vron/trebodar/beräkningar/K-05/README.md

# K-05 rev A – Mellanbjälklag och källarpelare

Kontroll av det platsgjutna mellanbjälklaget, 150 mm, och källarens stålrör, VKR 80×80×4, enligt EKS 12 och SS-EN 1992-1-1 / 1993-1-1. Plattan räknas med finita element med verklig geometri, källarväggar (Sundolitt Kub 350-150), rör, plattan på mark och alla laster från trästommen på plan 1 (K-01, ytterväggar, tak på takfotsväggar, trappa).

| Fil | Innehåll |
|---|---|
| `bild/geometri.json` | Geometri: plattans kontur och trapphål, källarväggar och upplagslinjer, rör, platta på mark, fria kanter , stolparnas lägen på plan 1 och linjelasten från dalbalk 2. K-05:s egen källfil, som också K-06 och R-06 använder. Kontrolleras mot modellen med `verktyg/modellanalys/kontroll_geometri05.py` |
| `laster.py` | Alla laster: utbredda laster (F-01), punktlaster LN/LD/LA ur K-01 och gaveltakstolarna, ytterväggar qY1–qY12, qD2, trappan qT, vindlyft. Indata överst i filen |
| `platta.py` | FE för plattor (DKT-element): nät med lokal förfining, stöd (linje, rör som fjäder, bädd), laster, moment, reaktioner, Wood–Armer |
| `ec2.py` | Material och kontroller enligt SS-EN 1992-1-1 med EKS; rörens knäckning |
| `analys.py` | Långtidsnedböjning med sprickbildning och krympning element för element |
| `modell.py` | Bygger FE-modellen ur `geometri.json` och `laster.py`. Laster över källarväggarna läggs på väggens upplagslinje |
| `omhyllande.py` | Omhyllande moment, tvärkraft och rörlaster för alla kombinationer, nyttig last i mönster, mjuka och styva rör, styva rör med väggarna som fjädrar, vindlyft |
| `tvarkraft.py` | Tvärkraft genom kontrollsnitt ur FE-modellen |
| `kontroll.py` | Handberäkning (belastningsytor, strimlor) och jämförelse med SINTEF 522.871 tabell 24a |
| `berakning.py` | Huvudskript: alla kontroller, tilläggsjärn, utförande vid varje rör, reaktioner på väggarna; skriver `resultat.json` |
| `figurer.py` | Figurer: geometri, laster, tvärsnitt, armering, moment, nedböjning |
| `golvvarme.py` | Bilaga A: golvvärme, stationär värmeledning i ett tvärsnitt |
| `ta_bort.py` | Prövar vad som händer om rör tas bort (`python ta_bort.py 2,6,13`) |
| `rapport.py`, `rapport/mall.typ` | Bygger PDF:en |
| `validering/` | FE-modellen mot Navier, Timoshenko (platta på pelarnät) och en strimla med sprickbildning; känslighet för sättning av rören (`sattning.py`), nätkonvergens (`konvergens.py`) och väggarna som fjädrar (`vaggande.py`); kör dem före `rapport.py` |

## Köra

```
pip install -r requirements.txt
python laster.py          # lastsammanställning
python berakning.py       # under en halv minut
python validering/konvergens.py
python validering/vaggande.py    # cirka en minut
python rapport.py         # rapport/K-05_mellanbjalklag.pdf
```

Typsnittet Carlito läses från systemet eller från `beräkningar/.fonts`. Figurer, `*.npz` och PDF skapas i mappen och versionshanteras inte. Ritningarna R-05 (källarstommen) och R-06 (mellanbjälklaget) läser `bild/geometri.json` och `resultat.json`. K-05 är ett tungt steg i bygget: det räknas lokalt (`./bygg K-05`), och `resultat.json`, valideringarnas `konvergens.json` och `vaggande.json`, `räknat.json` (källornas kontrollsumma) och rapporten i `rapporter/` checkas in (se [`verktyg/bygg`](../../verktyg/bygg/)).

## Viktiga antaganden

- Betong C30/37 (som källarväggarna), beräknad som C25/30 på säkra sidan; B500B. Nät Ø10 s150 i underkant (täckskikt 20 mm) och Ø8 s150 i överkant (täckskikt 25 mm).
- Källarväggarna är Kub 350-150 (cellplast 100 + betong 150 + cellplast 100). Vid öppningarna slutar betongkärnan, och därmed upplagslinjen, 100 mm innanför den isolerade smygen. Upplagslinjen ligger i betongkärnans mitt, som är väggens centrumlinje (5.3.2.2: 75 mm från kärnans insida); plattan går till 30 mm från väggens ytterliv, 70 mm ut över den yttre cellplasten.
- Ytterväggarna på plan 1 står över källarväggens yttre cellplast, centrum 17,5 mm innanför plattans kant och 52,5 mm utanför kärnan (modellen).
- Laster från plan 1: K-01:s stödreaktioner; gavlarnas nockbalksändar via takstolar till hörnen; takfotsväggar bär halva takbalken plus 0,2 m utsprång; ytterväggar 0,6 kN/m²; trappan hänger på hålets kortsida.
- Lätta mellanväggar 0,7 kN/m² som nyttig last i brottgräns och permanent last i bruksgräns.
- Momenttoppar utjämnas över 250 mm; stödmoment i överkant × 1,2 när zonerna avgränsas och tilläggsjärnen dimensioneras för 1,5 × FE (stela upplagslinjer ger nätberoende toppar vid väggändar).
- Genomstansning: hela lasten på varje rör och stolpe på eget snitt 2d, β 1,15 (1,4 vid trapphålet), ρ ur överkantsarmeringen, för rören också FE-modellens lokala tvärkraft; minst 5 % marginal och ≤ 100 % med armeringen 10 mm för lågt. Nettokraften ur jämvikt redovisas bara som information. P7 är två rör tätt intill varandra i x-led, vart och ett med sin topplåt 80×80×8 (lastyta 160 × 80 mm).
- Rören räknas med verklig axialstyvhet, som styva och som styva med väggarna som fjädrar (kärnans långtidsstyvhet, E = 11 000 MPa, t = 150 mm); det ogynnsammaste resultatet används. Rören vid trapphålet står där de står i modellen, 62,5–81 mm från hålkanten (centrum).
