vron/trebodar/rapporter/U-03revA Takets luftspalt - luftflöde, fukt och mögelrisk.pdf

Fritidshus Trebodar, Resö, Tanum | U-03 rev A · Sida 1 av 4
Projekt | Fritidshus Trebodar, Resö, Tanum | Dokument | U-03, rev A
Objekt | Takets luftspalt – luftflöde, fukt och mögelrisk | Datum | 2026-10-31
Innehåll | Luftflöde, temperatur, fukt och mögelindex timme för timme 2013–2023, hela taket som nätverk | Upprättad | Viktor Ogeman
Underlag | K-03 rev A, K-05 (takets geometri), F-01 rev A (uppbyggnad), planritning 201 rev 02, AR-02 (riktning), ERA5 2013–2023 | Status | Eget underlag, ingår inte i handlingarna till tekniskt samråd

### 1 Syfte och slutsatser

Luftspalten mellan råsponten och vindskivan (hård träfiberskiva) går obruten från takfot till takfot över nockar och dalar, som längst 16,3
m. Här bedöms om den ventileras tillräckligt, vad takfönstren, eventuella gavelöppningar, vindskivan och badrummet betyder och om en oventilerad spalt räcker. Måttet är mögelindex M (VTT) på råspontens undersida: målet är M < 1 (ingen påväxt), och ASHRAE 160 godtar M ≤ 3.
Beslut och utförande
1. Plåten: zink-magnesium utan organisk beläggning. Den låga emissiviteten avgör; målad plåt skulle ge M 3,69.
2. Spalten: ströläkten 34 mm (F-01); spalten går fri också över nock- och dalbalkarna.
3. Omluftning vid varje takfönster: uppehåll i ströläkten, minst 300 mm och gärna 600 mm fritt per läktlinje ovanför och under fönstret (Figur 3).
4. Inga öppningar i gavlarna. Alla takfötter öppna med insektsnät.
5. Dalbalkarnas överkant i takplanens skärning, inte i takbalkarnas överkant (som i modellen och K-03).
6. Vindskiva med deklarerat Sd, gärna högst ca 0,3 m. Intello Plus, helt lufttät, också över badrummet.
7. Står huset tomt på vintern: håll hellre 15 än 10 °C inne.
Slutsatser
- Den obrutna spalten fungerar. Luften går genom alla sex takfallen i följd, driven av vinden och av solen: de tre solvarma takfallen mot sydost samverkar och driver luften från sydost mot nordväst. Längs den långa vägen rör sig luften i median med 0,31 m/s.
- Med zink-magnesiumplåten klarar sig råsponten. Med 34 mm spalt blir M som mest 1,02 med 300 mm omluftning och 1,02 med 600 mm, i båda fallen efter de extremt milda och blöta vintrarna 2019/20 och 2020/21; alla andra år ligger under 0,6. Den långa vägen är inte sämre än de korta takfallen i husets ändar, som är vanliga sadeltak (0,83 mot 1,02 med målad plåt 1,86 mot 3,69).
- Vid svag vind betyder spalten och omluftningen mer. Vid platsens vind är 34 och 36 mm i praktiken lika (1,02 och 1,00), och med halva vindtrycket blir det 0,85 och 0,87. Med en fjärdedel av vindtrycket blir det 1,48 med 34 mm och 0,80 med 36 mm, och med 300 mm omluftning 1,84. Vid svag vind förs nämligen fukt från de solvarma takfallen mot sydost med den långsamma luften och samlas i det sista takfallet mot nordväst, mest i facken bakom takfönstren. Med ströläkten 34 mm är omluftningen vid fönstren därför viktig, gärna 600 mm.
- Spalten ska ventileras. Utan luftning eller helt utan vind blir M lägst i beräkningen (0,00 och 0,01 0,03 med råspont på 20 % när taket stängs), eftersom ingen fuktig uteluft kommer in. Men en oventilerad spalt torkar bara inåt, långsamt och på sommaren, så vatten från läckage eller mer byggfukt torkar inte ut, och svag luftning är ogynnsam. Den luftade spalten med marginal för svag vind är det robusta valet.
- Gavelöppningar ger ingen förbättring. M blir 1,07 mot 1,02, och den långa vägen sämre (0,96 mot 0,83). De släpper också in slagregn och snö, särskilt i gavlarna mot sydväst.
- Tomt hus på vintern. Med 10 °C inne oktober–april blir värmeförlusten, som torkar spalten, mindre: M 1,50 med rekommenderat utförande (1,50 med 600 mm omluftning), med 15 °C 1,28 (1,28). Det gäller bara de extremt milda vintrarna 2019/20 och 2020/21, övriga år under 0,7. Det är över målet men långt under ASHRAE 160:s gräns, och ju varmare huset hålls, desto bättre.

### 2 Taket och modellen

Taket. Tre sadeltak, 30°, med nockarna längs husets längd och dalar emellan. Uppbyggnad enligt F-01 med plåt, papp och spalt enligt denna utredning: bandtäckning av zink-magnesiumbelagd plåt, blank och omålad; underlagspapp av bitumen (t.ex. T-Roof YEP 2500, ångtät); råspont 20 mm; luftspalt mellan ströläkt på takbalkarna c/c 600 vindskiva 3 mm; Hunton Nativo 170 mm; ångbroms Hunton Intello Plus (Sd 0,3–34 m); installationsskikt 45 mm; gips. Spalten har sin fria höjd även över nock- och dalbalkarna. Alla takfötter mot det fria är öppna med insektsnät, också där huskropparna är förskjutna mot varandra. Vägen genom spalten är 5,4, 5,9, 11,1 eller 16,3 m beroende på var i taket facket ligger (Figur 1 a). Takfönstren TF1–TF3 (K-03) bryter två fack vardera. Badrummet (planritning 201 rev 02) ligger under TF1.
Modellen. Hela taket delas i 31 remsor längs husets längd, ungefär ett fack var, och varje remsa i delsträckor mellan takfötter, nockar, dalar och fönster, med 6 celler var. För varje timme 2013–2023 beräknas:
- luftflödet i alla fack av vindtrycket vid takfötterna och gavelöppningarna och av den termiska stigkraften i varje takfall. Vid takfötterna används Δcp

= 0,48 cos(1,3 φ) + 0,22, där φ är vindens vinkel mot fasadens normal (Månhardt m.fl. 2021 efter Gullbrekken m.fl. 2018), i gavlarna Swami & Chandra. Vindhastigheten är ERA5 på 10 m, utan reduktion. Tryckfallet räknas med friktion i spalten, insektsnät, in- och utlopp och vändningar vid nockar och dalar. Där facken möts är flödet in lika med flödet ut;
- temperaturerna i plåten (sol, utstrålning mot himlen, vind), råsponten, luften och vindskivan, med värmeflödet inifrån. Zink-magnesiumytan har solabsorption 0,65 och emissivitet 0,25 (blank zink och förzinkad plåt 0,65–0,7 respektive 0,15–0,25);
- fukten i råspontens yta och kärna, i vindskivan med isoleringens överdel och i luften i spalten, med diffusion inifrån genom ångbromsen, vars Sd beror på medelfuktigheten på dess båda sidor. Råsponten torkar bara nedåt, eftersom pappen är ångtät. Inneklimatet är fuktklass 2 (4 g/m³), badrummet fuktklass 4 (8 g/m³), SS-EN ISO 13788;
- mögelindex M (VTT-modellen, furu splintved) på råspontens undersida och på vindskivan. M = 1 är begynnande påväxt som syns i mikroskop och M = 3 påväxt som syns med blotta ögat.
Klimatet är ERA5 för Resö (8,5 °C, RF 79 %, vind 4,1 m/s i medel på 10 m). Flöde och temperatur itereras 6 gånger per timme. Kontroller: med 12 celler per delsträcka blir största M 1,02 i stället för 1,02 och med 10 iterationer 0,99. Massbalansen i varje nod stämmer inom 10⁻⁸ m³/s. En oberoende kontrollmodell med egen kod, räknad med målad plåt, ger samma rangordning mellan vägarna och utförandena och samma tidsförlopp.

Fritidshus Trebodar, Resö, Tanum | U-03 rev A · Sida 2 av 4

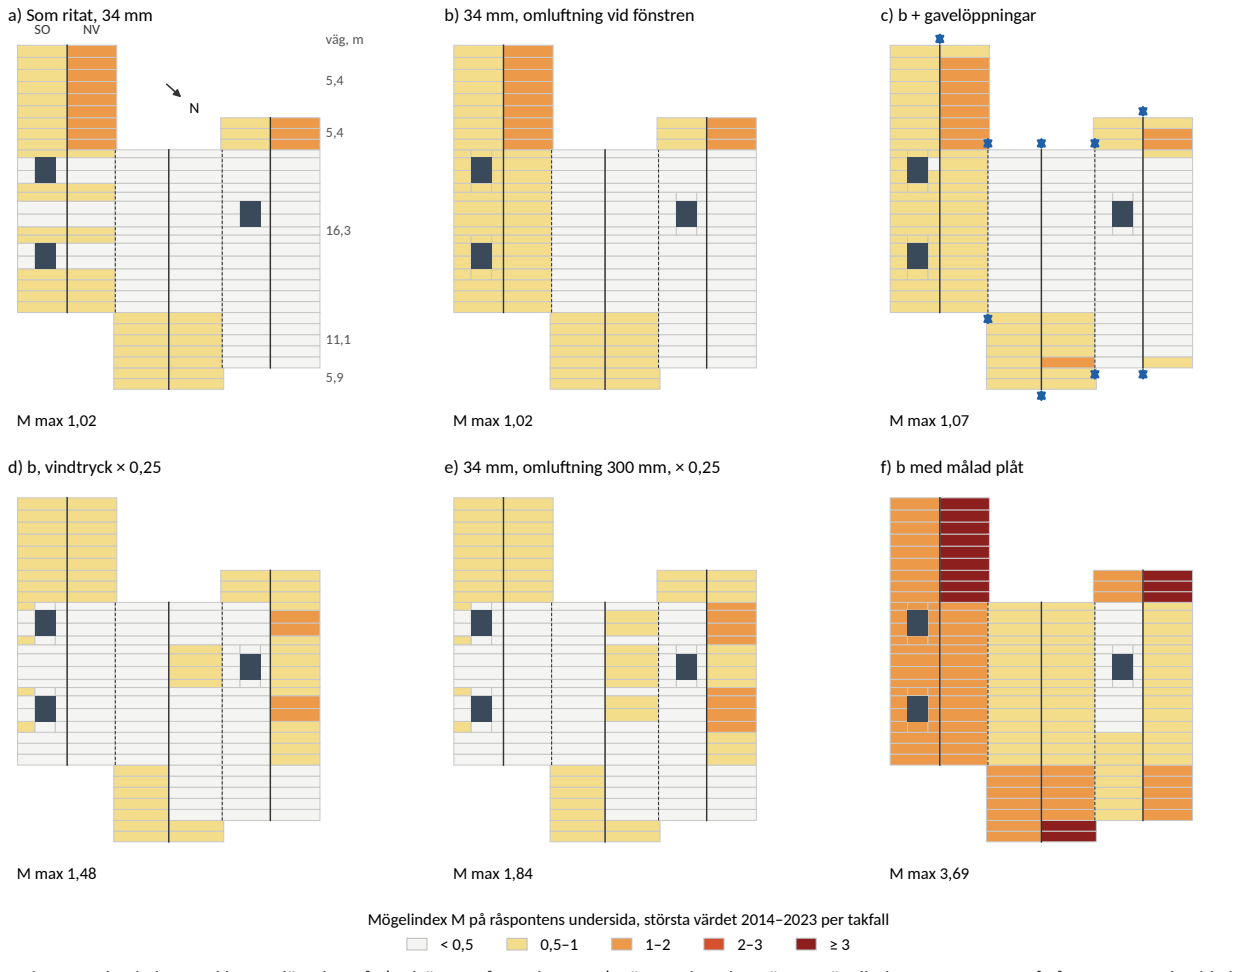
[picture p8: figure]
M max 1,02; väg, m; a) Som ritat, 34 mm; b) 34 mm, omluftning vid fönstren; M max 1,07; c) b + gavelöppningar; M max 1,48; d) b, vindtryck × 0,25; M max 1,84; e) 34 mm, omluftning 300 mm, × 0,25; M max 3,69; f) b med målad plåt

Mögelindex M på råspontens undersida, största värdet 2014–2023 per takfall

Figur 1: Taket i plan med husets längd uppåt (sydväst uppåt, N visar norr). Färgen visar det största mögelindexet 2014–2023 på råspontens undersida i varje delsträcka. SO och NV: takfallens riktning i vänster huskropp. Väg: luftens väg från takfot till takfot. Mörka rutor: takfönster. Heldragna linjer: nockar, streckade: dalar. Pilar: gavelöppningar.

### 3 Resultat

Fall | M råspont Yta M ≥ 1 (m²) M vindskiva Luft (m/s) | Sämst
Utförande
Rekommenderat: 34 mm, omluftning 300 mm | 1,02 | 17 | 0,05 | 0,36 | NV, 5,4 m
Som ritat: fönstren bryter facken (34 mm) | 1,02 | 17 | 0,05 | 0,22 | NV, 5,4 m
34 mm, omluftning 600 mm | 1,02 | 17 | 0,05 | 0,37 | NV, 5,4 m
+ gavelöppningar | 1,07 | 16 | 0,10 | 0,38 | NV, 11,1 m
+ kanal längs nock och dal | 1,05 | 13 | 0,06 | 0,37 | NV, 5,4 m
+ kanal och gavelöppningar | 1,00 | 1 | 0,08 | 0,36 | NV, 5,4 m
Utan takfönster | 1,02 | 17 | 0,05 | 0,41 | NV, 5,4 m
Vind och spalt
Rekommenderat, vindtryck × 0,5 | 0,85 | 0 | 0,04 | 0,21 | NV, 5,4 m
Rekommenderat, vindtryck × 0,25 | 1,84 | 11 | 0,03 | 0,11 NV, fönsterfack
Vindtryck × 0,5 | 0,85 | 0 | 0,04 | 0,21 | NV, 5,4 m
Vindtryck × 0,25 | 1,48 | 6 | 0,03 | 0,12 NV, fönsterfack
Ingen vind, bara sol och stigkraft | 0,01 | 0 | 0,00 | 0,00 | –
Gavelöppningar, vindtryck × 0,5 | 0,92 | 0 | 0,08 | 0,22 | NV, 16,3 m
Spalt 25 mm | 1,11 | 3 | 0,05 | 0,26 NV, fönsterfack
Spalt 36 mm | 1,00 | 20 | 0,05 | 0,39 | NV, 5,9 m
Spalt 45 mm | 1,06 | 20 | 0,07 | 0,43 | NV, 5,4 m
Spalt 36 mm, vindtryck × 0,5 | 0,87 | 0 | 0,05 | 0,23 | NV, 5,4 m
Spalt 25 mm, vindtryck × 0,25 | 6,00 | 52 | 0,53 | 0,08 NV, fönsterfack
Spalt 36 mm, vindtryck × 0,25 | 0,80 | 0 | 0,04 | 0,13 NV, fönsterfack
Spalt 45 mm, vindtryck × 0,25 | 0,80 | 0 | 0,04 | 0,16 | NV, 5,4 m
Strypta takfötter (4 × tryckfall) | 0,78 | 0 | 0,04 | 0,28 | SO, 5,4 m
Strypta takfötter, vindtryck × 0,25 | 2,06 | 24 | 0,02 | 0,10 NV, fönsterfack
Plåt
Ny blank plåt: α 0,55, ε 0,12 | 0,93 | 0 | 0,05 | 0,38 | SO, 5,4 m
Åldrad plåt: α 0,8, ε 0,4 | 1,18 | 37 | 0,05 | 0,37 | NV, 5,4 m
Målad plåt: α 0,6, ε 0,9 | 3,69 | 100 | 0,17 | 0,38 | NV, 5,4 m
Inneklimat och vindskiva
Badrummet fuktklass 4, Intello Plus | 1,02 | 17 | 0,06 | 0,37 | NV, 5,4 m
Badrummet fuktklass 4, Sd 10 m där | 1,02 | 17 | 0,05 | 0,37 | NV, 5,4 m

Fritidshus Trebodar, Resö, Tanum | U-03 rev A · Sida 3 av 4
Hela huset fuktklass 3 | 1,02 | 17 | 0,07 | 0,37 | NV, 5,4 m
Tomt okt–apr: inne 15 °C, omluftning 600 mm | 1,28 | 40 | 0,06 | 0,38 | NV, 5,4 m
Tomt okt–apr: inne 10 °C, omluftning 600 mm | 1,50 | 63 | 0,05 | 0,38 | NV, 5,4 m
Rekommenderat, tomt: inne 15 °C | 1,28 | 40 | 0,06 | 0,36 | NV, 5,4 m
Rekommenderat, tomt: inne 10 °C | 1,50 | 56 | 0,05 | 0,36 | NV, 5,4 m
Spalt 36 mm, tomt okt–apr | 1,48 | 72 | 0,05 | 0,39 | NV, 5,4 m
Vindskiva Sd 0,06 m | 0,98 | 0 | 0,26 | 0,37 | NV, 5,4 m
Vindskiva Sd 0,6 m | 1,03 | 17 | 0,00 | 0,37 | NV, 5,4 m
Byggfukt och oventilerat
Råspont 20 % vid stängning | 1,02 | 17 | 0,05 | 0,38 | NV, 5,4 m
Strypta takfötter, råspont 20 % vid stängning | 0,78 | 0 | 0,04 | 0,28 | SO, 5,4 m
Som ritat, råspont 20 % vid stängning | 1,02 | 17 | 0,05 | 0,22 | NV, 5,4 m
Oventilerad (takfötter stängda) | 0,00 | 0 | 0,00 | 0,00 | –
Oventilerad, råspont 20 % vid stängning | 0,03 | 0 | 0,00 | 0,00 | –

Mögelindex: största värde 2014–2023 (för fallen med våt råspont från 1 oktober 2013) över hela taket. Yta: den del av takets 189 m² där M ≥ 1. Vindskiva: vindskivan med isoleringens överdel. Luft: luftens hastighet i spalten, median över alla timmar och fack. Sämst: takfallets riktning och vägens längd, eller fönsterfacken, där M är störst. Om inget annat anges: 34 mm spalt, omluftning 600 mm, zink-magnesiumplåt och full vind.

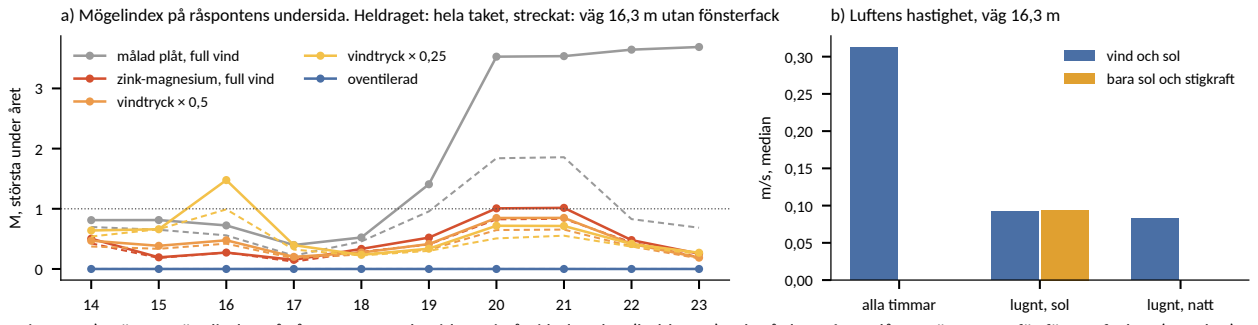
[picture p9: figure]
M, största under året; målad plåt, full vind; zink-magnesium, full vind; vindtryck × 0,5; vindtryck × 0,25; oventilerad; alla timmar; lugnt, sol; lugnt, natt; m/s, median; b) Luftens hastighet, väg 16,3 m; vind och sol; bara sol och stigkraft

a) Mögelindex på råspontens undersida. Heldraget: hela taket, streckat: väg 16,3 m utan fönsterfack

Figur 2: a) Största mögelindex på råspontens undersida varje år, i hela taket (heldraget) och på den 16,3 m långa vägen utanför fönsterfacken (streckat), med 34 mm och omluftning. b) Luftens hastighet längs den långa vägen med verkligt väder och utan vind (bara sol och stigkraft). Lugnt: vind under 2 m/s; sol: global strålning över 300 W/m²; natt: ingen sol. Varför skiljer sig takfallen åt när luften är densamma? Med zink-magnesiumplåten är skillnaden liten (1,02 vid takfoten mot sydost, där uteluften oftast kommer in). Med målad plåt syns den tydligt (Figur 1 f): flödet är detsamma upp på det ena takfallet och ned på det andra, men mögelindex beror direkt på råspontens temperatur och fuktighet vid ytan, inte direkt på flödet. Takfallen mot nordväst får under november–mars ca 80 kWh/m² sol per vinter, de mot sydost ca 203. Råsponten mot nordväst blir därför kallare, RF vid ytan är högre (i medel 80 mot 76 % under vintern), och mögelindex växer mycket snabbt med RF över ca 85 %. Med målad plåt ligger därför takfallen mot sydost på de korta vägarna mellan 1 och 2 och de mot nordväst över 3.
Luftflödet. Längs den långa vägen rör sig luften i median med 0,31 m/s, ca 60 omsättningar per timme (RäknaF räknar med 20). Under lugna, soliga timmar, bara ca 2 % av tiden, driver solen ensam luften med 0,09 m/s, i 87 % av dem från sydost mot nordväst. På eftermiddagen kan flödet vända, när kvällssolen värmer takfallen mot nordväst. Lugna nätter rör sig luften med 0,08 m/s; helt utan vind står den nästan still (Figur 2 b).
Vind och spalthöjd. Med full vind betyder spalthöjden lite (34 mm 1,02, 36 mm 1,00, 45 mm 1,06); en högre spalt släpper in mer fuktig uteluft. Vid svag vind är det tvärtom: då kan fukt från de solvarma takfallen mot sydost, som torkar på dagen, föras med den långsamma luften och lämnas i det skuggiga sista takfallet mot nordväst, mest bakom takfönstren där omluftningen ger mindre luft. Med en fjärdedel av vindtrycket blir M 6,00 med 25 mm, 1,48 med 34 mm, 0,80 med 36 mm och 0,80 med 45 mm. Med 25 mm blir flödet för litet bakom takfönstren redan vid full vind (1,11). Strypta takfötter (fyra gånger större tryckfall) ger 0,78 vid full vind men 2,06 vid en fjärdedel av vindtrycket. Rekommenderat utförande, 34 mm med 300 mm omluftning, ger 1,02, 0,85 och 1,84 vid full, halv och en fjärdedels vindtryck.
Plåten. Med ny blank plåt blir M 0,93, med åldrad plåt (solabsorption 0,8, emissivitet 0,4) 1,18 och med målad plåt 3,69.
Byggfukt. Med råsponten på 20 % när taket stängs den 1 oktober blir M 1,02 med omluftning, 0,78 med strypta takfötter och 0,03 i en oventilerad spalt. Fukten torkar ut, i den oventilerade spalten inåt genom vindskivan, isoleringen och Intello Plus på sommaren. Utan omluftning torkar också fönsterfacken ut (M 0,03).
Takfönstren. Utan omluftning är luften i fönsterfacken helt stilla (M 0,00, som i en oventilerad spalt). Med omluftning rör sig luften där med 0,29 m/s mot 0,37 m/s i hela taket, och M blir 0,75, lägre än i resten av taket. 300 mm fri längd i ströläkten ger i fönsterfacken 0,25 m/s, mot 0,29 med 600 mm.
Gavelöppningar och kanal längs nock och dal. I ändfacken bakom gavelöppningarna kommer uteluften in vid dalarnas och nockarnas ändar. Om ströläkten inte går över balkarna bildas en kanal längs nocken och dalen som förbinder facken; den ger ingen förbättring (1,05), med gavelöppningar 1,00. Ströläkten kan alltså gå obruten över balkarna, om den inte stänger facken.
Inneklimatet och vindskivan. Badrummet med fuktklass 4 ger M 0,06 på vindskivan över badrummet med Intello Plus och 0,04 med en ångbroms med fast Sd 10 m; råsponten påverkas inte. Fuktklass 3 i hela huset ger 1,02. Vindskivans Sd påverkar råsponten lite (M 0,98, 1,02 och 1,03 med Sd 0,06, 0,3 och 0,6 m).

Fritidshus Trebodar, Resö, Tanum | U-03 rev A · Sida 4 av 4

### 4 Rekommendationer

takfönster

1 000

mot nock

mot takfot

Uppehåll i ströläkten (blått) på avväxlingarna och kortlingen: minst 300 mm fritt per läktlinje inom 1 m ovanför och under fönstret, högst 200 mm vardera, förskjutna
mellan linjerna så att råsponten alltid bärs.

Luften i de två facken som fönstret bryter går åt sidan genom uppehållen, förbi fönstret i grannfacken och tillbaka ovanför det. Ströläkten 34 mm hög.

Ljust: takbalk 45, avväxling (dubbel takbalk) och kortling. Mörkt: ströläkt 45.

Figur 3: Omluftning vid ett takfönster, principskiss sedd uppifrån med nocken uppåt. Mått i mm.
1. Omluftning vid takfönstren (och skorstenen om den hamnar i taket), Figur 3. Ovanför och under varje fönster får ströläkten på avväxlingarna och på kortlingen uppehåll, så att luften i de två brutna facken går åt sidan till grannfacken. Fri längd minst 300 mm och gärna 600 mm per läktlinje inom 1 m från fönstret, i uppehåll om högst 200 mm som förskjuts mellan intilliggande linjer så att råsponten alltid bärs. Sidoöppningen blir då minst 300 × 34 = 10 200 mm² per linje. Vid mycket svag vind (en fjärdedel av vindtrycket) ger 300 mm M 1,84 i fönsterfacken och 600 mm 1,48.
2. Spalten, 34 mm: ströläktens höjd (F-01). Vid platsens vind betyder spalthöjden lite, vid svag vind mer: med en fjärdedel av vindtrycket ger 34 mm 1,48 och 36 mm 0,80, och 25 mm ger för lite luft bakom takfönstren redan vid full vind (1,11). Spalten går fri över alla nock- och dalbalkar till nästa takfall. SINTEF anger 36 mm som minimum för korta takfall och mer för längre vägar, för att undvika snösmältning; den långa vägen här ligger utanför tabellen och bedöms med beräkningen.
3. Dalbalkarna. Dalbalkens överkant ska ligga i takplanens skärning, ca 55 mm under takbalkarnas överkant vid balkens sidor, som i husets 3D-modell, eller dalens botten byggas plan med spaltens fria höjd över balken. Ligger överkanten i takbalkarnas överkant stängs spalten vid dalarna.
4. Takfötterna öppnas längs alla takfötter, också vid förskjutningarna. Insektsnätet ska ha minst 60 % fri öppning och kunna rensas. Inga öppningar i gavlarna. Extra öppningar vid nockarna har inte prövats och behövs inte.
5. Plåten hålls blank, utan organisk beläggning eller färg: den strålar då ut lite värme mot natthimlen och kyler inte råsponten.
6. Vindskivan ska ha ett deklarerat Sd, gärna högst ca 0,3 m. Beräkningen påverkas lite av Sd, men en ångöppen skiva låter isoleringen torka utåt om den blir fuktig. Oljehärdad board saknar deklarerat Sd och har troligen 0,3–0,6 m. Ett tunt alternativ med dokumenterade värden är hård träfiberskiva godkänd som vindskydd under en luftspalt, t.ex. 3,2 mm enligt SINTEF TG 2245 (Sd ≤ 0,28–0,36 m).
7. Badrummet. Intello Plus räcker. Det som avgör är att ångbromsen är helt lufttät: tejpade skarvar, ansluten till takfönstrets ångspärrskrage och utan genomföringar, med installationerna i installationsskiktet, och att badrummet har frånluft med forcering vid dusch.
8. Torrt vid inbyggnad. Råspont och takbalkar torra (högst 16 %), isoleringen högst ca 10 % (Hunton), och taket skyddas mot regn under bygget. Intello Plus monteras och tejpas innan huset värms upp. Installationsskiktet isoleras inte (TG 20557).
9. Tomt hus på vintern. Håll hellre 15 än 10 °C inne när huset står tomt oktober–april: värmeförlusten från ett varmare hus torkar spalten.
Osäkerheter. VTT-modellen för furu splintved är den känsligaste klassen; gran och kärnved växer långsammare. Absolutvärdena beror på modellens val (ytskiktets tjocklek, ytans beskaffenhet) och kan skilja en faktor 2; jämförelserna mellan utförandena är säkrare. Två indata väger tyngst. Vinden: ERA5 på 10 m används direkt vid takfötterna, och fallen med mindre vind skalar bara vindtrycket, inte vindens kylning av plåten; en fjärdedel av vindtrycket motsvarar halva vindhastigheten. Plåtens emissivitet: den kan öka med patina och smuts. Fukttransporten längs den långa vägen vid svag vind beror på råspontens fuktbuffring och är inte verifierad med mätningar. Snö på taket, plåtens och råspontens värmetröghet och luftläckage inifrån ingår inte. Snö och värmetröghet minskar den nattliga avkylningen genom utstrålning, men snö kan också sätta igen näten vid takfötterna; läckage gör att ångbromsen måste vara lufttät. Perioden omfattar den extremt milda vintern 2019/20, och framtidens vintrar väntas bli mildare och blötare.
Källor. Uvsløkk, SINTEF 2020:00500 Lufting av tak (2021). Byggforsk 525.101 (2021). SINTEF TG 20239 (tabell 3). Månhardt m.fl., J. Phys.: Conf. Ser. 2069 (2021) 012018. Gullbrekken m.fl., J. Wind Eng. Ind. Aerodyn. 175 (2018). Mundt-Petersen, SBUF 13098 (2018): flödet under råsponten så litet som möjligt men tillräckligt för att torka. Bunkholt m.fl., J. Phys.: Conf. Ser. 2069 (2021) 012007. Hukka & Viitanen, Wood Sci. Technol. 33 (1999); Ojanen m.fl. (2010). ASHRAE 160-2016. SS-EN ISO 13788. RäknaF. ETA-18/1146 (Intello Plus). SINTEF TG 2245, TG 20557. ÖNORM B 4119:2018. Swami & Chandra, ASHRAE Trans. 94 (1988). ERA5 via Open-Meteo (CC BY 4.0).
