vron/trebodar/rapporter/K-06revA Bottenplatta och källarväggar.pdf

Fritidshus Trebodar, Resö, Tanum | K-06 rev A · Sida 1 av 10
Projekt | Fritidshus Trebodar, Resö, Tanum | Dokument | K-06, rev A
Objekt | Bottenplatta och källarväggar | Datum | 2026-10-08
Innehåll | Källarväggar av Sundolitt Kub 350-150 mot jord, byggskedet och bottenplatta på cellplast | Upprättad | Viktor Ogeman

### 1 Inledning

Handlingen redovisar källarens väggar och bottenplattan. Väggarna gjuts i Sundolitt Kub 350-150 (U17). Kub är element av cellplast EPS 120, 100 mm på var sida, som är kvarsittande form för en armerad betongkärna, 150 mm (SINTEF Teknisk Godkjenning TG 2216). Kärnan räknas som en vanlig betongvägg med samma tvärsnitt. Ytterväggarna mot jord hålls i botten av bottenplattan och i toppen av mellanbjälklaget, som gjuts samtidigt med väggarnas översta skift.
Handlingen redovisar också byggskedet innan mellanbjälklaget har gjutits:
- i vilken ordning väggarna gjuts och fylls;
- hur V3 och V20 bär fyllningen innan bjälklaget finns;
- vilken hållfasthet betongen behöver när det fylls mot väggarna, och hur många dygn den då ska härda.
Bottenplattan är 100 mm på 200 mm cellplast med kantbalkar i L-element (höjd 300), balkar under innerväggarna och plintar under rören. Bottenplattan, väggarna, rören och mellanbjälklaget (K-05) räknas i en gemensam FE-modell, så att skillnaden i sättning mellan rör och väggar ingår.
Regler: SS-EN 1990, SS-EN 1991-1-1, SS-EN 1991-1-6, SS-EN 1992-1-1, SS-EN 1992-1-2 och SS-EN 1997-1 med EKS 12, samt TG 2216 och Sundolitts monteringsanvisning för Kub (2022). Säkerhetsklass 2 (γd
= 0,91), livslängd 50 år, geoteknisk kategori 1. Resultat.
Del | Resultat
Väggar mot jord, färdigt läge | Lodräta järn på insidan Ø10 s200 i V1, V2, V3, V7, V11, V14, V16, V18, V20, V21 och Ø10 s300 (TG
| 2216) i V8, V9, V10, V12, V13, V17. Böjning högst 83 % (V2), tvärkraft 45 %, fogen mot bottenplattan 17
| %
Fasaden med öppningarna | Pelarna 85 %, bröstningen med 2 Ø12 under öppningarna
Vertikal last | Ytterväggar 73 % (V21, med jordtrycket), innerväggar 42 %
LD4_2 i hörnet V2/V20 | 30 %
Byggskedet | V3 bär fyllningen vågrätt mellan hörnen med Ø10 s300 i båda ytorna (λ = 1,47). Fyll mot väggarna när
| betongen har nått fck(t) ≥ 20 MPa: 10 dygn vid 10 °C (8 med snabbhärdande cement), se avsnitt 4.3
Bottenplatta L300, cellplast | S300 under balkar och plintar 92 %. S100 under plattan 36 %
Bottenplatta L300, betong | Kantbalk 450 × 200 med 2 Ø10 i under- och överkant (57 %). Platta Ø6 s150 i båda lagren (58 %). Plintar
| 600–1 200 mm, genomstansning högst 54 %
Mellanbjälklaget (K-05) med sättningar | Överkant 62 % och underkant 61 % av K-05:s armering. K-05:s modell ger 66 % och 58 %
Plattan på mark (plan 1), 400 mm S100 | 97 %
Glidning | 30 %

Det som styr väggarna är packningen intill dem, inte vilojordtrycket. Sundolitts armering för väggar som hålls i topp och botten (Ø10 s300) räcker för jordtrycket men inte för packningstrycket från en vanlig lätt vibroplatta, så de lodräta järnen läggs tätare. Bottenplattan L300 räcker, med S300 under balkar och plintar och S100 under plattan.

### 2 Förutsättningar

- Grund: sprängt berg som avjämnas med makadam. Grunden dräneras runt huset, och det finns inget vattentryck mot väggar eller platta. Berget och den dränerade makadamen är inte tjälfarliga.
- Höjder: fri höjd 2 100 mm från bottenplattans överkant till mellanbjälklagets underkant (rörens längd), alltså tre hela Kub-skift à 600 mm och ett halvt skift, 300 mm. Mellanbjälklaget är 150 mm.
- Fyllning: höjden över bottenplattans överkant enligt figur 1. Den är 2,0 m mot de slutna fasaderna utom mot V1, där den är 1,8 m. Mot V18 ligger avsatsen utanför sovrummet, 2,0 m. Mot V14 faller den från 1,8 till 0,8 m och mot V9 från 0,8 m till noll vid öppningen. Mot fasaden med öppningarna är fyllningen 0,80 m (husets Onshape-modell). Bakom V3 och V20 ligger plattan på mark på plan 1 (K-05) på 400 mm cellplast. Där går fyllningen till 1,7 m, och plattan räknas som ytlast, 4,4 kN/m² permanent och 2,7 kN/m² nyttig.
- Jordtryck: vilojordtryck, eftersom väggarna hålls i topp och botten. K0 = 1 − sin φ
| ′ = 0,36 med φ ′ = 40° för dränerande
krossmaterial, γ = 18 kN/m³. Last på marken intill väggarna är 2,5 kN/m² (gångyta). Inga fordon får köra närmare än 2 m.
- Packning (avsnitt 3.2): fyllningen inom 1 m från väggen läggs i lager om högst 0,2 m och packas med en lätt vibroplatta, högst 100 kg, centrifugalkraft högst 15 kN och bredd minst 0,5 m. Det ger ett kvarstående horisontaltryck på 19 kPa. Längre ut än 1 m får fyllningen packas tyngre.
- Användning: källaren är uppvärmd och har golvvärme i bottenplattan.
- Laster från plan 1 och mellanbjälklaget enligt K-05: samma punktlaster, väggar, kombinationer och mönster för nyttig last. Laster som står över en vägg går in i väggens kärna och sprids 60° mot horisontalplanet ned till bottenplattan. Nyttig last i källaren är 2,0 + 0,7 kN/m².
- Kombinationer: jordtrycket och packningstrycket är permanent last, 6.10a med 0,91 ⋅ 1,35 och 6.10b med 0,91 ⋅ 1,2. Last på marken är nyttig last. Kärnans krympning är en påtvingad deformation med faktorn 1,0.

Fritidshus Trebodar, Resö, Tanum | K-06 rev A · Sida 2 av 10

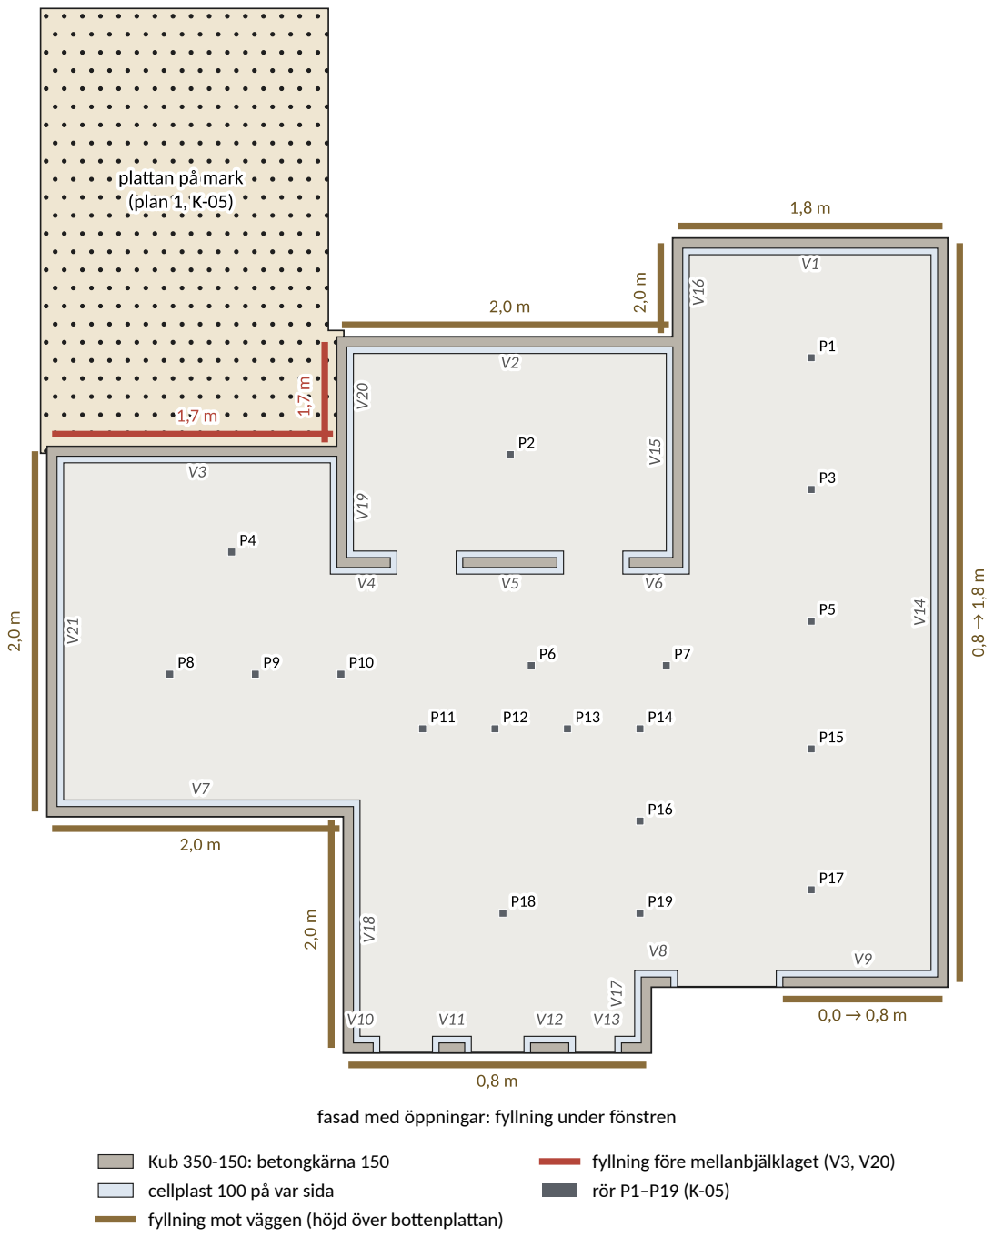
[picture p22: figure]
Kub 350-150: betongkärna 150; cellplast 100 på var sida; fyllning före mellanbjälklaget (V3, V20); rör P1–P19 (K-05)

fasad med öppningar: fyllning under fönstren

fyllning mot väggen (höjd över bottenplattan)

Figur 1: Källaren med väggarna V1–V21 (Kub 350-150, den sammanhängande betongkärnan mörk), rören P1–P19 och fyllningens höjd mot väggarna. Bakom V3 och V20 läggs fyllningen innan mellanbjälklaget gjuts. Mått i mm, samma koordinater som i K-05.

Material | fck (MPa) | γM
Betong i väggarna Sundolitts recept B30 (NS-EN 206), räknas som C30/37. Största stenstorlek 16 mm, grov ballast
minskad 25 %, sättmått 180–200 mm.
30 | 1,5
Betong i plattorna C30/37, samma betong som väggarna i alla gjutningar. Plattorna räknas som C25/30, på säkra sidan. | 25 | 1,5
Armering | B500B. I väggarna täckande skikt 25 mm mot insidan och 30 mm mot utsidan till de vågräta järnen | 500 1,15
Kärnans Ecm = 32 800 MPa. Kryptalet är 2,0 och den slutliga krympningen 0,30 mm/m (SS-EN 1992-1-1 3.1.4 med RH 80 % och ℎ0
= 150 mm; kärnan är inkapslad i cellplast).

Cellplast fck (kPa) Ek

(kPa) fd

permanent fd
med snö/nyttig Långtid 2 %
S100 | 90 | 3 000 | 28 | 35 | 30
S300 | 280 | 9 000 | 97 | 118 | 90
Dimensionerande hållfasthet fd = kr

fck/γm med γm = 1,3 och kr
| | | | | efter lastens varaktighet (EPS-Sverige, WSP 10221233).
Långtidslast vid 2 % deformation enligt tillverkaren. Styvhet i modellen: Ek
| | | | | för korttidslast och 0,4Ek
för långtidslast.

Fritidshus Trebodar, Resö, Tanum | K-06 rev A · Sida 3 av 10

### 3 Källarväggar

### 3.1 Väggsystemet

Kub 350-150 består av element 1 200 × 600 mm (halva element 300 mm), som staplas i förband och armeras innan kärnan gjuts. Plastbindare håller ihop cellplasten och har fästen för armeringen och för gipsskivorna på insidan. Väggen är 2 100 mm hög: de tre hela skiften (1 800 mm) gjuts först, och det översta halva skiftet gjuts tillsammans med mellanbjälklaget, i ytterväggarna och innerväggarna.
TG 2216 godkänner Kub för väggar mot jord. Ett av de redovisade fallen är vår vägg: den hålls i toppen av ett gjutet bjälklag och i botten av golvet, med fyllning upp till 2,3 m. TG 2216 anger armeringen för det fallet, men den räknar inte med packning intill väggen. Väggarna dimensioneras därför här enligt SS-EN 1992-1-1, och armeringen är minst den som TG 2216 anger:
Del | Armering | Kommentar
Vågräta järn | 2 Ø10 per skift, ett vid var yta, s600. I de två översta
| skiften s300 | TG 2216. I V3 s300 i hela höjden (avsnitt 4.2)
Lodräta järn | På insidan, från bottenplattan upp till bjälklagets
| överkantsnät: Ø10 s200 i V1, V2, V3, V7, V11, V14, V16,
| V18, V20, V21; Ø10 s300 i V8, V9, V10, V12, V13, V17 | TG 2216 anger Ø10 s300; tätare där packningstrycket
| | kräver det (avsnitt 3.3, avsnitt 3.4)
Startjärn | Ø10 s300 på utsidan, 500 mm ned i kantbalken
| (bockade) och 1 200 mm upp i väggen | TG 2216

Vinkeljärn till bjälklaget Ø10 med samma avstånd som de lodräta järnen, 650
| mm ned i väggen och 500 mm in i bjälklaget under
| överkantsnätet | TG 2216 anger Ø10 s300; pos 14 på R-06
Hörn och anslutningar | Vinkeljärn Ø10, 750 mm åt var håll, vid båda ytorna; skarvar minst 500 mm

TG 2216 figur 5–7; figur 7 c och d

Öppningar | 2 Ø12 längs sidorna och under bröstningen, förankrade 600 mm förbi öppningen. Öppningarna går upp till bjälklaget, som har fri kant över dem (K-05)
TG 2216
Innerväggar | Vågräta järn som ovan, startjärn Ø10 s300 och lodräta järn Ø10 s300 i kärnans mitt, de lodräta från bottenplattan upp under bjälklagets överkantsnät

Inget jordtryck; gjutna i ett med bjälklaget (avsnitt 3.5)

### 3.2 Jordtryck och packning

När fyllningen packas intill en vägg som inte kan röra sig, blir ett horisontaltryck kvar i jorden. Det är större än vilojordtrycket nära markytan (Ingold, Géotechnique 1979). Trycket blir σkomp = √2Pγ/π, där P är packningsredskapets linjelast, alltså tyngd och centrifugalkraft per meter bredd. För vibroplattan i avsnitt 2 är P = 32 kN/m, vilket ger σkomp = 19 kPa. Trycket gäller från djupet där γz/Ka

når σkomp (Ka
= 0,22) ned till djupet där vilojordtrycket blir större, alltså i hela fyllningshöjden här. Med 2,0 m fyllning ger vilojordtrycket ensamt 4,9 kNm/m i väggen, och med packningstrycket 13,9 kNm/m. Packar man inte inom 1 m från väggen räcker alltså Ø10 s300. Armeringen här tillåter normal packning med lätt vibroplatta, eftersom fyllningen intill väggen annars sätter sig.

### 3.3 Bärförmåga i färdigt läge

Väggen räknas som en lodrät strimla, fritt upplagd mellan fogen mot bottenplattan och mellanbjälklagets mittplan, L = 2,175 m. Hörnen och de vinkelräta väggarna hjälper till, men det räknas inte. Ytterväggarna på plan 1 står 128 mm utanför kärnans mitt (52,5 mm utanför kärnans yta, K-05). Deras last ger ett moment i väggens topp, som avtar linjärt till noll vid bottenplattan. Hela momentet läggs på väggen och inget på bjälklaget, vilket ligger på säker sida. Det ger drag i insidan, liksom jordtrycket.

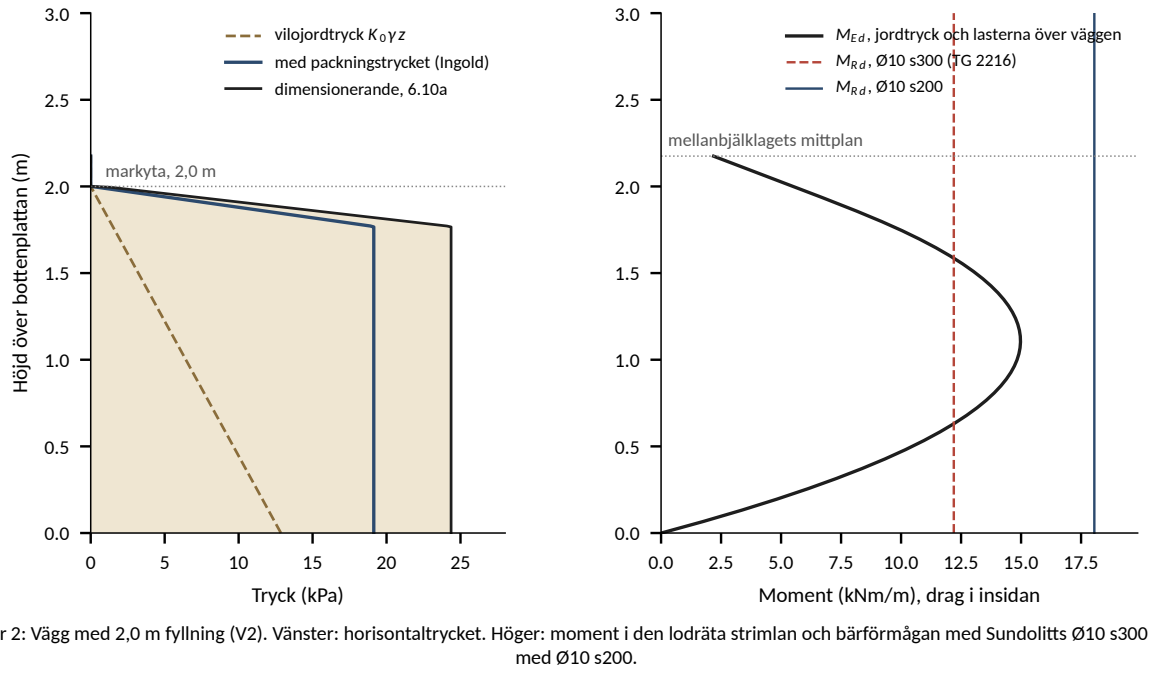
[picture p23: figure]
Tryck (kPa); Höjd över bottenplattan (m); markyta, 2,0 m; vilojordtryck K 0 γ z; med packningstrycket (Ingold); dimensionerande, 6.10a; Moment (kNm/m), drag i insidan; mellanbjälklagets mittplan; med Ø10 s200.

ME d , jordtryck och lasterna över väggen

Figur 2: Vägg med 2,0 m fyllning (V2). Vänster: horisontaltrycket. Höger: moment i den lodräta strimlan och bärförmågan med Sundolitts Ø10 s300 och

Fritidshus Trebodar, Resö, Tanum | K-06 rev A · Sida 4 av 10
- Böjning: lodräta järn på insidan, d = 110 mm. Ø10 s200 ger MRd = 18,1 kNm/m (Ø10 s300: 12,2 kNm/m). Största moment är 15,0 kNm/m i V2, 1,11 m över bottenplattan, varav 2,2 kNm/m i toppen från lasterna över väggen. Det är 83 % av bärförmågan (Ø10 s300: 123 %).
- Tvärkraft: högst 45 % av VRd,c
. Ingen tvärkraftsarmering behövs.
- Minimiarmering och andra ordningens effekter: minimiarmeringen enligt 9.3.1.1 är uppfylld i båda riktningarna. Slankheten är λ = 50. För väggarna med fyllning är normalkraften liten och gränsen enligt 5.8.3.1 minst 59, så andra ordningens effekter är försumbara.
Vägg | L (m) Fyllning (m) MEd jord + topp MEd | MRd | Böjning VEd / VRd,c | Rtopp / Rbotten | Minsta
V1 | 4,02 1,8 | 13,0 + 1,2 | 13,5 | 18,1 | 75 % | 24,6 / 60 | 16,6 / 24,6 Ø10 s200
V2 | 5,10 2,0 | 13,9 + 2,2 | 15,0 | 18,1 | 83 % | 25,0 / 60 | 21,0 / 25,0 Ø10 s200
V3 | 4,40 1,7 | 13,4 + 0,0 | 13,4 | 18,1 | 74 % | 26,6 / 60 | 15,5 / 26,6 Ø10 s200
V7 | 4,50 2,0 | 13,9 + 1,4 | 14,6 | 18,1 | 81 % | 25,4 / 60 | 20,6 / 25,4 Ø10 s200
V9 | 2,42 0,0–0,8 | 4,1 + 0,7 | 4,3 | 12,2 | 35 % | 13,8 / 60 | 3,0 / 13,8 Ø10 s300
V14 | 11,22 0,8–1,8 | 13,0 + 0,7 | 13,3 | 18,1 | 74 % | 24,8 / 60 | 16,3 / 24,8 Ø10 s200
V16 | 1,50 2,0 | 13,9 + 0,6 | 14,2 | 18,1 | 78 % | 25,7 / 60 | 20,3 / 25,7 Ø10 s200
V18 | 3,59 2,0 | 13,9 + 0,7 | 14,2 | 18,1 | 79 % | 25,7 / 60 | 20,3 / 25,7 Ø10 s200
V20 | 1,66 1,7 | 13,4 + 0,0 | 13,4 | 18,1 | 74 % | 26,6 / 60 | 15,5 / 26,6 Ø10 s200
V21 | 5,47 2,0 | 13,9 + 0,7 | 14,2 | 18,1 | 79 % | 25,7 / 60 | 20,3 / 25,7 Ø10 s200
V10–V13 | 4,52 0,8 | 4,1 + 0,0 | 4,1 | 12,2 | 33 % | 14,1 / 60 | 2,7 / 14,1 Ø10 s300

Moment i kNm/m och krafter i kN/m, dimensionerande. Största fyllning längs väggen. Minsta: den glesaste lodräta armering som räcker för väggen. Övriga väggar (V4, V5, V6, V8, V15, V17, V19) har ingen fyllning.

### 3.4 Fasaden med öppningarna

Mot fasaden med öppningarna (V10–V13) är fyllningen 0,80 m. Betongen i öppningarnas underkant ligger 0,80 och 1,40 m över bottenplattan; smygen och bröstningen har Sundolitts smyglist, 100 mm. Pelarna mellan öppningarna går upp till bjälklaget. De bär jordtrycket från sin egen bredd och halva öppningarna intill, lodrätt mellan plattorna:

Pelare Bredd (m) Lastbredd / bredd MEd (kNm/m) Lodräta järn Böjning
V10 | 0,38 | 2,33 | 9,5 Ø10 s300 | 78 %
V11 | 0,39 | 3,56 | 14,5 Ø10 s200 | 80 %
V12 | 0,58 | 2,55 | 10,4 Ø10 s300 | 85 %
V13 | 0,38 | 2,07 | 8,4 Ø10 s300 | 69 %

Varje pelare får den glesaste lodräta armering som räcker; högst 85 % (V12). Bröstningen under öppningarna spänner vågrätt mellan pelarna, högst 1,00 m. Med 24,4 kPa ger det 3,05 kNm/m mot 20,8 kNm/m med de vågräta järnen och 2 Ø12 under öppningen.

### 3.5 Vertikal last och lasterna över väggarna

Lasten i väggens topp är det största av K-05:s värde över 1 m (med det som står direkt på väggen) och väggens last per meter i den samverkande modellen (avsnitt 5). Största värde är 223,7 kN/m (V8).
- Ytterväggar: normalkraften med egentyngd och oavsiktlig excentricitet l0/400, tillsammans med momentet i avsnitt 3.3, eller i väggar utan fyllning momentet från lasterna över väggen. Högst 73 % (V21: MEd = 14,3 mot MRd = 19,6 kNm/m med normalkraft). Normalkraften ökar momentkapaciteten, så kontrollen i avsnitt 3.3 utan normalkraft ligger på säker sida. Andra ordningens moment (nominell krökning, 5.8.8) ingår där slankheten överskrider gränsen: V8.
- Innerväggar: de gjuts i ett med bjälklaget och håller emot när plattan vrider sig över dem. K-05:s modell räknas med vridfjädrar längs innerväggarnas upplagslinjer, k = 4EI/ℎ = 17 591 kNm/m per radian och meter (kärnan osprucken, C30/37 korttid, fast fot: övre gräns för väggens moment), i samma kombinationer som K-05. Toppmomentet blir högst 1,84 kNm/m (V6). Nära hörnen mot V4–V6 vill plattan lyfta från väggarna: dragkraft högst 11,5 kN/m (V19, med 0,40 kNm/m) mot 114 kN/ m för de lodräta järnen Ø10 s300 i kärnans mitt, och 0,40 mot 7,4 kNm/m. Med den största normalkraften, toppmomentet, l0/400 och andra ordningens moment (5.8.8) blir det högst 42 % (V6: 8,6 kNm/m varav 5,7 av andra ordningen, mot 20,3 kNm/m). Plattan påverkas lite: dess dimensionerande moment ändras högst 1,2 kNm/m (överkant, 7,6 → 8,9 kNm/m, under nätets 15,8 kNm/m) och rörlasterna högst 0,3 kN, så K-05:s fritt upplagda modell gäller. Väggens fot för ner högst halva toppmomentet i balken under väggen.
- Lasterna över väggarna: ytterväggarna på plan 1 står på bjälklaget 52,5 mm utanför kärnans yta. Det är mindre än halva bjälklagets tjocklek, så lasten går med en tryckstrimla direkt in i kärnan. Bjälklaget och kärnan gjuts samtidigt. Konsolmomentet till kärnans yta blir högst 0,91 kNm/m (17,4 kN/m) mot 15,8 kNm/m för överkantsnätet.
- LD4_2 (K-05, 44 kN dimensionerande) står i hörnet V2/V20, 50 och 30 mm utanför kärnornas ytor. Bjälklaget (d = 113 mm) räknas längs kärnornas ytor, u = 650 mm:
- tryckstrimlan: VEd / VRd,max = 44 / 331 kN (13 %);
- tvärkraft med β = av/2d = 0,25 (6.2.2(6)): 30 % av VRd,c
= 36 kN;
- dragband i överkant: Fav/z = 21,6 kN mot 95 kN för nätet (23 %).
Zon Ö1 i K-05 ger dessutom tilläggsjärn i överkant över hörnet.

### 3.6 Anslutningar och fogar

- Topp: i ytterväggarna gjuts det översta halva skiftet samtidigt med mellanbjälklaget. Kärnan och bjälklaget blir då en enhet, och bjälklaget vilar på hela kärnan (TG 2216 kräver minst 100 mm). Den yttre cellplasten i det översta skiftet kapas i bjälklagets underkant, och bjälklaget går ut till 30 mm från väggens ytterliv, med 30 mm kantisolering utanför (husets modell). Vinkeljärnen, med samma avstånd som de lodräta järnen, förankrar väggen i bjälklaget. Största reaktion i toppen är 21,0 kN/ m.

Fritidshus Trebodar, Resö, Tanum | K-06 rev A · Sida 5 av 10
- Gjutfogen vid 1 800 mm: tvärkraften där är högst 18,8 kN/m. Med de lodräta järnen genom fogen och en uppruggad yta
(6.2.5) är utnyttjandet 9 %.
- Botten: kärnan gjuts direkt på kantbalkens uppruggade överkant, och startjärnen går genom fogen. Bottenplattan är golvet som håller väggens fot, och kärnan står i kontakt med den, som TG 2216 kräver när fyllningen är högre än 1 m. Största reaktion i botten är 26,6 kN/m. Fogen har bärförmågan 1,05 MPa (6.2.5: uppruggad yta, startjärnen, väggens egentyngd). Det ger högst 17 %.
- Hörn och anslutningar: vågräta järn med vinkeljärn enligt TG 2216 figur 5–7, se figur 7 c och d.
- Innerväggar: som ytterväggarna gjuts de tre hela skiften först och det översta halva skiftet med bjälklaget. De lodräta järnen Ø10 s300 i kärnans mitt går genom fogen vid 1 800 mm upp under bjälklagets överkantsnät, så att väggen och bjälklaget blir en enhet (avsnitt 3.5).

### 3.7 Utförande av väggarna

- Montering: elementen staplas i förband med armeringen i bindarnas hållare. Väggarna riktas och stagas enligt Sundolitts anvisning: stag vid alla hörn och öppningar och annars cirka var 2 m, med skruv minst 140 mm i bindarna. Kapade element och kanter vid öppningar förstärks med plywood eller läkt.
- Gjutning: pump med reducerat tryck, och betongen stiger högst 1 m per timme. Börja i ett hörn och gå runt väggarna i varv. Högst 2,4 m per gjutning, ingen vibrator i väggarna (stöt för hand vid behov). Kontrollera sättmåttet på plats. Gjut inte under −5 °C.
- Första gjutningen är de tre hela skiften i alla väggar, upp till 1 800 mm. Fogen i överkant ruggas och rengörs, och elementens knastar täcks.
- Gjutning med bjälklaget: bjälklagets form och stämp står för sig själva och får inte hänga i Kub-elementen. Väggarnas översta skift fylls först. Efter 30–60 minuter, när betongen har satt sig, fylls de upp igen, och sedan gjuts bjälklaget. Bara bjälklaget vibreras.
- Insida: gips 13 mm (typ A) på all cellplast, också i smygar, skruvad i bindarna. Enligt TG 2216 ger det REI 30. Kärnan klarar REI 90 enligt SS-EN 1992-1-2 tabell 5.4 (150 mm ≥ 140 mm, axelavstånd 30 mm ≥ 25 mm). Gipset skyddar cellplasten och får inte vara genombrutet; eldosor enligt TG 2216. Ingen ångspärr behövs, eftersom halva isoleringen ligger utanför kärnan.
- Utsida under mark: grundmursskiva med knopparna mot väggen och en avslutningslist upptill. Dränledning runt huset med fall minst 1:200. Ledningens högsta punkt ska ligga minst 200 mm under golvets överkant och under plattans cellplast. Ledningen och väggen omges med dränerande material, med fiberduk mot jorden. Marken ska falla från huset, minst 1:50 över 3 m.
- Utsida ovan mark: fasadsten enligt AR-01. Den täcker all cellplast ovan mark, som TG 2216 kräver.

### 4 Byggskedet

### 4.1 Ordningsföljd

1. Gjut bottenplattan (avsnitt 5) med startjärnen ingjutna och uppruggad yta under väggarna.
2. Montera Kub-elementen med armering, vinkeljärn i hörnen och staga väggarna.
3. Gjut de tre hela skiften (1 800 mm) i alla väggar.
4. Fyll bakom V3 och V20 till 1,7 m när betongen har nått fck(t) ≥ 20 MPa (avsnitt 4.3). Lagren ska vara högst 0,2 m, packade med lätt vibroplatta inom 1 m från väggen. Lägg sedan 400 mm cellplast för plattan på mark.
5. Montera väggarnas översta halva skift, rören, bjälklagets form och armering samt vinkeljärnen. Gjut det översta skiftet och mellanbjälklaget i samma gjutning.
6. Fyll mot övriga väggar när bjälklaget och det översta skiftet har nått fck(t) ≥ 20 MPa. Väggarna under har då härdat längre. Bjälklagets stämp får stå kvar; de påverkar inte väggarna.
7. Riv formen under bjälklaget enligt R-06.
Sundolitt rekommenderar minst fyra veckors härdning och torkning innan det fylls mot väggarna. Det är ett allmänt råd som också gäller torkning före puts. TG 2216 kräver att väggar och bjälklag är gjutna och har härdat tillräckligt. Här räknas hur mycket som räcker.

### 4.2 V3 och V20 innan bjälklaget finns

Fyllningen bakom V3 och V20 bär plattan på mark på plan 1, som är en del av mellanbjälklaget. Den måste därför ligga på plats innan bjälklaget gjuts. Väggarna har då fri överkant, 1 800 mm. Som fri konsol skulle V3 behöva inspänning i foten, cirka 32 kNm/m, men bottenplattan och kantbalken kan inte ta den. Väggarna räknas i stället med brottlinjeteori: de bär åt två håll, är inspända i hörnen med vinkeljärnen och ledat upplagda i botten. Lasten är fyllningen till 1,7 m med packningstryck. På fyllningen ligger dessutom cellplasten, 0,12 kN/m² permanent, och färsk betong med arbetslast när plattan på mark gjuts, 5,25 kN/m² (SS-EN 1991-1-6), som nyttig last.
- V3 (L = 4,40 m): med Sundolitts vågräta järn (Ø10 s600) blir λ = 0,96. Med Ø10 s300 i båda ytorna i hela höjden (mℎ
= 13,3
kNm/m i fält och 12,8 kNm/m vid hörnen, mv

= 18,1 kNm/m) blir λ = 1,47, och vid återfyllningen (20 MPa) 1,45.
- V20 (L = 1,66 m) klarar sig med Sundolitts armering, λ = 3,27.
- Hörnen: vinkeljärnen Ø10 (750 + 750) i V3:s hörn får spänningen fyd/λ = 296 MPa. Med sämre vidhäftning (η1 = 0,7) och alla
järn skarvade i samma snitt (α6
= 1,5) behövs förankringslängden 348 mm mot 500 mm.
- Tvärkraft: 25,6 kN/m mot VRd,c
= 60 kN/m.

### 4.3 Hållfasthet vid återfyllning

Betongens hållfasthet efter t dygn följer SS-EN 1992-1-1 3.1.2: fcm(t) = βcc(t)fcm med βcc(t) = exp(s(1 − √28/t)), fck(t) = fcm(t) − 8 MPa och fctm(t) = βcc(t)fctm. Kontrollerna i byggskedet görs med betongen vid ålder t:

Fritidshus Trebodar, Resö, Tanum | K-06 rev A · Sida 6 av 10

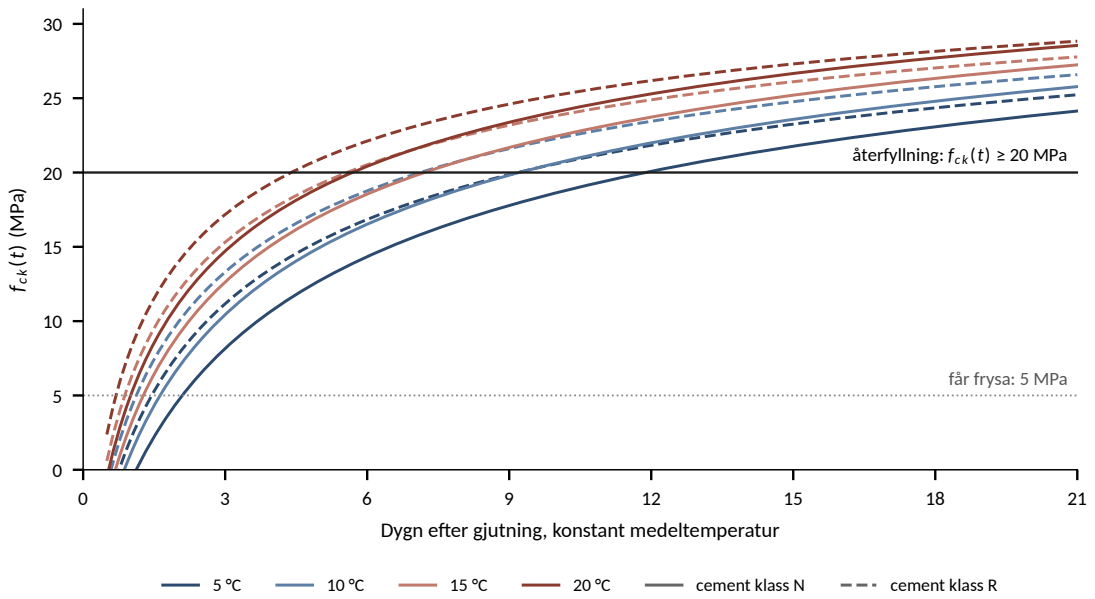
[picture p24: figure]
Dygn efter gjutning, konstant medeltemperatur; f t c k ( ) (MPa); återfyllning: fc k (t) ≥ 20 MPa; får frysa: 5 MPa; cement klass N; cement klass R

Figur 3: fck(t) för C30/37 mot dygn efter gjutning vid konstant medeltemperatur, med cement i klass N (heldragen) och R (streckad). Kravet för återfyllning och gränsen innan betongen får frysa.

- V3 och V20 innan bjälklaget: λ och tvärkraft räcker redan efter tre dygn. Förankringen av vinkeljärnen i hörnen styr och kräver fck(t) ≥ 18,9 MPa.
- Övriga väggar efter bjälklaget (mest belastad V2): böjning, tvärkraft och gjutfogen räcker efter tre dygn. Skarven mellan vinkeljärnen och de lodräta järnen i det översta skiftet (282 MPa) kräver fck(t) ≥ 14,7 MPa.
Kravet blir fck(t) ≥ 20 MPa, två tredjedelar av fck, innan det fylls mot någon vägg (fcm(t) ≥ 28 MPa; provkuber ungefär 20 % högre). Det gäller väggarna och, för de övriga väggarna, också bjälklaget och det översta skiftet. Vid lägre temperatur tar det längre tid. Mognadsåldern enligt SS-EN 1992-1-1 (B.10) är tT = ∑exp(−(4000/(273 + T ) − 13,65))Δt, där T är dygnets medeltemperatur. Kravet nås vid mognadsåldern 5,7 dygn med cement i klass N (s = 0,25) och 4,4 dygn med klass R (s = 0,20), alltså:

Dygnsmedeltemperatur Återfyllning, klass N Återfyllning, klass R Frost, klass N Frost, klass R
5 °C | 12 dygn | 10 dygn | 3 dygn | 2 dygn
10 °C | 10 dygn | 8 dygn | 2 dygn | 2 dygn
15 °C | 8 dygn | 6 dygn | 2 dygn | 1 dygn
20 °C | 6 dygn | 5 dygn | 2 dygn | 1 dygn
Dygn efter gjutning, minst 3. Frost: dygn tills fck(t) = 5 MPa, då betongen tål att frysa. Dessförinnan ska den skyddas mot frost. Kärnan är isolerad av cellplasten och håller värmen, så att räkna med luftens temperatur ligger på säker sida. Bjälklagets ovansida täcks med isolermattor när det är kallt.
- Kontroll: temperaturgivare i väggen och i bjälklaget, med mognadsgraden räknad som ovan, eller provkuber som härdar bredvid väggen. Är betongleverantörens cement i klass R gäller den kolumnen.
- Exempel vid 10 °C med cement i klass N: V3 och V20 fylls tidigast 10 dygn efter den första gjutningen, och övriga väggar 10 dygn efter bjälklaget. Vid 20 °C är tiderna 6 dygn och vid 5 °C 12 dygn.

### 5 Bottenplatta

### 5.1 Uppbyggnad

- Underlag: makadam på sprängt berg, avjämnat och packat.
- Under plattan: cellplast S100 i två skikt, 200 mm. Åldringsbeständig plastfolie ligger i ett plan över hela ytan, 200 mm under överkant: mellan skikten (Plattor.pdf), under balkarna och plintarna och ut över L-elementens fot, med minst 200 mm tejpade överlapp, mot radon (R-04). Bottenplattan är alltså 300 mm hög: 100 mm betong på 200 mm cellplast, samma i hela källaren.
- Längs ytterkanten: L-element S300, 300 mm högt och 600 mm brett (t.ex. Finja L-element S300), med ytterkanten i väggens ytterliv. Ryggen är 100 mm och avfasad i ovankant, och betongen börjar innanför ryggen och fyller fasen (figur 6). Väggens yttre cellplast står på ryggen och fasen. Kantbalken är 450 mm bred och 200 mm hög inklusive plattan och står på L-elementets fot, 100 mm S300. Väggens kärna står på kantbalkens yttersta 150 mm. Foten går 50 mm förbi kantbalken, och plattans övre cellplastskikt läggs in över den och fästs med plastspik. Modellen räknar med kantbalkens bredd 450 mm på S300 och plattans cellplast innanför.
- Under innerväggarna V4–V6, V15 och V19: balkar 450 mm breda med samma höjd och 100 mm S300 under.
- Under rören: kvadratiska plintar med samma höjd, sida 600–1 200 mm (figur 6). Storleken är vald så att trycket på cellplasten under plintarna blir ungefär lika stort som under väggarna, så att rören och väggarna sätter sig lika mycket. Röret svetsas på en fotplåt 200 × 200 × 15 S355 med fyra svetsbultar Ø13, L = 75 mm, som gjuts in i plintens överkant. Vid P7 står två rör tätt intill varandra på en gemensam fotplåt 280 × 200 × 15 (K-05). Röret bär bara tryck, och bultarna håller det på plats.

Fritidshus Trebodar, Resö, Tanum | K-06 rev A · Sida 7 av 10
100 | 150 | 100

300 150

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
1 | mellanbjälklag 150 (K-05), gjuts med det översta halva skiftet
2 | vinkeljärn Ø10 s200 till bjälklaget, 650 + 500, under nätet
3 | kantisolering 30; bjälklaget går 70 mm ut över cellplasten
4 | ytterväggen på plan 1, centrum 52,5 mm utanför kärnan
5 | fasadsten 40 mm på armeringsbruk (AR-01)
6 | gjutfog: de tre hela skiften gjuts först, 1 800
7 | Sundolitt Kub 350-150: cellplast 100 + betong 150 + cellplast 100
8 | lodräta järn Ø10 s200 på insidan, upp till bjälklagets överkantsnät
9 | 2 Ø10 per skift, ett vid var yta (s600; s300 i de två översta)
10 | gips 13 mm, ingen ångspärr
11 | startjärn Ø10 s300 på utsidan, 1 200 upp, foten 330 in i kantbalken
12 | kantbalk 450 × 200: 2 Ø10 uk + 2 Ø10 ök, U-byglar Ø6 s600
13 | platta 100: Ø6 s150 i över- och underkant
14 | cellplast 200 mm S100 i två skikt, plastfolie i hela ytan mellan; det övre 50 mm in över L-elementets fot
15 | L-element S300, höjd 300, bredd 600 (t.ex. Finja): ryggen under väggens cellplast, avfasad upptill, fot 100 mm S300
16 | grundmursskiva, knopparna mot väggen, list upptill
17 | dränerande fyllning; inom 1 m lager ≤ 0,2 m och lätt vibroplatta
18 | dränledning, vattengång under plattans cellplast
19 | makadam på sprängt berg
20 | fall från huset ≥ 1:50 över 3 m
Figur 4: Yttervägg mot jord (Kub 350-150) på kantbalk i L-element (höjd 300), med mellanbjälklaget. Mått i mm.
- Platta: 100 mm C30/37 med Ø6 s150 i över- och underkant. Golvvärmeslangarna fästs i underkantsnätet.

### 5.2 Beräkningsmodell

- Bottenplattan: plattelement (DKT) med verklig tjocklek, 100 mm i fält och 200 mm i balkar och plintar. Plattan står på en bädd k = E/t, med Ek

eller 0,4Ek
och olika tjocklek och kvalitet under plattan och under balkar och plintar.
- Mellanbjälklaget: K-05:s nät och laster. Plattan på mark (plan 1) ligger på 400 mm S100.
- Väggarna: kärnan som fjäder Et/ℎ med t = 150 mm längs K-05:s upplagslinjer i kärnans mitt.
- Rören: fjädrar EA/L mellan plåtarna i de två plattorna.
- Styvheter, två omgångar:
- kort: Ek

för cellplasten och Ecm för betongen;
- lång: 0,4Ek

för cellplasten, Ecm/(1 + 2,8) för plattorna, Ecm/(1 + 2,0) = 10 900 MPa för kärnan, och kärnans krympning, 0,63 mm över väggens höjd.
- Laster: lastfall och kombinationer som i K-05. Väggarnas egentyngd är 3,90 kN/m² (kärna, cellplast och gips). På ytterväggarna kommer fasadsten till, 1,3 kN/m² från 50 mm under mark till bjälklagets överkant (AR-01). Bottenplattans egentyngd ingår också. Resultaten är det ogynnsammaste av omgångarna.

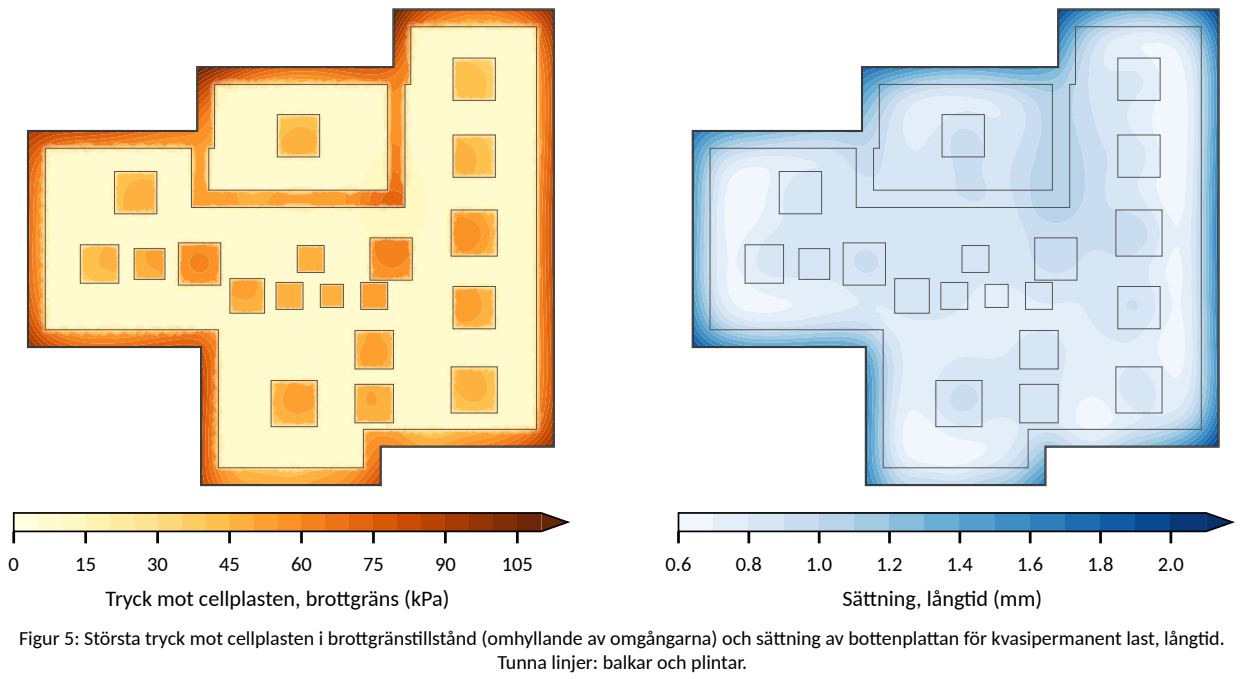
[picture p25: figure]
Tryck mot cellplasten, brottgräns (kPa); Sättning, långtid (mm); Tunna linjer: balkar och plintar.

Figur 5: Största tryck mot cellplasten i brottgränstillstånd (omhyllande av omgångarna) och sättning av bottenplattan för kvasipermanent last, långtid.

Fritidshus Trebodar, Resö, Tanum | K-06 rev A · Sida 8 av 10

### 5.3 Cellplast och sättningar

Tryck (kPa) | Värde Gräns
S300 under balkar och plintar, brottgräns (medel inom r = 150 mm vid toppen) | 115 (110) | 118
S300, bara permanent last | 86 | 97
S300, kvasipermanent långtid | 74 | 90
S100 under plattan, brottgräns | 12 | 35
S100 under plattan, kvasipermanent långtid | 8 | 30
Sättning av bottenplattan, långtid (mm) | 0,6–2,1

Betongväggarna med fasadsten väger cirka 8–11 kN/m. Kärnan står på kantbalkens yttersta 150 mm, så trycket under kantbalken blir störst vid dess ytterkant och störst vid de yttre hörnen, där hörnstolparna på plan 1 och LD4_2 står. S200 räcker inte där. Alla balkar och plintar står därför på S300, och plattan på S100; bara två kvaliteter behövs.
Mellanbjälklagets stöd sätter sig långtid 0,8–1,3 mm vid rören och 1,5–2,6 mm vid väggarna. Väggarna sätter sig alltså cirka 0,8 mm mer än rören. Kärnans krympning ensam ger högst 3,2 kNm/m i mellanbjälklaget. Effekten finns med i kontrollen i avsnitt 5.5.
Plattan på mark på plan 1 (K-05, 400 mm S100): största tryck är 33 kPa mot fd
= 35 kPa i brottgränstillstånd och 17 kPa långtid mot 30 kPa, alltså 97 %. S100 räcker där. Tjockleken bestäms av värmeisoleringen, inte av tryckklassen.

### 5.4 Platta, balkar och plintar

- Platta 100 mm: största moment utanför balkar och plintar, minst d = 61 mm från dem, är 2,8 kNm/m i underkant och 2,9 kNm/m i överkant. Det motsvarar 58 % av Ø6 s150 (MRd = 4,8 / 5,2 kNm/m). Närmare balkarna är momentet en lokal topp vid den tjocka delens kant, störst i inåtgående hörn mellan balkarna (3,3 kNm/m precis vid kanten). Toppen är en singularitet i FE-lösningen och avtar inom några centimeter; nätet går in i balkarna och tar momentet där.
- Kantbalkar: balkmoment (plattans moment integrerat över 450 mm) högst 5,9 kNm i underkant och 3,9 kNm i överkant. 2 Ø10 i under- och överkant ger MRd = 10,3 / 10,7 kNm (57 %).

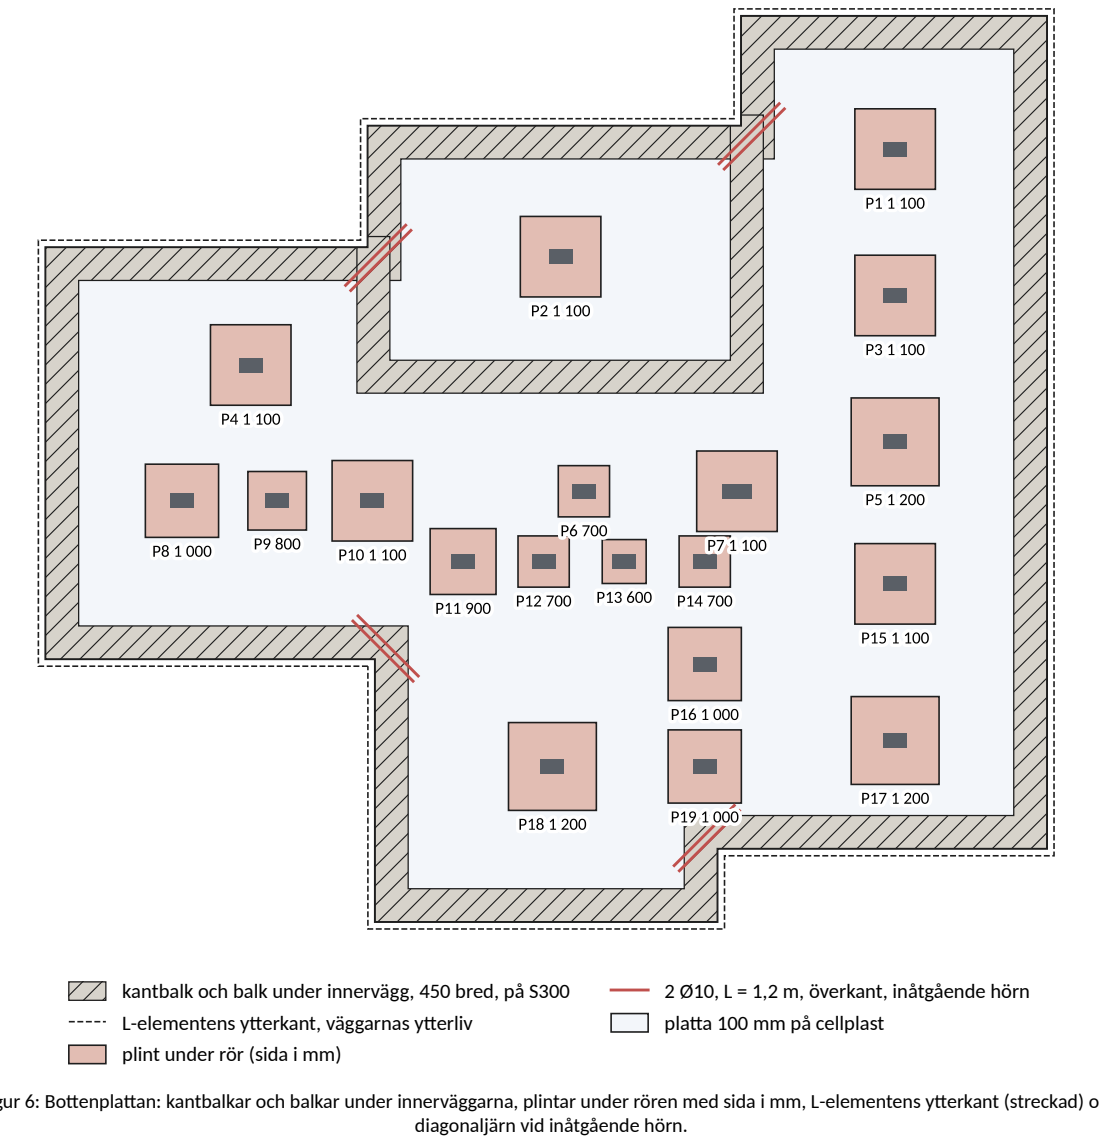
[picture p26: figure]
L-elementens ytterkant, väggarnas ytterliv; plint under rör (sida i mm); platta 100 mm på cellplast; diagonaljärn vid inåtgående hörn.

kantbalk och balk under innervägg, 450 bred, på S300

2 Ø10, L = 1,2 m, överkant, inåtgående hörn

Figur 6: Bottenplattan: kantbalkar och balkar under innerväggarna, plintar under rören med sida i mm, L-elementens ytterkant (streckad) och

Fritidshus Trebodar, Resö, Tanum | K-06 rev A · Sida 9 av 10
- Tvärkraft högst 18,8 kN, 54 % av VRd,c
. Ingen tvärkraftsarmering behövs.
- U-byglar Ø6 s600 håller längsjärnen på plats. Balken är en förtjockning av en platta på bädd, så minimiarmering för byglar behövs inte (6.2.1(4)).
- Startjärnen bockas in i kantbalken med foten, 330 mm, på byglarna, så att 500 mm ligger i balken (figur 4). Under innerväggarna, där startjärnen står i balkens mitt, läggs foten längs balken.
- Balkar under innerväggarna (figur 7): 42 % av samma armering, tvärkraft 38 %.
- Plintar (figur 7): Ø8 s150 i underkant i båda riktningarna. Lastytan är fotplåtens effektiva yta, 137 × 137 mm (SS-EN 1993-1-8 6.2.5 med fjd = 2fcd). Genomstansning räknas med hela rörlasten, utan avdrag för cellplastens tryck innanför snittet:
- i plinten enligt 6.4.4, snitt från 0,5d till 2d som ligger inom plinten (d = 160 mm): högst 44 % (P5);
- i den tunna plattan, 2d från plintens kant (d = 61 mm, Ø6 s150): högst 54 % (P10).
- Böjning med jämnt tryck under plinten och konsol från lastytans kant: högst 34 %.
- Hörn: 2 Ø10, L = 1,2 m, i överkant diagonalt vid plattans inåtgående hörn.
- Sprickor: krympningen hålls av cellplasten bara med friktion. Plattan behöver inga fogar, men golvbeläggning och tätskikt ska tåla krympsprickor.

Rör Plint (mm) NEd (kN) Tryck N/b

2
(kPa) Stansning i plinten i plattan Böjning
P1 | 1 100 | 44,0 | 36 | 25 % | 32 % | 19 %
P2 | 1 100 | 47,4 | 39 | 27 % | 35 % | 20 %
P3 | 1 100 | 43,8 | 36 | 25 % | 32 % | 19 %
P4 | 1 100 | 47,7 | 39 | 27 % | 35 % | 20 %
P5 | 1 200 | 77,7 | 54 | 44 % | 53 % | 34 %
P6 | 700 | 18,7 | 38 | 10 % | 20 % | 7 %
P7 | 1 100 | 67,6 | 56 | 36 % | 50 % | 29 %
P8 | 1 000 | 41,5 | 41 | 24 % | 33 % | 17 %
P9 | 800 | 32,6 | 51 | 19 % | 31 % | 12 %
P10 | 1 100 | 73,5 | 61 | 42 % | 54 % | 31 %
P11 | 900 | 34,9 | 43 | 20 % | 30 % | 14 %
P12 | 700 | 23,1 | 47 | 12 % | 25 % | 8 %
P13 | 600 | 10,7 | 30 | 5 % | 13 % | 4 %
P14 | 700 | 24,6 | 50 | 13 % | 26 % | 9 %
P15 | 1 100 | 56,5 | 47 | 32 % | 42 % | 24 %
P16 | 1 000 | 46,5 | 47 | 26 % | 37 % | 19 %
P17 | 1 200 | 59,4 | 41 | 34 % | 41 % | 26 %
P18 | 1 200 | 64,9 | 45 | 37 % | 44 % | 28 %
P19 | 1 000 | 44,7 | 45 | 25 % | 36 % | 18 %

### 5.5 Mellanbjälklaget och rören i samverkan

Med väggarna och rören som fjädrar på en bottenplatta som sätter sig blir K-05:s stödmoment vid väggändarna mindre, eftersom de är toppar från stela upplagslinjer. Lasterna fördelas också om något mellan rör och väggar.
- Böjning: moment utjämnat över 250 mm mot K-05:s armering med tilläggsjärn ger 62 % i överkant och 61 % i underkant. Samma mått med K-05:s egen omhyllning ger 66 % och 58 %. K-05:s armering räcker alltså även med sättningar och kärnans krympning.
- Rörlaster: de blir högst 21 % större än i K-05 (P11), för de lätt belastade rören P1 44/39, P2 47/40, P3 44/38, P4 48/39, P8 41/37, P9 33/32, P11 35/29, P12 23/22, P15 56/55, P17 59/55, P19 45/43 (kN, samverkan / K-05). Genomstansningen i K-05 har stor marginal vid dessa rör. Största utnyttjande med armeringen 10 mm för lågt blir 99 % (P7).
- Väggarna: lasten fördelas om mellan väggarna. Väggar som får mer last än med K-05:s stela upplagslinjer: V11, V12, V19. Kontrollen i avsnitt 3.5 använder det största av de två.

### 5.6 Glidning, tjäle och fukt

- Glidning: fasaden med öppningarna har bara 0,80 m fyllning, så jordtrycket på huset är ojämnt. Karakteristiskt blir det netto 102 kN söderut och 100 kN åt höger i figur 1. Dimensionerande är det 176 kN mot friktionen μG = 0,3 × 1 938 = 581 kN i det svagaste skiktet (plastfolien mellan cellplastskikten), alltså 30 %. Räknas också packningstrycket blir det 370 kN, 64 %. Kraften förs genom mellanbjälklaget och bottenplattan som skivor. TG 2216 kräver att jordtrycket tas med i husets stabilitet när väggarna hålls av bjälklaget.
- Tjäle: grundläggning på dränerad makadam på berg och uppvärmd källare. Ingen markisolering behövs mot tjäle, inte heller vid fasaden med öppningarna.
- Fukt: dränering och fuktskydd enligt avsnitt 3.7. Den åldringsbeständiga plastfolien i hela ytan under plattan ligger kvar som i Plattor.pdf och minskar också risken för radon.

### 6 Utförande och kontroll

1. Spräng och avjämna berget och lägg makadam. Lägg dränledningen runt huset innan cellplasten läggs.
2. Lägg L-element med fot av S300 och ytterkanten i väggarnas ytterliv, cellplast S300 under innerväggarnas balkar och plintarna och S100 under plattan i två skikt, det övre skiktet 50 mm in över L-elementens fot. Åldringsbeständig plastfolie över hela ytan ovanpå det undre skiktet, under balkar och plintar och ut över L-elementens fot, med minst 200 mm tejpade överlapp (radon). Skär ur cellplasten för balkar och plintar.
3. Armera: nät Ø6 s150 i båda lagren, kantbalkar och balkar 2 Ø10 + 2 Ø10 med U-byglar Ø6 s600, plintar Ø8 s150 i underkant, diagonaljärn och startjärn Ø10 s300 till väggarna. Fixera rörens fotplåtar i läge och höjd. Lägg golvvärmeslangarna.
4. Gjut bottenplattan med balkar och plintar i en gjutning, med fotplåtarna kant i kant med plintarnas överkant, och rugga ytan under väggarna.

Fritidshus Trebodar, Resö, Tanum | K-06 rev A · Sida 10 av 10

b = 600–1 200

1

2

3

4
5
7 | 6

450

1

2 | 3

4

6 | 5

750

500

ute (jord)

inne

1

2

3

4

fyllning

källare

1

2

3

4

a) Plint under rör

1 rör VKR 80×80×4 (K-05), svetsas på plåten 2 fotplåt 200 × 200 × 15 S355, gjuts in i plinten 3 4 svetsbultar Ø13, L = 75 mm
4 platta 100: Ø6 s150 i över- och underkant
5 plint: Ø8 s150 i underkant, båda riktningarna 6 cellplast S300, 100 mm under plinten
7 cellplast S100, 200 mm i två skikt
b) Balk under innervägg

1 innervägg Kub 350-150 (V4–V6, V15, V19)
2 startjärn Ø10 s300 i kärnans mitt, 1 200 upp, foten längs balken 3 2 Ø10 i överkant
4 U-byglar Ø6 s600
5 2 Ø10 i underkant
6 cellplast S300, 100 mm under balken c) Yttre hörn i plan, t.ex. V21/V3

1 vinkeljärn Ø10, 750 + 750, vid båda ytorna, i varje skift 2 vågräta järn, skarvas minst 500 med vinkeljärnen
3 betongkärna 150
4 cellplast 100
d) V3 mot V19/V20 i plan (spegelvänd)

1 V3: 2 Ø10 s300 i båda ytorna, hela höjden
2 vinkeljärn Ø10 s300 från V3:s utsida genom kärnan, 750 längs V20:s bortre yta 3 vinkeljärn Ø10 s300 från V3:s insida genom kärnan, 750 längs V19:s bortre yta 4 V20 och V19: betongkärnan går igenom

Figur 7: Lokal armering, ungefär skala 1:20. Mått i mm. a) Plint under rör. b) Balk under innervägg. c) Yttre hörn i plan. d) V3 mot V19/V20 i plan. Kantbalkens armering och väggens anslutningar visas i figur 4.

5. Bygg och gjut väggarna och mellanbjälklaget i den ordning som anges i avsnitt 4, och fyll mot väggarna först när betongen har nått fck(t) ≥ 20 MPa.
6. Kontrollera före gjutning: armeringens läge och täckskikt (distanser), plintarnas läge och storlek, startjärnen. Kontrollera före väggarnas gjutning: de lodräta järnen (Ø10 s200 och Ø10 s300, i innerväggarna Ø10 s300), de vågräta järnen i V3 (Ø10 s300), vinkeljärnen i hörnen och stagningen. Under gjutningen: sättmått och stighastighet. Före återfyllning: betongens hållfasthet (temperaturgivare eller provkuber) och vibroplattans vikt.

Bilaga A Kontroll av beräkningarna
- Brottlinjeberäkningen ger kända lösningar:
- fritt upplagd kvadratisk platta med lika moment: λqL

2/m = 24,04 (exakt 24);
- rektangel 2 : 1: 14,16 (Johansen 14,14);
- vågrät strimla inspänd i båda ändar: λ dividerat med den exakta lösningen 16m/(qL

2
) = 1,000.
- Strimlan ger för jämnt tryck 10 kPa över hela spännvidden qL

2/8 = 5,91 kNm/m.
- Hållfasthetstillväxten: βcc(7) = 0,779 för cement i klass N, alltså fck(7) = 21,6 MPa. Mognadsfaktorn vid 10 °C är 0,616, alltså ett dygn vid 10 °C motsvarar 0,616 dygn vid 20 °C.
- Sättning under balkarna för hand: w = σt/E = 74 kPa × 100 mm / 3 600 kPa = 2,06 mm. FE-modellen ger högst 2,06 mm.
- Jämvikt i den samverkande modellen: summan av lasten är lika med reaktionen från cellplasten under bottenplattan och plattan på mark (kN): egentyngd 1 938 = 1 938, snö V 112 = 112, snö M 132 = 132, snö H 137 = 137, nyttig last i källaren 345 = 345.
- Nätet: grundnät 140 mm i stället för 200 mm (40 239 mot 31 864 element i bottenplattan) ändrar största cellplasttryck (kvasipermanent last) från 69,6 till 70,0 kPa, sättningen från 2,90 till 2,92 mm och rörlasterna högst 0,8 %.
- Kopplingen till K-05: mellanbjälklagets nät, laster och lastmönster hämtas direkt från K-05:s program, så nätet är detsamma nod för nod.
