vron/trebodar/ritningar/R-04 Bottenplatta.pdf

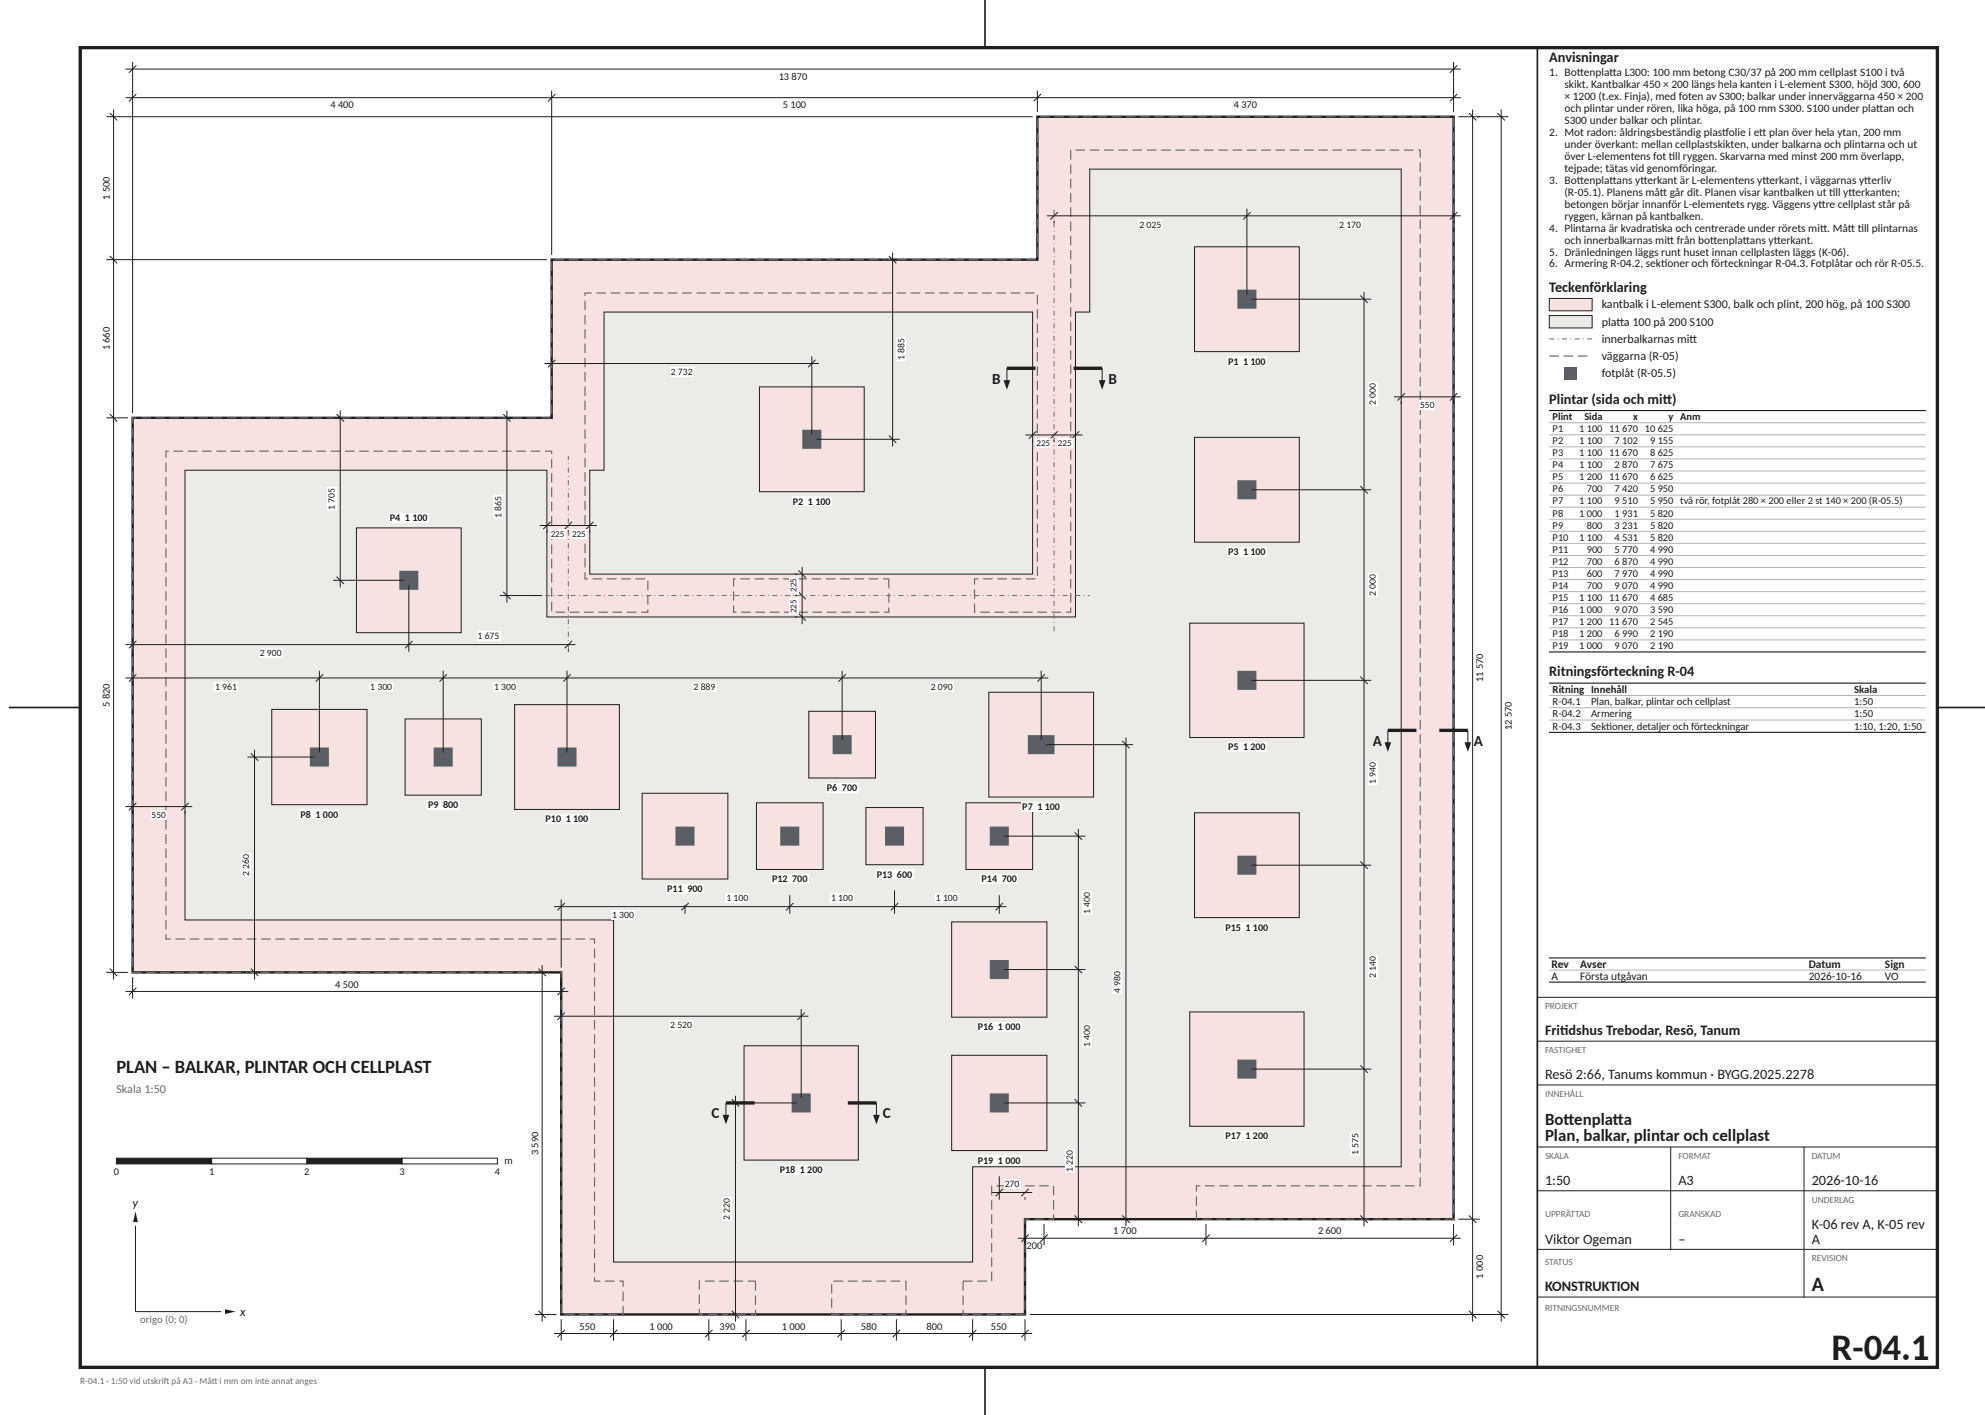
[picture p27: page 1]

Anvisningar
1. Bottenplatta L300: 100 mm betong C30/37 på 200 mm cellplast S100 i två
skikt. Kantbalkar 450 × 200 längs hela kanten i L-element S300, höjd 300, 600
× 1200 (t.ex. Finja), med foten av S300; balkar under innerväggarna 450 × 200
och plintar under rören, lika höga, på 100 mm S300. S100 under plattan och
S300 under balkar och plintar.
2. Mot radon: åldringsbeständig plastfolie i ett plan över hela ytan, 200 mm
under överkant: mellan cellplastskikten, under balkarna och plintarna och ut
över L-elementens fot till ryggen. Skarvarna med minst 200 mm överlapp,
tejpade; tätas vid genomföringar.
3. Bottenplattans ytterkant är L-elementens ytterkant, i väggarnas ytterliv
(R-05.1). Planens mått går dit. Planen visar kantbalken ut till ytterkanten;
betongen börjar innanför L-elementets rygg. Väggens yttre cellplast står på
ryggen, kärnan på kantbalken.
4. Plintarna är kvadratiska och centrerade under rörets mitt. Mått till plintarnas
och innerbalkarnas mitt från bottenplattans ytterkant.
5. Dränledningen läggs runt huset innan cellplasten läggs (K-06).
6. Armering R-04.2, sektioner och förteckningar R-04.3. Fotplåtar och rör R-05.5.
Teckenförklaring

kantbalk i L-element S300, balk och plint, 200 hög, på 100 S300
platta 100 på 200 S100
innerbalkarnas mitt
väggarna (R-05)
fotplåt (R-05.5)

Plintar (sida och mitt)

PROJEKT
Fritidshus Trebodar, Resö, Tanum

FASTIGHET
Resö 2:66, Tanums kommun · BYGG.2025.2278

PLAN – BALKAR, PLINTAR OCH CELLPLAST

INNEHÅLL
Bottenplatta
Plan, balkar, plintar och cellplast

SKALA 1:50 | FORMAT A3 | DATUM 2026 -10 -16

UPPRÄTTAD Viktor Ogeman | GRANSKAD – | UNDERLAG K-06 rev A, K -05 rev A

STATUS KONSTRUKTION | | REVISION A

-04.1 · 1:50 vid utskrift på A3 · Mått i mm om inte annat anges

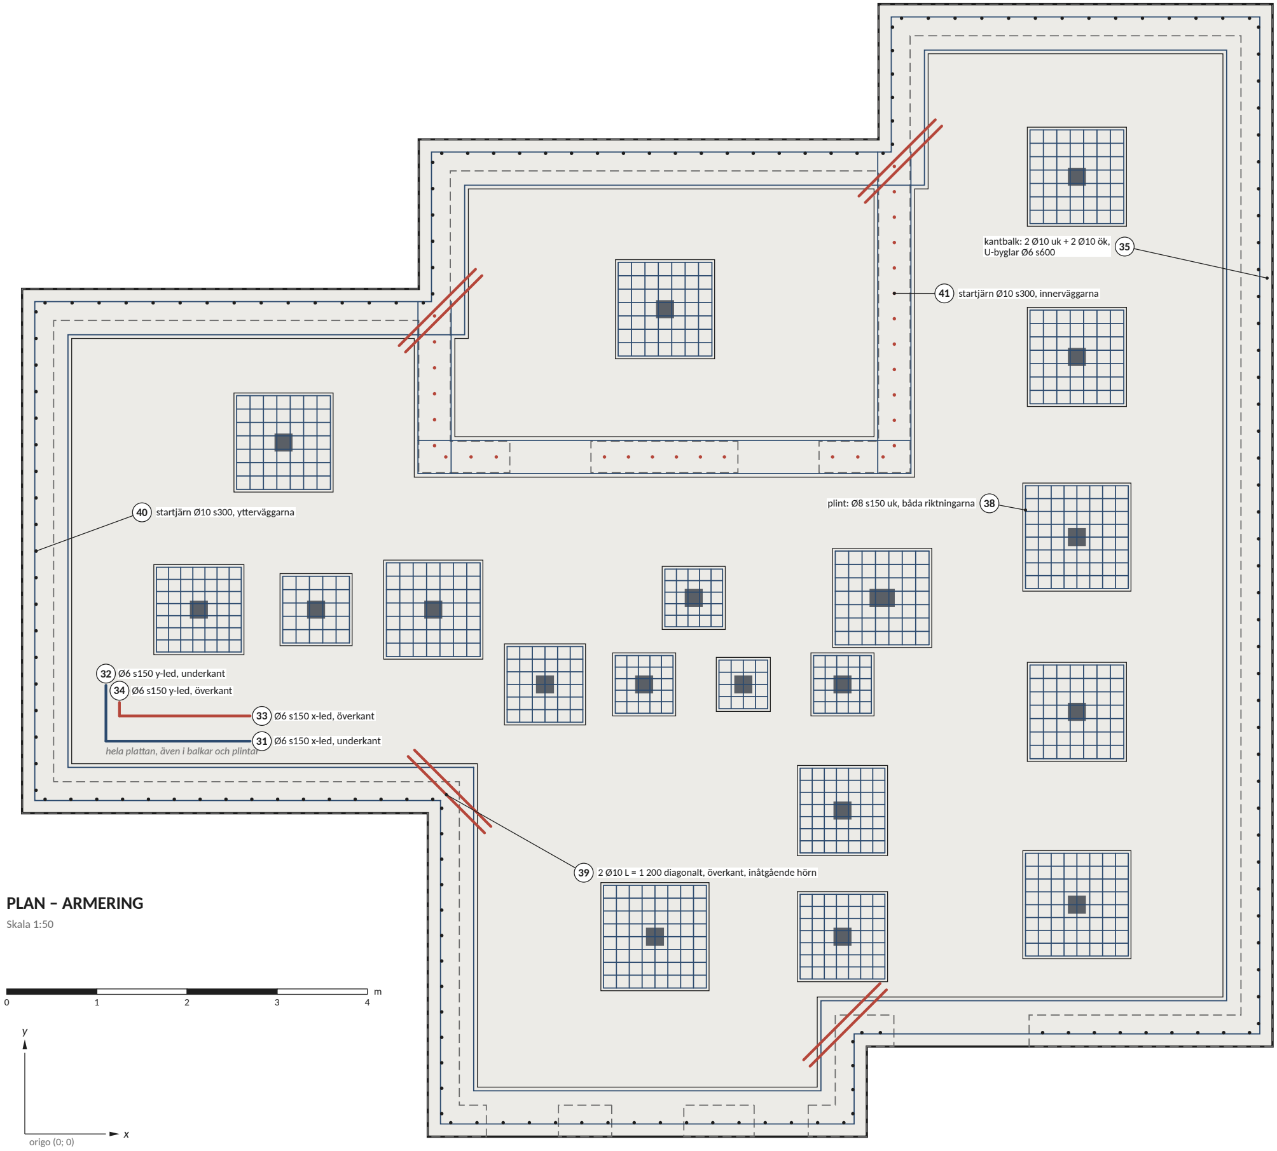
[picture p28: figure]
31 Ø6 s150 x-led, underkant; 32 Ø6 s150 y-led, underkant; 33 Ø6 s150 x-led, överkant; 34 Ø6 s150 y-led, överkant; hela plattan, även i balkar och plintar; 35 kantbalk: 2 Ø10 uk + 2 Ø10 ök, U-byglar Ø6 s600; plint: Ø8 s150 uk, båda riktningarna 38; 40 startjärn Ø10 s300, ytterväggarna; 41 startjärn Ø10 s300, innerväggarna; origo (0; 0); PLAN – ARMERING; Skala 1:50

39 2 Ø10 L = 1 200 diagonalt, överkant, inåtgående hörn

1. Armering B500B. Täckande skikt: 30 mm mot cellplasten (distanser) och 25 mm i överkant.
2. Nät Ø6 s150 i under- och överkant i hela plattan, också genom balkarna och plintarna. Golvvärmeslangarna fästs i underkantsnätet. Skarvlängd Ø6 400.
3. Kantbalkar och balkar under innerväggarna: 2 Ø10 i underkant på byglarna och 2 Ø10 i överkant under överkantsnätet, U-byglar Ø6 s600. Skarvlängd Ø10 650; i hörnen bockas järnen eller skarvas med vinkeljärn. Innerbalkarnas järn förs in i kantbalken och i den korsande balken.
4. Plintar: Ø8 s150 i underkant, båda riktningarna. Fotplåten gjuts in kant i kant med plintens överkant (R-05.5); näten läggs fritt från svetsbultarna.
5. Inåtgående hörn: 2 Ø10, L = 1 200, i överkant diagonalt, 150 och 250 mm från hörnet.
6. Startjärn Ø10 s300, 1 200 upp och 500 i balken: den lodräta delen och foten, 330, på byglarna.

Teckenförklaring
armering i underkant / balkjärn
armering i överkant (diagonaljärn) startjärn, ytterväggarna
startjärn, innerväggarna
31 | positionsnummer (stålförteckning R-04.3)
Rev Avser | Datum | Sign
A | Första utgåvan | 2026-10-16 | VO

PROJEKT

Fritidshus Trebodar, Resö, Tanum

FASTIGHET

### Resö 2:66, Tanums kommun · BYGG.2025.2278

INNEHÅLL

## Bottenplatta Armering

SKALA 1:50 | FORMAT A3 | DATUM 2026-10-16
UPPRÄTTAD Viktor Ogeman | GRANSKAD – | UNDERLAG K-06 rev A, K-05 rev A
STATUS KONSTRUKTION | | REVISION A

R-04.2

R-04.2 · 1:50 vid utskrift på A3 · Mått i mm om inte annat anges

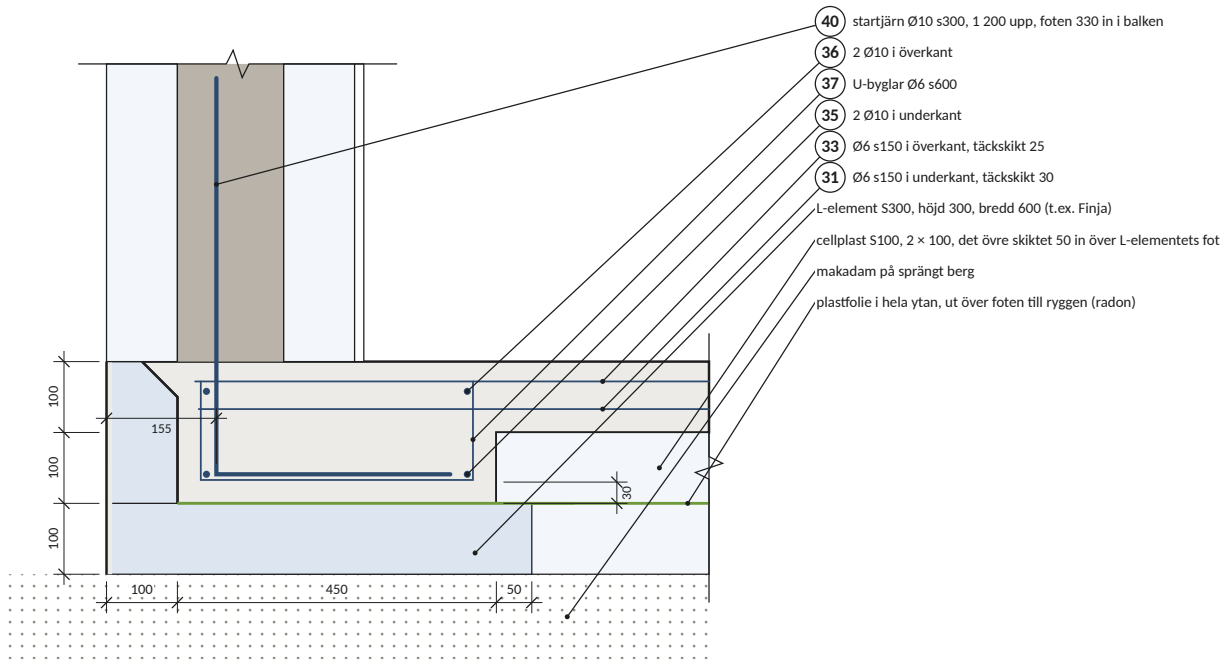
[picture p29: figure]
36 2 Ø10 i överkant; 37 U-byglar Ø6 s600; 35 2 Ø10 i underkant; 33 Ø6 s150 i överkant, täckskikt 25; 31 Ø6 s150 i underkant, täckskikt 30; makadam på sprängt berg

### 40 startjärn Ø10 s300, 1 200 upp, foten 330 in i balken

L-element S300, höjd 300, bredd 600 (t.ex. Finja)

cellplast S100, 2 × 100, det övre skiktet 50 in över L-elementets fot

plastfolie i hela ytan, ut över foten till ryggen (radon)

## SEKTION A–A Kantbalk i L-element (V14)

Skala 1:10

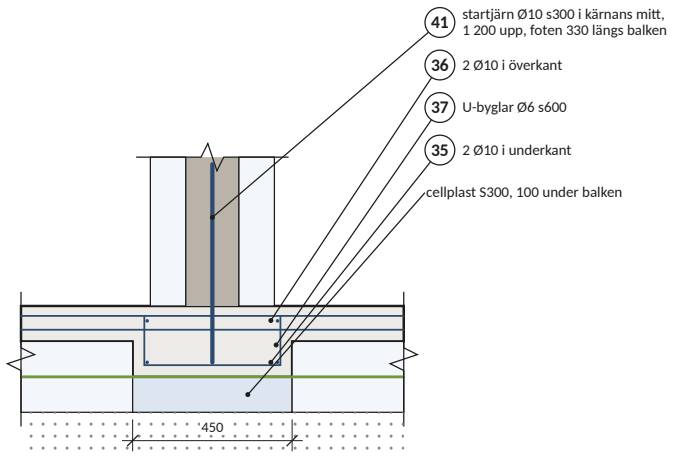
[picture p30: figure]
41 startjärn Ø10 s300 i kärnans mitt, 1 200 upp, foten 330 längs balken; 36 2 Ø10 i överkant; 37 U-byglar Ø6 s600; 35 2 Ø10 i underkant; cellplast S300, 100 under balken

## SEKTION B–B Balk under innervägg (V15)

Skala 1:20

1 200

rör VKR 80×80×4 (R-05.5)

fotplåt 200 × 200 × 15 S355, kant i kant med plintens överkant

4 svetsbultar Ø13, L = 75

### 38 plint: Ø8 s150 i underkant, båda riktningarna

cellplast S300, 100 under plinten

## SEKTION C–C Plint under rör (P18, 1 200)

Skala 1:20

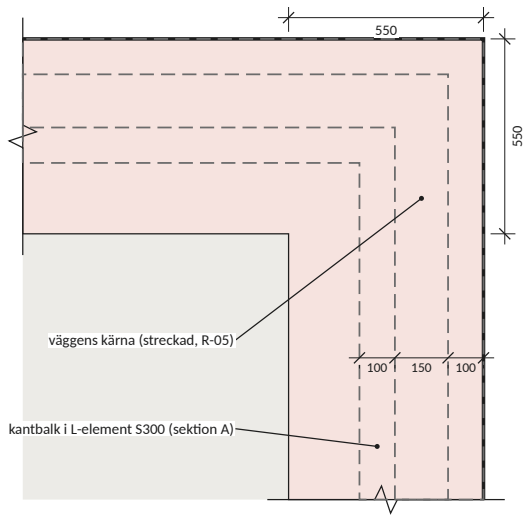
[picture p31: figure]
väggens kärna (streckad, R-05); kantbalk i L-element S300 (sektion A)

## DETALJ D Yttre hörn i plan (V1/V14)

Skala 1:20
Stålförteckning, B500B | Samma vid alla hörn: kantbalken ut till väggens ytterliv.
Pos Ø | Form | s | Anm
31 Ø6 | rak | s150 UK x-led, hela plattan
32 Ø6 | rak | s150 UK y-led, hela plattan
33 Ø6 | rak | s150 ÖK x-led, hela plattan
34 Ø6 | rak | s150 ÖK y-led, hela plattan
35 Ø10 rak | – | balkar, 2 i underkant
36 Ø10 rak | – | balkar, 2 i överkant
37 Ø6 | U 145+390+145 s600 byglar i balkarna
38 Ø8 | rak | s150 plintar, underkant
39 Ø10 rak 1 200 | – | inåtgående hörn, 2 per hörn, ÖK
40 Ø10 L 1 360+330 | s300 ytterväggarna, utsidan
41 Ø10 L 1 360+330 | s300 innerväggarna, mitt
1. Lägg L-elementen (fot S300) med ytterkanten i väggarnas ytterliv, S300 under innerbalkarna och plintarna och det undre S100-skiktet. Lägg plastfolien över hela ytan, med minst 200 mm tejpade överlapp och ut till L-elementens rygg. Lägg det övre S100-skiktet, som går 50 mm in över L-elementens fot och fästs med plastspik.
2. Armera och fixera fotplåtarna i läge och höjd. Gjut bottenplattan med balkar och plintar i en gjutning; fotplåtarna gjuts in kant i kant med plintarnas överkant. Rugga ytan under väggarna.
3. Kontrollera före gjutning: armeringens läge och täckskikt (distanser), plintarnas läge och storlek, fotplåtarnas läge och höjd (±5 mm), startjärnen.
4. Plattan behöver inga fogar; golvbeläggning och tätskikt ska tåla krympsprickor (K-06).
5. Plan R-04.1, armering R-04.2.

### Teckenförklaring

betong C30/37
cellplast S100
L-element (fot S300), S300 under balkar och plintar plastfolie i hela ytan, överlapp minst 200
väggens betongkärna (R-05)
armering

### Cellplast

| Utförande | Anm
S100 | 100 mm, övre skiktet | under plattan, 50 in över L-elementens fot
S100 | 100 mm, undre skiktet | plastfolie ovanpå, i hela ytan (radon)
S300 | 100 mm | under innerbalkarna och plintarna
L-element S300, höjd 300, 600 × 1200 (t.ex.
| Finja) | längs hela kanten, ytterkant i väggarnas ytterliv
Rev Avser | Datum | Sign
A | Första utgåvan | 2026-10-16 | VO

PROJEKT

### Fritidshus Trebodar, Resö, Tanum

FASTIGHET

### Resö 2:66, Tanums kommun · BYGG.2025.2278

INNEHÅLL

## Bottenplatta Sektioner, detaljer och förteckningar

SKALA 1:10, 1:20, 1:50 | FORMAT A3 | DATUM 2026-10-16
UPPRÄTTAD Viktor Ogeman | GRANSKAD – | UNDERLAG K-06 rev A, K-05 rev A
STATUS KONSTRUKTION | | REVISION A

R-04.3

R-04.3 · 1:10, 1:20, 1:50 vid utskrift på A3 · Mått i mm om inte annat anges
