vron/trebodar/ritningar/R-05 Bottenplatta.pdf

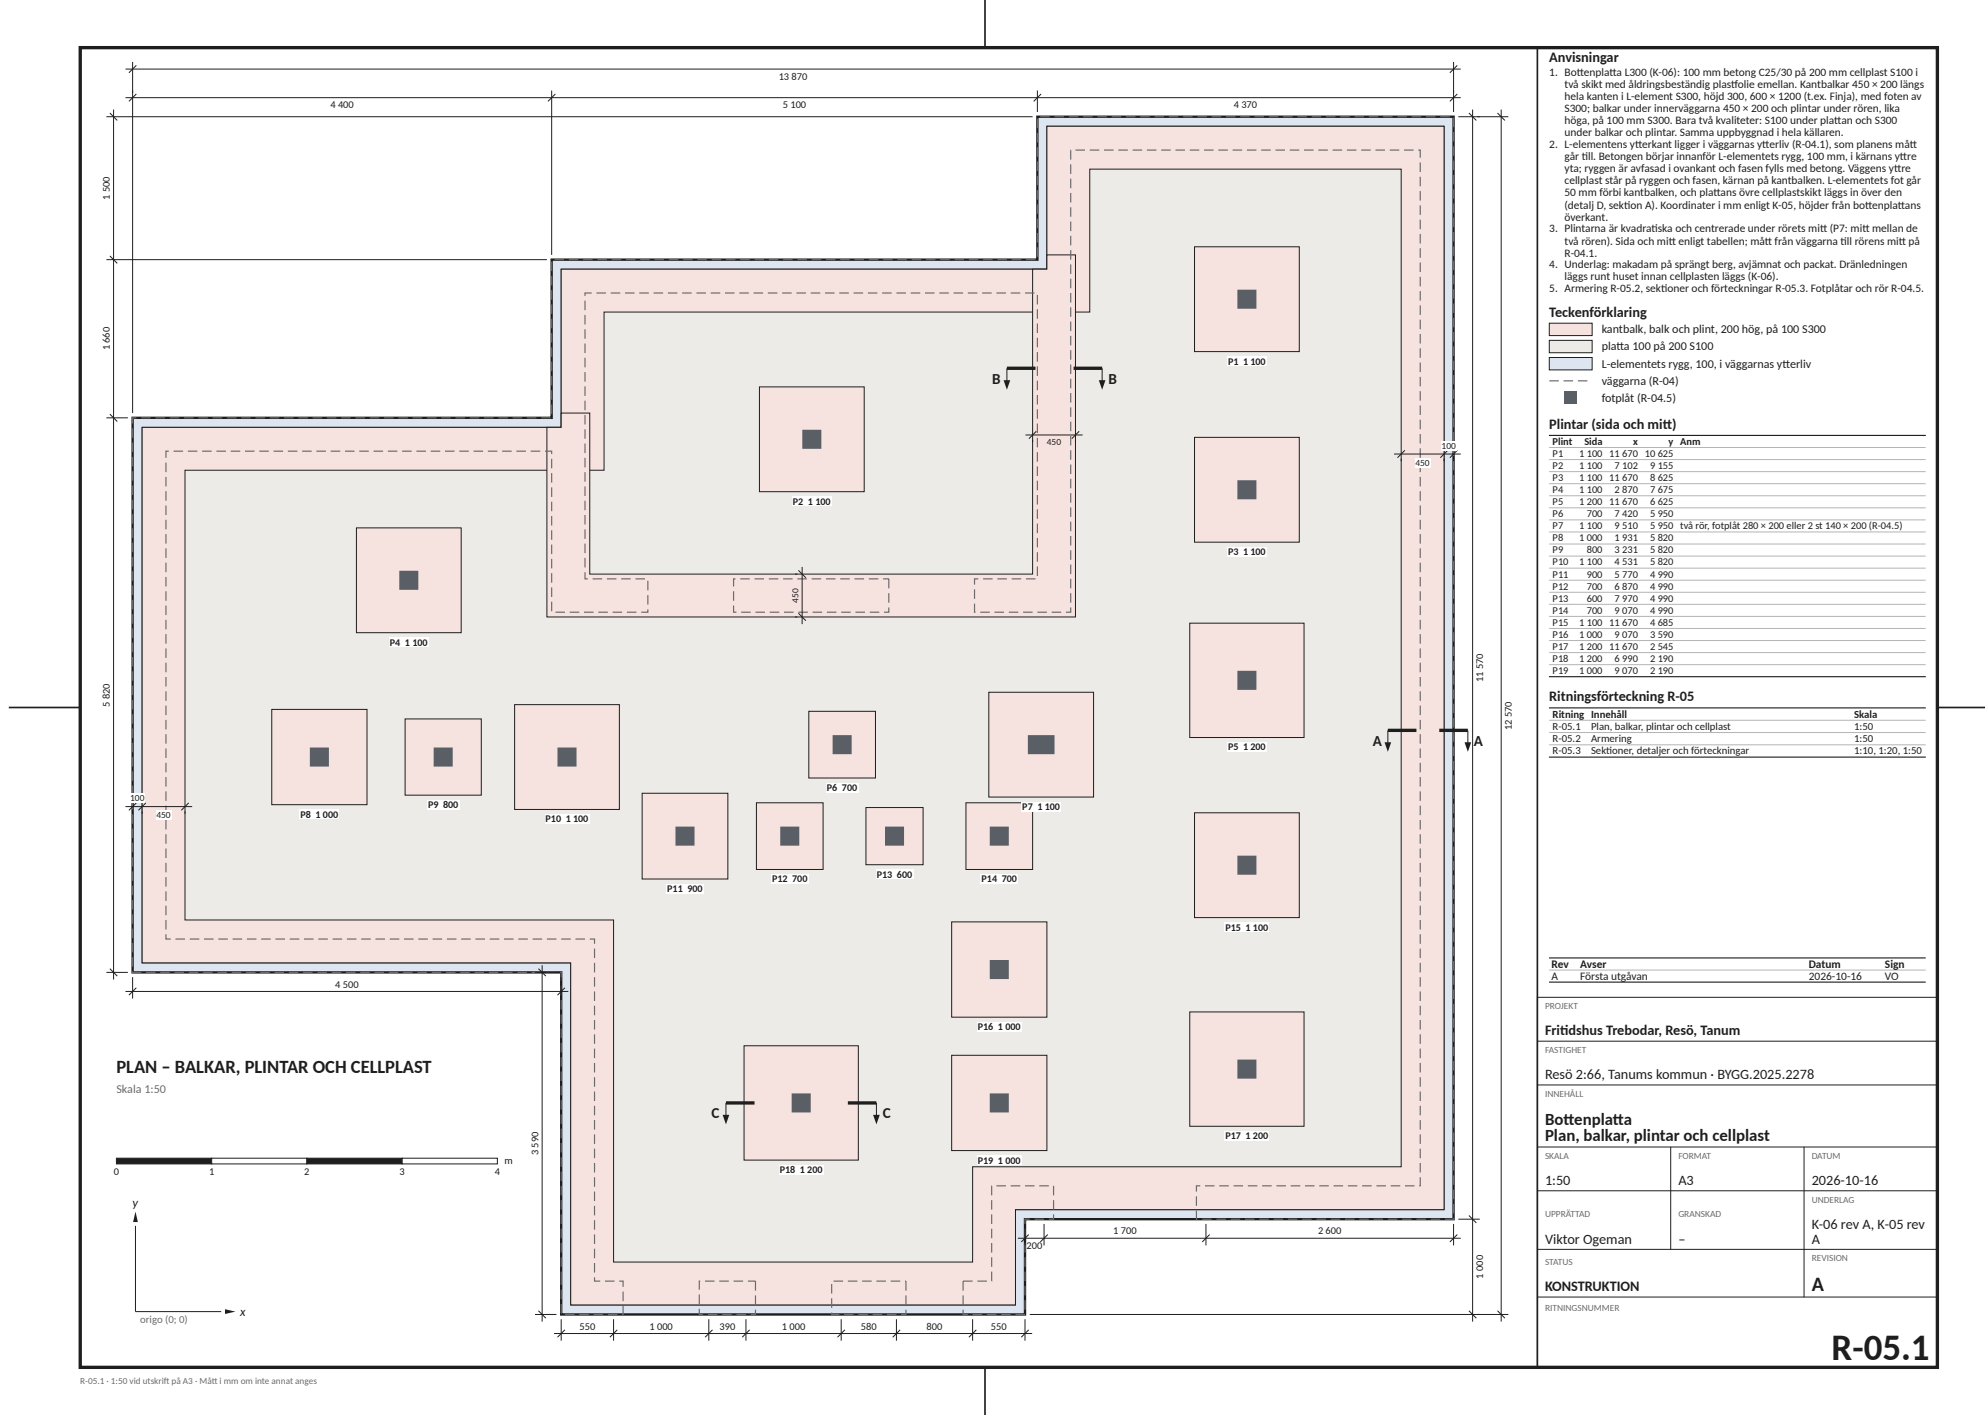
[picture p32: page 1]

Anvisningar
1. Bottenplatta L300 (K-06): 100 mm betong C25/30 på 200 mm cellplast S100 i
två skikt med åldringsbeständig plastfolie emellan. Kantbalkar 450 × 200 längs
hela kanten i L-element S300, höjd 300, 600 × 1200 (t.ex. Finja), med foten av
S300; balkar under innerväggarna 450 × 200 och plintar under rören, lika
höga, på 100 mm S300. Bara två kvaliteter: S100 under plattan och S300
under balkar och plintar. Samma uppbyggnad i hela källaren.
2. L-elementens ytterkant ligger i väggarnas ytterliv (R-04.1), som planens mått
går till. Betongen börjar innanför L-elementets rygg, 100 mm, i kärnans yttre
yta; ryggen är avfasad i ovankant och fasen fylls med betong. Väggens yttre
cellplast står på ryggen och fasen, kärnan på kantbalken. L-elementets fot går
50 mm förbi kantbalken, och plattans övre cellplastskikt läggs in över den
(detalj D, sektion A). Koordinater i mm enligt K-05, höjder från bottenplattans
överkant.
3. Plintarna är kvadratiska och centrerade under rörets mitt (P7: mitt mellan de
två rören). Sida och mitt enligt tabellen; mått från väggarna till rörens mitt på
4. Underlag: makadam på sprängt berg, avjämnat och packat. Dränledningen
läggs runt huset innan cellplasten läggs (K-06).
5. Armering R-05.2, sektioner och förteckningar R-05.3. Fotplåtar och rör R-04.5.
Teckenförklaring

kantbalk, balk och plint, 200 hög, på 100 S300
platta 100 på 200 S100
L-elementets rygg, 100, i väggarnas ytterliv
väggarna (R-04)
fotplåt (R-04.5)

Plintar (sida och mitt)

PROJEKT
Fritidshus Trebodar, Resö, Tanum

FASTIGHET
Resö 2:66, Tanums kommun · BYGG.2025.2278

PLAN – BALKAR, PLINTAR OCH CELLPLAST

INNEHÅLL
Bottenplatta
Plan, balkar, plintar och cellplast

SKALA 1:50 | FORMAT A3 | DATUM 2026-10-16

UPPRÄTTAD Viktor Ogeman | GRANSKAD – | UNDERLAG K-06 rev A, K-05 rev A

STATUS KONSTRUKTION | | REVISION A

R-05.1 · 1:50 vid utskrift på A3 · Mått i mm om inte annat anges

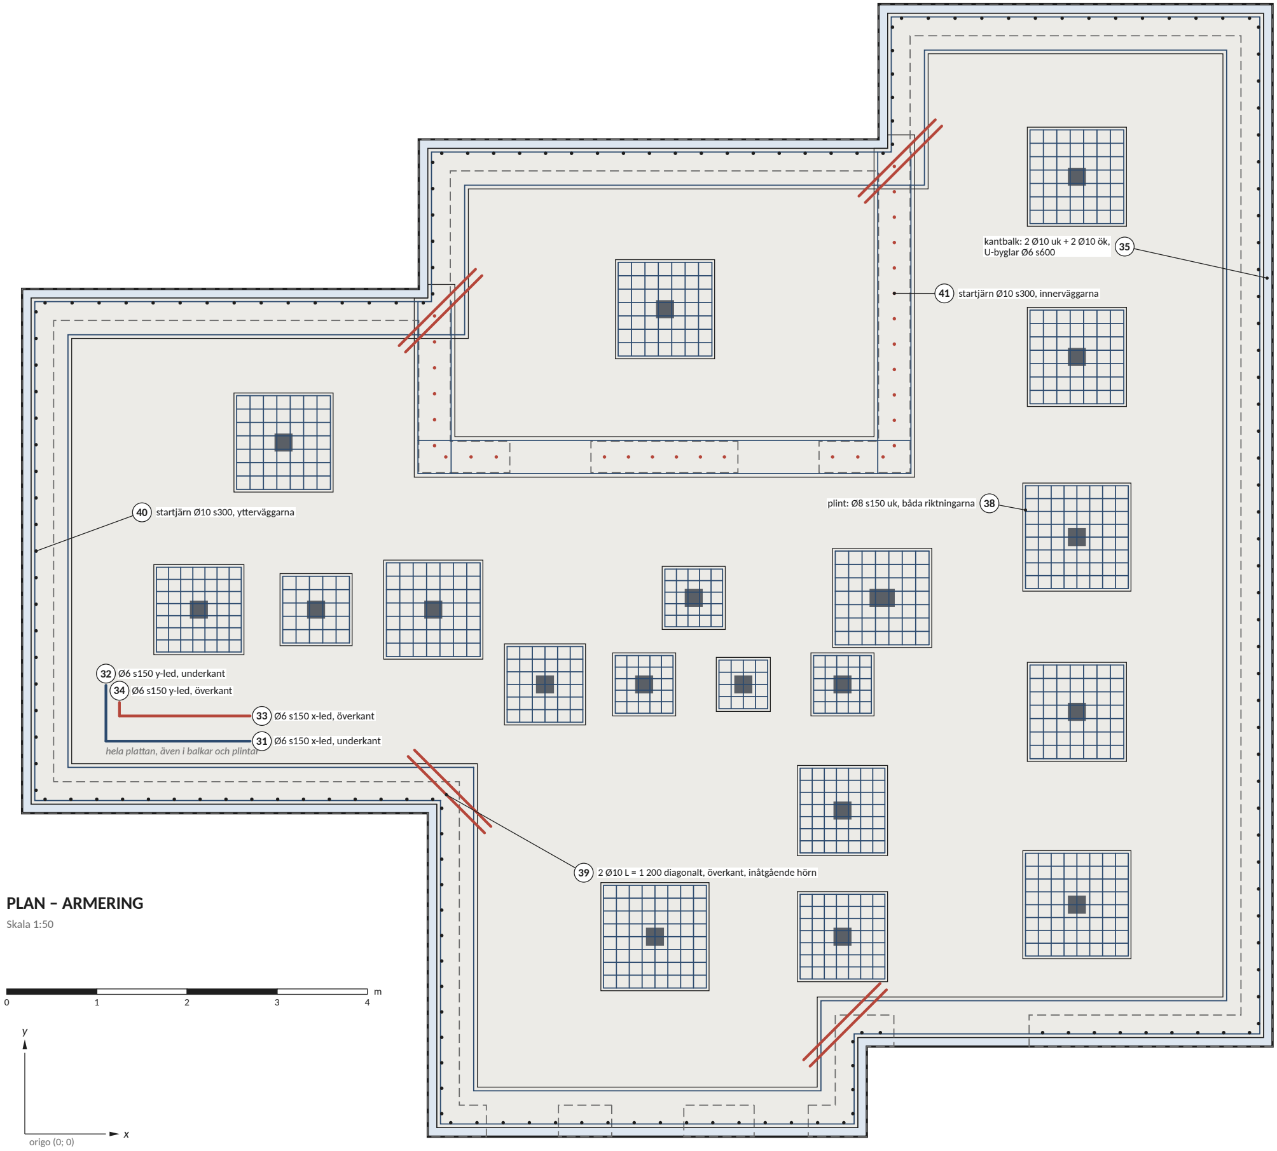
[picture p33: figure]
31 Ø6 s150 x-led, underkant; 32 Ø6 s150 y-led, underkant; 33 Ø6 s150 x-led, överkant; 34 Ø6 s150 y-led, överkant; hela plattan, även i balkar och plintar; 35 kantbalk: 2 Ø10 uk + 2 Ø10 ök, U-byglar Ø6 s600; plint: Ø8 s150 uk, båda riktningarna 38; 40 startjärn Ø10 s300, ytterväggarna; 41 startjärn Ø10 s300, innerväggarna; origo (0; 0); PLAN – ARMERING; Skala 1:50

39 2 Ø10 L = 1 200 diagonalt, överkant, inåtgående hörn

1. Betong C25/30, armering B500B. Täckande skikt: 30 mm mot cellplasten (distanser) och 25 mm i överkant.
2. Nät Ø6 s150 i under- och överkant i hela plattan (31–34), också genom balkarna och plintarna. Golvvärmeslangarna fästs i underkantsnätet. Skarvlängd Ø6 400.
3. Kantbalkar och balkar under innerväggarna: 2 Ø10 i underkant (35) på byglarna och 2 Ø10 i överkant (36) under överkantsnätet, U-byglar Ø6 s600 (37). Skarvlängd Ø10 650; i hörnen bockas järnen eller skarvas med vinkeljärn. Innerbalkarnas järn förs in i kantbalken och i den korsande balken.
4. Plintar: Ø8 s150 i underkant, båda riktningarna (38). Fotplåten gjuts in kant i kant med plintens överkant (R-04.5); näten läggs fritt från svetsbultarna.
5. Inåtgående hörn: 2 Ø10, L = 1 200, i överkant diagonalt, 150 och 250 mm från hörnet (39).
6. Startjärn Ø10 s300, 1 200 upp och 500 i balken: den lodräta delen och foten, 330, på byglarna. Ytterväggarna på utsidan (40, svarta), med foten vinkelrätt in i kantbalken (Sundolitt), också under bröstningarna vid F1–F3; innerväggarna i kärnans mitt (41, röda), med foten längs balken. Väggarnas armering: R-04.
7. Ytan under väggarna ruggas före väggarnas gjutning (K-06).

Teckenförklaring
armering i underkant / balkjärn
armering i överkant (diagonaljärn) startjärn, ytterväggarna
startjärn, innerväggarna
31 | positionsnummer (stålförteckning R-05.3)
Rev Avser | Datum | Sign
A | Första utgåvan | 2026-10-16 | VO

PROJEKT

Fritidshus Trebodar, Resö, Tanum

FASTIGHET

### Resö 2:66, Tanums kommun · BYGG.2025.2278

INNEHÅLL

## Bottenplatta Armering

SKALA 1:50 | FORMAT A3 | DATUM 2026-10-16
UPPRÄTTAD Viktor Ogeman | GRANSKAD – | UNDERLAG K-06 rev A, K-05 rev A
STATUS KONSTRUKTION | | REVISION A

R-05.2

R-05.2 · 1:50 vid utskrift på A3 · Mått i mm om inte annat anges

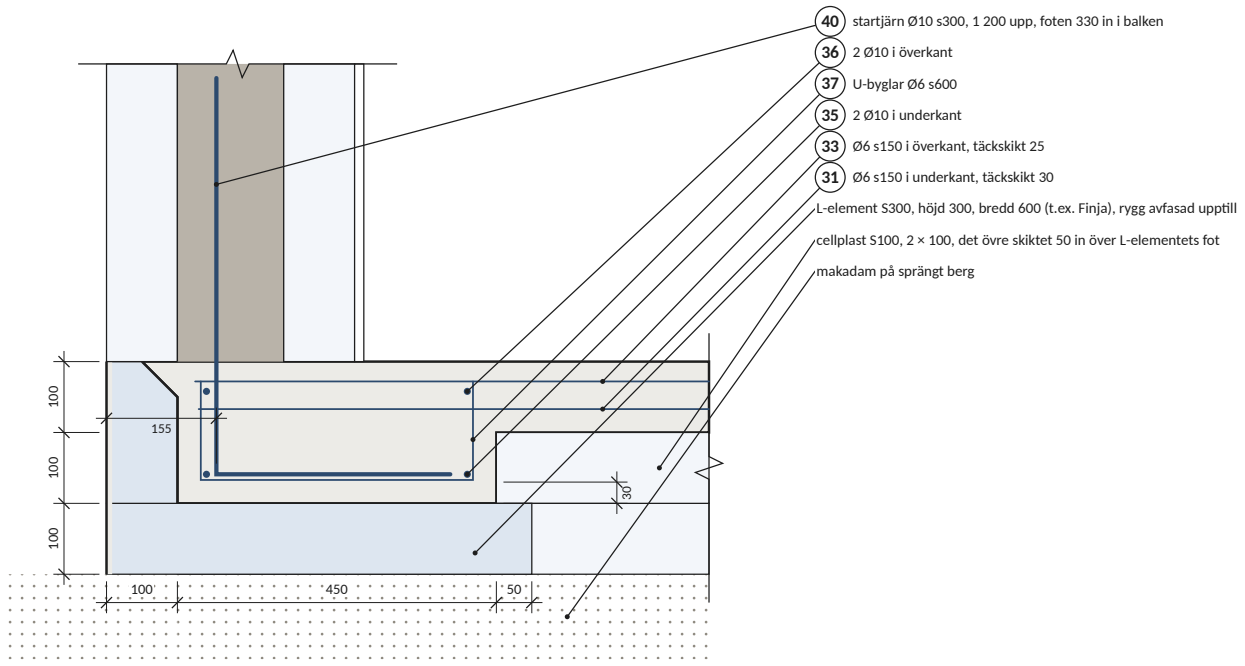
[picture p34: figure]
36 2 Ø10 i överkant; 37 U-byglar Ø6 s600; 35 2 Ø10 i underkant; 33 Ø6 s150 i överkant, täckskikt 25; 31 Ø6 s150 i underkant, täckskikt 30; makadam på sprängt berg

### 40 startjärn Ø10 s300, 1 200 upp, foten 330 in i balken

L-element S300, höjd 300, bredd 600 (t.ex. Finja), rygg avfasad upptill

cellplast S100, 2 × 100, det övre skiktet 50 in över L-elementets fot

## SEKTION A–A Kantbalk i L-element (V14)

Skala 1:10

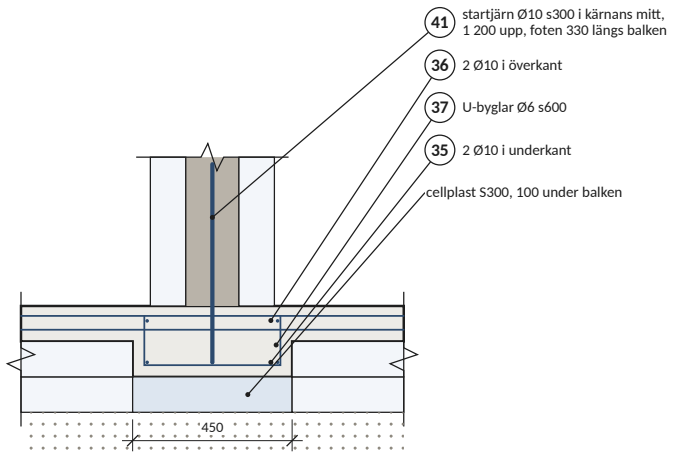
[picture p35: figure]
41 startjärn Ø10 s300 i kärnans mitt, 1 200 upp, foten 330 längs balken; 36 2 Ø10 i överkant; 37 U-byglar Ø6 s600; 35 2 Ø10 i underkant; cellplast S300, 100 under balken

## SEKTION B–B Balk under innervägg (V15)

Skala 1:20

1 200

rör VKR 80×80×4 (R-04.5)

fotplåt 200 × 200 × 15 S355, kant i kant med plintens överkant

4 svetsbultar Ø13, L = 75

### 38 plint: Ø8 s150 i underkant, båda riktningarna

cellplast S300, 100 under plinten

## SEKTION C–C Plint under rör (P18, 1 200)

Skala 1:20

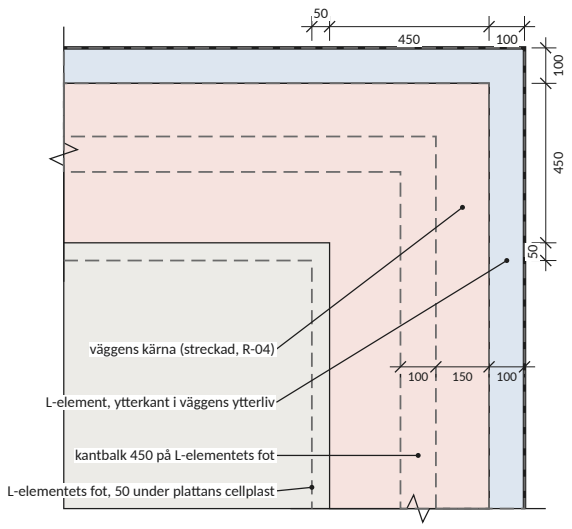
[picture p36: figure]
väggens kärna (streckad, R-04); L-element, ytterkant i väggens ytterliv; kantbalk 450 på L-elementets fot

L-elementets fot, 50 under plattans cellplast

## DETALJ D Yttre hörn i plan (V1/V14)

Skala 1:20
Stålförteckning, B500B | Samma vid alla hörn: L-elementets ytterkant i väggens ytterliv.
Pos Ø | Form | s | Antal L (mm) Total (m) Vikt (kg) Anm
31 Ø6 | rak | s150 | 82 | var. | 848 | 188 UK x-led, hela plattan
32 Ø6 | rak | s150 | 91 | var. | 840 | 186 UK y-led, hela plattan
33 Ø6 | rak | s150 | 82 | var. | 848 | 188 ÖK x-led, hela plattan
34 Ø6 | rak | s150 | 91 | var. | 840 | 186 ÖK y-led, hela plattan
35 Ø10 rak | – | 2 per balk | var. | 129 | 80 balkar, underkant
36 Ø10 rak | – | 2 per balk | var. | 129 | 80 balkar, överkant
37 Ø6 | U 145+390+145 s600 | 102 | 700 | 71 | 16 byglar i balkarna
38 Ø8 | rak | s150 | 286 | var. | 272 | 108 plintar, underkant
39 Ø10 rak | – | 8 | 1 200 | 10 | 6 inåtgående hörn, ÖK
40 Ø10 L 1 360+330 | s300 | 176 | 1 690 | 297 | 184 ytterväggarna, utsidan
41 Ø10 L 1 360+330 | s300 | 30 | 1 690 | 51 | 31 innerväggarna, mitt
| | | | | Summa | 1 253 Ø6: 765 + Ø8: 108 + Ø10: 380
1. Utförande (K-06): spräng och avjämna berget och lägg makadam. Lägg dränledningen. Lägg L-elementen (fot S300) med ytterkanten i väggarnas ytterliv, S300 under innerbalkarna och plintarna och S100 under plattan i två skikt med plastfolie emellan; det övre skiktet går 50 mm in över L-elementens fot och fästs med plastspik. Skär ur cellplasten för balkar och plintar.
2. Armera, lägg golvvärmeslangarna och fixera fotplåtarna i läge och höjd. Gjut bottenplattan med balkar och plintar i en gjutning; fotplåtarna gjuts in kant i kant med plintarnas överkant. Rugga ytan under väggarna.
3. Kontrollera före gjutning: armeringens läge och täckskikt (distanser), plintarnas läge och storlek, fotplåtarnas läge och höjd (±5 mm), startjärnen.
4. Plattan behöver inga fogar; golvbeläggning och tätskikt ska tåla krympsprickor (K-06).
5. Plan R-05.1, armering R-05.2.

### Teckenförklaring

betong C25/30
cellplast S100
L-element (fot S300), S300 under balkar och plintar väggens betongkärna (R-04)
armering

### Cellplast

| Utförande | Mängd Anm
S100 | 100 mm, övre skiktet | 81,0 m² under plattan, 50 in över
| | L-elementens fot
S100 | 100 mm, undre skiktet | 78,6 m² plastfolie mellan skikten
S300 | 100 mm | 23,3 m² under innerbalkarna och
| | plintarna
L-element S300, höjd 300, 600 × 1200
| (t.ex. Finja) | 52,9 m längs hela kanten, ytterkant i väggarnas ytterliv
Rev Avser | Datum | Sign
A | Första utgåvan | 2026-10-16 | VO

PROJEKT

### Fritidshus Trebodar, Resö, Tanum

FASTIGHET

### Resö 2:66, Tanums kommun · BYGG.2025.2278

INNEHÅLL

## Bottenplatta Sektioner, detaljer och förteckningar

SKALA 1:10, 1:20, 1:50 | FORMAT A3 | DATUM 2026-10-16
UPPRÄTTAD Viktor Ogeman | GRANSKAD – | UNDERLAG K-06 rev A, K-05 rev A
STATUS KONSTRUKTION | | REVISION A

R-05.3

R-05.3 · 1:10, 1:20, 1:50 vid utskrift på A3 · Mått i mm om inte annat anges
