vron/trebodar/verktyg/modellering/README.md

# Modellering – ramverk för den kodgenererade modellen

Ramverket bygger husets 3D-modell ur geometriskripten i [`modeller/trebodar`](../../modeller/trebodar/), exporterar
den och kontrollerar den. Geometriskripten beskriver bara geometri som data (recept: rätblock, prismor med hål,
booleska operationer, plan som kapar, placeringar) och material; de vet inget om exportformaten.

## Installation

```
uv venv --python 3.12 .venv
uv pip install --python .venv/bin/python -r requirements.txt
```

Kör sedan allt via `./mod` (använder `.venv`). Rendering kräver Blender (`/Applications/Blender.app`).

## Kommandon

| Kommando | Gör |
|---|---|
| `./mod trad [--djup N] [--del VÄG]` | Modellträdet med antal delar |
| `./mod bygg [--del VÄG] [--format step,glb,lista,index] [--delade]` | Bygger och exporterar till `modeller/trebodar/ut/`; med STEP också modellanalysens cache. `--format analys`: bara modellanalysens cache, utan STEP-fil (några sekunder; `./ma` kör det själv när modellens källor har ändrats) |
| `./mod kontroll [--del VÄG]` | Krockar, kontakter, glipor och delar utan kontakt, installationernas vägar (felen, som `./mod vagar`), ytskiktens språng och springor (som `./mod ytor`) och inköpslistans koder (som `./mod inkop`) |
| `./mod inkop kontroll\|utdrag [--ut FIL]` | Inköpslistans specialprodukter ([`inkop.py`](modellering/inkop.py)): delarna och montagen med `produkt=` mot listan i modellens `kontrollregler.INKOPSLISTA` (`beräkningar/IN-01/indata.toml`) och tvärtom; `utdrag` skriver instanserna (id och typ per produkt) till `ut/inkop.json`, som IN-01 läser |
| `./mod vagar [--trad VÄG]` | Installationernas vägar ([`vagar.py`](modellering/vagar.py), reglerna i modellens `kontrollregler`): rören, kablarna och kanalerna ska gå dolda i skikten, ingjutna eller i marken, inte fritt i rummens luft eller genom fönstrens och takfönstrens öppningar (fria mått längs axlarna och diagonalerna, strålar mot husets triangelnät med vtk), och inte in i fickdörrarnas fickor; i källaren får de gå utanpå väggarna och taket (anmärkning). Under en sekund |
| `./mod ytor` | Ytskiktens språng och springor ([`ytskikt.py`](modellering/ytskikt.py), reglerna `YTSKIKT` och `YTSKIKT_UTOM` i modellens `kontrollregler`): där två synliga skivor av gips, kakel eller kaminens målade front möts i samma plan ska ytan vara jämn, utan språng (0,3–40 mm) eller öppna springor (0,5–30 mm), och i inåthörnen mellan två väggars skikt ingen springa (#107). En yta är synlig där ingen annan del ligger an mot den och punkten framför den är rummets luft, inte ett hålrum (fria mått längs axlarna, som `./mod vagar`). Omkring två sekunder |
| `./mod avtryck spara\|jamfor [--del VÄG]` | Modellens fingeravtryck (varje dels låda, volym och tyngdpunkt): spara före en omstrukturering och jämför efter, så syns att geometrin är oförändrad (flyttade delar paras på namn, delar med samma geometri och nytt delnamn redovisas för sig; `ut/<modell>-avtryck.json`) |
| `./mod rendera [VY …] [--serie ute\|inne\|alla] [--kvalitet skiss\|utkast\|normal\|slutlig] [--ljus M D HH:MM VÄDER] [--ljusserie B] [--tand GRUPP[=NIVÅ] …] [--ev EV] [--bredd PX] [--ut MAPP] [--blend]` | Bilder med Blender (Cycles), vyerna i `modeller/trebodar/vyer.py` (VY: namn eller början av namn, t.ex. `I05`; serien `ute` är `VYER`, `inne` inomhusbilderna I01–I30). `--tand` tänder elinstallationens tändgrupper (nivå 0–1 dimrar). Kvaliteterna: skiss 640 px, utkast 1 280, normal 1 920 och slutlig 2 048 (2K). Dagsljuset är vyns om inte `--ljus` eller `--ljusserie` (`LJUSSERIER` i vyer.py: tid, väder och tändgrupper för alla vyerna utom seriens `utan`) anges; exponeringen räknas fram ur en förhandsbild om inte `--ev` anges. `--blend` sparar scenen. Bredvid varje bild skrivs vyns data (`<namn>.json`: kamera, mål, objektiv, ljus, kvalitet, tid och modellens version), som `mod publicera` läser |
| `./mod ljus MÅNAD DAG [HH:MM] [VÄDER] [--steg MIN] [--diagram PNG]` | Dagsljuset på platsen (`modellering/dagsljus.py`): solens riktning och höjd, solens och himlens färg (CIE-färg och färgtemperatur) och belysning för en tidpunkt eller hela dagen; väder `sol`, `lätt mulet`, `mulet` (eller `sunny`, `slightlyovercast`, `overcast`); `--diagram` ritar solens bana under året med fasadernas riktningar |
| `./mod omgivning [--hamta]` | Omgivningen för renderingen ur öppna geodata (`modellering/geodata.py`): höjdmodell och marktäcke (berg, skog, vatten, åker, våtmark, vägar, trädgård, hav, byggnader) inom 2,3 km, runt tomten Lantmäteriets höjder och de egna inmätningarna ur `lokalt/terrang/` (`modellering/terrang.py`), i modellens koordinater via fasadens hörn i SWEREF 99 12 00 (AR-02); `--hamta` laddar ner det som saknas (OpenStreetMap via Overpass, Terrarium-höjdrutor och Poly Havens texturer och modeller till `lokalt/polyhaven/`, `modellering/polyhaven.py`). Allt i `lokalt/` (versionshanteras inte) |
| `./mod materialprov MATERIAL [--param K=V …] [--nara] [--bredd PX] [--sampel N]` | Ett material ur modellen på tolv skåpluckor, en bänkskiva och brädor (Blender), för att bedöma det och att bitarna inte blir lika; `--nara` en lucka på nära håll, `--param` ändrar parametrar (t.ex. `yta=lack`) |
| `./mod ljusplan [YTA …] [--tand GRUPP[=NIVÅ] …] [--ljus M D HH:MM VÄDER] [--direkt] [--kvalitet …] [--nummer U-04] [--projekt INDATA]` | Belysningsstyrkan [lux] på vågräta mätytor (`MATYTOR` i `modeller/trebodar/hus/installationer/el/matytor.py`: golv, bordshöjd, köksbänk …) med tändgrupperna (standard alla, och vyernas taklampor i `LAMPOR`) och dagsljuset (standard mörkt): ljusplaner (`<nummer>.n`, standard U-04.n, alla i `<nummer>_ljusplaner.pdf`; `--projekt` ger bladen revision och datum ur en `indata.toml`, som för utredningen U-04: `./bygg U-04`) med belysningsstyrkan i färg, isolinjer, armaturerna och medel-, minsta och största värde och jämnhet per rum (utan 0,5 m kantzon och utan inredningen, källartrappan och pelarna på mätytan) och delområde, och rutnätet (`.npy`) och statistiken (`.json`) till `ut/ljusplan/`; `--direkt` bara det direkta ljuset |
| `./mod barverk [--ut FIL]` | Bärverket ur modellen för K-04 (`modeller/trebodar/hus/stomme/barverk.py`): stommens delar (allt under Hus/Stomme) med grupp, element, typ, material, delens system och omslutande låda (prismornas kontur), takfallen och väggarna, till `ut/barverk.json`; K-04 bygger sin balkmodell ur det |
| `./mod el kontroll\|lista\|ritning\|hamta [--ut MAPP]` | Elinstallationen (`modeller/trebodar/hus/installationer/el`, se dess README): kontroll (referenser, styrning, armaturernas vinkel, djup och läkt, rörens böjar), punkt-, tändgrupps- och rörlistor, elritningarna (E-01: elplanen för plan 1 och rören i mellanbjälklaget, ur STEP-filens snitt) till `ut/el/E-01 Elinstallation.pdf`, och tillverkarnas fotometrifiler som saknas (till `lokalt/el/`) |
| `./mod ventilation kontroll\|lista\|ritning [--ut MAPP]` | Ventilationen (`modeller/trebodar/hus/installationer/ventilation`, se dess README): kontroll (kedjorna, flödena, genomföringarna och krockarna mot husets delar, med modellens krockkontroll för ventilationens par), listor och ritningarna (VL-01: plan 1, källaren och sektionen genom källarrummets kanal, ur STEP-filens snitt) till `ut/ventilation/` |
| `./mod brandlarm kontroll\|lista\|ritning [--ut MAPP]` | Brandlarmet (`modeller/trebodar/hus/installationer/brandlarm`, se dess README): kontroll (sammankopplingen, varnarnas plats, genomföringarna och krockarna mot husets delar och de andra installationerna), listan och ritningen (E-02: plan 1 och källaren med varnarna och kablarnas dragning, ur STEP-filens snitt) till `ut/brandlarm/` |
| `./mod avlopp kontroll\|lista\|ritning [--ut MAPP]` | Avloppet (`modeller/trebodar/hus/installationer/avlopp`, se dess README): kontroll (fallet, att ledningarna går under mellanbjälklaget och bottenplattans cellplast och ansluter ovanför vattengången, den fria höjden, hålen i bjälklaget nära rören, luftningens väg genom väggen och taket, och krockarna mot husets delar och de andra installationerna), listan och ritningen (VS-02: källarens plan med ledningarna och vattengångens höjder i RH 2000, och stammen och luftningen i en sektion, ur STEP-filens snitt) till `ut/avlopp/` |
| `./mod dranering kontroll\|lista\|ritning [--ut MAPP]` | Dräneringen och dagvattnet (`modeller/trebodar/hus/installationer/dranering`, se dess README): kontroll (fallet, höjderna vid brunnen, brunnarnas djup och krockarna mot husets delar och de andra installationerna, utom marken; ledningarna i berget redovisas), listan med höjderna och ritningen (VS-03: planen med ledningarna, brunnarna och vattengångens höjder i RH 2000, och brunnen B1, ur STEP-filens snitt) till `ut/dranering/` |
| `./mod stomme ritning [--ut MAPP]` | Konstruktionsritningen av trästommen R-02 (`modellering/stomritning.py`, #91) ur bärverket (`./mod barverk`, samma utdrag som K-04): översikt i 3D med elementen märkta med sina blad, och ett blad per element i byggordning (väggarna, stolparna, takstolarna, takfallen, nock- och dalbalkarna) med delarnas ID, kedjemått och kapplista; standard `ritningar/` (`./bygg R-02`) |
| `./mod gjutning ritning [--ut MAPP]` | Arbetsritningarna för gjutningen av plattorna (`modellering/gjutning.py`, #86): AR-03 mellanbjälklaget (el, tappvatten, avlopp, golvvärme, hål och ingjutningsgods, med detaljen över gruppcentralen) och AR-04 bottenplattan (golvvärme, avlopp, hål och ingjutningsgods), ett blad per tema ur installationernas egna data och STEP-filens snitt, med punkterna numrerade och deras lägen i en tabell; standard `ritningar/` (`./bygg gjutning`) |
| `./mod kameraplan [--ut PDF] [--webb MAPP]` | Ritningen över inomhusbildernas kameror (I-01: plan 1 i 1:75 och källaren i 1:150) ur STEP-filens snitt (kräver `./mod bygg` och `verktyg/modellanalys`); standard `renderingar/kameraplan.pdf`. Skriver också webbplatsens sida med renderingarna på planerna (`docs/renderingar/`: `index.html` och `plan.json`) |
| `./mod publicera [VY …] [--lokalt] [--fran MAPP …]` | De renderade bilderna (`renderingar/inne/` och `ute/`, med sidodata från `mod rendera`) som JPEG i 480, 960, 1 440 och 2 048 px till `docs/renderingar/bilder/` och releasen `bilder` på GitHub, med förteckningen `renderingar.json`, varefter webbplatsen byggs om (`gh workflow run`). `--lokalt`: bara till `docs/` |
| `./mod webb` | Webbvisaren (three.js) med modellen i `docs/modell/` för GitHub Pages |
| `./mod typ` | Typkontroll (mypy) av ramverket och modellen, och modellens struktur: inga importcykler, privata namn från andra moduler, importer i funktioner eller brott mot modellens lagerordning (`modellering/struktur.py`, `LAGER` i `trebodar/kontrollregler.py`) |
| `./mod onshape [--del VÄG] [--dokument NAMN] [--mapp NAMN] [--publik]` | Bygger STEP och laddar upp den till ett nytt dokument i en mapp i Onshape (standard `TrebodarAuto`) via Onshapes API, väntar på importen och redovisar flikar och delar |

`--del` väljer ett delträd med sökvägen under roten, t.ex. `--del "Hus/Stomme/Stomme prefab"`, som exporteras som en
egen modell (t.ex. för beställning). Utdata:

| Fil i `modeller/trebodar/ut/` | Innehåll |
|---|---|
| `trebodar.step` | STEP AP242 med sammanställningar, namn och färger (Onshape, `./ma` i modellanalys) |
| `trebodar.analys.json` | Pekar ut modellanalysens cache för det senaste bygget (`verktyg/modellanalys/.cache/`) |
| `trebodar.glb` | glTF med delade nät, material och metadata (Blender, webben) |
| `trebodar-materiallista.md`, `.csv` | Materiallista per del och per material: antal, kapmått, volym, massa |
| `trebodar-index.json` | Alla delar med sökväg, material, omslutande låda, volym, massa och tyngdpunkt |
| `trebodar-kontroll.md` | Kontrollens rapport |
| `bilder/*.png` | Renderingarna (`mod rendera`, `mod materialprov`) |
| `trebodar-rendering.glb`, `scen.json` | Modellen och scenens beskrivning (vyer, dagsljus, material, portaler, omgivning) till Blender |

## Hur det fungerar

- **Recept** (`form.py`): oföränderliga, hashbara värden: rätblock, prismor med hål, cylindrar, polyedrar (fria former
  av plana ytor, t.ex. kluven sten), rotationskroppar (`varv`: en profil i (r, z) av raka streck och mjuka kurvor,
  vriden ett varv, t.ex. lampskärmar och glober), booleska operationer, plan som kapar, speglingar. Likadana delar får samma recept
  och blir samma nät i GLB, samma rad i materiallistan och (med `--delade`) samma produkt i STEP.
- **Modellträd** (`modell.py`): `Del` (recept och material) och `Montage` (placerade instanser av delar och
  montage, i montagets eget koordinatsystem). Ett `Material` har två utseenden: CAD-färgen (`cad`) för STEP, GLB
  och webbvisaren och det verkliga utseendet (färg, grovhet, metall och ett procedurellt material) för renderingen. `Placering` (`placering.py`) är en stel transform, exakt för vridningar
  med multiplar av 90°.
- **Kärna** (`karna.py`): OCCT via OCP. Varje unikt recept byggs en gång; B-rep, egenskaper och triangelnät sparas i
  `.cache/former.sqlite`. Saknade recept byggs i parallella processer (alla kärnor). Hela huset byggs från tom cache
  på några sekunder, därefter på bråkdelen av en sekund.
- **Minne** (`minne.py`): dyra, rena beräkningar i modellens skript sparas under en kontrollsumma över sina indata
  och koden som räknar (`minne.sparad`, `.cache/minne/`), så att de inte räknas om när ingenting de beror på har
  ändrats. Elrörens vägval i bjälklagen (`hus/installationer/plattan.py`: synlighetsgrafen och `vag2`) tar en dryg
  halv minut och ligger där: modellen laddas på några sekunder när plattornas indata är oförändrade.
- **Export** (`export/`): STEP AP242 (OCCT XCAF; varje placerad del en egen produkt med instansens namn, eller
  delade produkter med `--delade`; utan 2D-kurvor på ytorna, som läsarna räknar fram), GLB (eget skrivprogram: hierarki, delade nät, material i CAD-färgerna med det verkliga
  utseendet i `extras`, UV i delens system så att träets fibrer följer delens x, metadata i `extras`), materiallista och index.
  STEP-filen skrivs i ett steg (en temporär fil som byter namn), så att andra processer aldrig läser en halv fil.
  `export/analys.py` skriver modellanalysens cache direkt ur modellen, med modellanalysens egna funktioner och format
  (`verktyg/modellanalys/modell.py`): egenskaperna per placerad del och näten per recept sparas i kärnans cache, så
  att bara det som har ändrats räknas (under en sekund för hela huset i stället för en halv minut när STEP-filen läses).
- **Kontroll** (`kontroll.py`): grovsållning med omslutande lådor, sedan exakt kontroll per par i parallella
  processer: gemensam volym (krock över 5 mm³), anliggande plana ytor (kontaktarea), minsta avstånd (glipor 0,01–2
  mm, utom mellan delar som båda ligger an mot en tredje). Resultaten per par cachas med nyckel från recepten och
  deras relativa placering. Materialpar som inte ska prövas alls (modellens `IGNORERADE`, t.ex. armering i betong)
  sållas bort före den exakta kontrollen och räknas som anliggande. Avsiktliga överlapp mellan material (t.ex. spikplåt
  under utegips) och numeriska skärvor under 5 mm³ (mot krökta ytor) redovisas för sig. Modellen anger båda i
  `trebodar/kontrollregler.py`.
- **Rendering** (`blender/rendera.py`, `blender/material.py`): Blender i bakgrunden läser GLB och bygger ett
  procedurellt material för varje material i modellen ur dess typ och parametrar (`scen.json`, som `mod rendera`
  skriver), utan bildtexturer (`tra.py`, `ytor.py`): virke ur en stock (varje bit och lamell sågad ur en egen stock
  med märgen på ett slumpat avstånd och håll, så att flader, halvkvarter och kvarter blandas och inga två bitar blir
  lika; årsringar som varierar år från år, sommarved eller porband för ringporigt trä som ask, kvistar ur märgen,
  kärnved; träslag och ytbehandling i `ARTER` och `YTOR`), sågade brädor (täckfärg, järnvitriol, obehandlat; skarvar,
  kvistar, strimmor och skruvar i rader), målad gips, betong (slipat golv uppåt, gjuten yta annars), kakel, plåt i
  banor, kluven granit, bruk, berg, mark och glas (genomskinligt med reflex på den första ytan; skugg- och diffusa
  strålar går rakt igenom). Det som skiljer delar av samma material åt slumpas per objekt.
- **Ljuset** (`modellering/dagsljus.py`, `blender/scen.py`): solens läge (NOAA) för platsen (`skelett.PLATS`) och
  tidpunkten, och ett spektralt dagsljus: solens spektrum genom atmosfären (Rayleigh, aerosol efter Ångström, ozon,
  vattenånga) och den diffusa himlen, molnighet efter Kasten–Czeplak och färgerna som CIE 1931 → linjär Rec.709.
  `dagsljus(månad, dag, klocka, väder)` ger solens riktning, färg och belysning och himlens färg och belysning. I
  Blender blir solen en sollampa med belysningen (lux / 683) och solskivans storlek efter vädret, och himlen skalas så
  att dess belysning på en horisontell yta och dess färg blir dagsljusets (mäts med en liten panoramarendering);
  mulet är en CIE-himmel. Ljusportaler i fönster, glasdörrar och takfönster i inomhusbilderna, och taklampor (LED-
  paneler, `LAMPOR` i `vyer.py`) som tänds i de vyer som anger dem. Elinstallationens armaturer
  blir ljus med tillverkarens uppmätta ljusfördelning (EULUMDAT → IES, `modellering/fotometri.py`; Cycles läser
  IES-filens candela som 0,0706 · P / 4π, så effekten 4π / (683 · 0,0706) W ger ljusstyrkan i samma enheter som
  solen), färgtemperatur och lysande yta; de infällda sitter i sina hål i gipsen (i modellen), och linsen lyser
  för kameran. Exponeringen (EV100)
  räknas fram ur en snabb förhandsbild; inne också vitbalansen, som ögats anpassning till ljuset i rummet:
  förhandsbildens diffusa ljuspass ger färgen på ljuset som når ytorna (sol, himmel, lampor och färgen från det
  ljuset studsat på, men inte ytornas egen färg), och graden av anpassning följer CIECAM02 ur
  adaptationsluminansen, minskad för varmt ljus (dagsljus inne nästan helt neutralt, 2 700 K-lampor i mörker till
  ungefär 60 %, så att lampljuset förblir varmt). Ute vitbalans efter dagsljusets färgtemperatur (solens och
  himlens, med en del kvar av kvällssolens värme).
- **Ljusplanerna** (`modellering/ljusplan.py`, `blender/scen.matyta`): en vit, perfekt diffus mätyta som bara
  kameran ser (den skuggar och reflekterar inget) renderas ovanifrån med en ortografisk kamera, och belysningsstyrkan
  är E = π · 683 · L lux i samma kalibrering som ljuset (kontrollerat: det direkta ljuset under allrummets spotar
  stämmer inom 1 % med en handräkning ur fotometrifilen). Allt annat lyser, skuggar och reflekterar som i
  renderingen: ljuset studsar i rummen (diffust minst fyra gånger) och tas upp efter materialens färg, utan
  gränser för samplens bidrag. Kaustiken (ljus via blanka ytor och genom glas efter en diffus studs) är avslagen
  för bruset, så belysningsstyrkan blir något för låg med ytornas blanka andel. Delområden i en egen höjd
  (bänkskivorna på planerna över plan 1) renderas för sig, med ytorna två rutor större så att kanten inte blandas
  med planet under, och ersätter planet i sina rutor. Cycles på GPU med
  brusreducering (OIDN), färgåtergivning Khronos PBR Neutral.
- **Ritningarna** (`modellering/planritning.py`, `kameraplan.py`, `elritning.py`, `ljusplan.py`): i den gemensamma
  ritningsmallen ([`beräkningar/ritningsmall`](../../beräkningar/ritningsmall/), A3 med samma ram, ritningshuvud,
  linjer och typsnitt som de andra ritningarna) på planer ur STEP-filens snitt: väggarna som en sammanhängande yta,
  fönster, dörrar, trappor och kaminen. Bladen (JSON och pdf) skrivs till `modeller/trebodar/ut/` (Typst läser bara
  filer under repots rot) och pdf:en dit `--ut` pekar. De är preliminära och utan revision; numren tills vidare
  I-01 (kameraplanen), E-01.n (elritningarna), U-04.n (ljusplanerna, utredningen U-04 med revision; numret efter mätytan i `MATYTOR`) och
  VL-01.n (ventilationen).
- **Omgivningen** (`modellering/geodata.py`, `blender/omgivning.py`): marken från modellens terräng ut till
  höjdmodellen (2,3 km), havet, grannhusen (valmade tak i slumpade färger) och träd (tall, gran, björk, en) efter
  marktäcket, så att fönstren och utsikterna visar skärgården runt tomten. Runt tomten (ärende #26,
  `modellering/terrang.py`, bara i renderingen) Lantmäteriets markhöjdmodell (1 m över tomten, 2,5 m omkring) i
  stället för Terrarium, rättad mot de egna inmätta markpunkterna (`lokalt/terrang`, versionshanteras inte), och
  marken från modellens terräng ut till den på omkring 5 m. Över tomten följer marktäcket de inmätta punkterna (berg,
  gräsmatta, barr under träden) och de inmätta träden och stenarna står där de är inmätta; på tomten inga andra träd
  än de tillagda.
  Med Poly Havens tillgångar (CC0, `lokalt/polyhaven`, `./mod omgivning --hamta`) får berget, gräset och barren
  detaljer ur riktiga texturer och träden och stenarna är riktiga modeller (tallar och granar, även i skogen, och
  rundade granitblock), tonade som på platsen; utan dem är allt procedurellt. Hällmarken är mest berg i
  dagen med sprickor av ljung och gräs och tallar i dungar, som i flygbilderna. Det som saknas i OpenStreetMap
  (grannhus, skog), inmätta träd som inte finns och tallar som saknas står i `vyer.GEODATA` (`byggnader`, `skog`,
  `utan_trad`, `nya_trad`, i modellens mm); byggnadernas mark tas ur Lantmäteriets höjder. Bäddar (`baddar`:
  upphöjda partier som höjdmodellen inte ser, som bädden framför altanen) höjer marken med en mjuk slänt och har
  gräs i tuvor och små buskar (Poly Havens), och vid dem står buskar (`buskar`). Flygbilderna `flyg-tomten`
  och `flyg-omgivningen` visar tomten och omgivningen rakt ovanifrån med verklig norr uppåt, för att jämföra med
  flygfoton och kommentera var saker står; tomten i mulet väder, så att trädens skuggor inte ser ut som träd.
- **Kameror** (`modeller/trebodar/vyer.py`): kameran hålls vågrät med objektivförskjutning, så att lodräta linjer
  blir lodräta. Inomhusbilderna I01–I30 heter `<nummer>-<rum>-<vy>-<objektiv>` med objektiven `öga` (40 mm i
  ögonhöjd 1,60 m: bildvinkeln och perspektivet som när man står i rummet) och `vid` (20 mm på 1,45 m); se
  [`renderingar/`](../../renderingar/).
- **Renderingarna på webben** (`webb/renderingar.html`, `modellering/renderingar.py`): plan 1, källaren och en plan
  ute ur kameraplanens snitt (SVG i modellens mm) med alla vyernas kameror (läge, riktning och bildvinkel). Ett klick
  på en kamera visar bilden över hela fönstret (piltangenterna eller svep till nästa, Esc stänger, vyn står i adressen
  `#<namn>`). Planerna och kamerorna byggs ur modellen vid varje bygge (`plan.json`); bilderna bara när de publiceras
  (`mod publicera`, releasen `bilder`), och en kamera som har flyttats sedan bilden renderades märks.
- **Webben** (`webb/index.html`): three.js (fast version från CDN) med modellträd (med sökning), vyer, delarnas kanter
  och snitt i x, y och z. Materialen listas med sina CAD-färger och kan döljas var för sig (t.ex. isolering och gips
  för att se stommen); en ruta växlar till de verkliga färgerna. Där ett snitt skär en del räknas tvärsnittet ut ur
  nätet och ritas i delens färg med svart kontur, som i en sektionsritning. Klick visar delens namn, sökväg och
  material. Navigeringen som i CAD-program: hjulet för kameran mot punkten under pekaren (ett steg är en andel av
  avståndet dit, och rotationscentrum följer med, så att man kommer hur nära som helst och genom väggar), vridning och
  panorering sker kring djupet för punkten där man tar tag, dubbelklick sätter rotationscentrum och piltangenterna och
  PgUp/PgDn går genom huset. En ruta (O) växlar till ortografisk vy (parallellprojektion, som en fasadritning): samma
  navigering, bilden lika stor som perspektivets vid rotationscentrum och hjulet skalar den kring punkten under
  pekaren. Djupbufferten är logaritmisk, så att tunna skikt nära varandra (takplåten på pappen) inte flimrar. Högerklick på en del (delen och
  grupperna den ingår i), en grupp i trädet eller ett material ger en meny: visa bara, tona ner resten (90 %
  genomskinligt), dölj, zooma, visa i trädet och visa allt; Esc avslutar. Fokus står i adressen (`#bara=<sökväg>`,
  `#tona=<sökväg>`, `#bara=material:<namn>`), så att en vy kan delas med en länk. Mätverktygen uppe till höger mäter
  en rak kant (K), avståndet mellan två punkter (A) och det vinkelräta avståndet mellan två parallella kanter (P),
  också på snittets konturer, och visar den senaste mätningen med Δx, Δy och Δz i en ruta under knapparna; pekaren snäpper till hörn, kanters mitt, kanter och ytor, och
  kanter som delas upp i nätet räknas som en.

`mod onshape` läser API-nycklarna ur `lokalt/onshape.json` i repot (versionshanteras inte; `access_key`,
`secret_key` och eventuellt `mapp`) eller ur miljövariablerna `ONSHAPE_ACCESS_KEY` och `ONSHAPE_SECRET_KEY`. Ett
gratiskonto i Onshape kan bara skapa publika dokument; då krävs `--publik`. Onshape behåller högst 100
sammanställningar per import och slår ihop de djupaste nivåerna i större modeller (hela huset har drygt 300); ladda
upp delträd med `--del` (t.ex. `"Hus/Stomme/Stomme prefab"`) för att få hela strukturen.

STEP-filen analyseras med [`verktyg/modellanalys`](../modellanalys/) (`./ma …`, som läser den genererade modellen i
dess senaste bygge som standard, via ma-tjänsten; snitten i ritningarna ovan hämtas där).
