vron/trebodar/rapporter/U-04revA Ljusplaner - belysningsstyrka med all belysning tänd.pdf

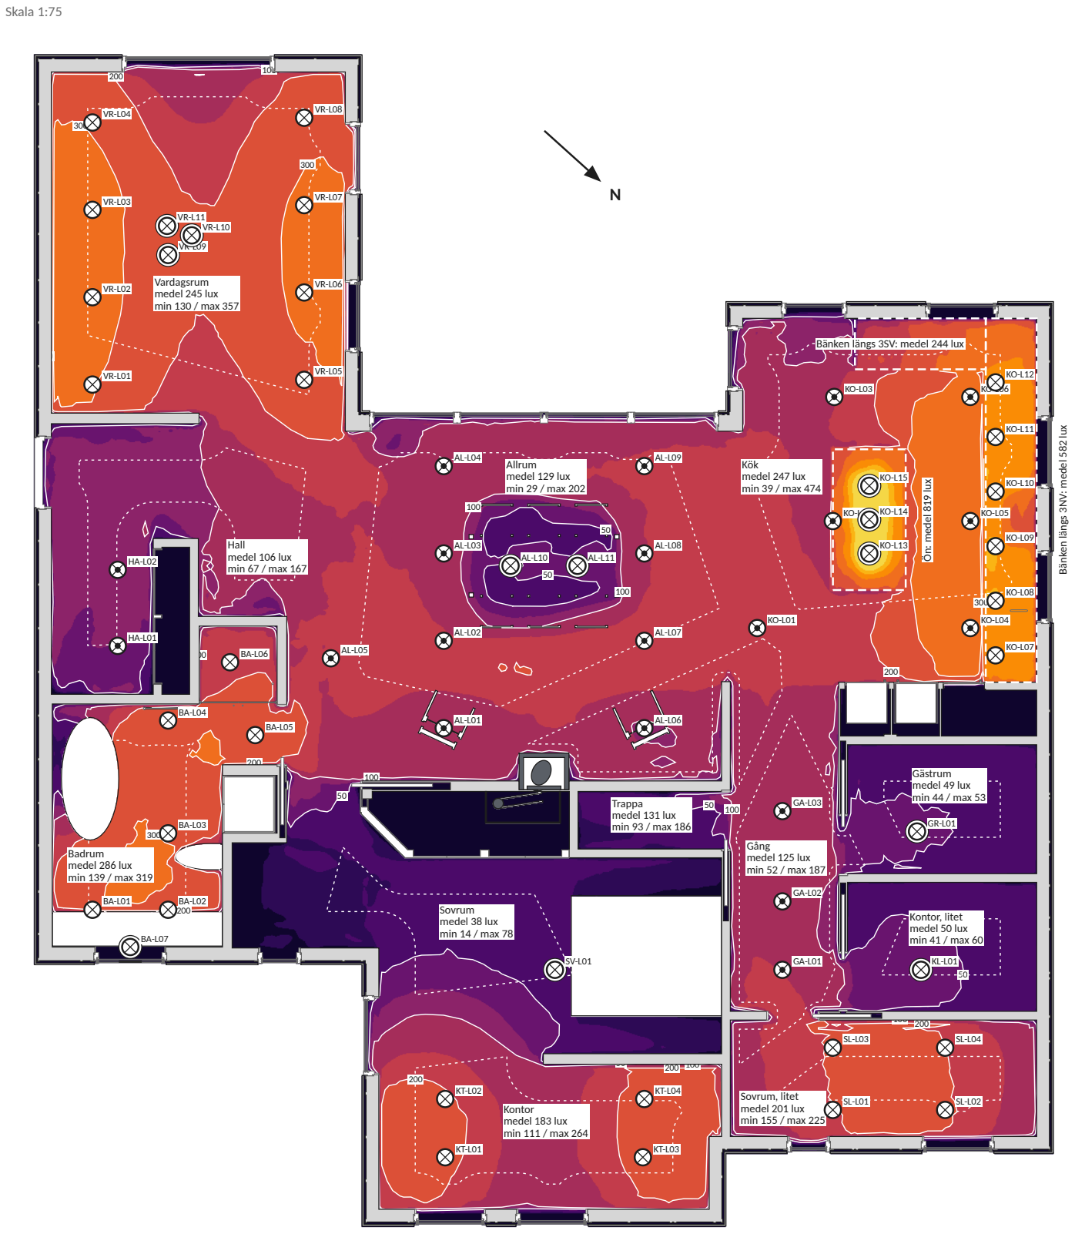
[picture p43: figure]
Vardagsrum medel 245 lux min 130 / max 357; Hall medel 106 lux min 67 / max 167; Badrum medel 286 lux min 139 / max 319; Allrum medel 129 lux min 29 / max 202; Kontor medel 183 lux min 111 / max 264; Sovrum medel 38 lux min 14 / max 78; Trappa medel 131 lux min 93 / max 186; Kök medel 247 lux min 39 / max 474; Gång medel 125 lux min 52 / max 187; Kontor, litet medel 50 lux min 41 / max 60; Gästrum medel 49 lux min 44 / max 53; Sovrum, litet medel 201 lux min 155 / max 225; Bänken längs 3NV: medel 582 lux; Skala 1:75

Bänken längs 3SV: medel 244 lux Ön: medel 819 lux

## Plan 1, golvet, belysningsstyrka

0 | 1 | 2 | 3 | 4 | 5

m

Belysningsstyrka, lux

2 000

1 000

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
Rum och delområden, lux

Rum | Medel | Min | Max | Jämnhet U₀
Allrum | 129 | 29 | 202 | 0,22
Badrum | 286 | 139 | 319 | 0,49
Bänken längs 3NV (0,91 m) | 582 | 193 | 808 | 0,33
Bänken längs 3SV (0,91 m) | 244 | 94 | 504 | 0,38
Gästrum | 49 | 44 | 53 | 0,90
Gång | 125 | 52 | 187 | 0,42
Hall | 106 | 67 | 167 | 0,63
Kontor | 183 | 111 | 264 | 0,61
Kontor, litet | 50 | 41 | 60 | 0,81
Kök | 247 | 39 | 474 | 0,16
Sovrum | 38 | 14 | 78 | 0,36
Sovrum, litet | 201 | 155 | 225 | 0,77
Trappa | 131 | 93 | 186 | 0,71
Vardagsrum | 245 | 130 | 357 | 0,53
Ön (0,91 m) | 819 | 192 | 2 048 | 0,23

Anvisningar
1. Belysningsstyrkan på en vågrät yta 0,04 m över golvet, i rutor om 50 mm, ur renderingen i Blender (Cycles): armaturernas uppmätta ljusfördelning (tillverkarnas fotometrifiler), dagsljuset och reflexerna i rummen. Delområdena Bänken längs 3NV, Bänken längs 3SV och Ön mäts på en vågrät yta 0,91 m över golvet.
2. Tända: AL-T1 Allrum, tubspotar sydost; AL-T2 Allrum, tubspotar nordväst; AL-T3 Allrum, PH 5 över bordet; KO-T1 Kök, tubspotar mot taket; KO-T2 Kök, spotar mot bänken; KO-T3 Kök, Stav över ön; GA-T1 Gång, tubspotar; HA-T1 Hall, tubspotar; VR-T1 Vardagsrum, spotar sydost; VR-T2 Vardagsrum, spotar nordväst; VR-T3 Vardagsrum, VL45; BA-T1 Badrum, spotar; BA-T2 Badrum, lampan över tvättstället; SV-T1 Sovrum, glob; KT-T1 Kontor, spotar mot väggarna; SL-T1 Sovrum litet, spotar mot gaveln; SL-T2 Sovrum litet, spotar mot L1; KL-T1 Kontor litet, glob; GR-T1 Gästrum, glob; KA-T6 Källaren, det stora rummet; KA-T7 Källaren, det lilla rummet väster om KL2; KA-T8 Källaren, det lilla rummet öster om KL2; KA-T1 Källaren, trapphallen; KA-T2 Källaren, tvättstugan; KA-T3 Källaren, rummen söder om V4–V6, västra delen; KA-T4 Källaren, rummen söder om V4–V6, östra delen; KA-T5 Källaren, rummet norr om trapphallen.
3. Inget dagsljus (2026-12-21 kl. 22:00).
4. Statistiken per rum utan en kantzon på 0,5 m längs väggarna (SS-EN 12464-1), i små rum mindre, och utan inredningen på mätytan (skåp, säng, bänkskivor, källartrappan och pelarna, vita på planen); jämnheten U₀ = minsta / medel. Rummen är de slutna ytorna mellan väggarna; en öppen planlösning delas mellan rummens namn.
5. Ritningen ritas med ./mod ljusplan (verktyg/modellering); mätytorna står i modellens el/matytor.py.

Teckenförklaring
isolinje, med belysningsstyrkan
rummets yta i statistiken (utan kantzonen) delområde med egen statistik
armatur
Rev Avser | Datum | Sign

PROJEKT

Fritidshus Trebodar, Resö, Tanum

FASTIGHET

### Resö 2:66, Tanums kommun · BYGG.2025.2278

INNEHÅLL

## Ljusplan Plan 1, golvet

SKALA 1:75 | FORMAT A3 | DATUM 2026-11-05
UPPRÄTTAD Viktor Ogeman | GRANSKAD – | UNDERLAG Modellen, rendering
STATUS UTREDNING | | REVISION A

RITNINGSNUMMER
U-04.1

U-04.1 · 1:75 vid utskrift på A3 · Mått i mm om inte annat anges

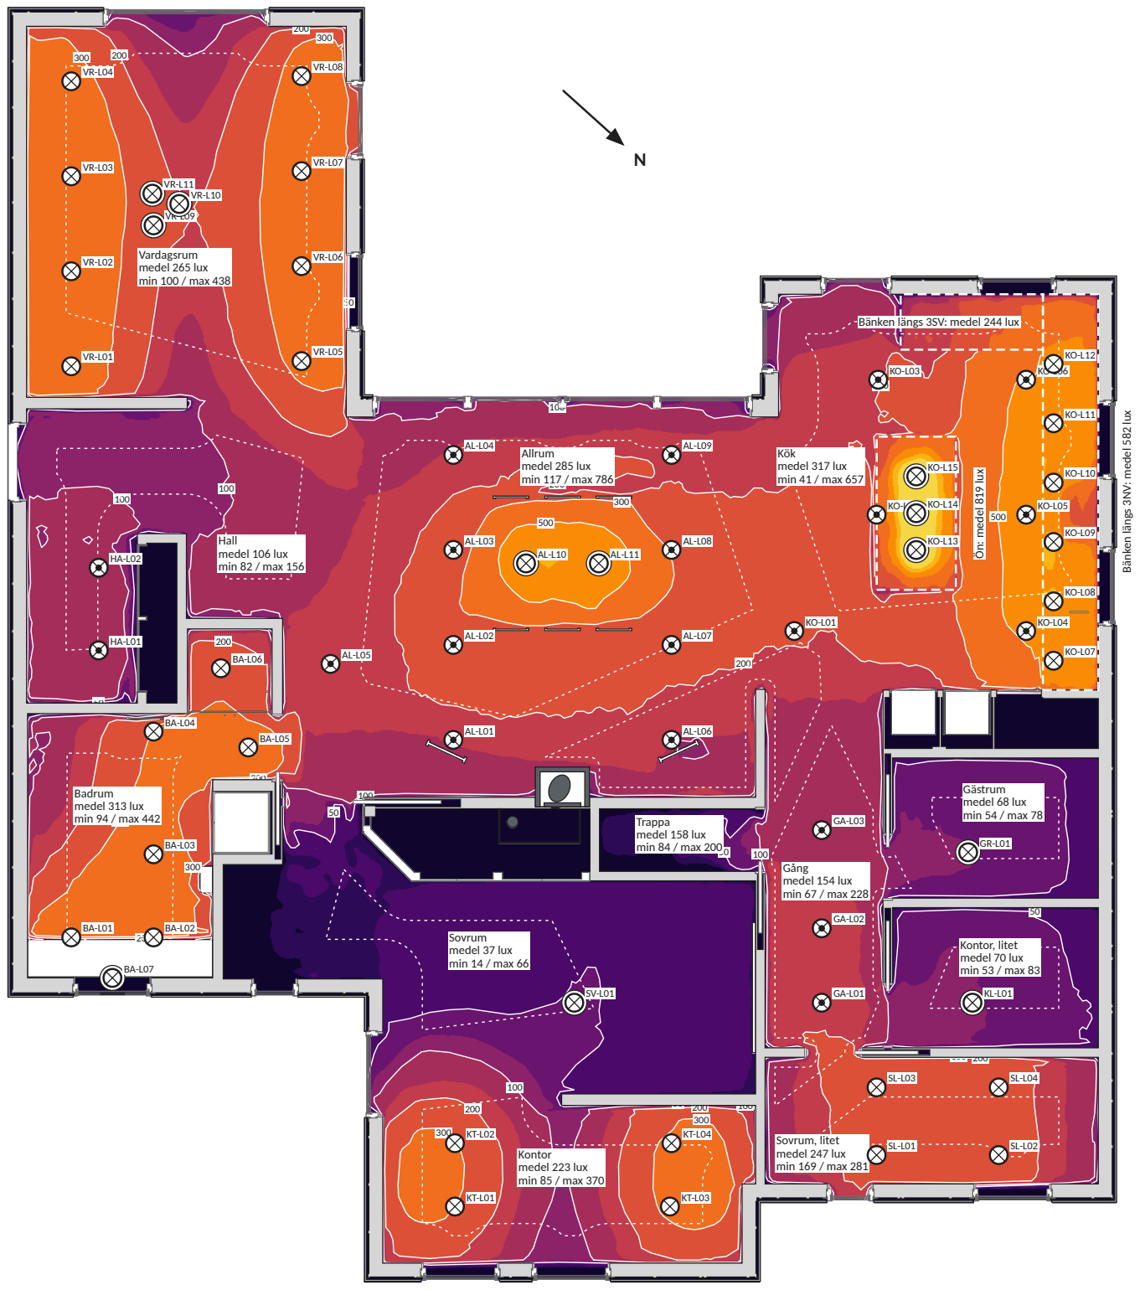
[picture p44: figure]
Vardagsrum medel 265 lux min 100 / max 438; Hall medel 106 lux min 82 / max 156; Badrum medel 313 lux min 94 / max 442; Allrum medel 285 lux min 117 / max 786; Kontor medel 223 lux min 85 / max 370; Sovrum medel 37 lux min 14 / max 66; Trappa medel 158 lux min 84 / max 200; Kök medel 317 lux min 41 / max 657; Gång medel 154 lux min 67 / max 228; Kontor, litet medel 70 lux min 53 / max 83; Gästrum medel 68 lux min 54 / max 78; Sovrum, litet medel 247 lux min 169 / max 281; Bänken längs 3NV: medel 582 lux

Bänken längs 3SV: medel 244 lux Ön: medel 819 lux

## Plan 1, bordshöjd 0,75 m, belysningsstyrka

0 | 1 | 2 | 3 | 4 | 5

m

2 000

1 000

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
Rum och delområden, lux

Rum | Medel | Min | Max | Jämnhet U₀
Allrum | 285 | 117 | 786 | 0,41
Badrum | 313 | 94 | 442 | 0,30
Bänken längs 3NV (0,91 m) | 582 | 193 | 808 | 0,33
Bänken längs 3SV (0,91 m) | 244 | 94 | 504 | 0,38
Gästrum | 68 | 54 | 78 | 0,79
Gång | 154 | 67 | 228 | 0,44
Hall | 106 | 82 | 156 | 0,78
Kontor | 223 | 85 | 370 | 0,38
Kontor, litet | 70 | 53 | 83 | 0,75
Kök | 317 | 41 | 657 | 0,13
Sovrum | 37 | 14 | 66 | 0,37
Sovrum, litet | 247 | 169 | 281 | 0,68
Trappa | 158 | 84 | 200 | 0,53
Vardagsrum | 265 | 100 | 438 | 0,38
Ön (0,91 m) | 819 | 192 | 2 048 | 0,23
1. Belysningsstyrkan på en vågrät yta 0,75 m över golvet, i rutor om 50 mm, ur

Delområdena Bänken längs 3NV, Bänken längs 3SV och Ön mäts på en vågrät yta 0,91 m över golvet.
2. Tända: AL-T1 Allrum, tubspotar sydost; AL-T2 Allrum, tubspotar nordväst; AL-T3 Allrum, PH 5 över bordet; KO-T1 Kök, tubspotar mot taket; KO-T2 Kök, spotar mot bänken; KO-T3 Kök, Stav över ön; GA-T1 Gång, tubspotar; HA-T1 Hall, tubspotar; VR-T1 Vardagsrum, spotar sydost; VR-T2 Vardagsrum, spotar nordväst; VR-T3 Vardagsrum, VL45; BA-T1 Badrum, spotar; BA-T2 Badrum, lampan över tvättstället; SV-T1 Sovrum, glob; KT-T1 Kontor, spotar mot väggarna; SL-T1 Sovrum litet, spotar mot gaveln; SL-T2 Sovrum litet, spotar mot L1; KL-T1 Kontor litet, glob; GR-T1 Gästrum, glob; KA-T6 Källaren, det stora rummet; KA-T7 Källaren, det lilla rummet väster om KL2; KA-T8 Källaren, det lilla rummet öster om KL2; KA-T1 Källaren, trapphallen; KA-T2 Källaren, tvättstugan; KA-T3 Källaren, rummen söder om V4–V6, västra delen; KA-T4 Källaren, rummen söder om V4–V6, östra delen; KA-T5 Källaren, rummet norr om trapphallen.
3. Inget dagsljus (2026-12-21 kl. 22:00).
4. Statistiken per rum utan en kantzon på 0,5 m längs väggarna (SS-EN 12464-1), i små rum mindre, och utan inredningen på mätytan (skåp, säng, bänkskivor, källartrappan och pelarna, vita på planen); jämnheten U₀ = minsta / medel. Rummen är de slutna ytorna mellan väggarna; en öppen planlösning delas mellan rummens namn.
5. Ritningen ritas med ./mod ljusplan (verktyg/modellering); mätytorna står i modellens el/matytor.py.

Teckenförklaring
isolinje, med belysningsstyrkan
rummets yta i statistiken (utan kantzonen) delområde med egen statistik
armatur
Rev Avser | Datum | Sign

PROJEKT

Fritidshus Trebodar, Resö, Tanum

FASTIGHET

### Resö 2:66, Tanums kommun · BYGG.2025.2278

INNEHÅLL

## Ljusplan Plan 1, bordshöjd 0,75 m

SKALA 1:75 | FORMAT A3 | DATUM 2026-11-05
UPPRÄTTAD Viktor Ogeman | GRANSKAD – | UNDERLAG Modellen, rendering
STATUS UTREDNING | | REVISION A

U-04.2

U-04.2 · 1:75 vid utskrift på A3 · Mått i mm om inte annat anges

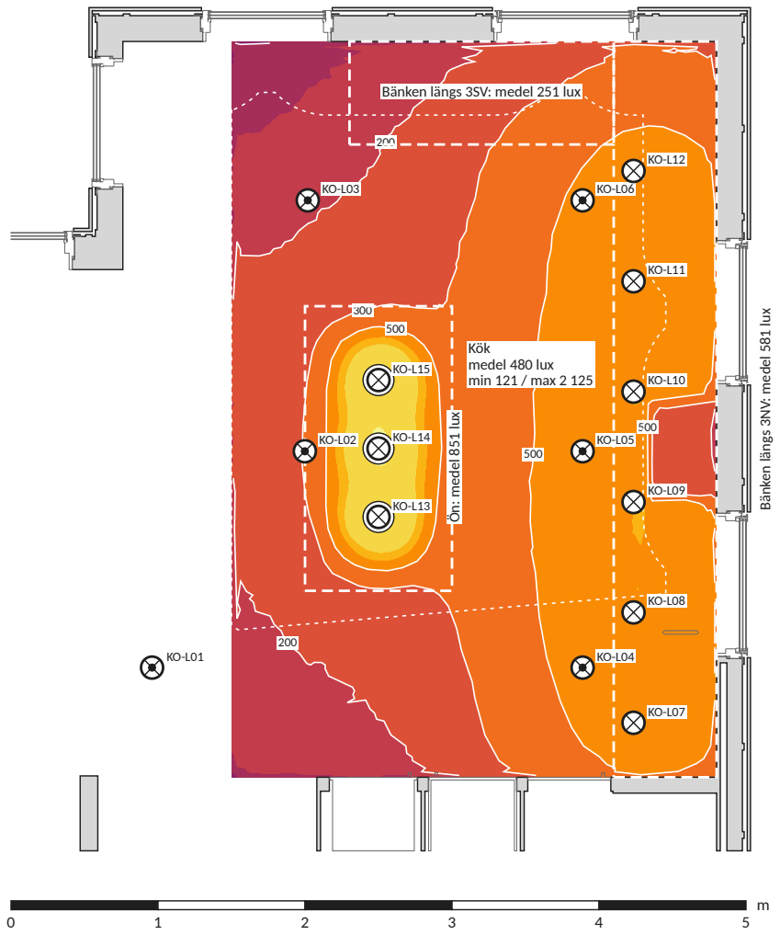
[picture p45: figure]
Kök medel 480 lux min 121 / max 2 125; Bänken längs 3NV: medel 581 lux

# Bänken längs 3SV: medel 251 lux Ön: medel 851 lux

## Köket, bänkskivorna 0,91 m, belysningsstyrka

2 000

1 000

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
Rum och delområden, lux

Rum | Medel | Min | Max | Jämnhet U₀
Bänken längs 3NV | 581 | 142 | 778 | 0,24
Bänken längs 3SV | 251 | 130 | 512 | 0,52
Kök | 480 | 121 | 2 125 | 0,25
Ön | 851 | 223 | 2 125 | 0,26
1. Belysningsstyrkan på en vågrät yta 0,91 m över golvet, i rutor om 25 mm, ur
2. Tända: AL-T1 Allrum, tubspotar sydost; AL-T2 Allrum, tubspotar nordväst; AL-T3 Allrum, PH 5 över bordet; KO-T1 Kök, tubspotar mot taket; KO-T2 Kök, spotar mot bänken; KO-T3 Kök, Stav över ön; GA-T1 Gång, tubspotar; HA-T1 Hall, tubspotar; VR-T1 Vardagsrum, spotar sydost; VR-T2 Vardagsrum, spotar nordväst; VR-T3 Vardagsrum, VL45; BA-T1 Badrum, spotar; BA-T2 Badrum, lampan över tvättstället; SV-T1 Sovrum, glob; KT-T1 Kontor, spotar mot väggarna; SL-T1 Sovrum litet, spotar mot gaveln; SL-T2 Sovrum litet, spotar mot L1; KL-T1 Kontor litet, glob; GR-T1 Gästrum, glob; KA-T6 Källaren, det stora rummet; KA-T7 Källaren, det lilla rummet väster om KL2; KA-T8 Källaren, det lilla rummet öster om KL2; KA-T1 Källaren, trapphallen; KA-T2 Källaren, tvättstugan; KA-T3 Källaren, rummen söder om V4–V6, västra delen; KA-T4 Källaren, rummen söder om V4–V6, östra delen; KA-T5 Källaren, rummet norr om trapphallen.
3. Inget dagsljus (2026-12-21 kl. 22:00).
4. Statistiken per rum utan en kantzon på 0,5 m längs väggarna (SS-EN 12464-1), i små rum mindre, och utan inredningen på mätytan (skåp, säng, bänkskivor, källartrappan och pelarna, vita på planen); jämnheten U₀ = minsta / medel. Rummen är de slutna ytorna mellan väggarna; en öppen planlösning delas mellan rummens namn.
5. Ritningen ritas med ./mod ljusplan (verktyg/modellering); mätytorna står i modellens el/matytor.py.

Teckenförklaring
isolinje, med belysningsstyrkan
rummets yta i statistiken (utan kantzonen) delområde med egen statistik
armatur
Rev Avser | Datum | Sign

PROJEKT

Fritidshus Trebodar, Resö, Tanum

FASTIGHET

### Resö 2:66, Tanums kommun · BYGG.2025.2278

INNEHÅLL

## Ljusplan Köket, bänkskivorna 0,91 m

SKALA 1:50 | FORMAT A3 | DATUM 2026-11-05
UPPRÄTTAD Viktor Ogeman | GRANSKAD – | UNDERLAG Modellen, rendering
STATUS UTREDNING | | REVISION A

U-04.3

U-04.3 · 1:50 vid utskrift på A3 · Mått i mm om inte annat anges

## Källaren, golvet, belysningsstyrka

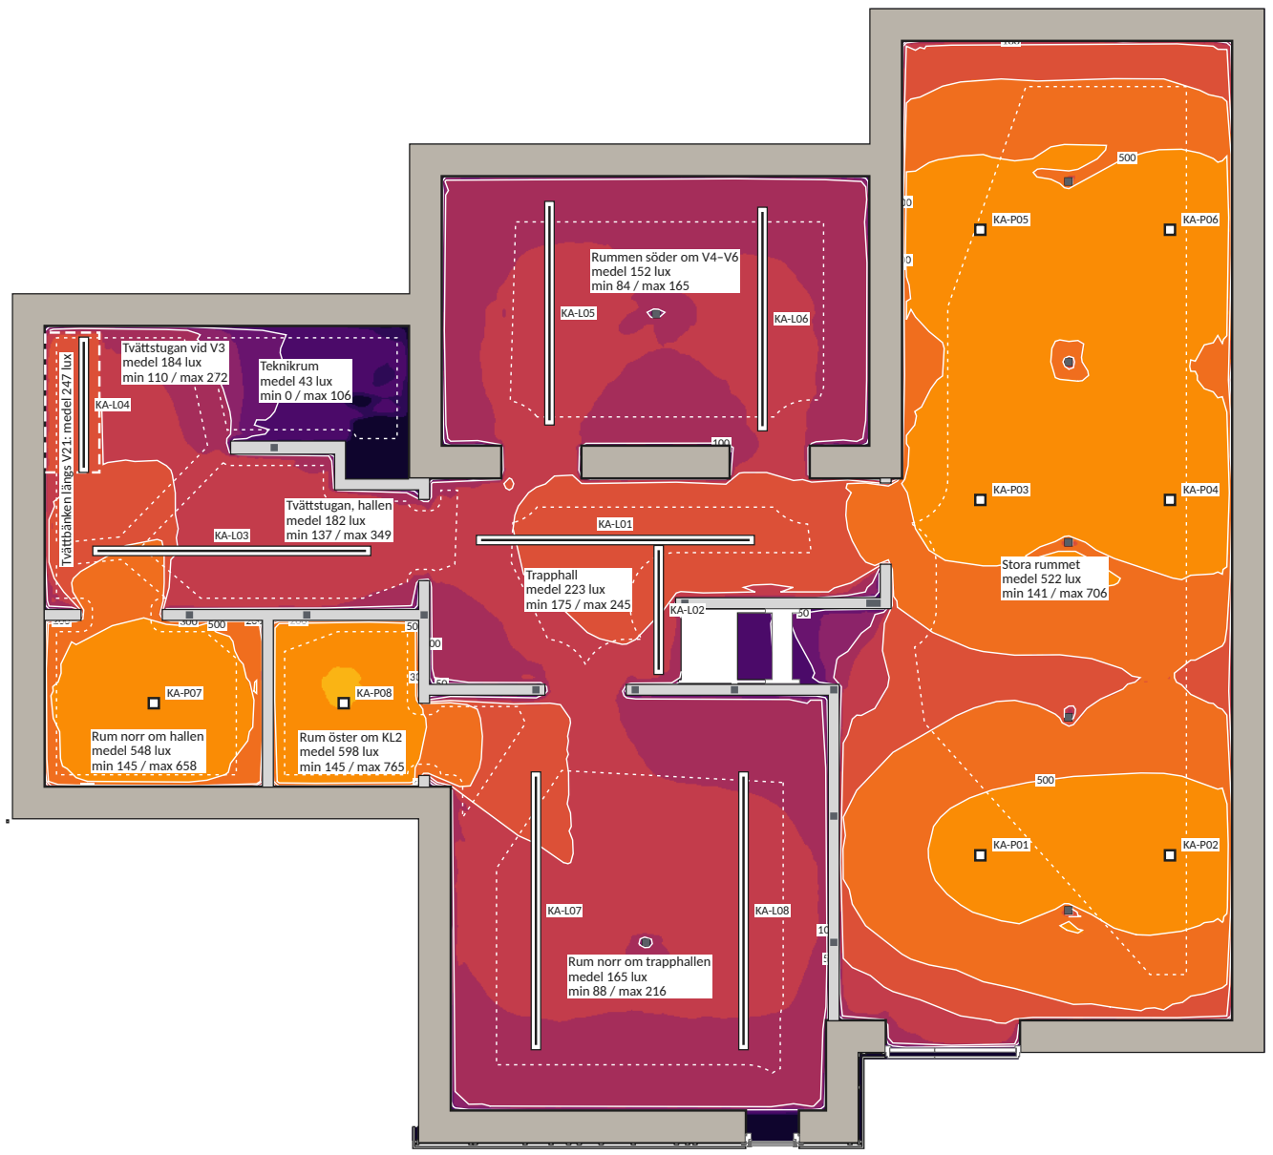
[picture p46: figure]
Tvättstugan vid V3 medel 184 lux min 110 / max 272; Tvättstugan, hallen medel 182 lux min 137 / max 349; Rum norr om hallen medel 548 lux min 145 / max 658; Rum norr om trapphallen medel 165 lux min 88 / max 216; Rummen söder om V4–V6 medel 152 lux min 84 / max 165; Rum öster om KL2 medel 598 lux min 145 / max 765; Trapphall medel 223 lux min 175 / max 245; Teknikrum medel 43 lux min 0 / max 106; Stora rummet medel 522 lux min 141 / max 706; Tvättbänken längs V21: medel 247 lux

0 | 1 | 2 | 3 | 4 | 5

m

2 000

1 000

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
Rum och delområden, lux

Rum | Medel | Min | Max | Jämnhet U₀
Rum norr om hallen | 548 | 145 | 658 | 0,26
Rum norr om trapphallen | 165 | 88 | 216 | 0,53
Rum öster om KL2 | 598 | 145 | 765 | 0,24
Rummen söder om V4–V6 | 152 | 84 | 165 | 0,55
Stora rummet | 522 | 141 | 706 | 0,27
Teknikrum | 43 | 0 | 106 | 0,00
Trapphall | 223 | 175 | 245 | 0,78
Tvättbänken längs V21 (0,90 m) | 247 | 158 | 289 | 0,64
Tvättstugan vid V3 | 184 | 110 | 272 | 0,60
Tvättstugan, hallen | 182 | 137 | 349 | 0,75
1. Belysningsstyrkan på golvet, i rutor om 50 mm, ur renderingen i Blender (Cycles): armaturernas uppmätta ljusfördelning (tillverkarnas fotometrifiler), dagsljuset och reflexerna i rummen. Ljuslinjerna lyser som lambertska ytor (den opala diffusorn) med det antagna ljusflödet per meter lysande längd. Delområdet Tvättbänken längs V21 mäts på en vågrät yta 0,90 m över golvet.
2. Tända: AL-T1 Allrum, tubspotar sydost; AL-T2 Allrum, tubspotar nordväst; AL-T3 Allrum, PH 5 över bordet; KO-T1 Kök, tubspotar mot taket; KO-T2 Kök, spotar mot bänken; KO-T3 Kök, Stav över ön; GA-T1 Gång, tubspotar; HA-T1 Hall, tubspotar; VR-T1 Vardagsrum, spotar sydost; VR-T2 Vardagsrum, spotar nordväst; VR-T3 Vardagsrum, VL45; BA-T1 Badrum, spotar; BA-T2 Badrum, lampan över tvättstället; SV-T1 Sovrum, glob; KT-T1 Kontor, spotar mot väggarna; SL-T1 Sovrum litet, spotar mot gaveln; SL-T2 Sovrum litet, spotar mot L1; KL-T1 Kontor litet, glob; GR-T1 Gästrum, glob; KA-T6 Källaren, det stora rummet; KA-T7 Källaren, det lilla rummet väster om KL2; KA-T8 Källaren, det lilla rummet öster om KL2; KA-T1 Källaren, trapphallen; KA-T2 Källaren, tvättstugan; KA-T3 Källaren, rummen söder om V4–V6, västra delen; KA-T4 Källaren, rummen söder om V4–V6, östra delen; KA-T5 Källaren, rummet norr om trapphallen.
3. Inget dagsljus (2026-12-21 kl. 22:00).
4. Statistiken per rum utan en kantzon på 0,5 m längs väggarna (SS-EN 12464-1), i små rum mindre, och utan inredningen på mätytan (skåp, säng, bänkskivor, källartrappan och pelarna, vita på planen); jämnheten U₀ = minsta / medel. Rummen är de slutna ytorna mellan väggarna; en öppen planlösning delas mellan rummens namn.
5. Ritningen ritas med ./mod ljusplan (verktyg/modellering); mätytorna står i modellens el/matytor.py.

Teckenförklaring
isolinje, med belysningsstyrkan
rummets yta i statistiken (utan kantzonen) delområde med egen statistik
armatur
ljuslinje, i sin längd
Rev Avser | Datum | Sign

PROJEKT

Fritidshus Trebodar, Resö, Tanum

FASTIGHET

### Resö 2:66, Tanums kommun · BYGG.2025.2278

INNEHÅLL

## Ljusplan Källaren, golvet

SKALA 1:75 | FORMAT A3 | DATUM 2026-11-05
UPPRÄTTAD Viktor Ogeman | GRANSKAD – | UNDERLAG Modellen, rendering
STATUS UTREDNING | | REVISION A

U-04.4

U-04.4 · 1:75 vid utskrift på A3 · Mått i mm om inte annat anges
