vron/trebodar/renderingar/kameraplan.pdf

## Plan 1, snitt 1,2 m över golvet

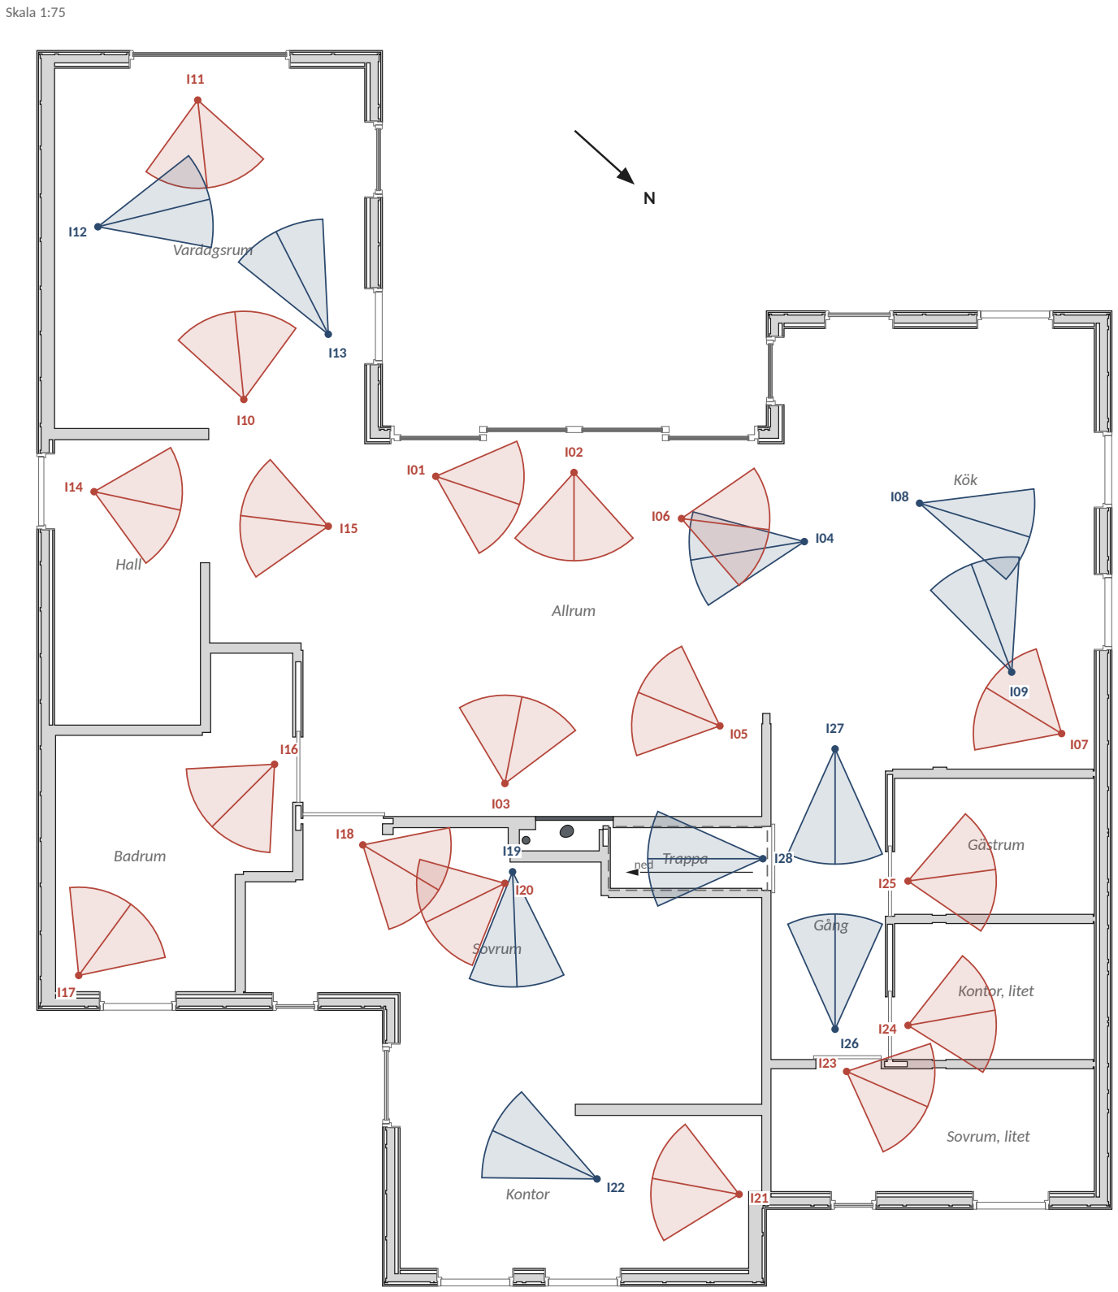
[picture p57: figure]
ned; Allrum; Kök; Vardagsrum; Hall; Badrum; Sovrum; Kontor; Sovrum, litet; Kontor, litet; Gästrum; Gång; Trappa; Skala 1:75

0 | 1 | 2 | 3 | 4 | 5

m

## Källaren, snitt 1,2 m över golvet

## Anvisningar

1. Inomhusbildernas kameror: läge, riktning och bildvinkel (vågrätt). Kameran är vågrät och lodräta linjer blir lodräta i bilderna, utom I28 (trappan, kameran lutad nedåt).
2. Kamerorna och vyerna står i modellens vyer.py (INNE). Bilderna renderas i 4K med renderingar/rendera.sh (./mod rendera) och versionshanteras inte.
3. Planerna är snitt ur modellen (STEP-filen) 1,2 m över golvet; ritningen ritas med ./mod kameraplan.

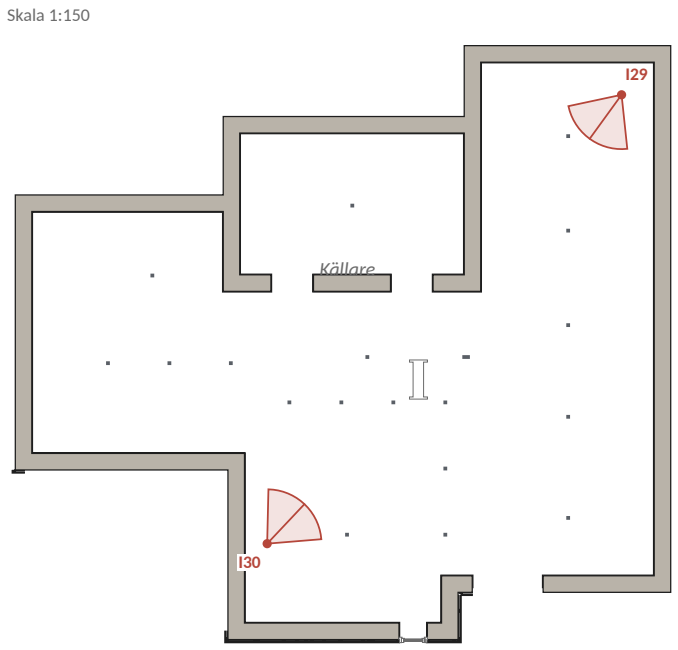
[picture p58: figure]
Källare; Skala 1:150

## Teckenförklaring

öga: 40 mm, bildvinkel 48°, kameran 1,60 m över golvet
vid: 20 mm, bildvinkel 84°, kameran 1,45 m över golvet trapphålet

## Bilderna, renderingar/inne/<namn>.png

Bild | Rum | Vy | Objektiv
I01 | Allrum | mot köket | vid
I02 | Allrum | mot kaminen | vid
I03 | Allrum | mot trädgården | vid
I04 | Allrum | matplats | öga
I05 | Allrum | mot hallen | vid
I06 | Kök | översikt | vid
I07 | Kök | mot allrummet | vid
I08 | Kök | mot fönstret | öga
I09 | Kök | mot uteplatsen | öga
I10 | Vardagsrum | från hallen | vid
I11 | Vardagsrum | mot hallen | vid
I12 | Vardagsrum | mot altandörren | öga
I13 | Vardagsrum | mot golvfönstret | öga
I14 | Hall | från entrén | vid
I15 | Hall | mot entrén | vid
I16 | Badrum | från dörren | vid
I17 | Badrum | mot dörren | vid
I18 | Sovrum | från dörren | vid
I19 | Sovrum | mot fönstret | öga
I20 | Sovrum | mot golvfönstret | vid
I21 | Kontor | översikt | vid
I22 | Kontor | mot altandörren | öga
I23 | Sovrum, litet | från dörren | vid
I24 | Kontor, litet | från dörren | vid
I25 | Gästrum | från dörren | vid
I26 | Gång | mot köket | öga
I27 | Gång | mot sovrummet | öga
I28 | Trappa | ned | öga
I29 | Källare | översikt | vid
I30 | Källare | mot trappan | vid
Rev Avser | Datum | Sign

PROJEKT

## Fritidshus Trebodar, Resö, Tanum

FASTIGHET

## Resö 2:66, Tanums kommun · BYGG.2025.2278

INNEHÅLL

## Inomhusbilder I01–I30 Kameraplan

SKALA 1:75, 1:150 | FORMAT A3 | DATUM 2026-11-02
UPPRÄTTAD Viktor Ogeman | GRANSKAD – | UNDERLAG Modellen
STATUS PRELIMINÄR | | REVISION –

RITNINGSNUMMER
I-01

I-01 · 1:75, 1:150 vid utskrift på A3 · Mått i mm om inte annat anges
