vron/trebodar/ritningar/AR-02 Utsättning.pdf

## Plan, utsättningspunkter

Skala 1:100

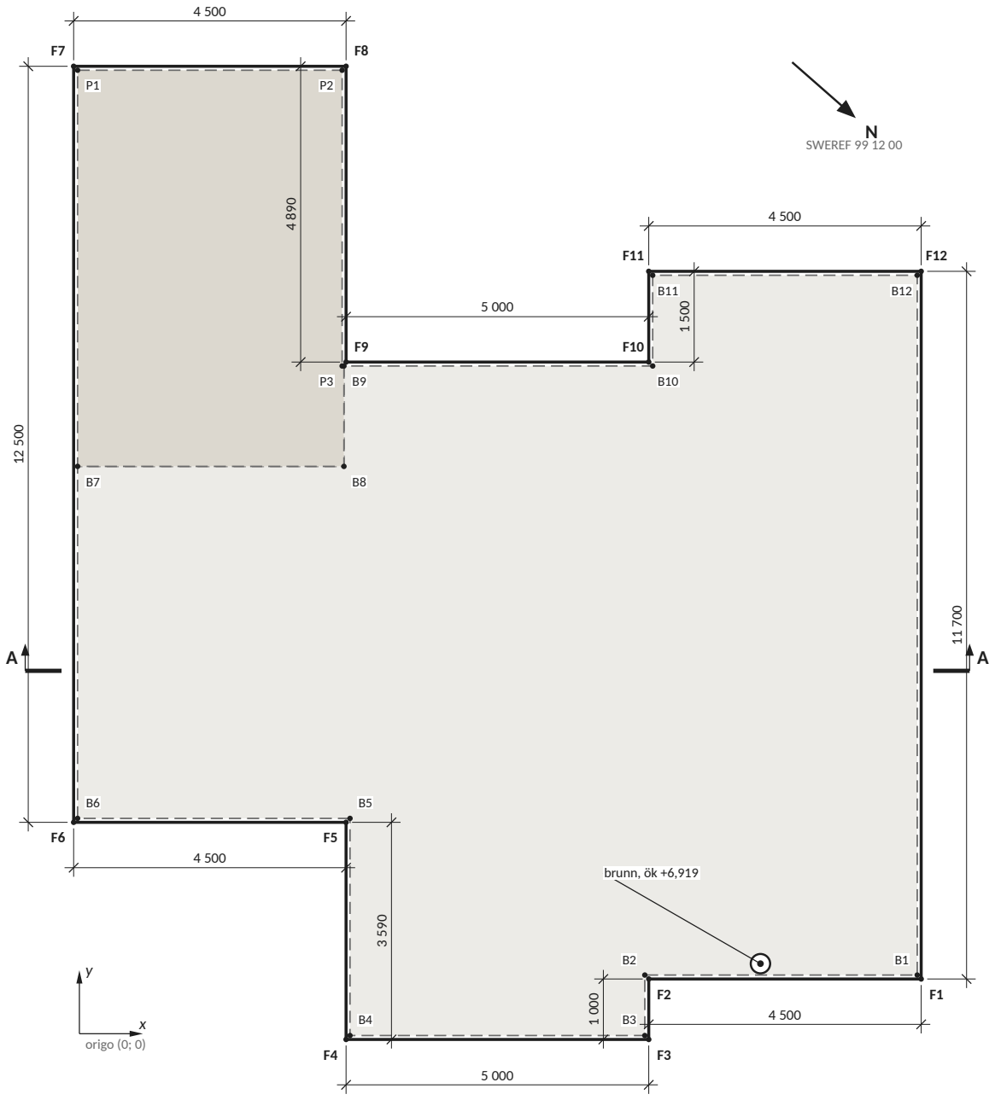
[picture p59: figure]
brunn, ök +6,919; origo (0; 0); N SWEREF 99 12 00

FIX +7,760

N 6 520 149,770 E 102 329,260
x 16 629 y 42 303
överkant gränsdubb i berg vid tomtens västra hörn

31,2 m

F7

29,8 m

F12

N

## Översikt, fixpunkt

Skala 1:500

### Utsättningspunkter, SWEREF 99 12 00

x, y i mm (K-05), N, E och höjder i m. Höjder i RH2000 och relativt fixpunkten FIX (+7,760).

### Fasadens utsida (F)

Punkt | x | y | N | E
F1 | 13 905 | 905 | 6 520 175,041 | 102 362,162
F2 | 9 405 | 905 | 6 520 171,660 | 102 365,132
F3 | 9 405 | −95 | 6 520 172,320 | 102 365,883
F4 | 4 405 | −95 | 6 520 168,563 | 102 369,183
F5 | 4 405 | 3 495 | 6 520 166,194 | 102 366,485
F6 | −95 | 3 495 | 6 520 162,813 | 102 369,455
F7 | −95 | 15 995 | 6 520 154,564 | 102 360,062
F8 | 4 405 | 15 995 | 6 520 157,945 | 102 357,093
F9 | 4 405 | 11 105 | 6 520 161,172 | 102 360,767
F10 | 9 405 | 11 105 | 6 520 164,929 | 102 357,468
F11 | 9 405 | 12 605 | 6 520 163,939 | 102 356,341
F12 | 13 905 | 12 605 | 6 520 167,321 | 102 353,371

### Bottenplattans kant (B), L-elementens ytterkant, ök +6,250 (FIX −1,510)

Punkt | x | y | N | E
B1 | 13 840 | 970 | 6 520 174,949 | 102 362,156
B2 | 9 340 | 970 | 6 520 171,568 | 102 365,126
B3 | 9 340 | −30 | 6 520 172,228 | 102 365,877
B4 | 4 470 | −30 | 6 520 168,569 | 102 369,091
B5 | 4 470 | 3 560 | 6 520 166,200 | 102 366,393
B6 | −30 | 3 560 | 6 520 162,819 | 102 369,363
B7 | −30 | 9 380 | 6 520 158,978 | 102 364,990
B8 | 4 370 | 9 380 | 6 520 162,284 | 102 362,086
B9 | 4 370 | 11 040 | 6 520 161,189 | 102 360,839
B10 | 9 470 | 11 040 | 6 520 165,021 | 102 357,474
B11 | 9 470 | 12 540 | 6 520 164,031 | 102 356,347
B12 | 13 840 | 12 540 | 6 520 167,314 | 102 353,463

### Plattan på marks kant (P), L-elementens ytterkant, ök +8,500 (FIX +0,740)

Punkt | x | y | N | E
P1 | −30 | 15 930 | 6 520 154,656 | 102 360,068
P2 | 4 340 | 15 930 | 6 520 157,939 | 102 357,185
P3 | 4 340 | 11 040 | 6 520 161,166 | 102 360,859

### Fixpunkt FIX, +7,760

Punkt | x | y | N | E
FIX | 16 628,8 | 42 302,7 | 6 520 149,770 | 102 329,260

### Dräneringsbrunnen (befintlig, inmätt), ök +6,919, utgående rör ø110 ök +5,779 (dimensionerande)

Punkt | x | y | N | E
Brunn | 11 250 | 1 158 | 6 520 172,879 | 102 363,724

### Anvisningar

1. Koordinater i SWEREF 99 12 00 (Tanums kommun), höjder i RH2000 (AR-02.2). Mått i mm. x, y är husets koordinater, samma som i K-05 och på R-03–R-06: origo i skärningen mellan mellanbjälklagets kanter x = 0 och y = 0.
2. Utstakning och lägeskontroll görs av certifierad mättekniker (krav i bygglovet BYGG.2025.2278).
3. Höjdreferens: fixpunkten FIX, byggfixen på nybyggnadskartan (2025-11-12): överkant gränsdubb i berg vid tomtens västra hörn, +7,760. Alla höjder anges i RH2000 och relativt dubben. Dubbens läge är angivet i cm.
4. Fasadens hörn F1–F12 är utsättningsdata. Bottenplattans (B) och plattan på marks (P) punkter är beräknade med samma läge:
5. E = E0 + (x cos θ − y sin θ)/1 000, N = N0 + (x sin θ + y cos θ)/1 000, med θ = 131,290900°, E0 = 102 372,0179, N0 = 6 520 165,1905.
6. Plattan på mark (P, tillbyggnaden) byggs med L-element, 500 mm höga. P är L-elementens ytterkant, i linje med bottenplattans kant vid B7–B9.

### Teckenförklaring

fasadens utsida (F)
bottenplattan (B), L-elementens ytterkant
plattan på mark (P), L-elementens ytterkant utsättningspunkt
- dräneringsbrunn (befintlig, inmätt) med utgående rör ø110
Rev Avser | Datum | Sign
A | Första utgåvan | 2026-10-31 | VO

PROJEKT

### Fritidshus Trebodar, Resö, Tanum

FASTIGHET

### Resö 2:66, Tanums kommun · BYGG.2025.2278

INNEHÅLL

## Utsättning Plan och koordinater

SKALA 1:100, 1:500 | FORMAT A3 | DATUM 2026-10-31
UPPRÄTTAD Viktor Ogeman | GRANSKAD – | UNDERLAG Bygglov, NBK, K-05, R-05
STATUS KONSTRUKTION | | REVISION A

RITNINGSNUMMER
AR-02.1

AR-02.1 · 1:100, 1:500 vid utskrift på A3 · Mått i mm om inte annat anges

+8,500 (FIX +0,740) mellanplattans ök = FG

+6,250 (FIX −1,510) bottenplattans ök

MMN +7,680 (FIX −0,080) +8,000 (FIX +0,240) plattan på mark bakom snittet, L-elementens uk

+5,950 (FIX −1,810) cellplastens uk under bottenplattan +5,779 (FIX −1,981) utgående rör ø110 ur brunnen, ök, dimensionerande (inmätt +5,759 + 20)

171

300 2 100 150

## Sektion A–A, y = 6 000 (princip)

Skala 1:50

### Höjder, RH2000

Nivå | RH2000 (m) | Relativt FIX (m) Underlag
Mellanplattans överkant = FG, färdigt golv plan 1 | +8,500 | +0,740 bygglov; betonggolv
Golvet i det gamla huset | +8,473 | +0,713 inmätt 2026-11-01 (GNSS)
Plattan på mark: L-elementens och cellplastens underkant | +8,000 | +0,240 plattans ök − L-element 500
Fixpunkt FIX, överkant gränsdubb i berg vid tomtens västra hörn | +7,760 | ±0 nybyggnadskartan 2025-11-12 (byggfix)
MMN, medelmarknivå | +7,680 | −0,080 bygglov
Dräneringsbrunnen (befintlig), överkant | +6,919 | −0,841 inmätt 2026-11-01 (GNSS)
Bottenplattans överkant | +6,250 | −1,510 mellanplattans ök − 150 − 2 100 (K-05, K-06)
Cellplastens underkant under bottenplattan | +5,950 | −1,810 − platta 100 − cellplast 200 (R-04)
Utgående rör ø110 ur brunnen, överkant: avledning för dränvattnet | +5,779 | −1,981 dimensionerande: inmätt +5,759 (brunnens ök − 1 160) + marginal 20

### Anvisningar

1. Höjder i RH2000 och relativt fixpunkten FIX (+7,760, gränsdubb i berg, se AR-02.1), i m. Mått i mm. Sektionen är en principskiss. Snittets läge: AR-02.1.
2. FG +8,500 är mellanplattans överkant.
3. Bottenplattans cellplast läggs på avjämnad makadam (R-04).
4. Dräneringsbrunnen är befintlig och inmätt (läge AR-02.1, y = 1 158); dess utgående rör ø110 är ritat i brunnens x. Överkant rör = brunnens överkant − 1 160 = +5,759; dimensionerande nivå 20 mm högre, +5,779, för mätosäkerheten.

### Teckenförklaring

takplanets ovansida
MMN
plattan på mark bakom snittet (L-element 500) betong
cellplast
fasadsten (AR-01)
beklädnad, plan 1
makadam
mark
Rev Avser | Datum | Sign
A | Första utgåvan | 2026-10-31 | VO

PROJEKT

### Fritidshus Trebodar, Resö, Tanum

FASTIGHET

### Resö 2:66, Tanums kommun · BYGG.2025.2278

INNEHÅLL

## Utsättning Sektion och höjder

SKALA 1:50 | FORMAT A3 | DATUM 2026-10-31
UPPRÄTTAD Viktor Ogeman | GRANSKAD – | UNDERLAG Bygglov, NBK, K-05, R-05
STATUS KONSTRUKTION | | REVISION A

RITNINGSNUMMER
AR-02.2

AR-02.2 · 1:50 vid utskrift på A3 · Mått i mm om inte annat anges
