vron/trebodar/ritningar/R-03 Bärande system i betong.pdf

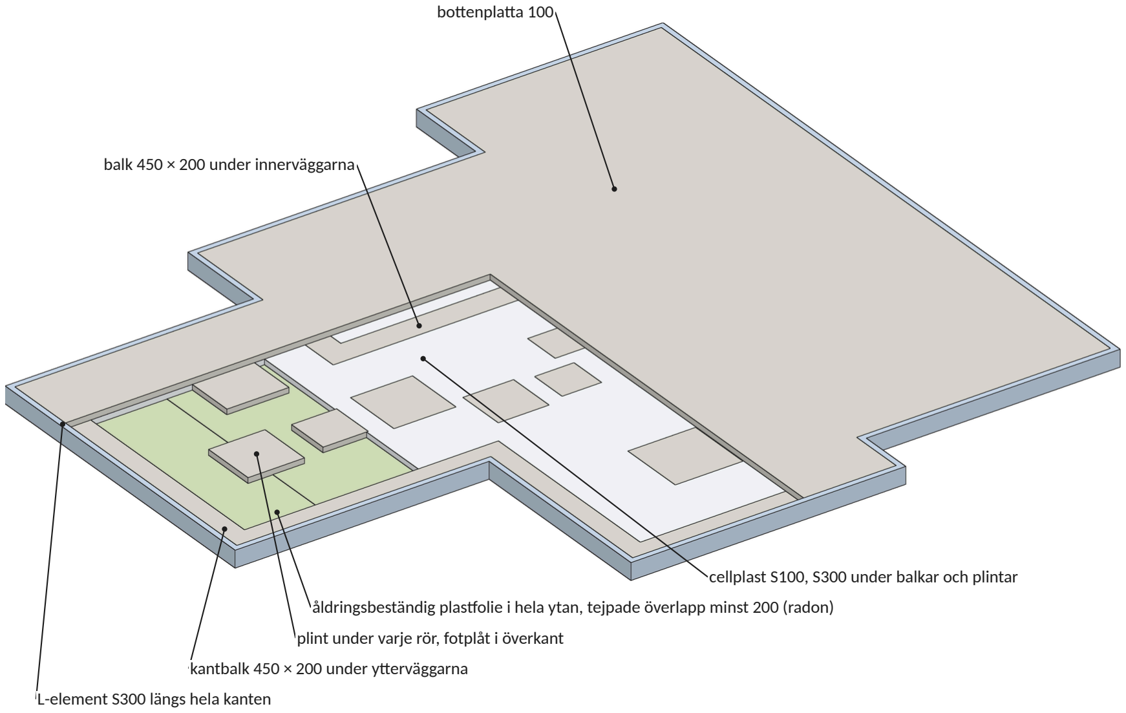
[picture p64: figure]
L-element S300 längs hela kanten; kantbalk 450 × 200 under ytterväggarna; balk 450 × 200 under innerväggarna; bottenplatta 100

plint under varje rör, fotplåt i överkant

cellplast S100, S300 under balkar och plintar

åldringsbeständig plastfolie i hela ytan, tejpade överlapp minst 200 (radon)

## 1 BOTTENPLATTA (R-04)

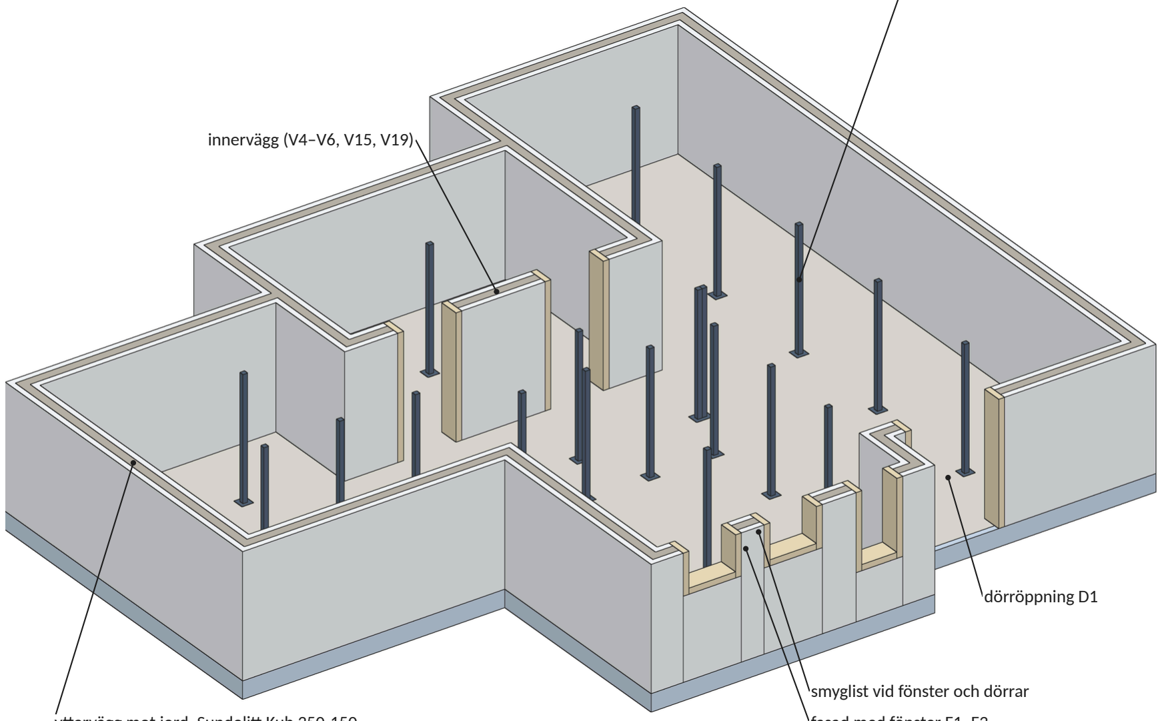
[picture p65: figure]
innervägg (V4–V6, V15, V19); dörröppning D1; smyglist vid fönster och dörrar

yttervägg mot jord, Sundolitt Kub 350-150 stålrör VKR 80 × 80 på fotplåt i plinten (P1–P19)

fasad med fönster F1–F3

## 2 KÄLLARVÄGGAR OCH RÖR (R-05)

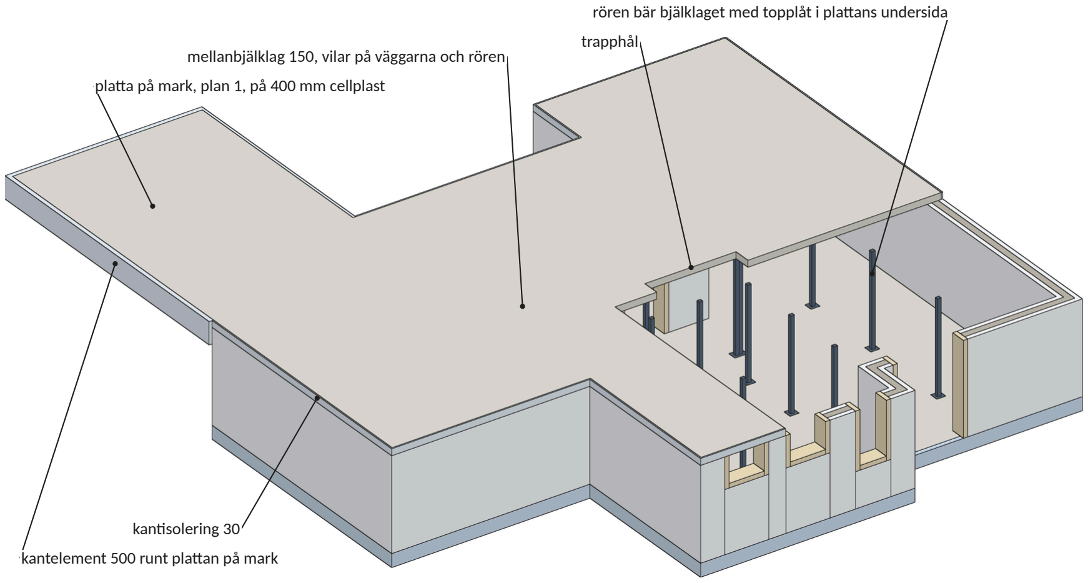
[picture p66: figure]
trapphål; kantisolering 30; kantelement 500 runt plattan på mark

mellanbjälklag 150, vilar på väggarna och rören

platta på mark, plan 1, på 400 mm cellplast

rören bär bjälklaget med topplåt i plattans undersida

## 3 MELLANBJÄLKLAG (R-06)

### Bärande system

1. Bilderna visar betongarbetets bärande delar i 3D.
2. Mellanbjälklaget, 150 mm, bär plan 1 och vilar på källarväggarna och på stålrören P1–P19. Över fyllningen norr om källaren ligger det som platta på mark på 400 mm cellplast (K-05).
3. Källarväggarna av Sundolitt Kub 350-150 bär bjälklaget och jordtrycket; ytterväggarna hålls i toppen av bjälklaget och i botten av bottenplattan. Fasaden mot söder har fönster F1–F3 mellan pelare (K-06).
4. Rören står på fotplåtar som gjuts in i plintarnas överkant. Väggarna står på kantbalken i L-elementen och på balkarna under innerväggarna.
5. Bottenplattan, 100 mm, gjuts i en gjutning med kantbalkarna, balkarna och plintarna. De fördelar lasten på cellplasten, S300 under balkar och plintar och S100 under plattan, som ligger på makadam på sprängt berg (K-06).
6. Mot radon: åldringsbeständig plastfolie i ett plan över hela bottenplattan, 200 mm under överkant: mellan cellplastskikten, under balkarna och plintarna och ut över L-elementens fot. Skarvarna med minst 200 mm överlapp, tejpade, och tätade vid genomföringar (R-04).
7. Plattan på mark har kantelement av cellplast, 500 mm höga, längs de fria kanterna mot köldbrygga (R-06).
8. Bilderna är förenklade: armering, fogar och mindre delar visas inte.

### Teckenförklaring

betong: bottenplatta, balkar, plintar, bjälklag Kub-väggarnas betongkärna
cellplast: väggarna och S100 under plattan cellplast S300: L-element, under balkar och plintar smyglist vid fönster och dörrar
kantisolering 30 och kantelement 500 plastfolie i våder med överlapp (schematiskt) stål: rör och fotplåtar

### Ritningar för betongarbetet

Ritning Innehåll
R-03 | Bärande system i betong, översikt i 3D
R-04 | Bottenplatta: plan, armering, sektioner
R-05 | Källarstomme: väggar, öppningar, rör
R-06 | Mellanbjälklag: plan, armering, sektioner

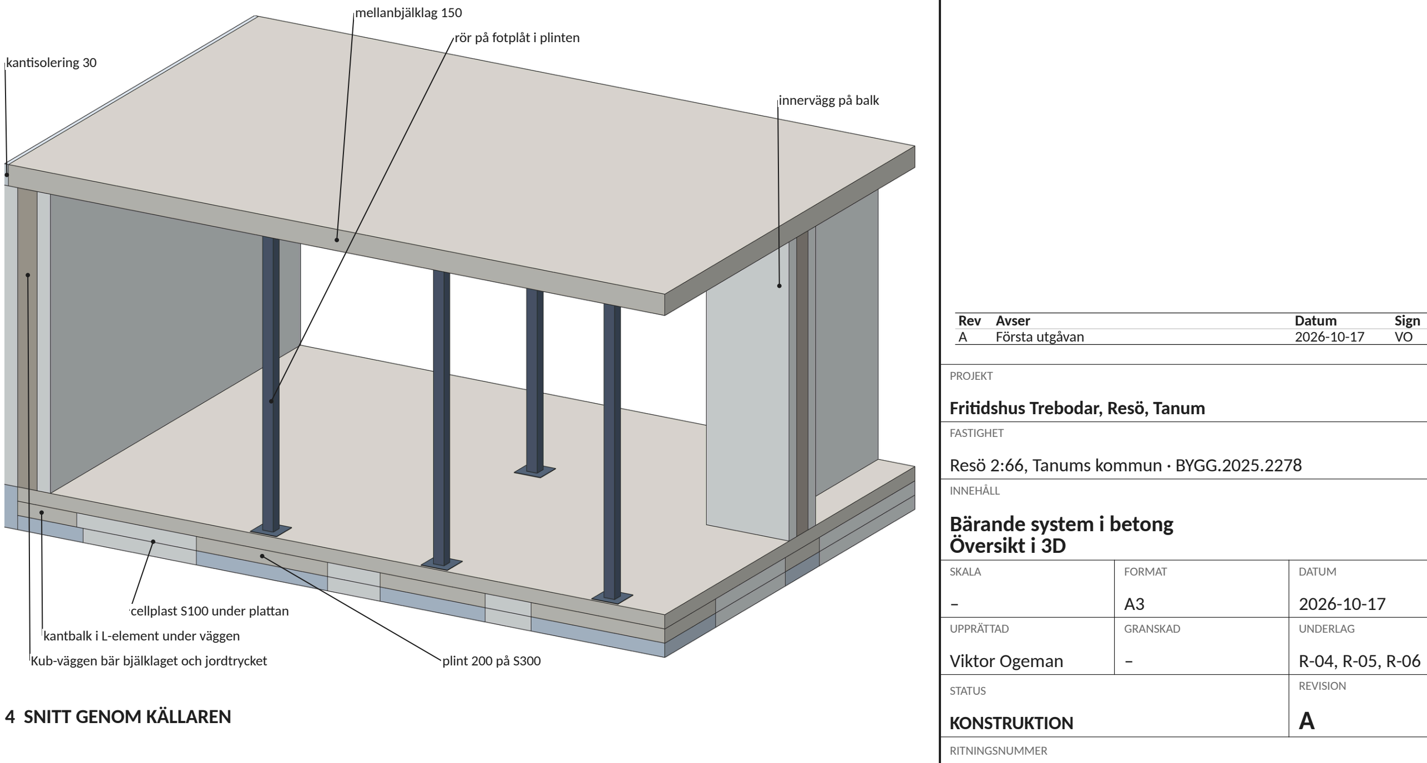
[picture p67: figure]
mellanbjälklag 150; Kub-väggen bär bjälklaget och jordtrycket; kantbalk i L-element under väggen; cellplast S100 under plattan; rör på fotplåt i plinten; plint 200 på S300; innervägg på balk; kantisolering 30; 4 SNITT GENOM KÄLLAREN; Rev Avser; Datum; Sign; Första utgåvan; PROJEKT; Fritidshus Trebodar, Resö, Tanum; FASTIGHET; INNEHÅLL Bärande system i betong Översikt i 3D; SKALA –; FORMAT A3; DATUM 2026-10-17; UPPRÄTTAD Viktor Ogeman; GRANSKAD –; UNDERLAG R-04, R-05, R-06; STATUS KONSTRUKTION; REVISION A; RITNINGSNUMMER

### Resö 2:66, Tanums kommun · BYGG.2025.2278

R-03.1

R-03.1 · Utan skala och mått
