vron/trebodar/ritningar/R-05 Källarstomme.pdf

AA

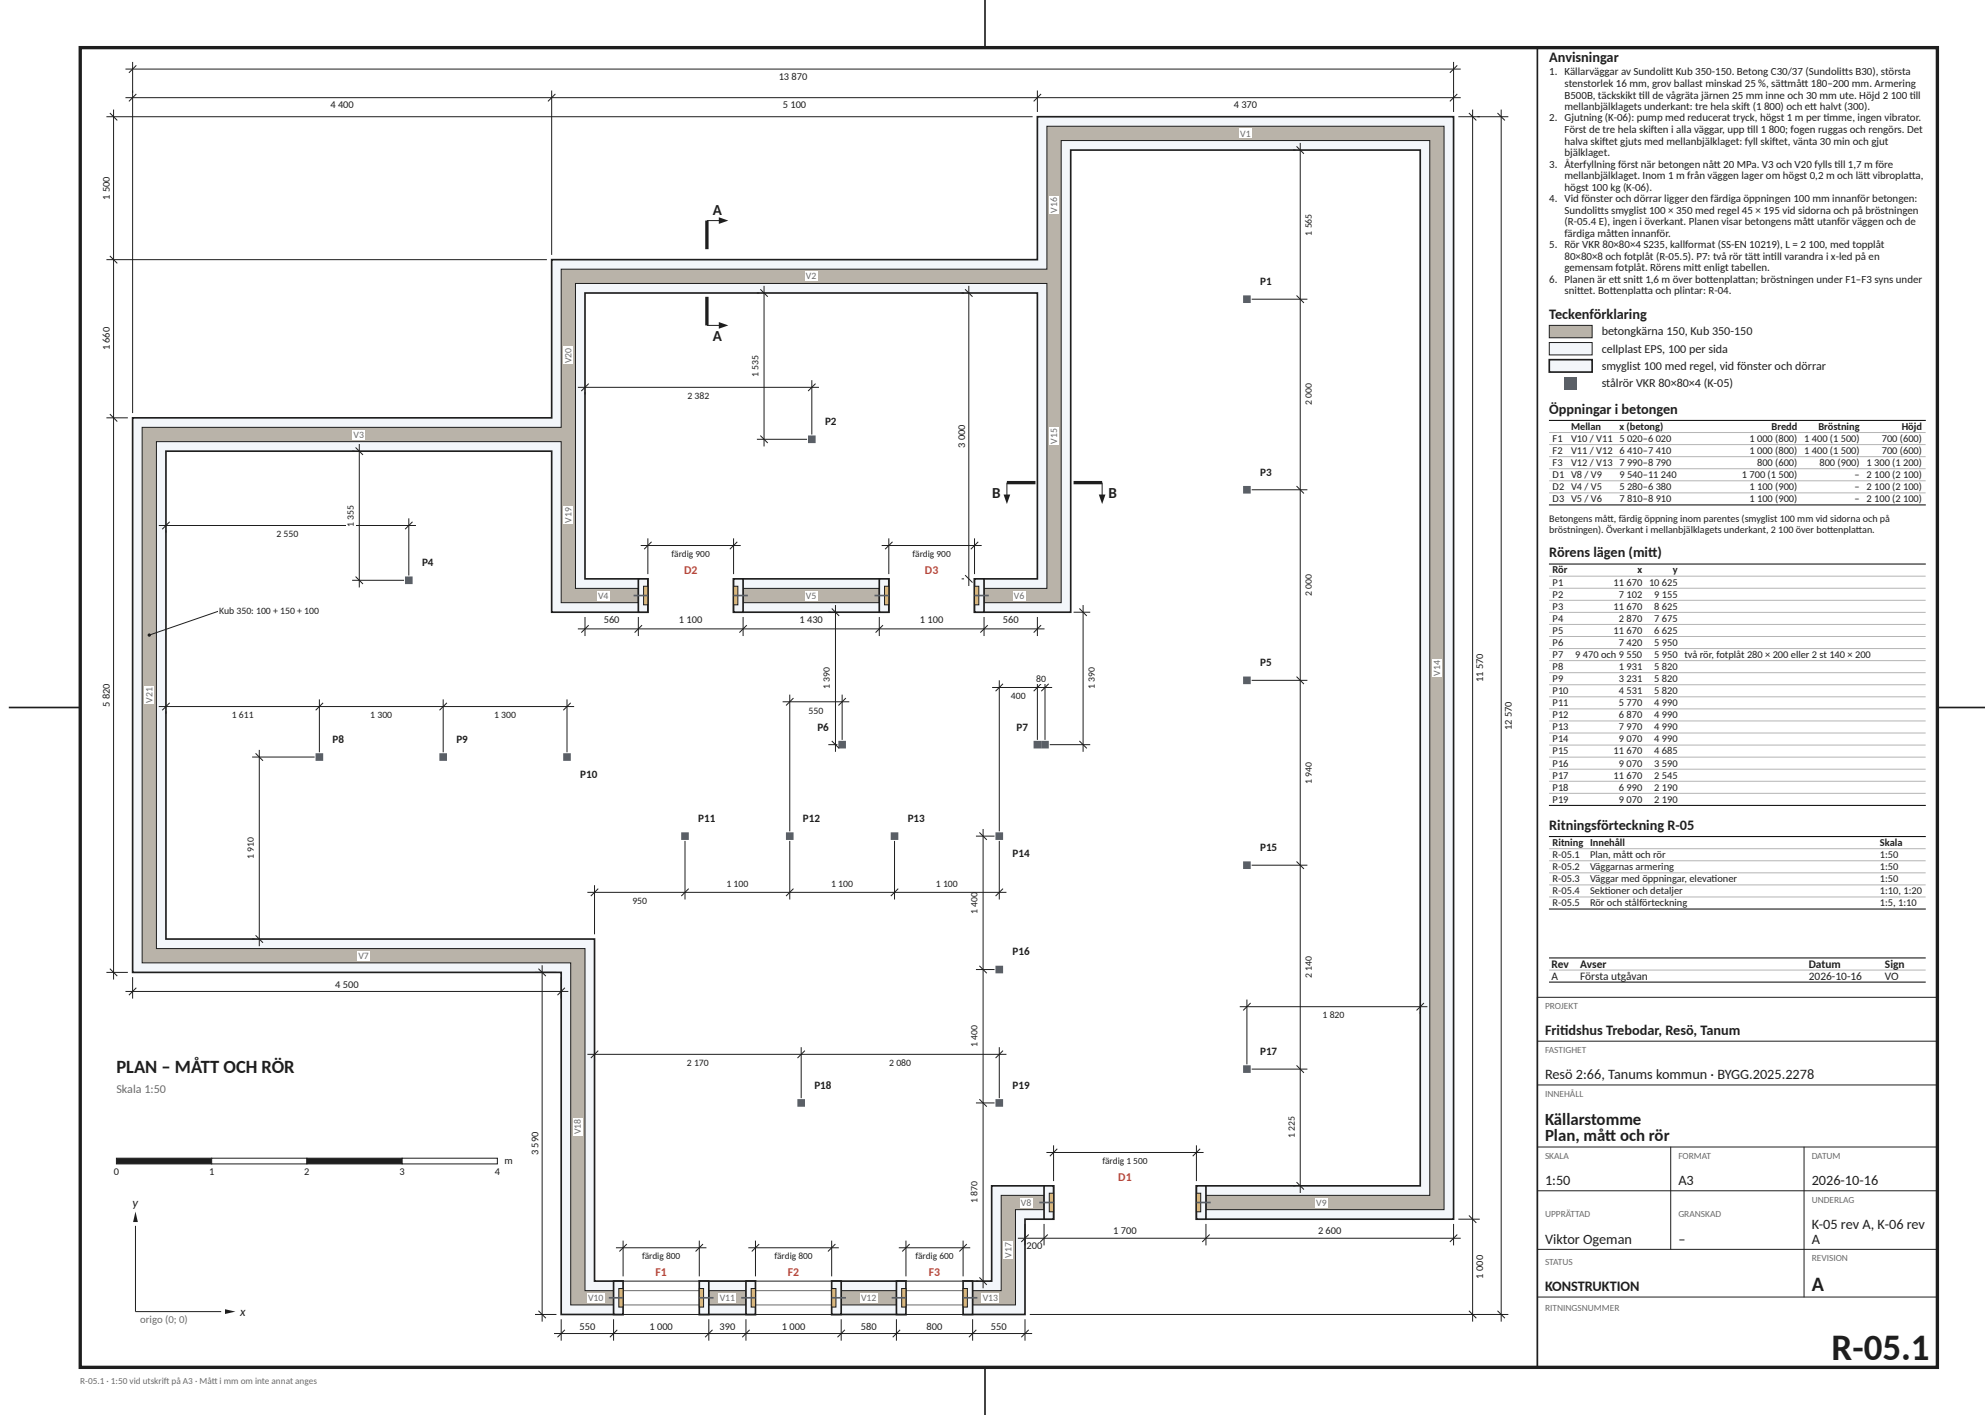
[picture p68: page 1]

Anvisningar
1. Källarväggar av Sundolitt Kub 350-150. Betong C30/37 (Sundolitts B30), största
stenstorlek 16 mm, grov ballast minskad 25 %, sättmått 180–200 mm. Armering
B500B, täckskikt till de vågräta järnen 25 mm inne och 30 mm ute. Höjd 2 100 till
mellanbjälklagets underkant: tre hela skift (1 800) och ett halvt (300).
2. Gjutning (K-06): pump med reducerat tryck, högst 1 m per timme, ingen vibrator.
Först de tre hela skiften i alla väggar, upp till 1 800; fogen ruggas och rengörs. Det
halva skiftet gjuts med mellanbjälklaget: fyll skiftet, vänta 30 min och gjut
bjälklaget.
3. Återfyllning först när betongen nått 20 MPa. V3 och V20 fylls till 1,7 m före
mellanbjälklaget. Inom 1 m från väggen lager om högst 0,2 m och lätt vibroplatta,
högst 100 kg (K-06).
4. Vid fönster och dörrar ligger den färdiga öppningen 100 mm innanför betongen:
Sundolitts smyglist 100 × 350 med regel 45 × 195 vid sidorna och på bröstningen
(R-05.4 E), ingen i överkant. Planen visar betongens mått utanför väggen och de
färdiga måtten innanför.
5. Rör VKR 80×80×4 S235, kallformat (SS-EN 10219), L = 2 100, med topplåt
80×80×8 och fotplåt (R-05.5). P7: två rör tätt intill varandra i x
gemensam fotplåt. Rörens mitt enligt tabellen.
6. Planen är ett snitt 1,6 m över bottenplattan; bröstningen under F1–F3 syns under
snittet. Bottenplatta och plintar: R-04.
Teckenförklaring

betongkärna 150, Kub 350-150
cellplast EPS, 100 per sida
smyglist 100 med regel, vid fönster och dörrar
stålrör VKR 80×80×4 (K-05)

Betongens mått, färdig öppning inom parentes (smyglist 100 mm vid sidorna och på
bröstningen). Överkant i mellanbjälklagets underkant, 2 100 över bottenplattan.
Rörens lägen (mitt)
Rör
Ritningsförteckning R-05

PROJEKT
Fritidshus Trebodar, Resö, Tanum

FASTIGHET
Resö 2:66, Tanums kommun · BYGG.2025.2278

PLAN – MÅTT OCH RÖR

INNEHÅLL
Källarstomme
Plan, mått och rör

SKALA 1:50 | FORMAT A3 | DATUM 2026 -10 -16

UPPRÄTTAD Viktor Ogeman | GRANSKAD – | UNDERLAG K-05 rev A, K -06 rev A

-05.1 · 1:50 vid utskrift på A3 · Mått i mm om inte annat anges

1. Vågräta järn: 2 Ø10 per skift, ett vid var yta, s600 i de två nedre skiften och s300 i de två översta, i alla väggar utom V3. Skarvlängd minst 500.
2. Lodräta järn Ø10: på insidan i ytterväggarna och i kärnans mitt i innerväggarna, delning enligt tabellen.
3. V3: Ø10 s300 i båda ytorna i hela höjden. V3 bär fyllningen innan mellanbjälklaget gjuts (byggskedet).
4. Hörn: vinkeljärn Ø10, 750 + 750, vid båda ytorna i varje lager, skarv 500 med de raka järnen. Anslutningar mot en genomgående vägg: vinkeljärn 900 + 750 genom kärnan och 750 längs den genomgående väggens bortre yta, där väggens egna järn skarvas 500 (R-05.4 C och D).
5. Öppningar: 2 Ø12 längs sidorna och under bröstningen, förankrade 600 förbi öppningen, och lodräta järn Ø10 s300 under bröstningarna. Över öppningarna är mellanbjälklaget (R-06).
6. Startjärn från bottenplattan: R-04. Vinkeljärn från väggarna till mellanbjälklaget (pos 14): R-06.
7. Lagren i höjdled: R-05.3 och sektionerna på R-05.4.

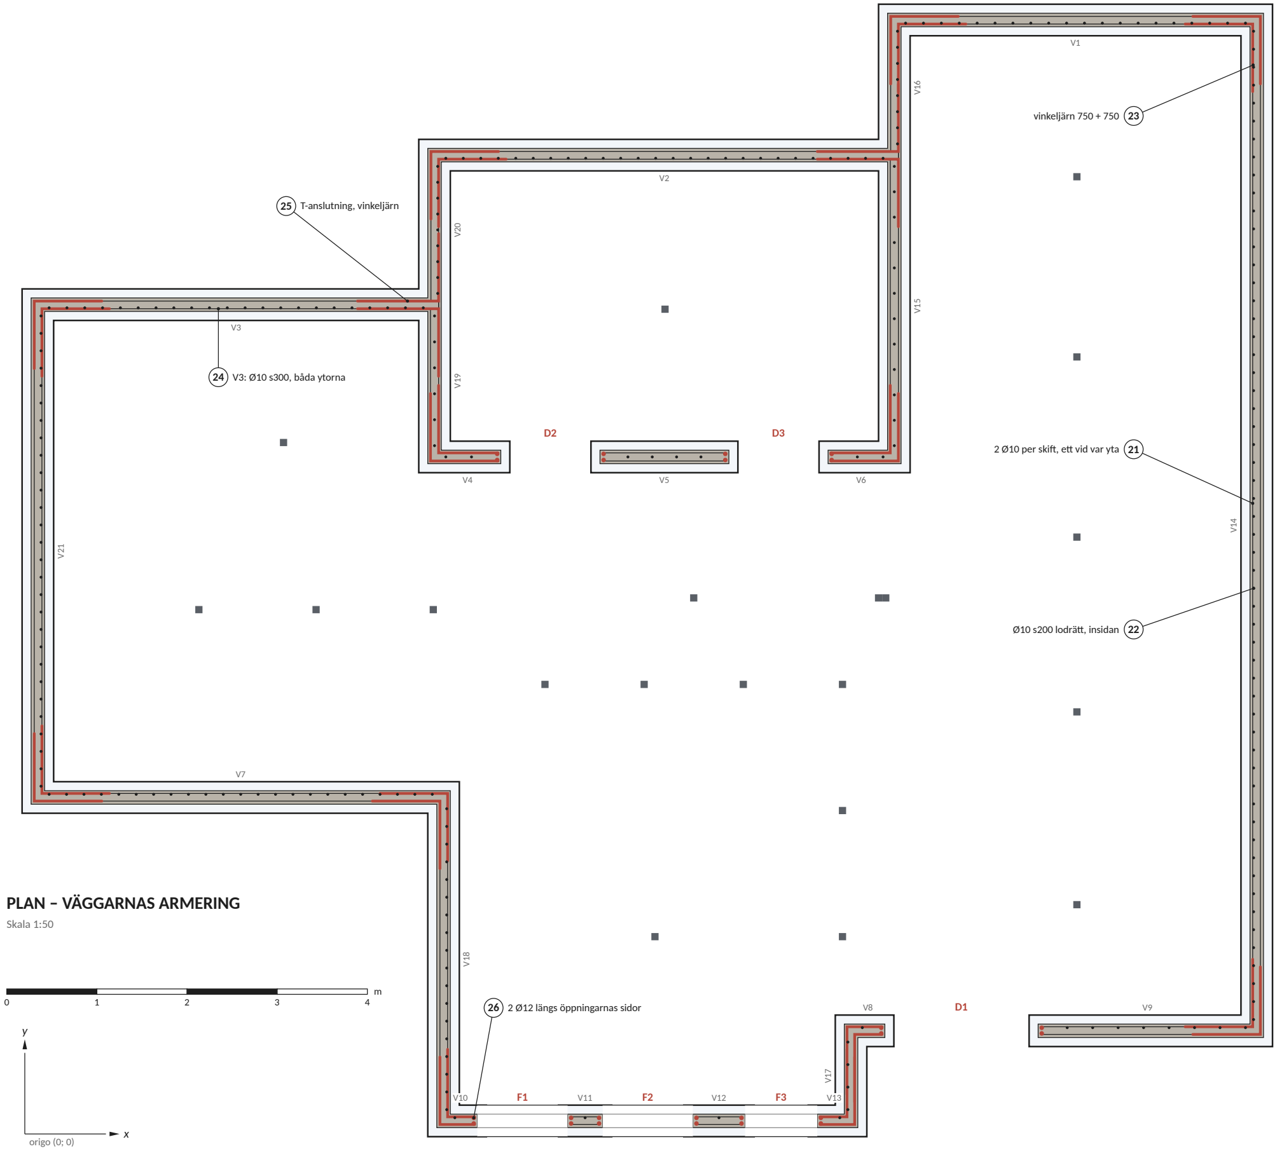
[picture p69: figure]
2 Ø10 per skift, ett vid var yta 21; Ø10 s200 lodrätt, insidan 22; vinkeljärn 750 + 750 23; 24 V3: Ø10 s300, båda ytorna; 25 T-anslutning, vinkeljärn; 26 2 Ø12 längs öppningarnas sidor; origo (0; 0); PLAN – VÄGGARNAS ARMERING; Skala 1:50

### Teckenförklaring

vågräta järn (planen visar ett lager) vinkeljärn i hörn och anslutningar lodräta järn Ø10 (tabellen)
2 Ø12 längs öppningarnas sidor
21 positionsnummer (stålförteckning R-05.5)

### Väggarnas armering

Väggar | Lodrätt (ytterväggar: insidan) Vågrätt
V1, V2, V7, V11, V14, V16,
V18, V20, V21
| Ø10 s200 (22) | 2 Ø10/skift, s600/s300 (21)
V8, V9, V10, V12, V13, V17 Ø10 s300 (22) | 2 Ø10/skift, s600/s300 (21)
V3 | Ø10 s200 (22) | Ø10 s300 båda ytorna (24)
V4, V5, V6, V15, V19 | Ø10 s300 i mitten (22) | 2 Ø10/skift, s600/s300 (21)
Rev Avser | Datum | Sign
A | Första utgåvan | 2026-10-16 | VO

PROJEKT

### Fritidshus Trebodar, Resö, Tanum

FASTIGHET

### Resö 2:66, Tanums kommun · BYGG.2025.2278

INNEHÅLL

## Källarstomme Väggarnas armering

SKALA 1:50 | FORMAT A3 | DATUM 2026-10-16
UPPRÄTTAD Viktor Ogeman | GRANSKAD – | UNDERLAG K-05 rev A, K-06 rev A
STATUS KONSTRUKTION | | REVISION A

R-05.2

R-05.2 · 1:50 vid utskrift på A3 · Mått i mm om inte annat anges

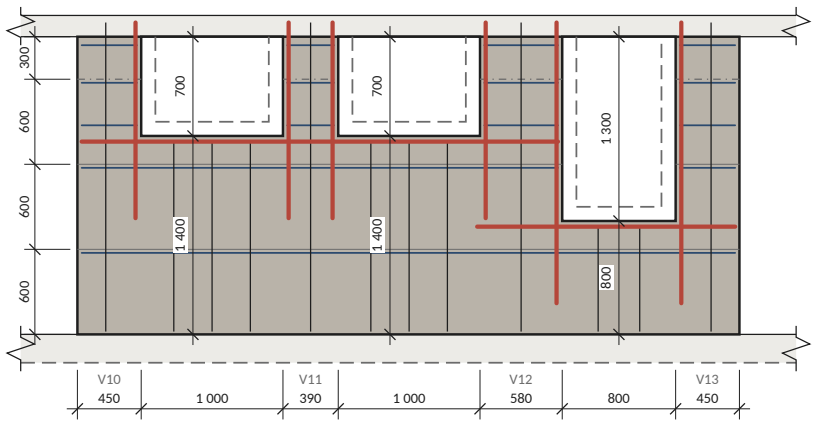
[picture p70: figure]

### FASADEN MED F1–F3 (V10–V13), sedd utifrån

Skala 1:50

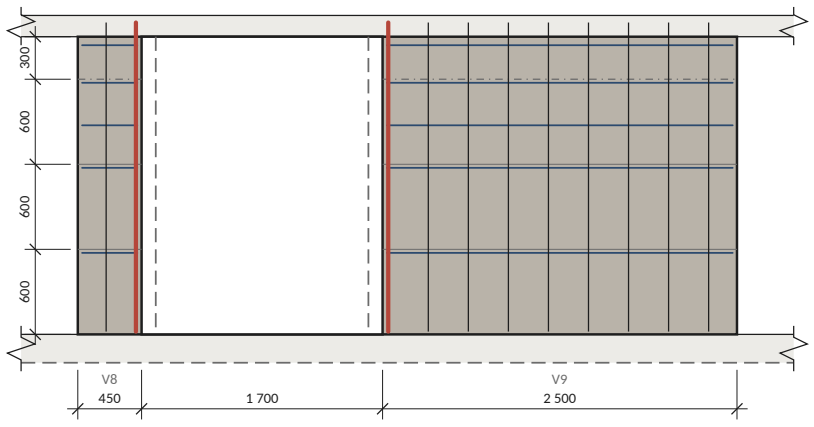
[picture p71: figure]

### V8 OCH V9 MED D1, sedd utifrån

Skala 1:50

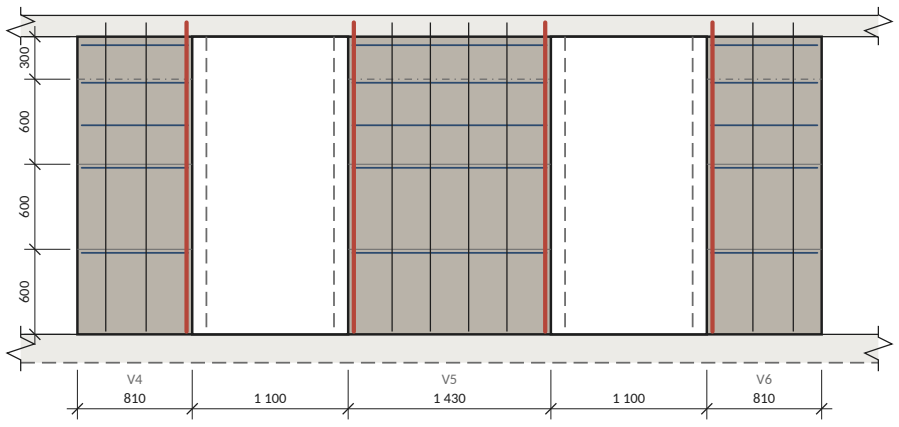
[picture p72: figure]

### V4–V6 MED D2 OCH D3, sedd från söder

Skala 1:50

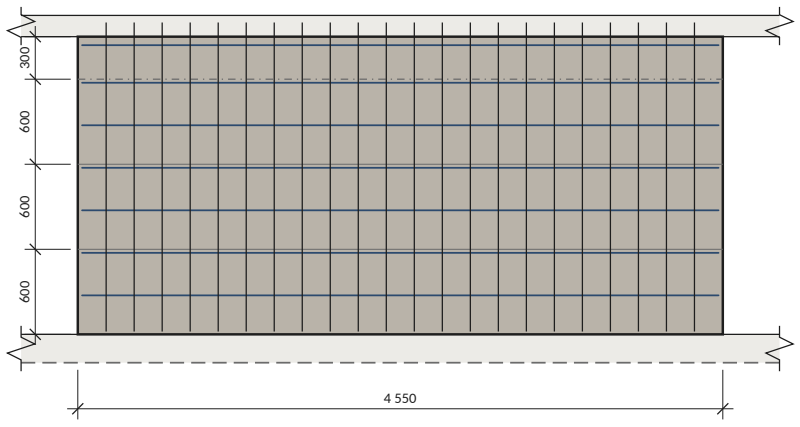
[picture p73: figure]

### V3, sedd inifrån (från söder)

Skala 1:50

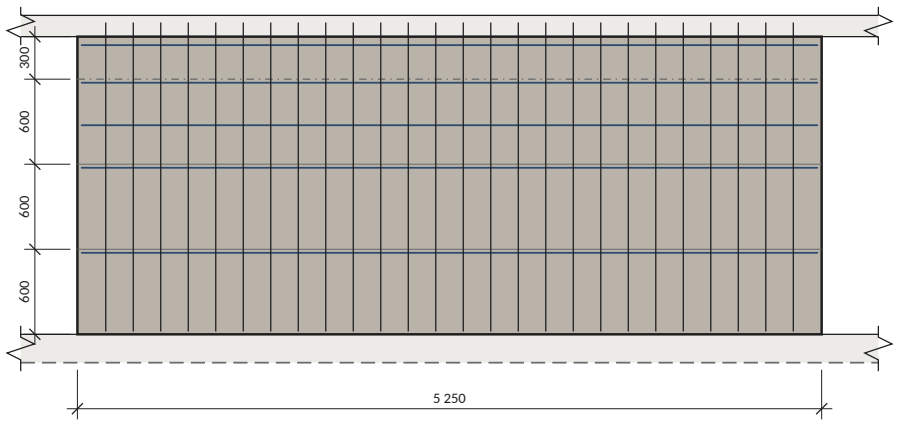
[picture p74: figure]

### V2, sedd inifrån (från söder): typisk yttervägg

Skala 1:50

1. Elevationerna visar betongkärnan. Den färdiga öppningen (streckad) ligger 100 mm innanför betongen: Sundolitts smyglist med regel vid sidorna och på bröstningen (R-05.4 E). Ingen smyglist i överkant, som är mellanbjälklagets underkant.
2. Vågräta järn: ett vid var yta i varje lager, på höjderna 575, 1 175, 1 475, 1 775, 2 040. V3: s300 i hela höjden, 275, 575, 875, 1 175, 1 475, 1 775, 2 040. Järnen ligger i bindarnas hållare; höjderna kan avvika med elementens hållare.
3. Lodräta järn: Ø10, L = 2 200, i ytterväggarna på insidan, högst s200 eller s300 enligt R-05.2, från 50 mm innanför den vinkelräta väggens kärna fram till öppningarnas järn. Under bröstningarna Ø10 högst s300 upp till bröstningens järn. Innerväggarna: Ø10 s300 i kärnans mitt, skarvade med startjärnen (R-04), som inte är ritade.
4. Öppningar: 2 Ø12 längs sidorna.
5. Mått i mm, höjder från bottenplattans överkant. Plan R-05.1, armering i plan R-05.2, stålförteckning R-05.5.

### Teckenförklaring

betongkärna 150 (Kub 350-150)
vågräta järn, ett vid var yta (21; V3: 24) lodräta järn Ø10 (22, 28)
2 Ø12 vid öppningarna (26, 27)
gjutfog, 1 800
färdig öppning, smyglist 100 vid sidorna och bröstningen
Rev Avser | Datum | Sign
A | Första utgåvan | 2026-10-16 | VO

PROJEKT

### Fritidshus Trebodar, Resö, Tanum

FASTIGHET

### Resö 2:66, Tanums kommun · BYGG.2025.2278

INNEHÅLL

## Källarstomme Väggar med öppningar, elevationer

SKALA 1:50 | FORMAT A3 | DATUM 2026-10-16
UPPRÄTTAD Viktor Ogeman | GRANSKAD – | UNDERLAG K-05 rev A, K-06 rev A
STATUS KONSTRUKTION | | REVISION A

R-05.3

R-05.3 · 1:50 vid utskrift på A3 · Mått i mm om inte annat anges

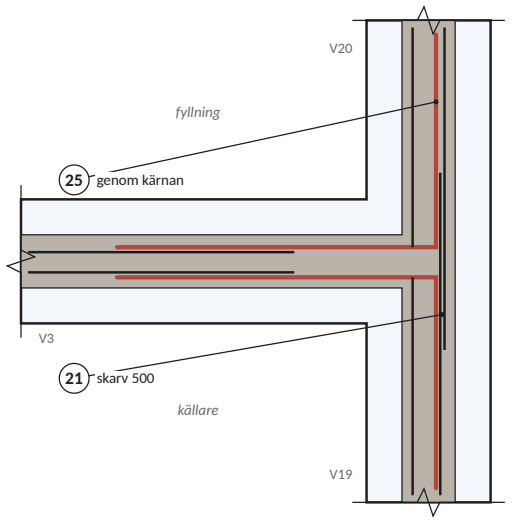
[picture p75: figure]
fyllning; källare; 25 genom kärnan; 21 skarv 500
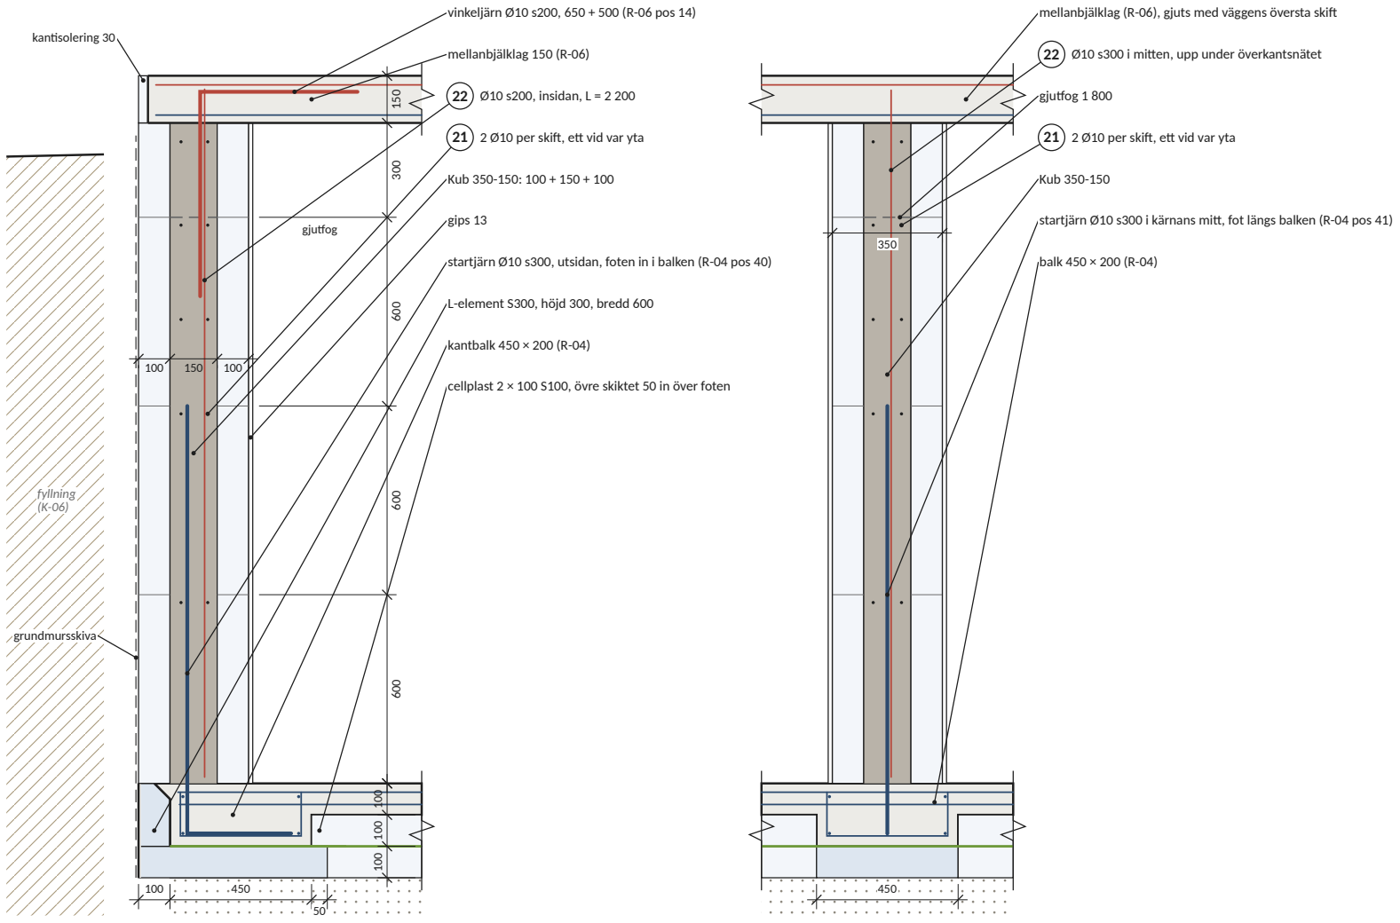
[picture p76: figure]
gjutfog; kantisolering 30; fyllning (K-06); grundmursskiva; mellanbjälklag 150 (R-06); 22 Ø10 s200, insidan, L = 2 200; 21 2 Ø10 per skift, ett vid var yta; Kub 350-150: 100 + 150 + 100; gips 13; L-element S300, höjd 300, bredd 600; kantbalk 450 × 200 (R-04); gjutfog 1 800; Kub 350-150; balk 450 × 200 (R-04)

vinkeljärn Ø10 s200, 650 + 500 (R-06 pos 14)

startjärn Ø10 s300, utsidan, foten in i balken (R-04 pos 40)

cellplast 2 × 100 S100, övre skiktet 50 in över foten

## SEKTION A–A Yttervägg mot jord (V2)

Skala 1:20

mellanbjälklag (R-06), gjuts med väggens översta skift

### 22 Ø10 s300 i mitten, upp under överkantsnätet

startjärn Ø10 s300 i kärnans mitt, fot längs balken (R-04 pos 41)

## SEKTION B–B Innervägg (V15)

Skala 1:20

### DETALJ D V3 mot V19/V20 i plan

Skala 1:20

Samma vid V2 mot V15/V16.

750

500
ute

inne

23 750 + 750, båda ytorna

### 21 skarv 500

### DETALJ C Yttre hörn i plan

Skala 1:20

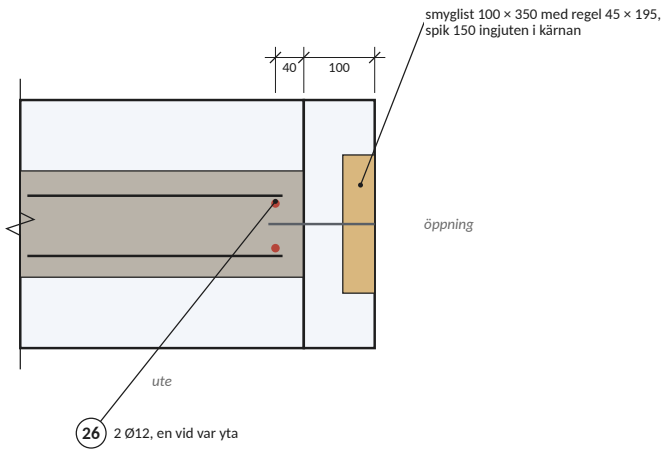
[picture p77: figure]
öppning; smyglist 100 × 350 med regel 45 × 195, spik 150 ingjuten i kärnan; ute; 26 2 Ø12, en vid var yta

### DETALJ E Öppning F1: smyg i plan och bröstning

Skala 1:10

40 100

27 2 Ø12

### 28 Ø10 s300

bröstning: betong 1 400, färdig 1 500

ute

inne

regel och smyglist med
inspektionshål
1. Elementen staplas i förband med armeringen i bindarnas hållare och stagas enligt Sundolitts anvisning. I hörn och anslutningar skärs cellplasten bort så att kärnorna går ihop. Öppningar enligt Sundolitt: smyglist Kub U17 vid sidorna och bröstningen (inte i överkant, som är mellanbjälklagets underkant), med regel 45 × 195 i spåret, fäst med grov spik 150 mm (förborra) som gjuts in i betongen, minst tre per sida och fler vid större öppningar. Smyglisterna stagas med tvärgående stag lodrätt och vågrätt. Bröstningens regel och smyglist får inspektionshål så att fyllningen kan kontrolleras (detalj E).
2. Material, gjutning och återfyllning samt plan: R-05.1. Armering R-05.2, elevationer R-05.3, rör och stålförteckning R-05.5.

### Teckenförklaring

betongkärna, Kub 350-150
betong, bottenplatta och mellanbjälklag cellplast
cellplast S300 (L-element, under balkar) plastfolie i hela ytan (R-04)
vågräta järn Ø10 (21)
vinkeljärn, lodräta järn i väggen
startjärn och armering i bottenplattan (R-04)
Rev Avser | Datum | Sign
A | Första utgåvan | 2026-10-16 | VO

PROJEKT

### Fritidshus Trebodar, Resö, Tanum

FASTIGHET

### Resö 2:66, Tanums kommun · BYGG.2025.2278

INNEHÅLL

## Källarstomme Sektioner och detaljer

SKALA 1:10, 1:20 | FORMAT A3 | DATUM 2026-10-16
UPPRÄTTAD Viktor Ogeman | GRANSKAD – | UNDERLAG K-05 rev A, K-06 rev A
STATUS KONSTRUKTION | | REVISION A

R-05.4

R-05.4 · 1:10, 1:20 vid utskrift på A3 · Mått i mm om inte annat anges

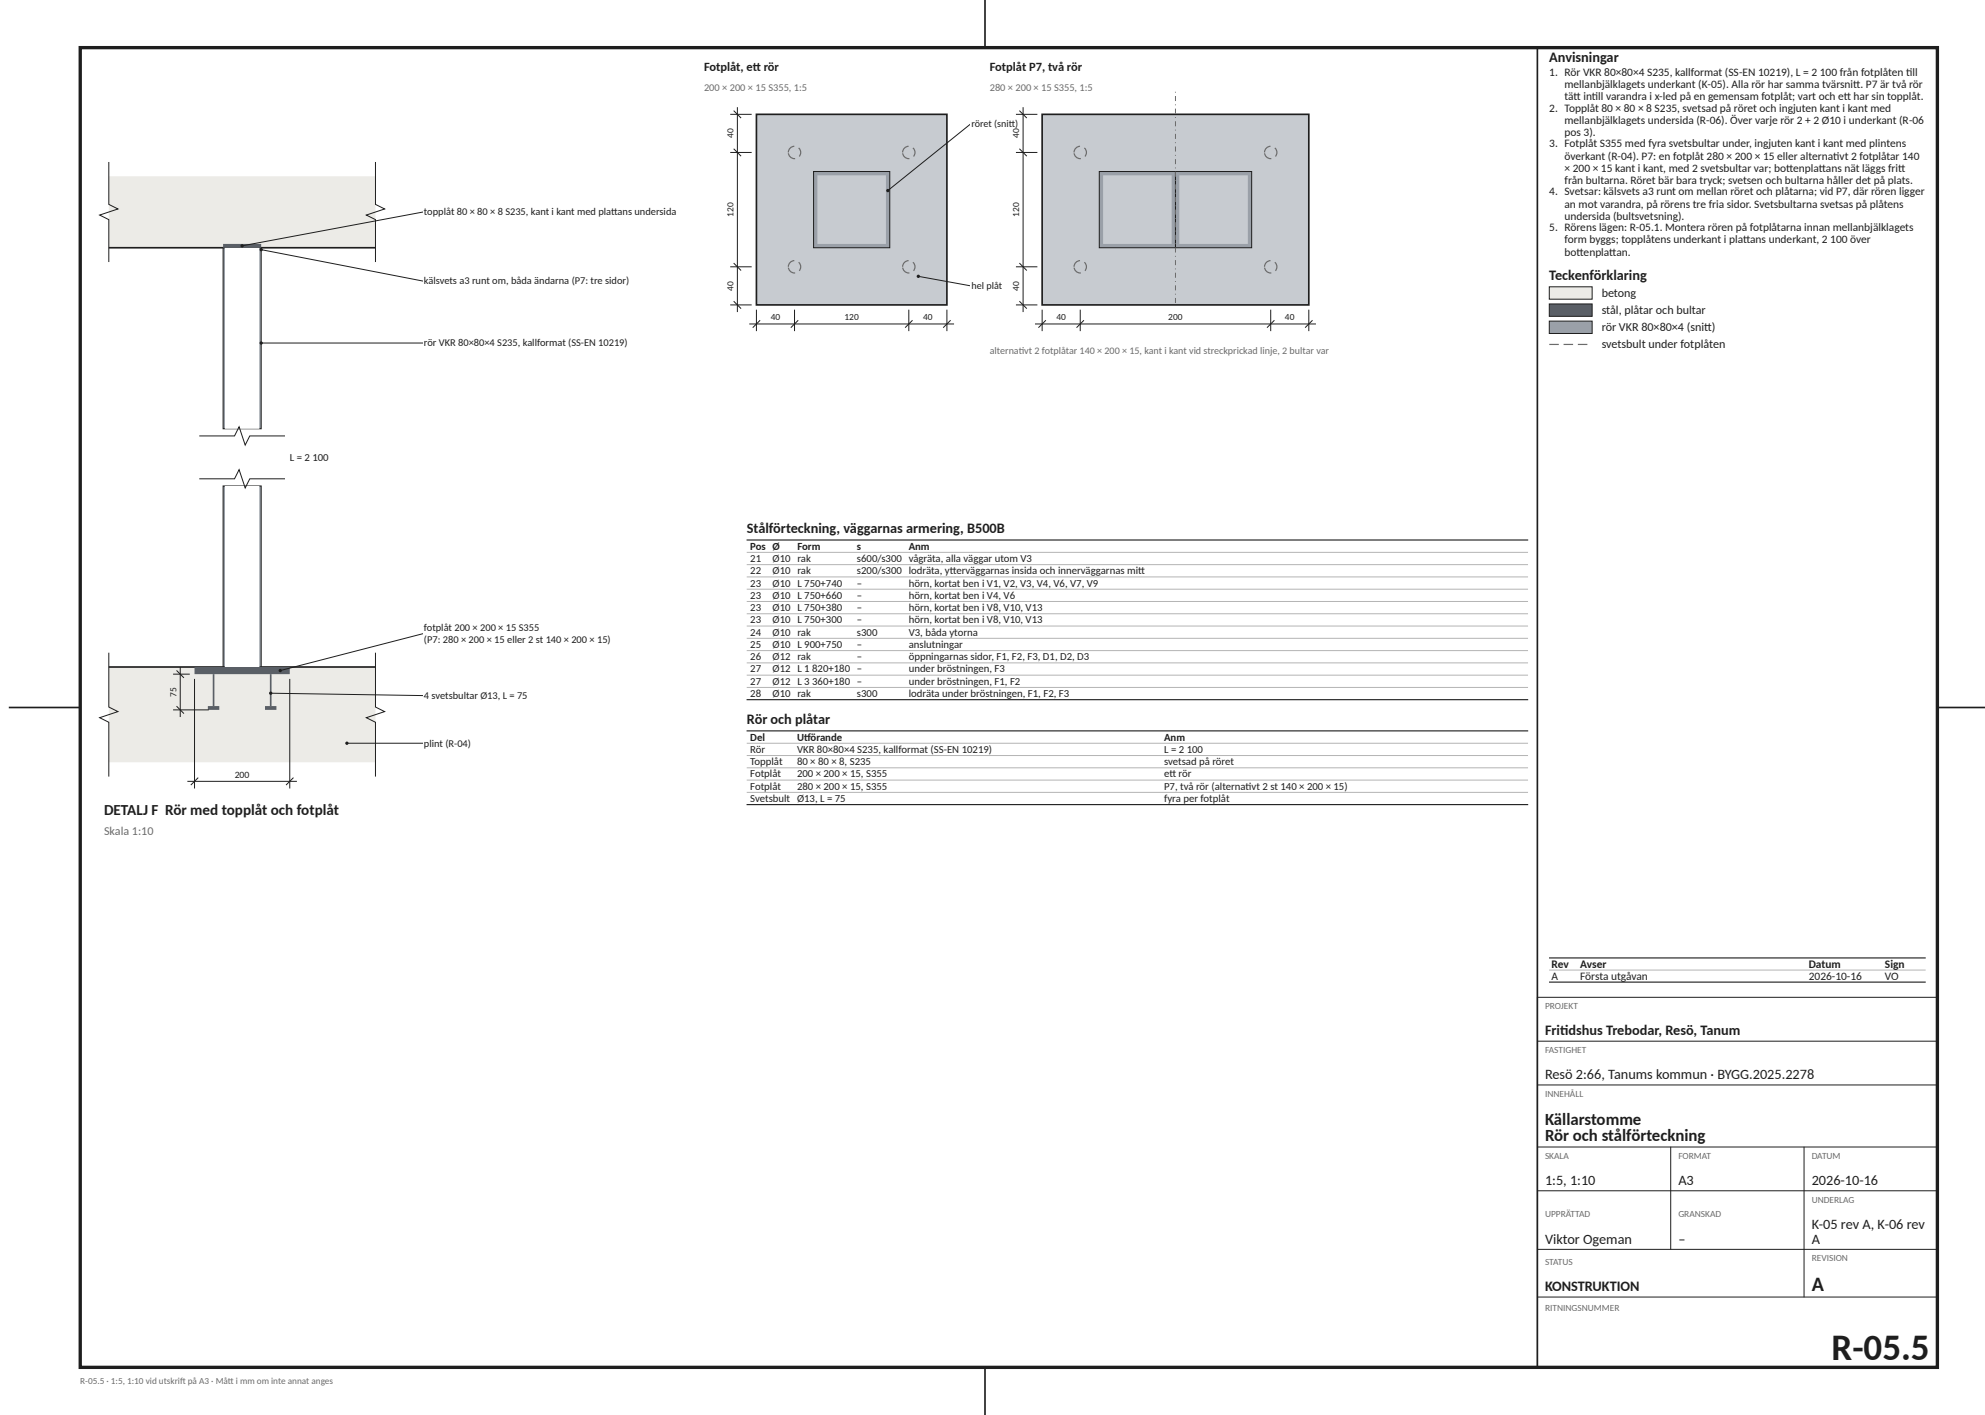
[picture p78: page 5]
fotplåt 200 × 200 × 15 S355 (P7: 280 × 200 × 15 eller 2 st 140 × 200 × 15); 4 svetsbultar Ø13, L = 75; plint (R-04); Skala 1:10; röret (snitt); hel plåt; Pos Ø; Form; Anm; 21 Ø10 rak; s600/s300 vågräta, alla väggar utom V3; 22 Ø10 rak; s200/s300 lodräta, ytterväggarnas insida och innerväggarnas mitt; hörn, kortat ben i V1, V2, V3, V4, V6, V7, V9; hörn, kortat ben i V4, V6; hörn, kortat ben i V8, V10, V13; 24 Ø10 rak; V3, båda ytorna; anslutningar; 26 Ø12 rak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

Fotplåt, ett rör

Fotplåt P7, två rör

1. Rör VKR 80×80×4 S235, kallformat (SS-EN 10219), L = 2 100 från fotplåten till
mellanbjälklagets underkant (K-05). Alla rör har samma tvärsnitt. P7 är två rör
tätt intill varandra i x-led på en gemensam fotplåt; vart och ett har sin topplåt.
2. Topplåt 80 × 80 × 8 S235, svetsad på röret och ingjuten kant i kant med
mellanbjälklagets undersida (R-06). Över varje rör 2 + 2 Ø10 i underkant (R-06
pos 3).
3. Fotplåt S355 med fyra svetsbultar under, ingjuten kant i kant med plintens
överkant (R-04). P7: en fotplåt 280 × 200 × 15 eller alternativt 2 fotplåtar 140
× 200 × 15 kant i kant, med 2 svetsbultar var; bottenplattans nät läggs fritt
från bultarna. Röret bär bara tryck; svetsen och bultarna håller det på plats.
4. Svetsar: kälsvets a3 runt om mellan röret och plåtarna; vid P7, där rören ligger
an mot varandra, på rörens tre fria sidor. Svetsbultarna svetsas på plåtens
undersida (bultsvetsning).
5. Rörens lägen: R-05.1. Montera rören på fotplåtarna innan mellanbjälklagets
form byggs; topplåtens underkant i plattans underkant, 2 100 över
bottenplattan.
Teckenförklaring

topplåt 80 × 80 × 8 S235, kant i kant med plattans undersida

kälsvets a3 runt om, båda ändarna (P7: tre sidor)

betong
stål, plåtar och bultar
rör VKR 80×80×4 (snitt)
svetsbult under fotplåten

rör VKR 80×80×4 S235, kallformat (SS-EN 10219)

alternativt 2 fotplåtar 140 × 200 × 15, kant i kant vid streckprickad linje, 2 bultar var

Stålförteckning, väggarnas armering, B500B

Rör och plåtar

DETALJ F Rör med topplåt och fotplåt

PROJEKT
Fritidshus Trebodar, Resö, Tanum

FASTIGHET
Resö 2:66, Tanums kommun · BYGG.2025.2278

INNEHÅLL
Källarstomme
Rör och stålförteckning

SKALA 1:5, 1:10 | FORMAT A3 | DATUM 2026-10-16

UPPRÄTTAD Viktor Ogeman | GRANSKAD – | UNDERLAG K-05 rev A, K-06 rev A

STATUS KONSTRUKTION | | REVISION A

R-05.5 · 1:5, 1:10 vid utskrift på A3 · Mått i mm om inte annat anges
