vron/trebodar/ritningar/R-00 Bärande system i betong.pdf

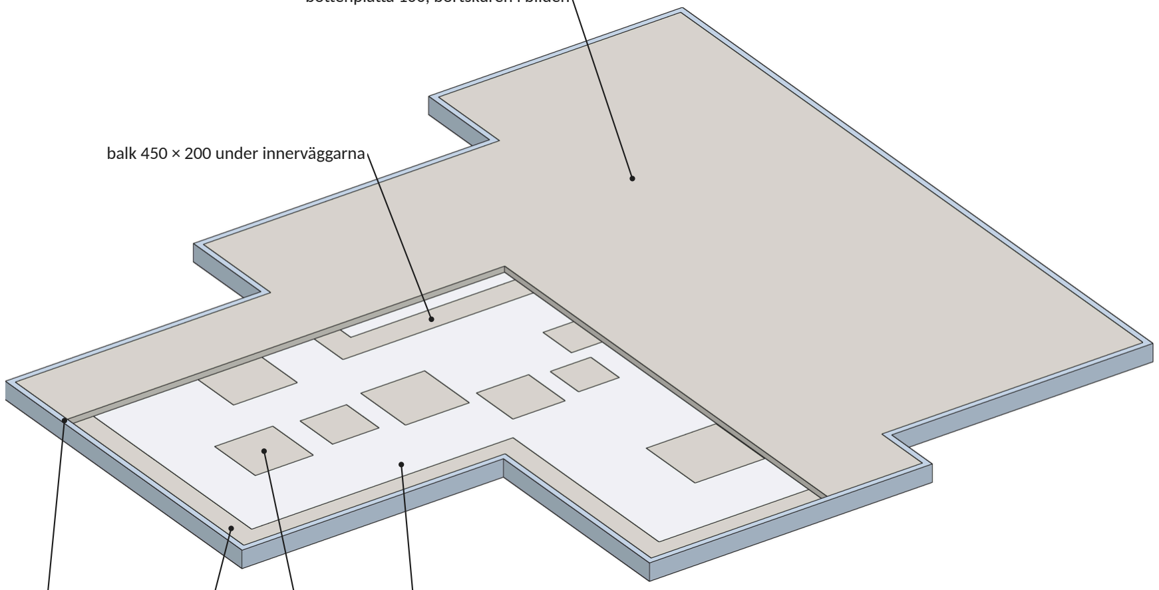
[picture p79: figure]
balk 450 × 200 under innerväggarna

L-element S300 längs hela kanten kantbalk 450 × 200 under ytterväggarna

plint under varje rör, fotplåt i överkant

cellplast S100, S300 under balkar och plintar bottenplatta 100, bortskuren i bilden

## 1 BOTTENPLATTA (R-05)

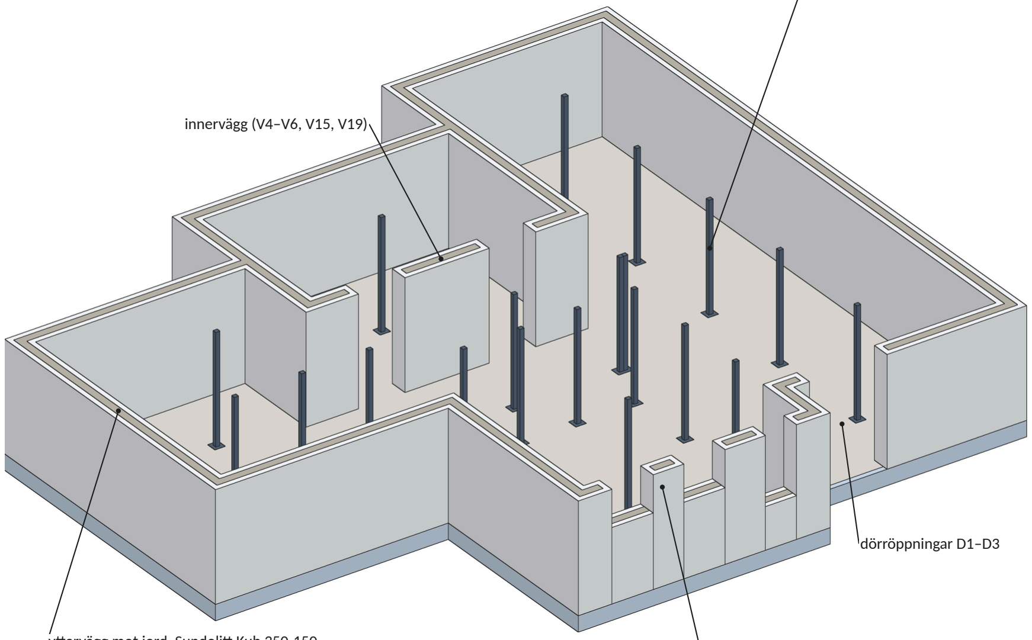
[picture p80: figure]
innervägg (V4–V6, V15, V19); dörröppningar D1–D3

yttervägg mot jord, Sundolitt Kub 350-150 stålrör VKR 80 × 80 på fotplåt i plinten (P1–P19)

fasad med fönster F1–F3: pelare och bröstningar

## 2 KÄLLARVÄGGAR OCH RÖR (R-04)

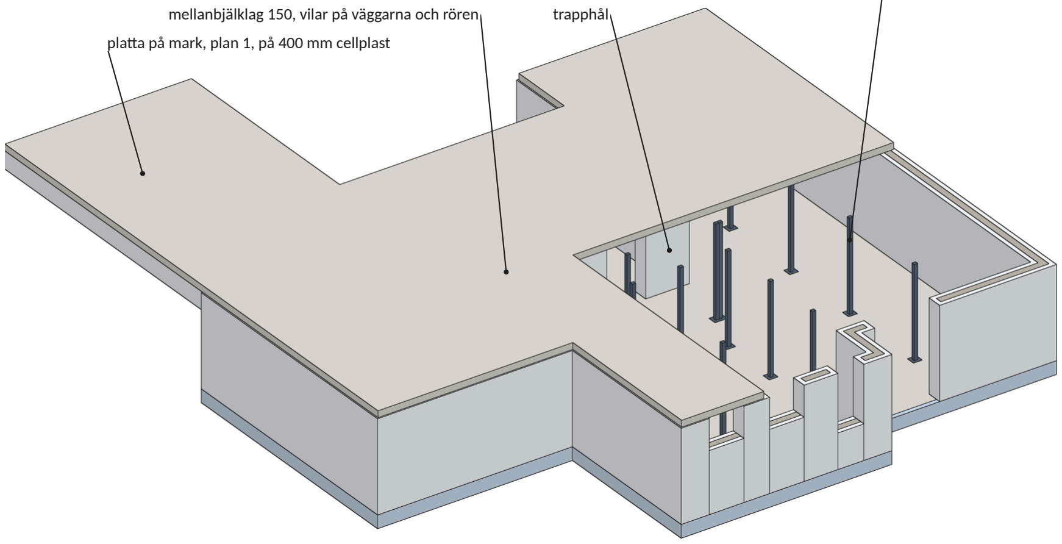
[picture p81: figure]
trapphål

mellanbjälklag 150, vilar på väggarna och rören

platta på mark, plan 1, på 400 mm cellplast

rören bär bjälklaget med topplåt i plattans undersida

## 3 MELLANBJÄLKLAG (R-03)

mellanbjälklag 150

Kub-väggen bär bjälklaget och jordtrycket

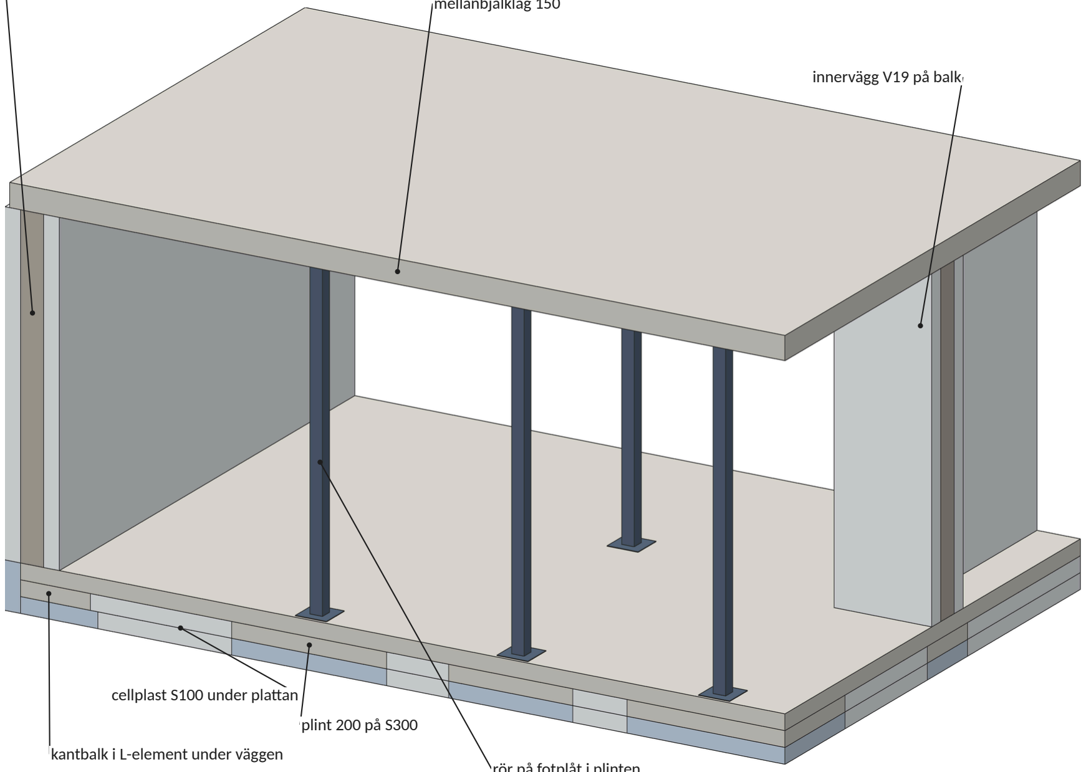
[picture p82: figure]
kantbalk i L-element under väggen; cellplast S100 under plattan; plint 200 på S300; innervägg V19 på balk

rör på fotplåt i plinten

## 4 SNITT GENOM KÄLLARENS VÄSTRA DEL

### Bärande system

1. Bilderna visar betongarbetets bärande delar i 3D, i den ordning de byggs. Inga mått: mått och utförande på R-03 (mellanbjälklag), R-04 (källarstomme) och R-05 (bottenplatta).
2. Mellanbjälklaget, 150 mm, bär plan 1 och vilar på källarväggarna och på stålrören P1–P19. Över fyllningen norr om källaren ligger det som platta på mark på 400 mm cellplast (K-05).
3. Källarväggarna av Sundolitt Kub 350-150 bär bjälklaget och jordtrycket; ytterväggarna hålls i toppen av bjälklaget och i botten av bottenplattan. Fasaden mot söder har fönster F1–F3 mellan pelare (K-06).
4. Rören står på fotplåtar som gjuts in i plintarnas överkant. Väggarna står på kantbalken i L-elementen och på balkarna under innerväggarna.
5. Bottenplattan, 100 mm, gjuts i en gjutning med kantbalkarna, balkarna och plintarna. De fördelar lasten på cellplasten, S300 under balkar och plintar och S100 under plattan, som ligger på makadam på sprängt berg (K-06).
6. Bilderna är förenklade: armering, fogar, smyglister och mindre delar visas inte.

### Teckenförklaring

betong: bottenplatta, balkar, plintar, bjälklag
Kub-väggarnas betongkärna
cellplast: väggarna och S100 under plattan cellplast S300: L-element, under balkar och plintar stål: rör och fotplåtar
Rev Avser | Datum | Sign
A | Första utgåvan | 2026-10-17 | VO

PROJEKT

### Fritidshus Trebodar, Resö, Tanum

FASTIGHET

### Resö 2:66, Tanums kommun · BYGG.2025.2278

INNEHÅLL

## Bärande system i betong Översikt i 3D

SKALA – | FORMAT A3 | DATUM 2026-10-17
UPPRÄTTAD Viktor Ogeman | GRANSKAD – | UNDERLAG R-03, R-04, R-05
STATUS KONSTRUKTION | | REVISION A

RITNINGSNUMMER
R-00.1

R-00.1 · Utan skala och mått
