vron/trebodar/renderingar/kameraplan.png

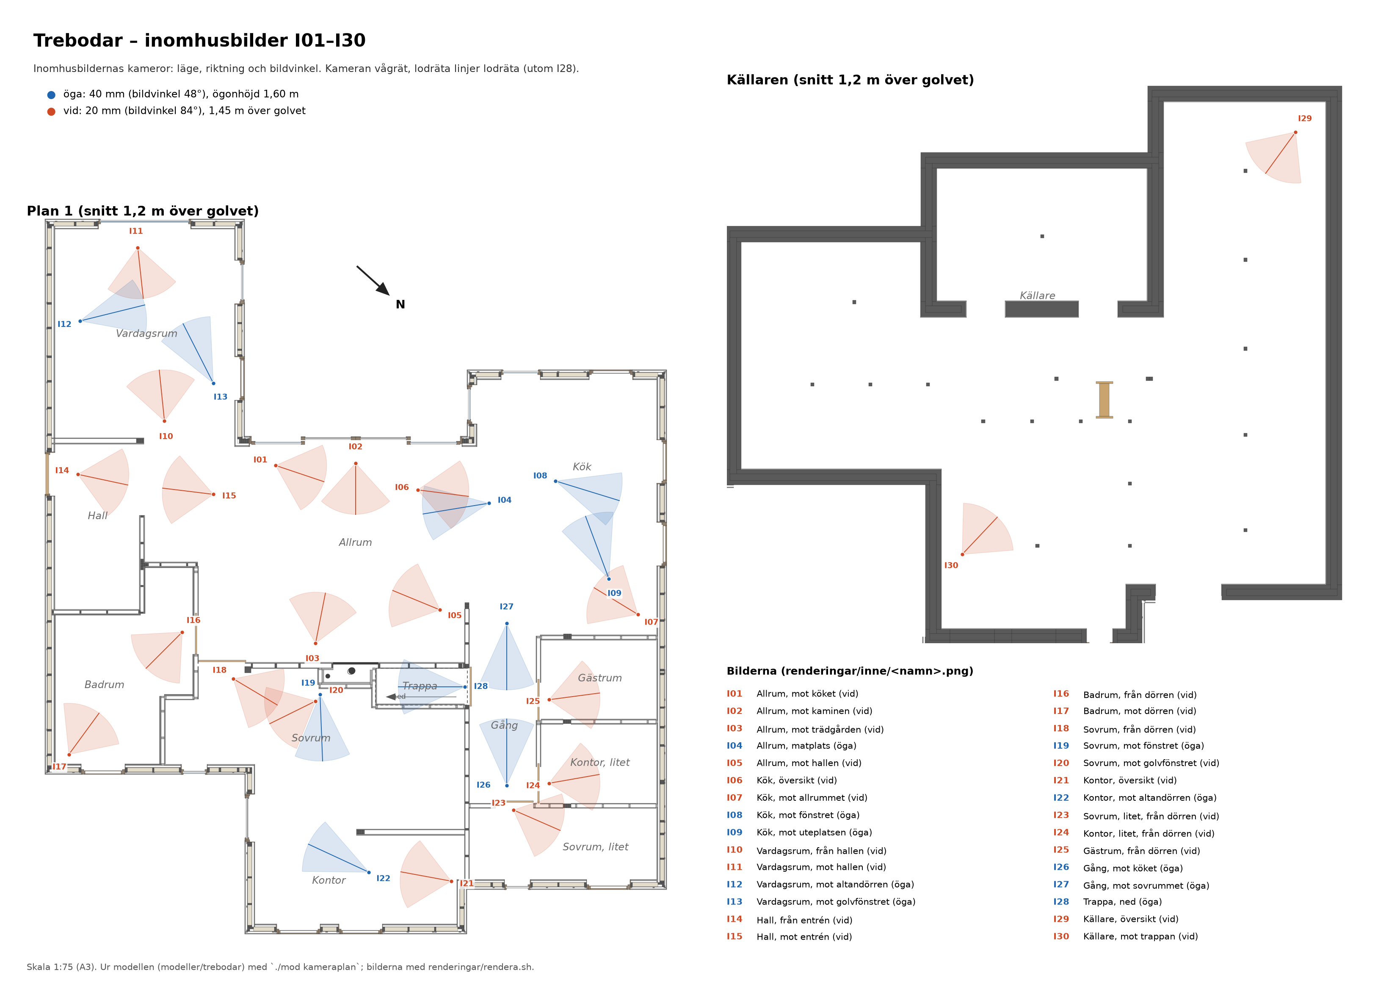
renderingar/kameraplan.png
