vron/trebodar/modeller/balkar/NB5.step

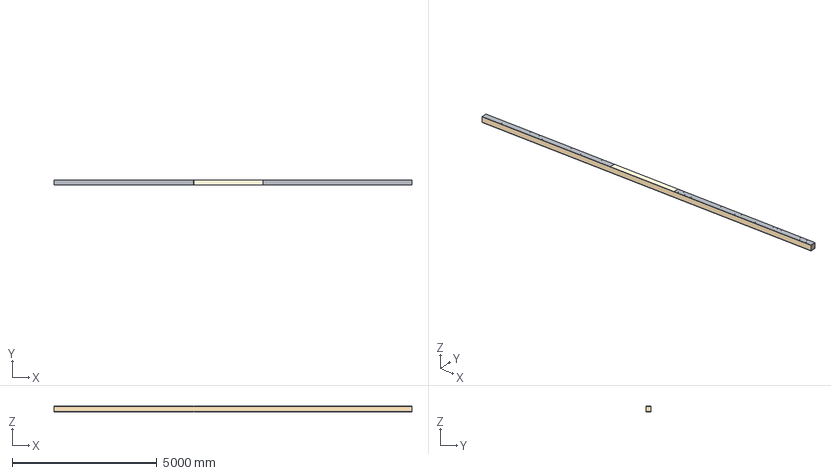
[picture p89: CAD file, 2026-11-13]
modeller/balkar/NB5.step
12370.0 x 190.0 x 200.0 mm
NB5 limtra GL30c 190x180
NB5-1-U
NB5-1-O
NB5-2-U
NB5-2-O
NB5 distansregel 1-U
NB5 distansregel 1-O
