vron/trebodar/modeller/balkplattor/NB5-2-U.step

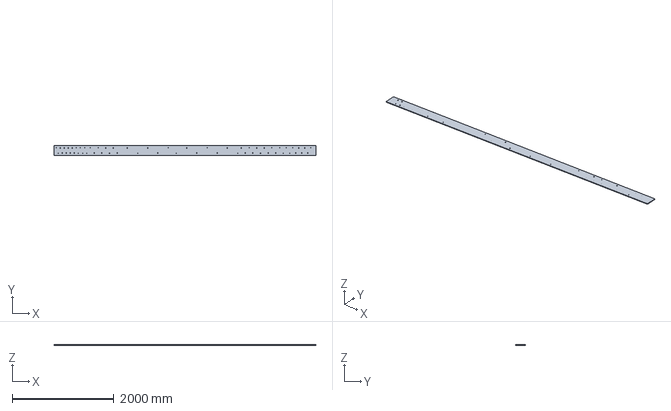
[picture p90: CAD file, 2026-11-13]
modeller/balkplattor/NB5-2-U.step
5145.0 x 190.0 x 10.0 mm
