vron/trebodar/modeller/referens/trebodar-onshape.step

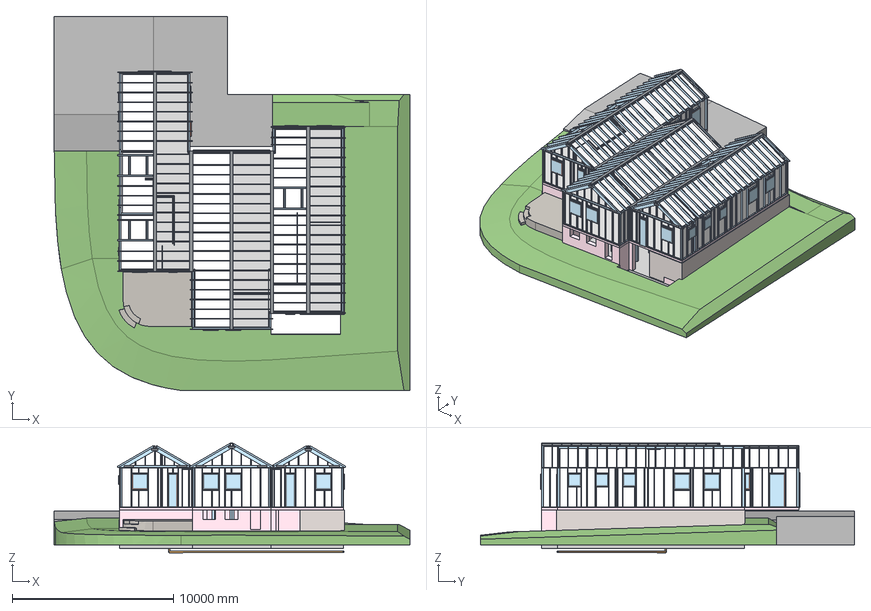
[picture p91: CAD file, 2026-10-09]
modeller/referens/trebodar-onshape.step
22030.8 x 23172.6 x 6784.6 mm
Berg
Sovrumsavsats
Uppfyllnad
Beklädnad liten
Värmeslingor källare
Mittenplatta isolering
Mittenplatta
Beklädnad stor
Avloppssystem
K Pillar x 19
Isoskal vägg 1
Bottenplatta matkällare
Bkärna vägg 4
Bkärna vägg 3
Bkärna vägg 2
Bkärna vägg 1
Isoskal vägg 2
Bottenplatta
gyp_w_l2l_p4
gyp_w_3sv
gyp_w_1no_p2
gyp_w_3_br2a
gyp_c_f1
gyp_w_3nv_p2
gyp_w_1i1_p1 x 2
gyp_w_2_midd
gyp_w_l2l_p3
gyp_w_bad4
gyp_w_3_ev1
gyp_w_l2l_p10
gyp_w_3_ll2
gyp_w_l2l_p9
gyp_w_1sv
gyp_w_bad3
gyp_w_1so_p1
gyp_w_3_ev4 x 2
gyp_w_2_m_2 x 2
gyp_w_3_ev2
gyp_w_2_m_1
gyp_w_3_ll
gyp_w_bad8
gyp_w_bad6
gyp_w_bad7
gyp_w_1no
gyp_w_1nv
gyp_w_3so
gyp_w_bad1
gyp_w_l2l_p7
gyp_w_2bw
gyp_w_3nv_p1
gyp_w_3_br1a
gyp_w_2_mida
gyp_w_bad2
gyp_w_2_m_3
gyp_w_l2l_p2
gyp_w_2_m_4
tempbench
gyp_w_l2l_p6
gyp_w_bad5
gyp_w_3_ev3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
