vron/trebodar/modeller/balkar/NB1.step

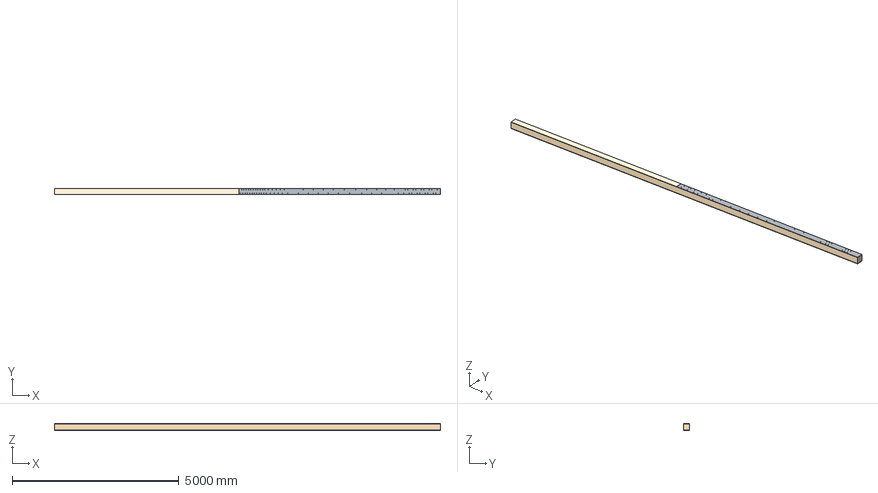
[picture p92: CAD file, 2026-11-06]
modeller/balkar/NB1.step
11570.0 x 190.0 x 200.0 mm
NB1 limtra GL30c 190x180
NB1-1-U
NB1-1-O
NB1 distansregel 1-U
NB1 distansregel 1-O
