vron/trebodar/modeller/balkar/NB3.step

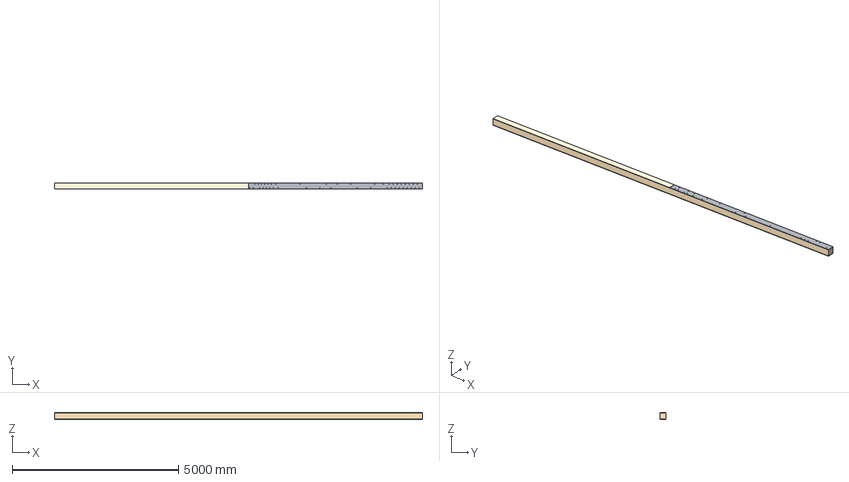
[picture p93: CAD file, 2026-11-06]
modeller/balkar/NB3.step
11070.0 x 190.0 x 200.0 mm
NB3 limtra GL30c 190x180
NB3-1-U
NB3-1-O
NB3 distansregel 1-U
NB3 distansregel 1-O
