vron/trebodar/modeller/balkplattor/NB5-1-O.step

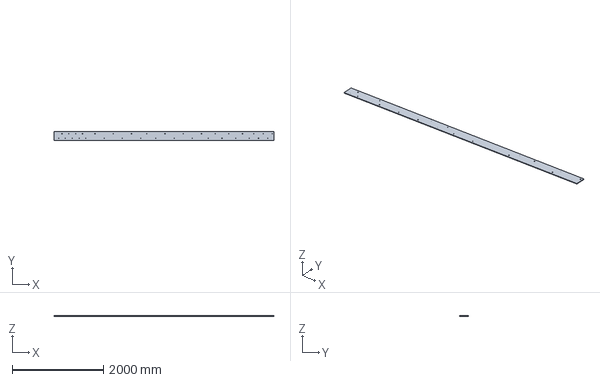
[picture p94: CAD file, 2026-11-13]
modeller/balkplattor/NB5-1-O.step
4825.0 x 190.0 x 10.0 mm
