vron/trebodar/modeller/balkar/DB4.step

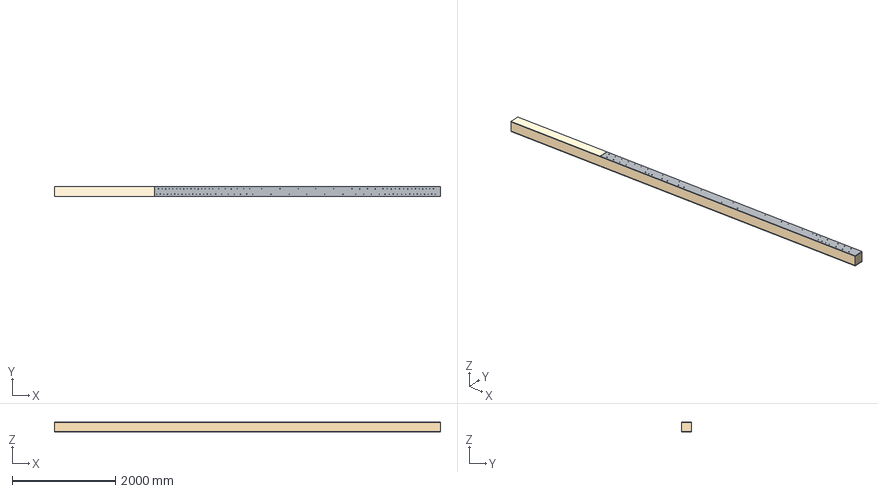
[picture p95: CAD file, 2026-11-06]
modeller/balkar/DB4.step
7480.0 x 190.0 x 200.0 mm
DB4 limtra GL30c 190x180
DB4-1-U
DB4-1-O
DB4 distansregel 1-U
DB4 distansregel 1-O
