vron/trebodar/modeller/balkar/DB2.step

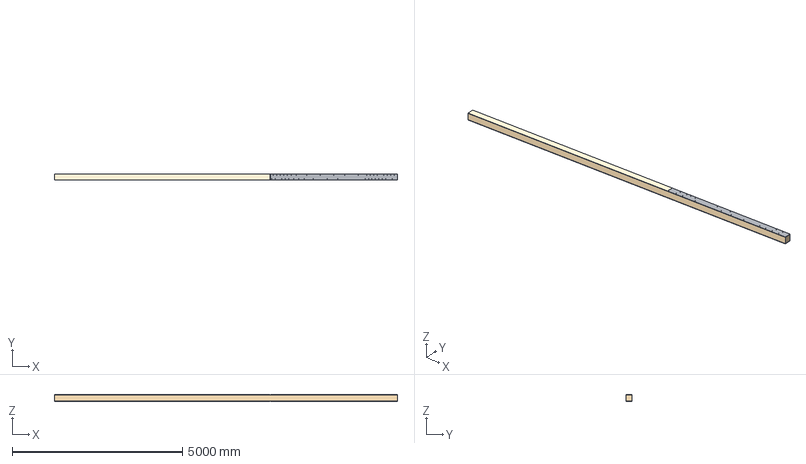
[picture p96: CAD file, 2026-11-06]
modeller/balkar/DB2.step
10070.0 x 190.0 x 200.0 mm
DB2 limtra GL30c 190x180
DB2-1-U
DB2-1-O
DB2 distansregel 1-U
DB2 distansregel 1-O
