vron/trebodar/modeller/balkplattor/NB3-1-O.step

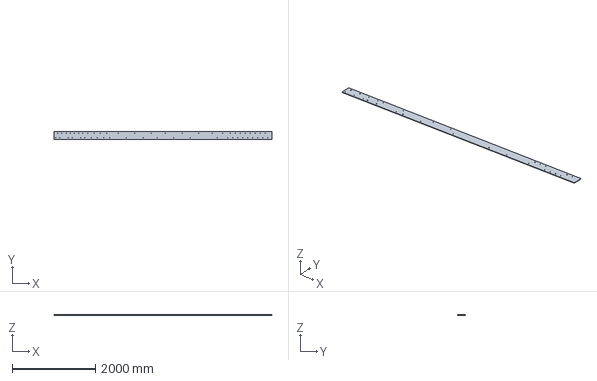
[picture p97: CAD file, 2026-11-06]
modeller/balkplattor/NB3-1-O.step
5235.0 x 190.0 x 10.0 mm
