vron/trebodar/modeller/balkplattor/NB1-1-U.step

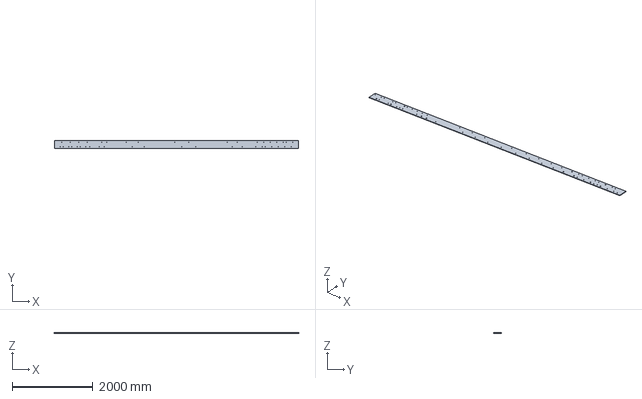
[picture p98: CAD file, 2026-11-06]
modeller/balkplattor/NB1-1-U.step
6038.0 x 190.0 x 10.0 mm
