vron/trebodar/modeller/balkplattor/DB4-1-O.step

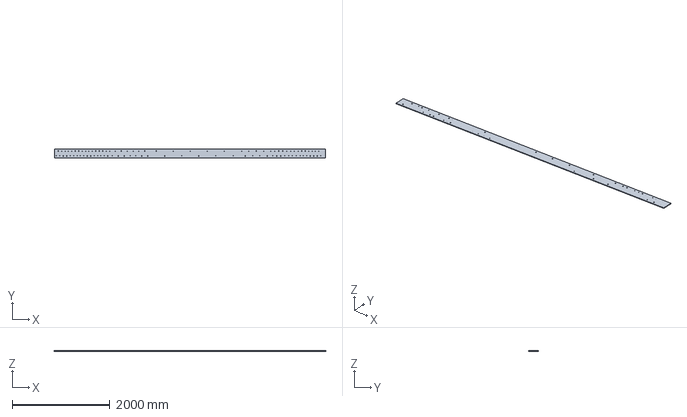
[picture p99: CAD file, 2026-11-06]
modeller/balkplattor/DB4-1-O.step
5540.0 x 190.0 x 10.0 mm
