vron/trebodar/modeller/balkplattor/DB2-1-O.step

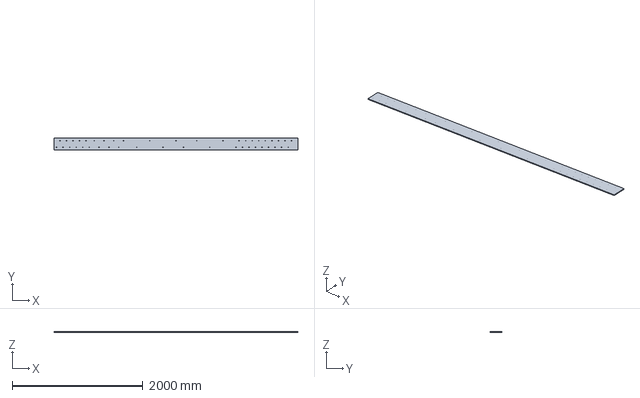
[picture p100: CAD file, 2026-11-06]
modeller/balkplattor/DB2-1-O.step
3733.0 x 190.0 x 10.0 mm
