vron/trebodar/(list of files, cad)

Other CAD files:
modeller/balkplattor/NB5-2-O.step
modeller/balkplattor/NB5-1-U.step
modeller/balkplattor/DB4-1-U.step
modeller/balkplattor/NB1-1-O.step
modeller/balkplattor/NB3-1-U.step
modeller/balkplattor/DB2-1-U.step
modeller/balkplattor/DB2-1-O.dxf
modeller/balkplattor/DB2-1-U.dxf
modeller/balkplattor/DB4-1-O.dxf
modeller/balkplattor/DB4-1-U.dxf
modeller/balkplattor/NB1-1-O.dxf
modeller/balkplattor/NB1-1-U.dxf
modeller/balkplattor/NB3-1-O.dxf
modeller/balkplattor/NB3-1-U.dxf
modeller/balkplattor/NB5-1-O.dxf
modeller/balkplattor/NB5-1-U.dxf
modeller/balkplattor/NB5-2-O.dxf
modeller/balkplattor/NB5-2-U.dxf
