vron/trebodar/ritningar/AR-01 Fasadsten på källarväggarna.pdf

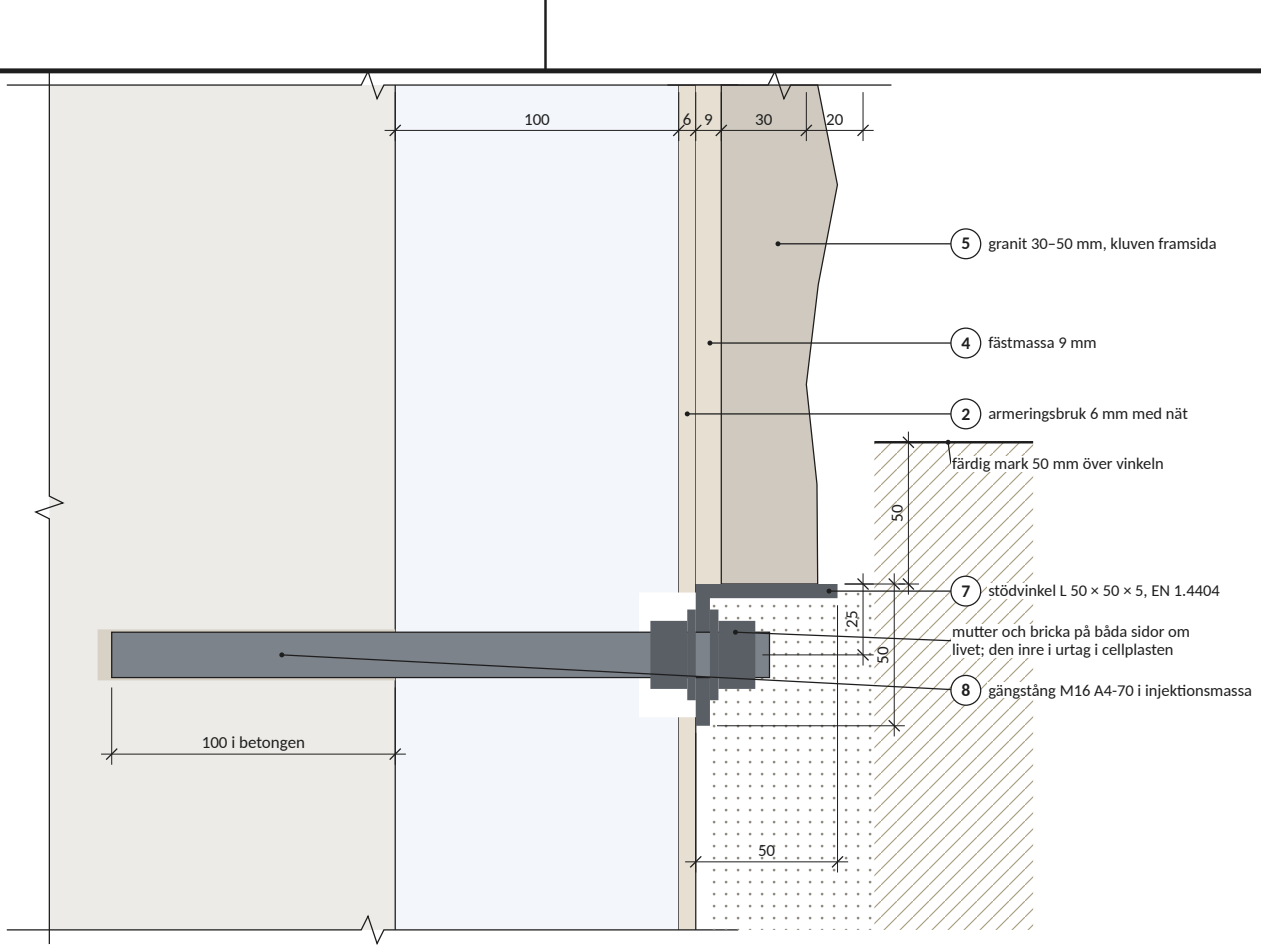
[picture p101: figure]
100 i betongen; 5 granit 30–50 mm, kluven framsida; 4 fästmassa 9 mm; 2 armeringsbruk 6 mm med nät; färdig mark 50 mm över vinkeln; 7 stödvinkel L 50 × 50 × 5, EN 1.4404; mutter och bricka på båda sidor om livet; den inre i urtag i cellplasten; 8 gängstång M16 A4-70 i injektionsmassa
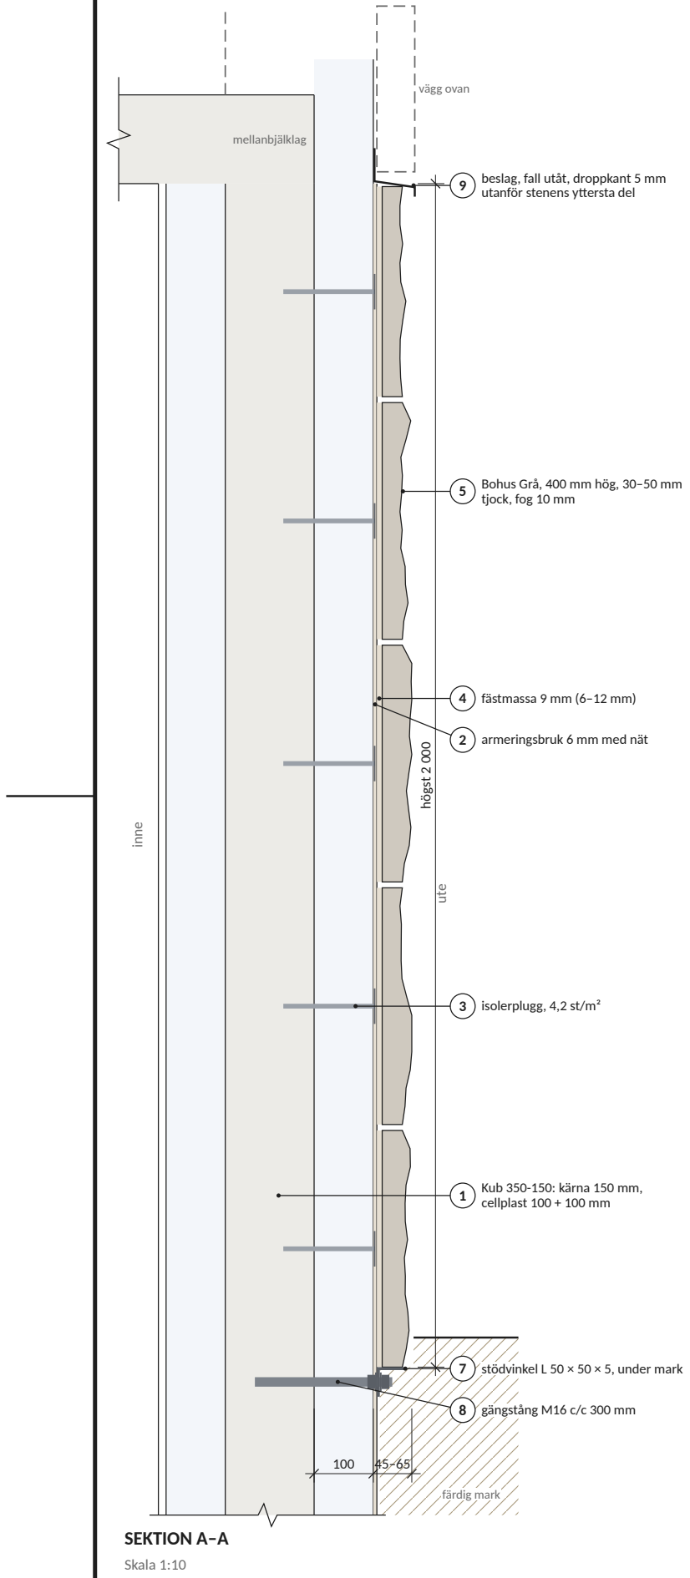
[picture p102: figure]
högst 2 000; beslag, fall utåt, droppkant 5 mm utanför stenens yttersta del; Bohus Grå, 400 mm hög, 30–50 mm tjock, fog 10 mm; 4 fästmassa 9 mm (6–12 mm); 2 armeringsbruk 6 mm med nät; 3 isolerplugg, 4,2 st/m²; Kub 350-150: kärna 150 mm, cellplast 100 + 100 mm; 7 stödvinkel L 50 × 50 × 5, under mark; 8 gängstång M16 c/c 300 mm; mellanbjälklag; vägg ovan; färdig mark; inne; ute; SEKTION A–A; Skala 1:10

### DETALJ B Stödvinkel på gängstång genom cellplasten

Skala 1:2.5

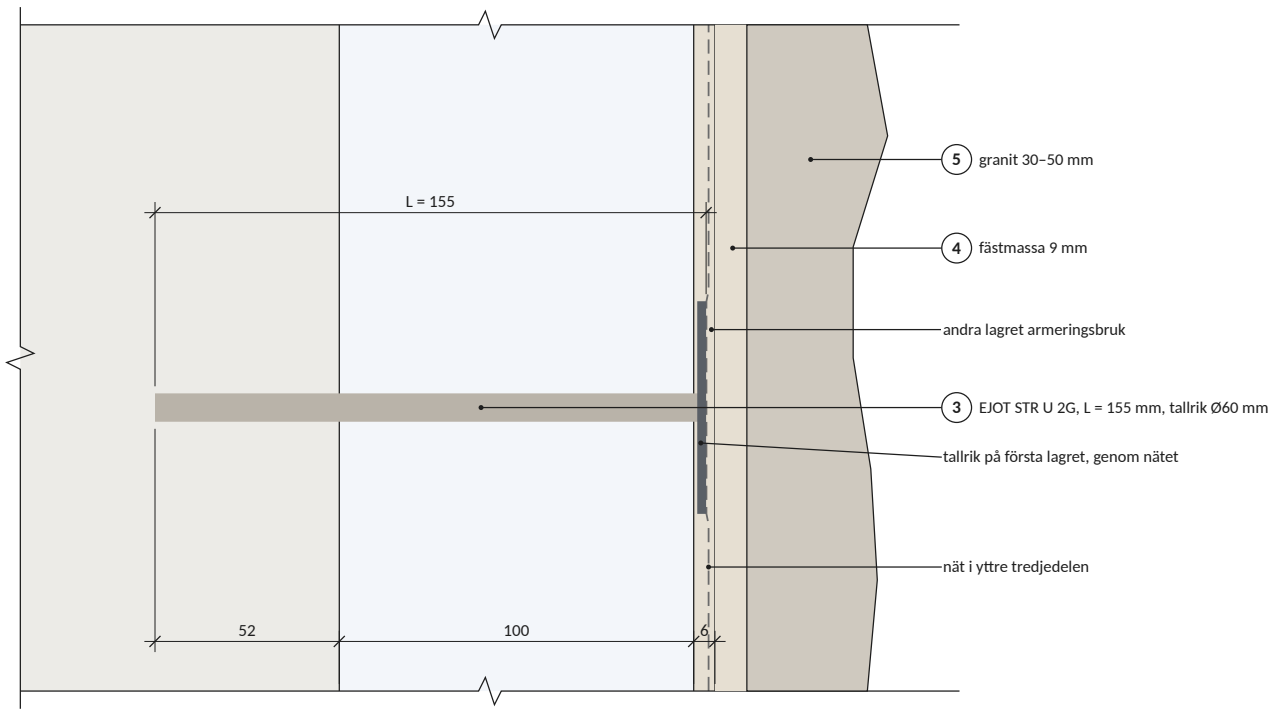
[picture p103: figure]
5 granit 30–50 mm; 4 fästmassa 9 mm; andra lagret armeringsbruk; tallrik på första lagret, genom nätet; nät i yttre tredjedelen

### 3 EJOT STR U 2G, L = 155 mm, tallrik Ø60 mm

### DETALJ C Armeringsbruk och isolerplugg genom nätet

Skala 1:2

Anvisningar
1. Gäller källarväggarnas ytterväggar av Sundolitt Kub 350-150 där fasadsten sätts ovan mark. Stenen limmas mot armeringsbruket, som hålls mot betongkärnan av isolerpluggarna genom nätet. Stödvinkeln under nedersta skiftet bär stenens tyngd om fästet mot cellplasten går förlorat. Inga infästningar i de enskilda stenarna.
2. Det härdade armeringsbruket får avvika högst 4 mm över stenens längsta kant.
3. Gängstängerna (8) först: hål Ø18 genom cellplasten och 100 mm in i betongen. Hålet borstas och blåses rent, fylls med injektionsmassa från botten och stången trycks in med en vridning. Verktyg: borrhammare, patronpistol för injektionsmassa, rensborste och blåspump. Den inre muttern och brickan ställs i ett urtag i cellplasten, med brickan i armeringsbrukets yta.
4. Armeringsbruket (2) i två lager med nätet i den yttre tredjedelen, skarvar 100 mm och diagonalnät vid öppningarnas hörn. Isolerpluggarna (3) sätts genom nätet i det första lagret; tallrikarna täcks direkt av det andra.
5. Stödvinkeln (7) på stängerna, rak och i våg (justeras med de inre muttrarna), yttre bricka och mutter. Vinkelns överkant 50 mm under färdig mark, så att den inte syns.
6. Stenen (5) sätts med fästmassa (4) på både vägg och den sågade baksidan, 100 % täckning.
7. Stenarna sätts skift för skift med fulla liggfogar, så att varje sten står på skiftet under. Hörnstenar i utvändiga hörn. Fogarna (6) fylls helt och komprimeras, utom dräneringsfogar: stötfogarna i nedersta skiftet lämnas öppna närmast ovan mark, högst 800 mm isär. Mot dörr- och fönsterkarmar och andra material: anslutningsfog (10). Rörelsefogar i stenytan behövs inte: stenen sitter på cellplasten, fri från betongen, och längs den längsta fasaden (cirka 11,7 m) rör den sig bara några millimeter, fördelat på fogarna.
8. Ingen cellplast får synas: beslag (9) över överkanten, sten eller plåt i öppningarnas smygar, armeringsbruket nedtill till 200 mm under mark.
9. Avstånd till betongkärnans kanter (öppningar, väggens ände) och mellan infästningar minst 100 mm.
10.Positioner och fasad: AR-01.2. Allt stål rostfritt A4, även mutter och bricka.

Teckenförklaring
betong (Kub-kärna, bjälklag)
cellplast (Kub)
armeringsbruk, fästmassa
granit
rostfritt stål EN 1.4404 (A4) injektionsmassa
glasfibernät
1 | position, se AR-01.2
Rev Avser | Datum | Sign
A | Första utgåvan | 2026-10-10 | VO

PROJEKT

Fritidshus Trebodar, Resö, Tanum

FASTIGHET

### Resö 2:66, Tanums kommun · BYGG.2025.2278

INNEHÅLL

## Fasadsten på källarväggarna Sektion och detaljer

SKALA 1:10, 1:2,5, 1:2 | FORMAT A3 | DATUM 2026-10-10
UPPRÄTTAD Viktor Ogeman | GRANSKAD – | UNDERLAG Kub TG 2216, K-06
STATUS KONSTRUKTION | | REVISION A

RITNINGSNUMMER
AR-01.1

AR-01.1 · 1:10, 1:2,5, 1:2 vid utskrift på A3 · Mått i mm om inte annat anges

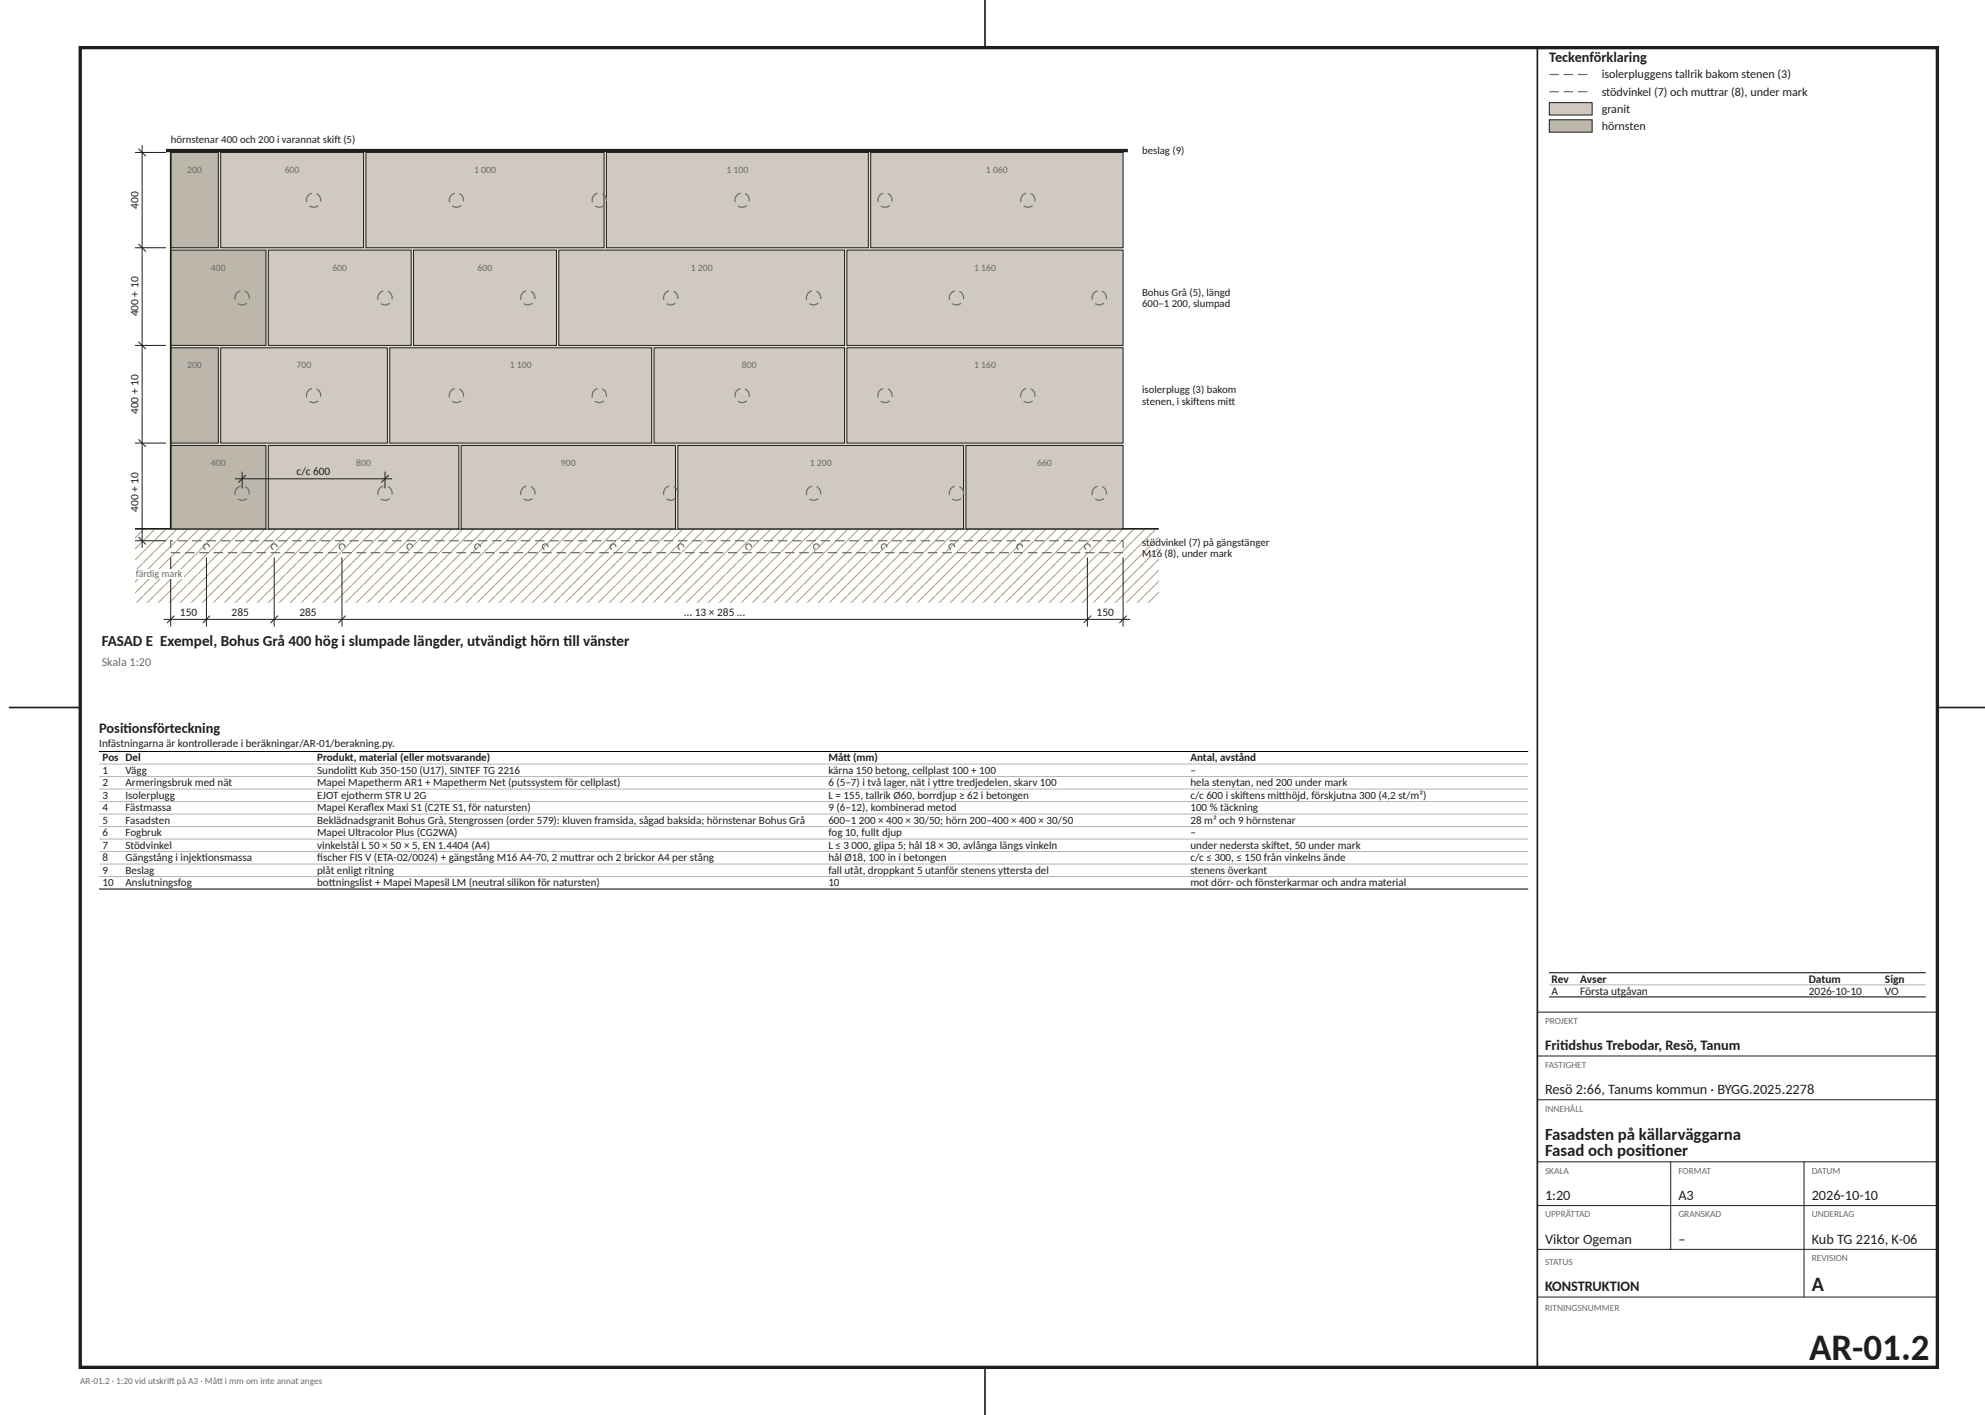
[picture p104: page 2]
beslag (9); färdig mark; Skala 1:20; Pos Del; Produkt, material (eller motsvarande); Mått (mm); Antal, avstånd; Vägg; Sundolitt Kub 350-150 (U17), SINTEF TG 2216; kärna 150 betong, cellplast 100 + 100; Armeringsbruk med nät; Mapei Mapetherm AR1 + Mapetherm Net (putssystem för cellplast); 6 (5–7) i två lager, nät i yttre tredjedelen, skarv 100; hela stenytan, ned 200 under mark; Isolerplugg; EJOT ejotherm STR U 2G; L = 155, tallrik Ø60, borrdjup ≥ 62 i betongen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

isolerpluggens tallrik bakom stenen (3)
stödvinkel (7) och muttrar (8), under mark
granit
hörnsten

hörnstenar 400 och 200 i varannat skift (5)

Bohus Grå (5), längd
600–1 200, slumpad

isolerplugg (3) bakom
stenen, i skiftens mitt

stödvinkel (7) på gängstänger
M16 (8), under mark

FASAD E Exempel, Bohus Grå 400 hög i slumpade längder, utvändigt hörn till vänster

Positionsförteckning
Infästningarna är kontrollerade i beräkningar/AR-01/berakning.py.

PROJEKT
Fritidshus Trebodar, Resö, Tanum

FASTIGHET
Resö 2:66, Tanums kommun · BYGG.2025.2278

INNEHÅLL
Fasadsten på källarväggarna
Fasad och positioner

SKALA 1:20 | FORMAT A3 | DATUM 2026-10-10

UPPRÄTTAD Viktor Ogeman | GRANSKAD – | UNDERLAG Kub TG 2216, K-06

STATUS KONSTRUKTION | | REVISION A

AR-01.2 · 1:20 vid utskrift på A3 · Mått i mm om inte annat anges
