vron/trebodar/bygglov/201 Planritning.pdf

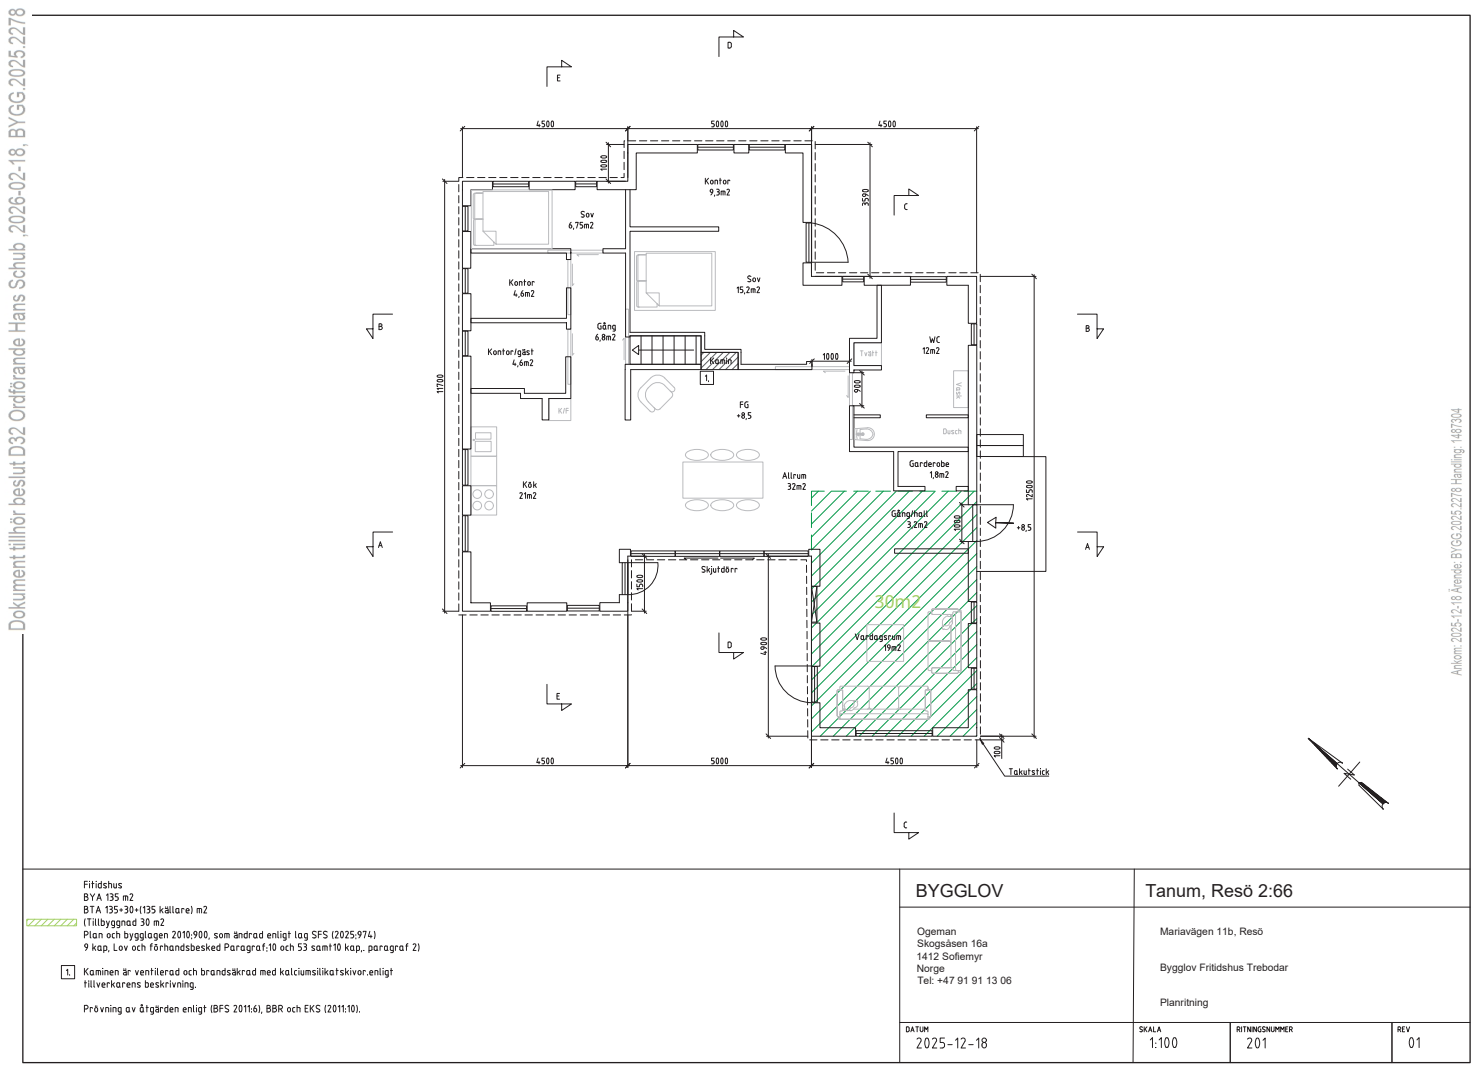
[picture p105: page 1]
BYGGLOV; Ogeman Skogsåsen 16a 1412 Sofiemyr Norge Tel: +47 91 91 13 06; Mariavägen 11b, Resö; Planritning; Tanum, Resö 2:66

Bygglov Fritidshus Trebodar
