vron/trebodar/bygglov/202 Planritning källare.pdf

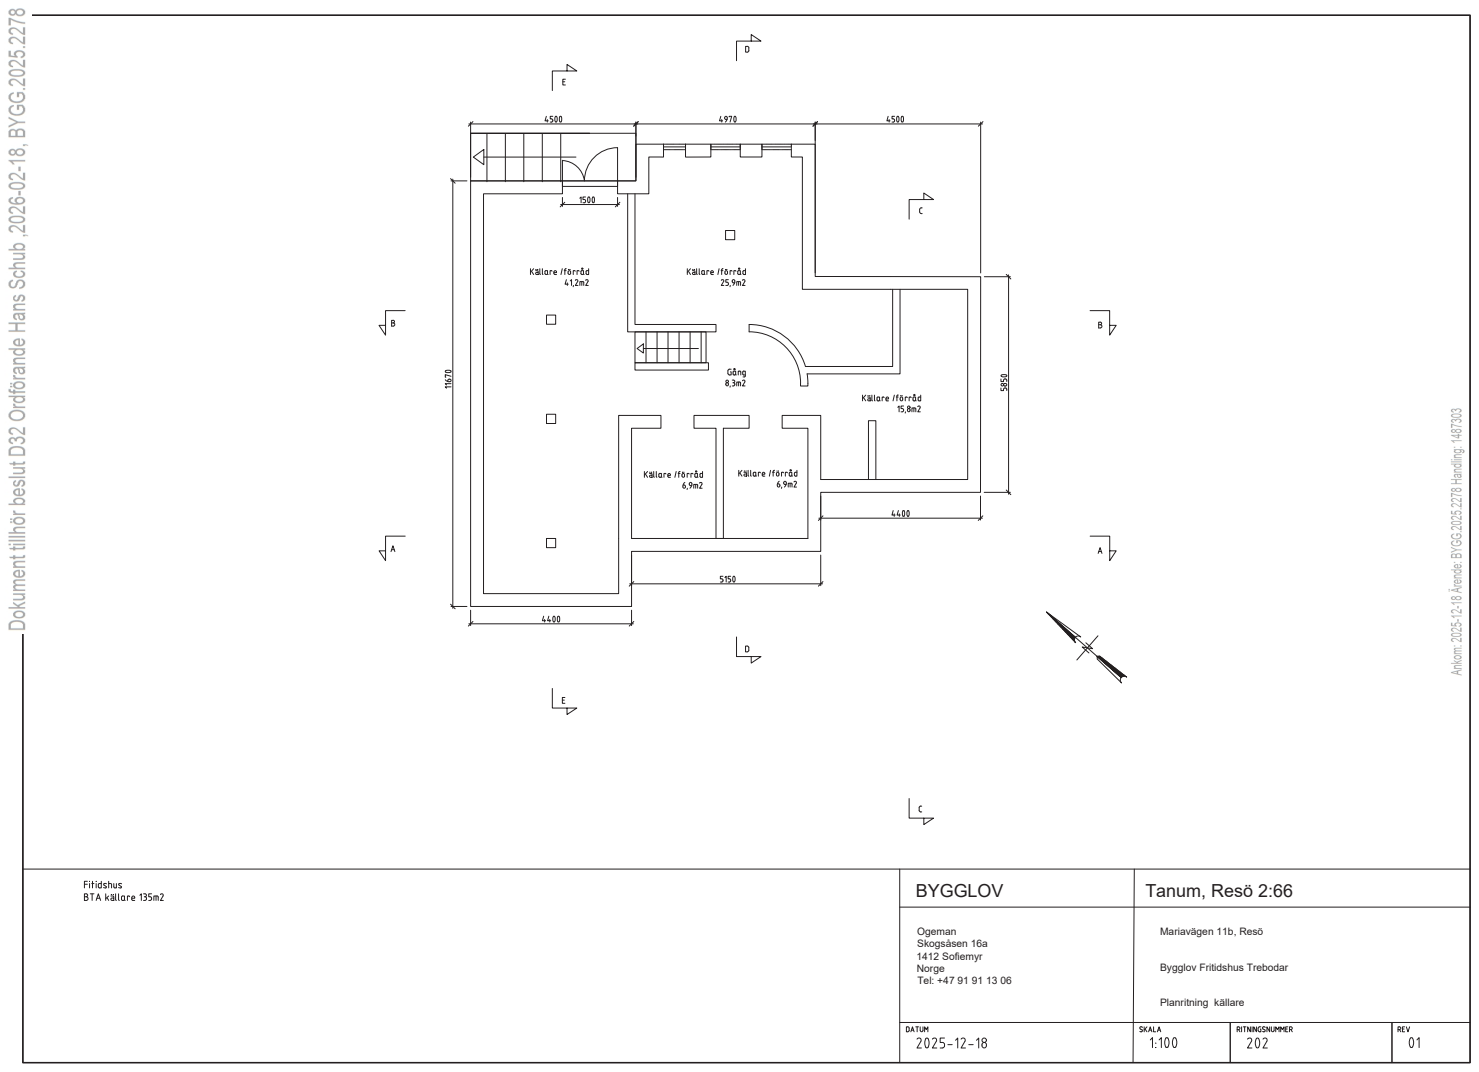
[picture p106: page 1]
BYGGLOV; Ogeman Skogsåsen 16a 1412 Sofiemyr Norge Tel: +47 91 91 13 06; Mariavägen 11b, Resö; Planritning källare; Tanum, Resö 2:66

Bygglov Fritidshus Trebodar
