vron/trebodar/bygglov/204 Fasad sydväst och sydost.pdf

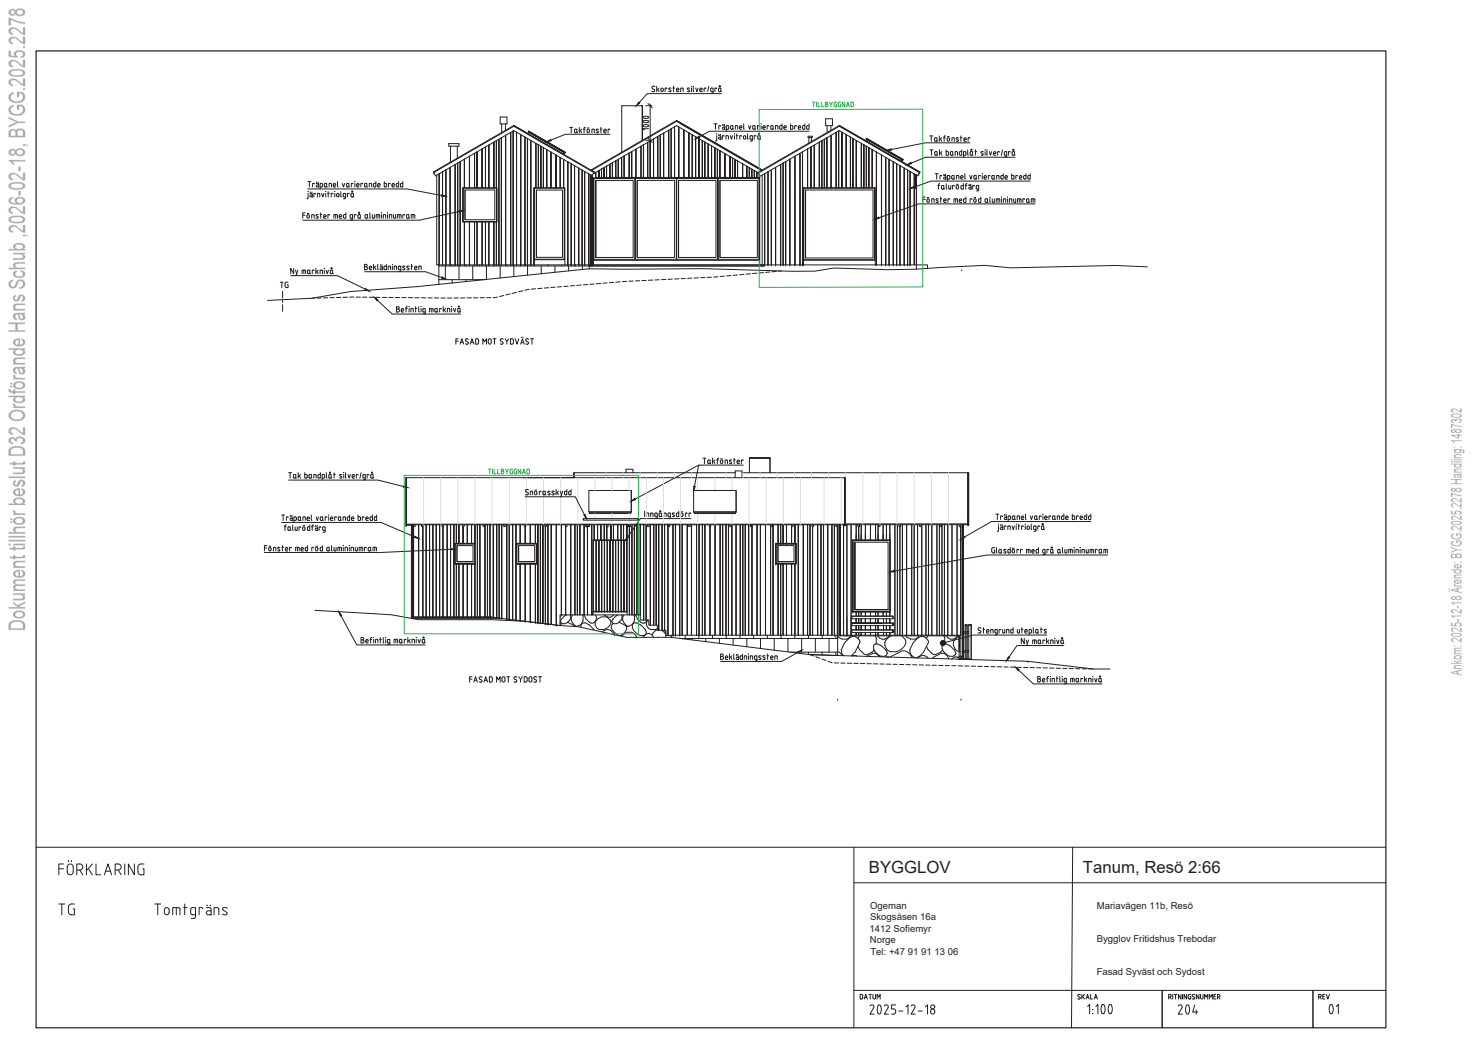
[picture p107: page 1]
BYGGLOV; Ogeman Skogsåsen 16a 1412 Sofiemyr Norge Tel: +47 91 91 13 06; Mariavägen 11b, Resö; Tanum, Resö 2:66

Bygglov Fritidshus Trebodar

Fasad Syväst och Sydost
