vron/trebodar/bygglov/206 Sektion A och B.pdf

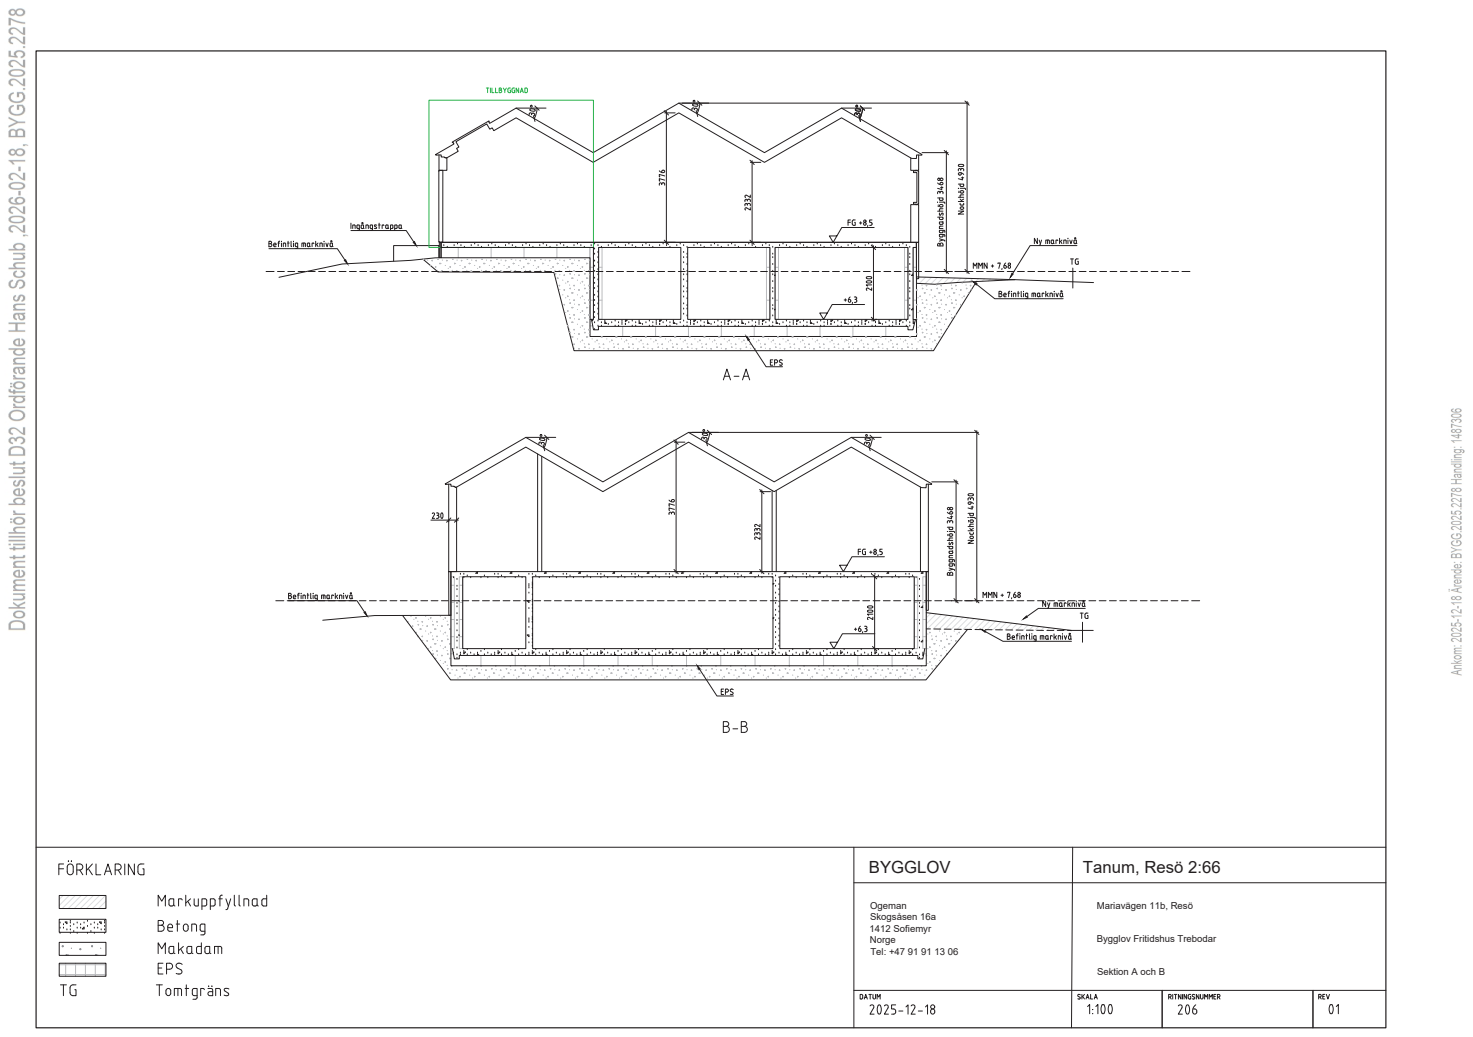
[picture p108: page 1]
BYGGLOV; Ogeman Skogsåsen 16a 1412 Sofiemyr Norge Tel: +47 91 91 13 06; Mariavägen 11b, Resö; Sektion A och B; Tanum, Resö 2:66

Bygglov Fritidshus Trebodar
