vron/trebodar/bygglov/207 Sektion C och D.pdf

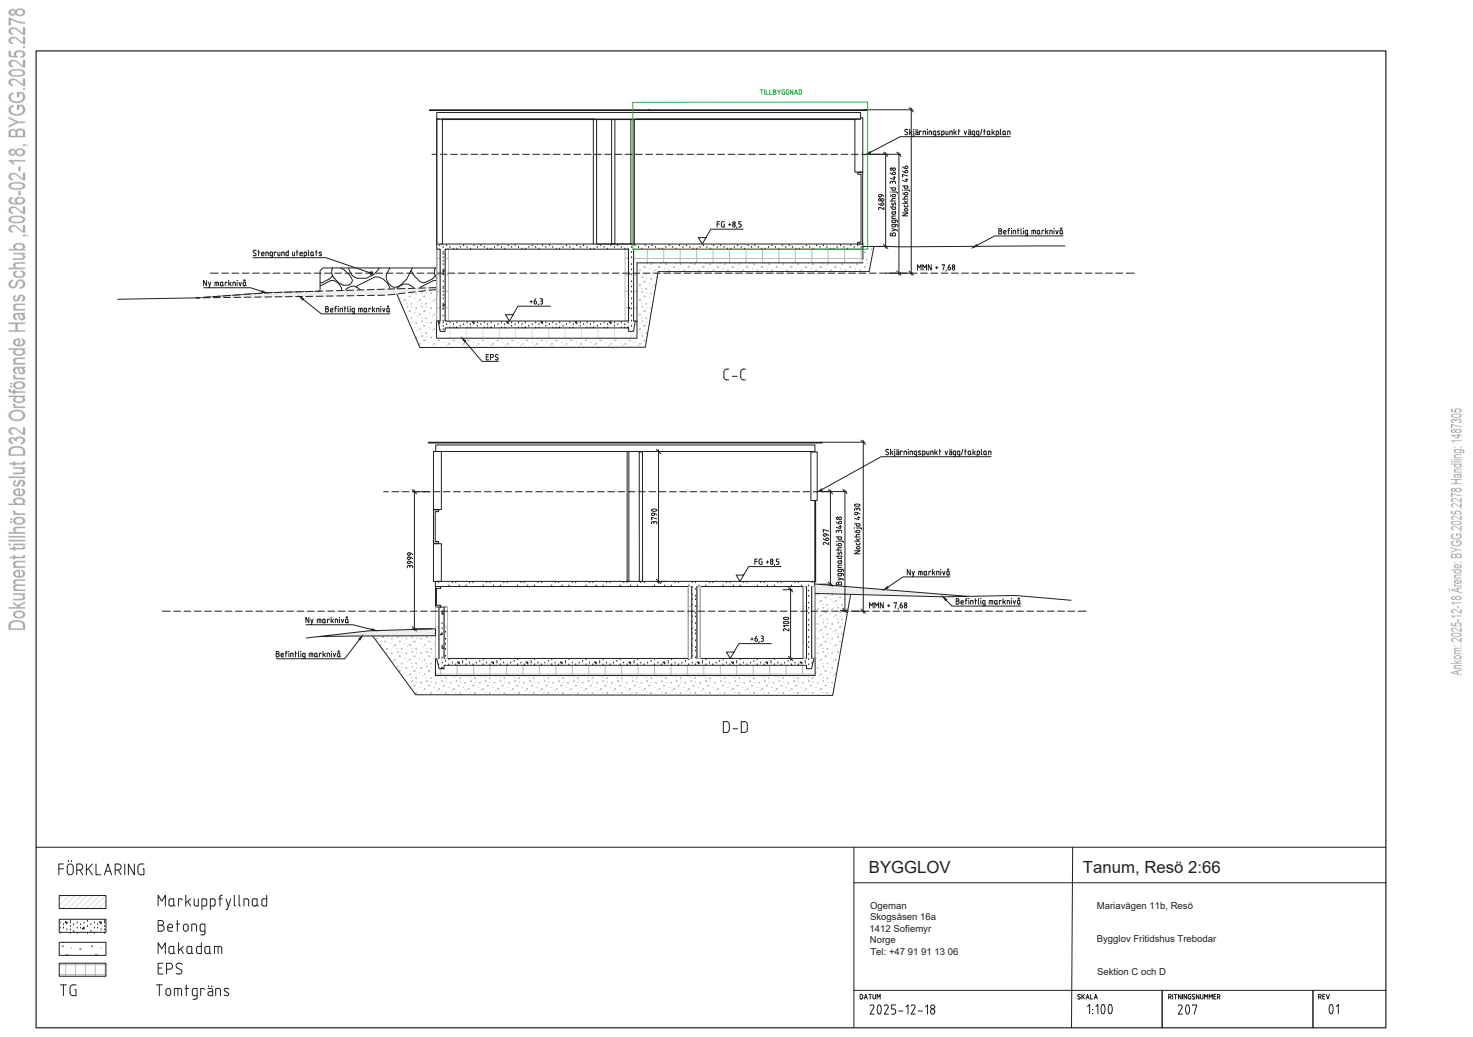
[picture p109: page 1]
BYGGLOV; Ogeman Skogsåsen 16a 1412 Sofiemyr Norge Tel: +47 91 91 13 06; Mariavägen 11b, Resö; Sektion C och D; Tanum, Resö 2:66

Bygglov Fritidshus Trebodar
