vron/trebodar/bygglov/208 Sektion E.pdf

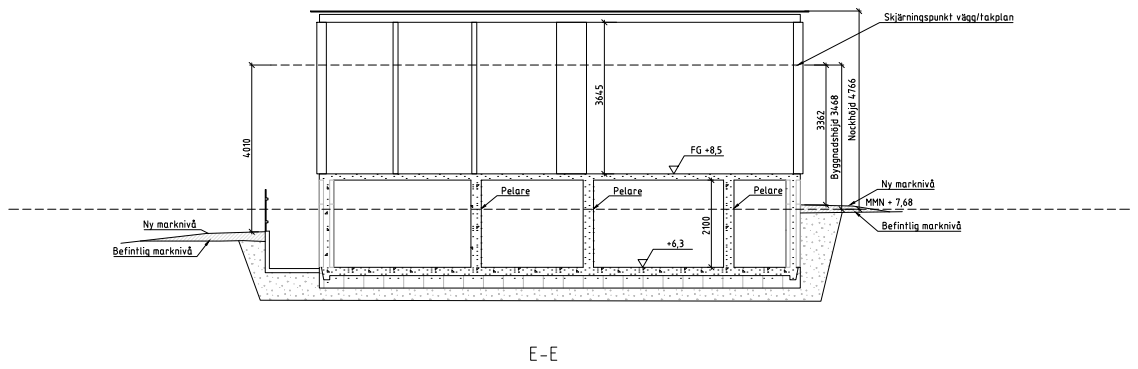
[picture p110: page 1]
Skjärningspunkt vägg/takplan 3645; +6,3 ⁴⁰¹⁰; Befintlig marknivå; Ny marknivå; Pelare; MMN + 7,68 Byggnadshöjd 3468; Nockhöjd 4766; BYGGLOV; Ogeman Skogsåsen 16a 1412 Sofiemyr Norge Tel: +47 91 91 13 06; Mariavägen 11b, Resö; Sektion E; DATUM; SKALA; RITNINGSNUMMER; REV 2025-12-01; Tanum, Resö 2:66; Markuppfyllnad Betong Makadam EPS; FÖRKLARING; Tomtgräns

Bygglov Fritidshus Trebodar
