vron/trebodar/bygglov/209 Inre fasader.pdf

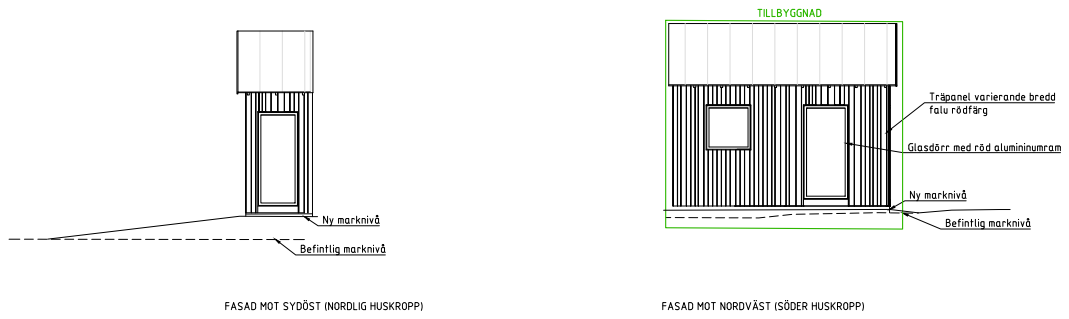
[picture p111: page 1]
Befintlig marknivå; TILLBYGGNAD; Ny marknivå; BYGGLOV; Ogeman Skogsåsen 16a 1412 Sofiemyr Norge Tel: +47 91 91 13 06; Mariavägen 11b, Resö; INRE FASADER; DATUM; SKALA; RITNINGSNUMMER; REV 2026-01-15; FÖRKLARING; Tanum, Resö 2:66; Tomtgräns

Träpanel varierande bredd
falu rödfärg

Glasdörr med röd alumininumram

FASAD MOT SYDÖST (NORDLIG HUSKROPP)

FASAD MOT NORDVÄST (SÖDER HUSKROPP)

Bygglov Fritidshus Trebodar
