vron/trebodar/ritningar/R-06 Mellanbjälklag.pdf

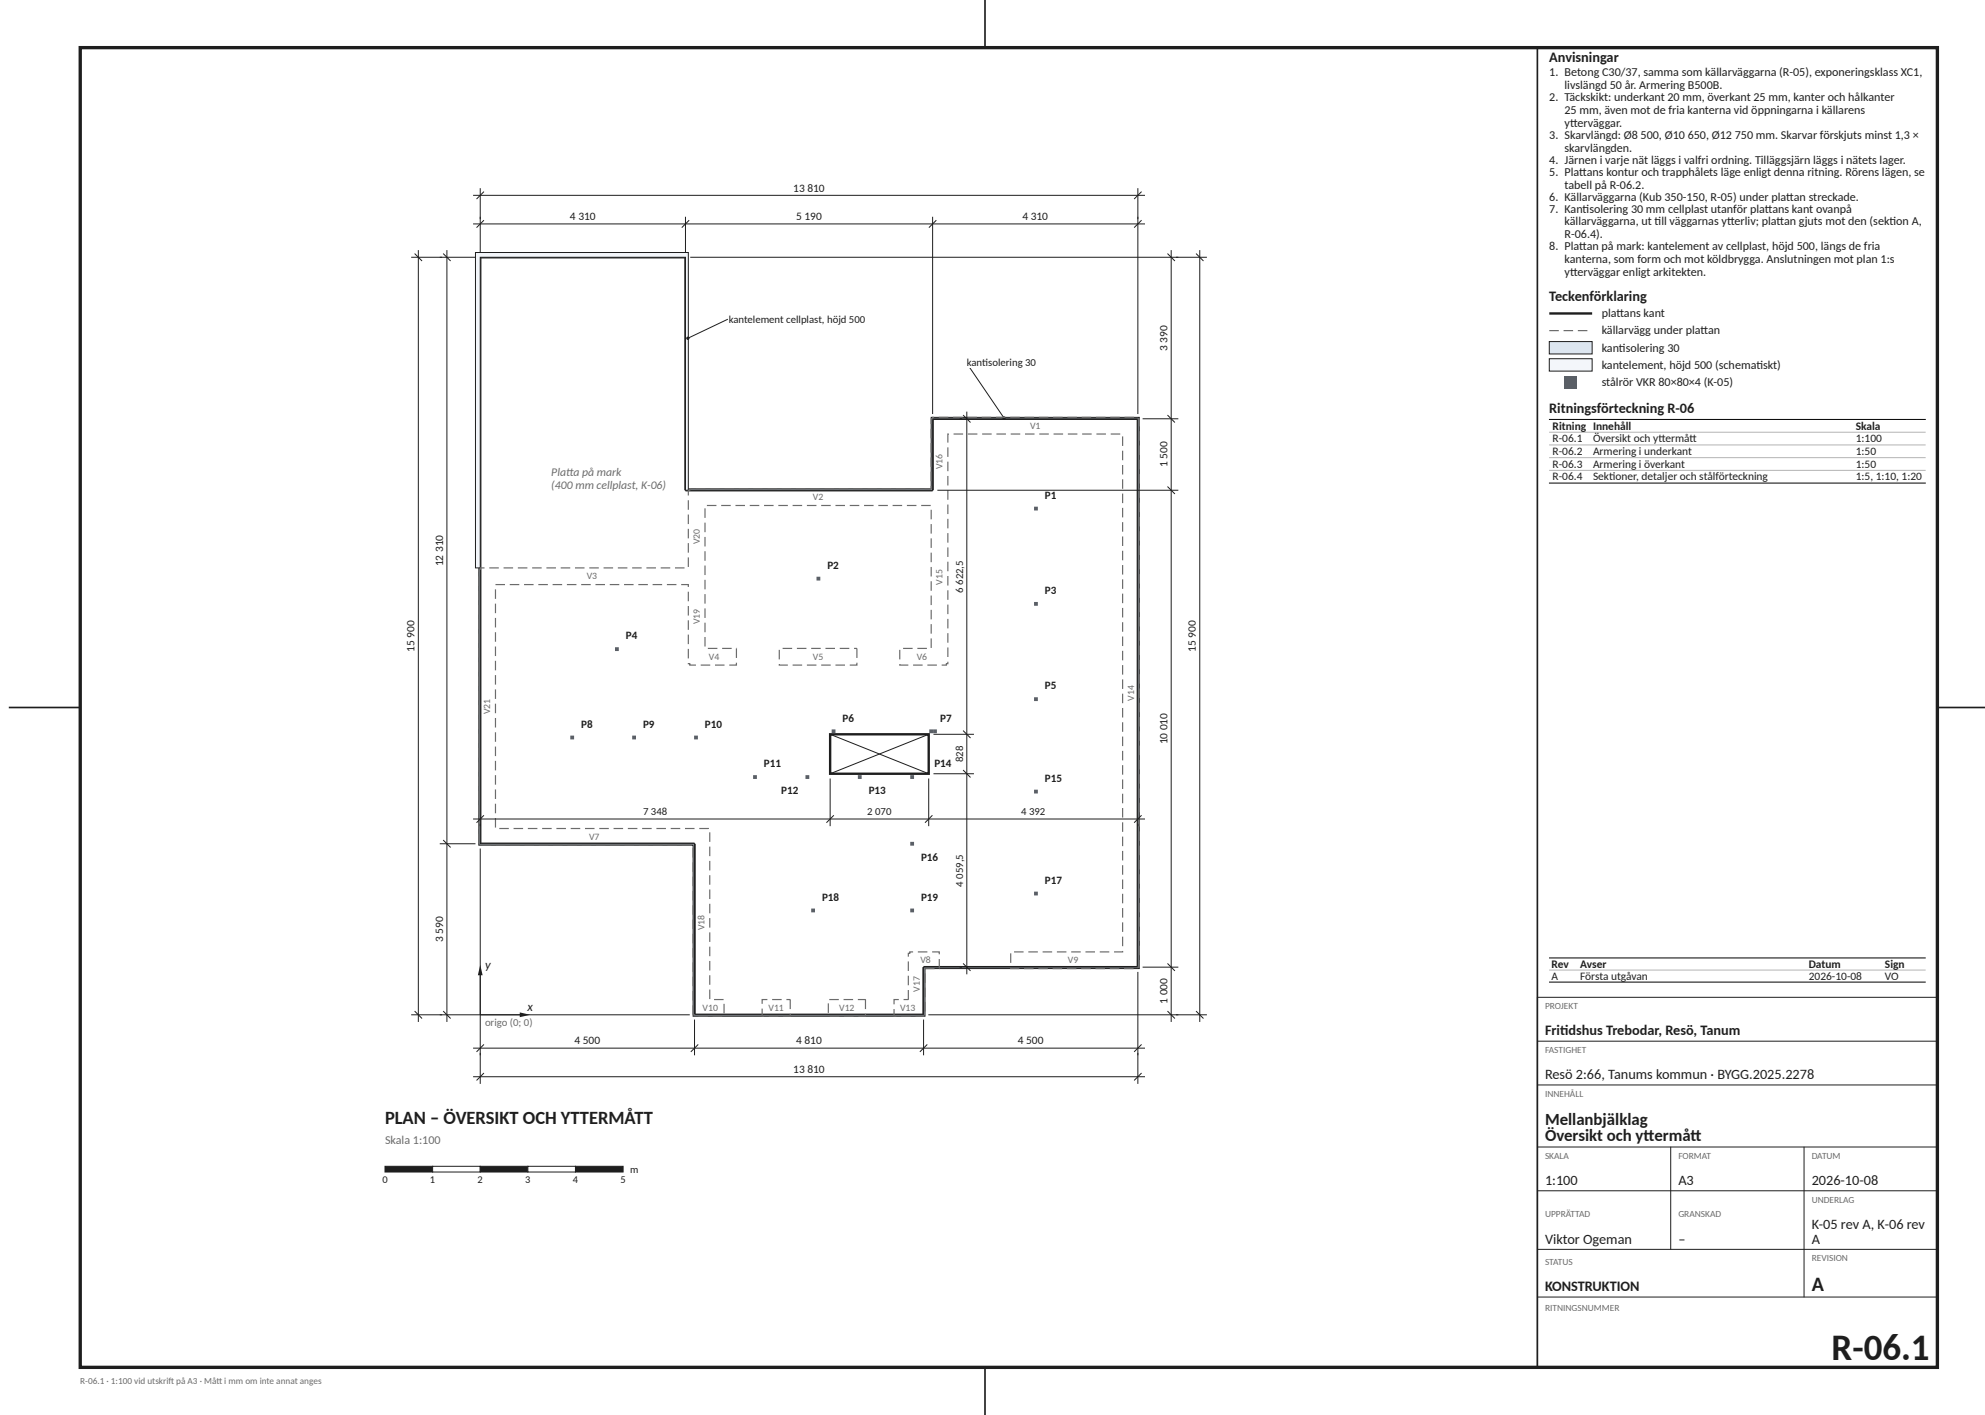
[picture p112: page 1]

Anvisningar
1. Betong C30/37, samma som källarväggarna (R-05), exponeringsklass XC1,
livslängd 50 år. Armering B500B.
2. Täckskikt: underkant 20 mm, överkant 25 mm, kanter och hålkanter
25 mm, även mot de fria kanterna vid öppningarna i källarens
ytterväggar.
3. Skarvlängd: Ø8 500, Ø10 650, Ø12 750 mm. Skarvar förskjuts minst 1,3 ×
skarvlängden.
4. Järnen i varje nät läggs i valfri ordning. Tilläggsjärn läggs i nätets lager.
5. Plattans kontur och trapphålets läge enligt denna ritning. Rörens lägen, se
tabell på R-06.2.
6. Källarväggarna (Kub 350-150, R-05) under plattan streckade.
7. Kantisolering 30 mm cellplast utanför plattans kant ovanpå
källarväggarna, ut till väggarnas ytterliv; plattan gjuts mot den (sektion A,
8. Plattan på mark: kantelement av cellplast, höjd 500, längs de fria
kanterna, som form och mot köldbrygga. Anslutningen mot plan 1:s
ytterväggar enligt arkitekten.
Teckenförklaring

PROJEKT
Fritidshus Trebodar, Resö, Tanum

FASTIGHET
Resö 2:66, Tanums kommun · BYGG.2025.2278

PLAN – ÖVERSIKT OCH YTTERMÅTT

SKALA 1:100 | FORMAT A3 | DATUM 2026 -10 -08

UPPRÄTTAD Viktor Ogeman | GRANSKAD – | UNDERLAG K-05 rev A, K -06 rev A

STATUS KONSTRUKTION | | REVISION A

-06.1 · 1:100 vid utskrift på A3 · Mått i mm om inte annat anges

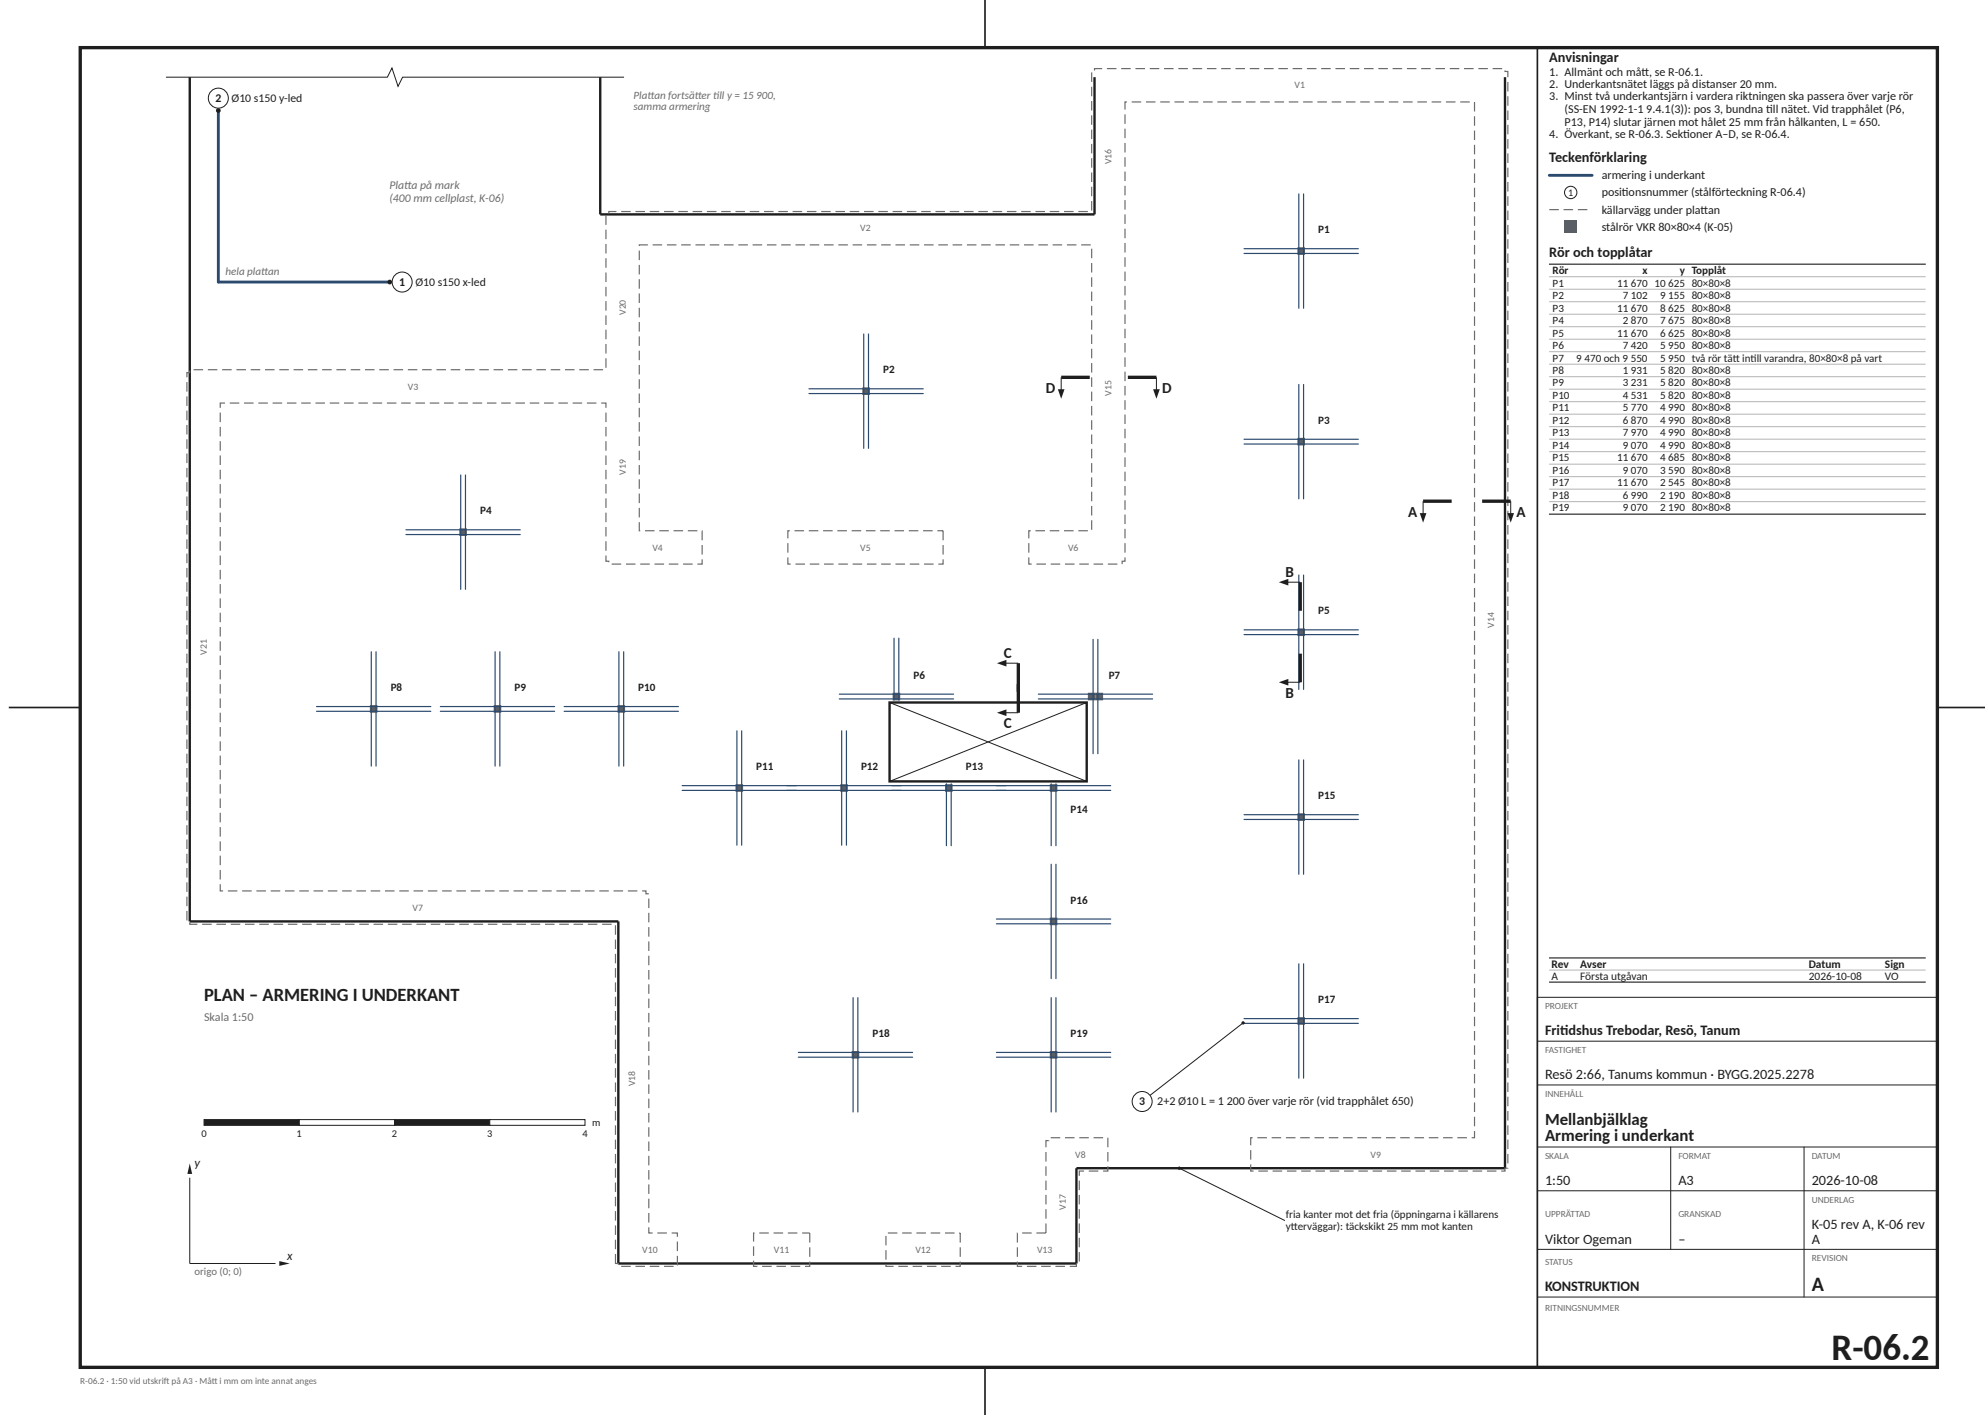
[picture p113: page 2]

1. Allmänt och mått, se R-06.1.
2. Underkantsnätet läggs på distanser 20 mm.
3. Minst två underkantsjärn i vardera riktningen ska passera över varje rör
(SS-EN 1992-1-1 9.4.1(3)): pos 3, bundna till nätet. Vid trapphålet (P6,
P13, P14) slutar järnen mot hålet 25 mm från hålkanten, L = 650.
4. Överkant, se R-06.3. Sektioner A–D, se R-06.4.

PROJEKT
Fritidshus Trebodar, Resö, Tanum

FASTIGHET
Resö 2:66, Tanums kommun · BYGG.2025.2278

3 2+2 Ø10 L = 1 200 över varje rör (vid trapphålet 650)

SKALA 1:50 | FORMAT A3 | DATUM 2026-10-08

UPPRÄTTAD Viktor Ogeman | GRANSKAD – | UNDERLAG K-05 rev A, K-06 rev A

fria kanter mot det fria (öppningarna i källarens
ytterväggar): täckskikt 25 mm mot kanten

STATUS KONSTRUKTION | | REVISION A

R-06.2 · 1:50 vid utskrift på A3 · Mått i mm om inte annat anges

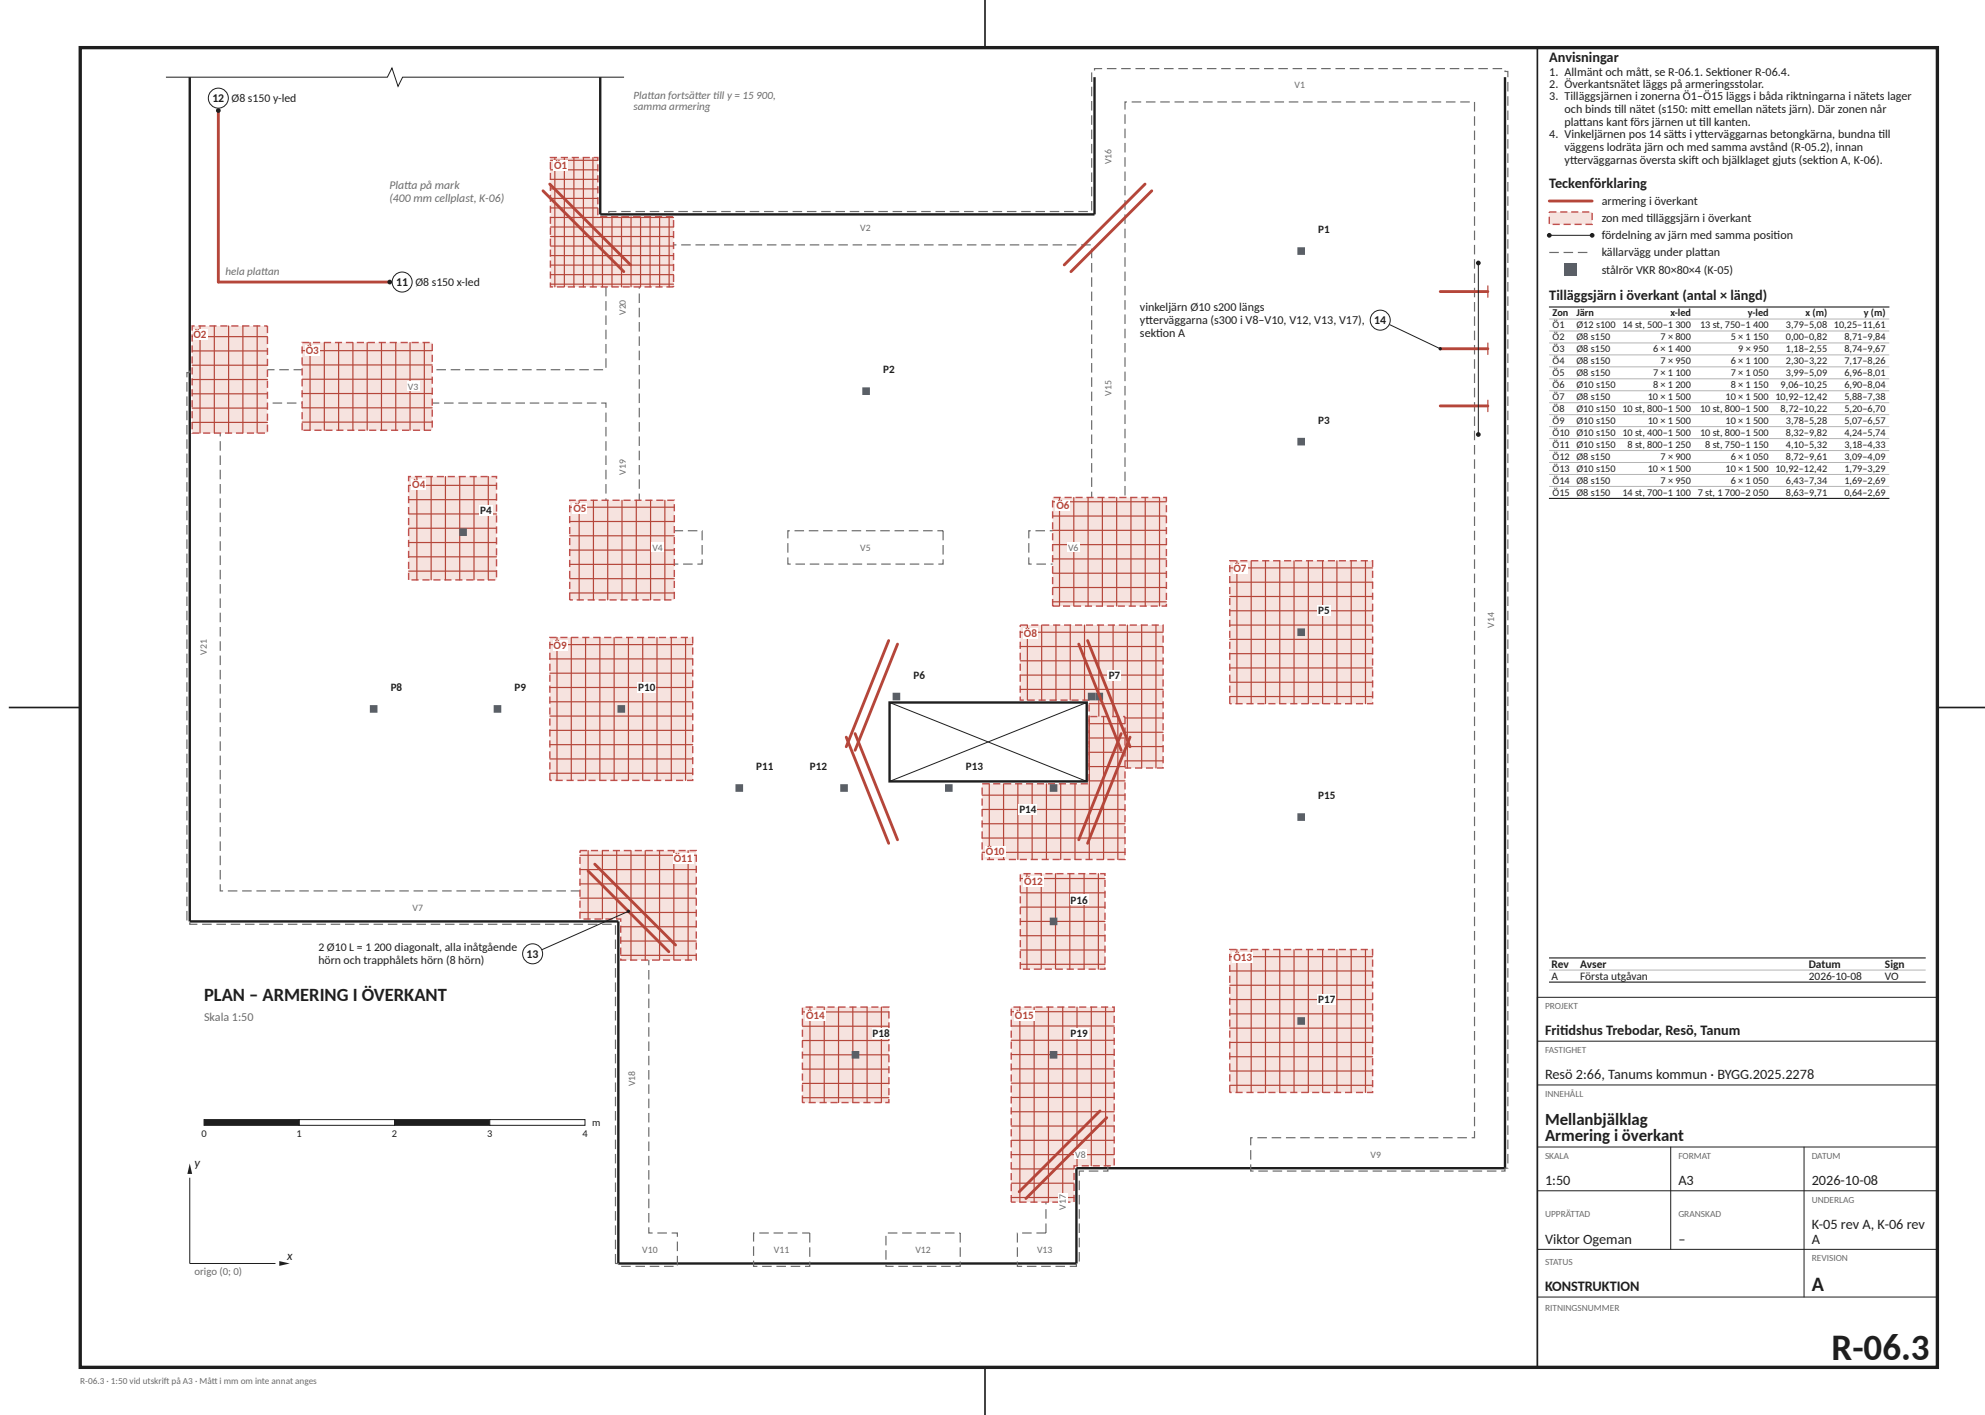
[picture p114: page 3]

1. Allmänt och mått, se R-06.1. Sektioner R-06.4.
2. Överkantsnätet läggs på armeringsstolar.
3. Tilläggsjärnen i zonerna Ö1–Ö15 läggs i båda riktningarna i nätets lager
och binds till nätet (s150: mitt emellan nätets järn). Där zonen når
plattans kant förs järnen ut till kanten.
4. Vinkeljärnen pos 14 sätts i ytterväggarnas betongkärna, bundna till
väggens lodräta järn och med samma avstånd (R-05.2), innan
ytterväggarnas översta skift och bjälklaget gjuts (sektion A, K-06).
Teckenförklaring

armering i överkant
zon med tilläggsjärn i överkant
fördelning av järn med samma position
källarvägg under plattan
stålrör VKR 80×80×4 (K-05)

Tilläggsjärn i överkant (antal × längd)

13 2 Ø10 L = 1 200 diagonalt, alla inåtgående
hörn och trapphålets hörn (8 hörn)

PROJEKT
Fritidshus Trebodar, Resö, Tanum

FASTIGHET
Resö 2:66, Tanums kommun · BYGG.2025.2278

SKALA 1:50 | FORMAT A3 | DATUM 2026-10-08

UPPRÄTTAD Viktor Ogeman | GRANSKAD – | UNDERLAG K-05 rev A, K-06 rev A

STATUS KONSTRUKTION | | REVISION A

R-06.3 · 1:50 vid utskrift på A3 · Mått i mm om inte annat anges

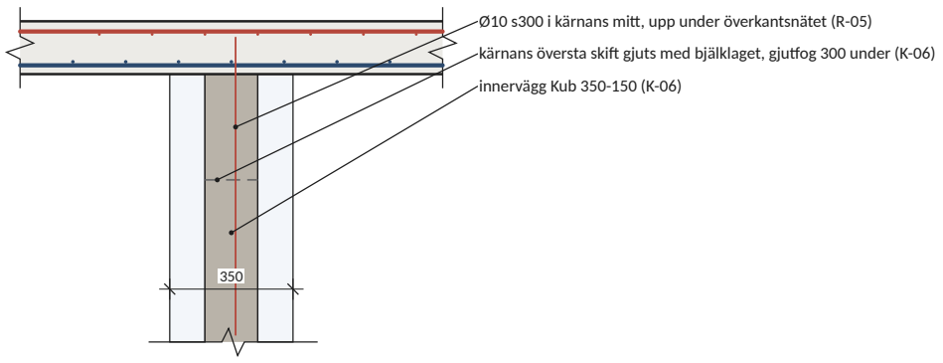
[picture p115: figure]
innervägg Kub 350-150 (K-06)
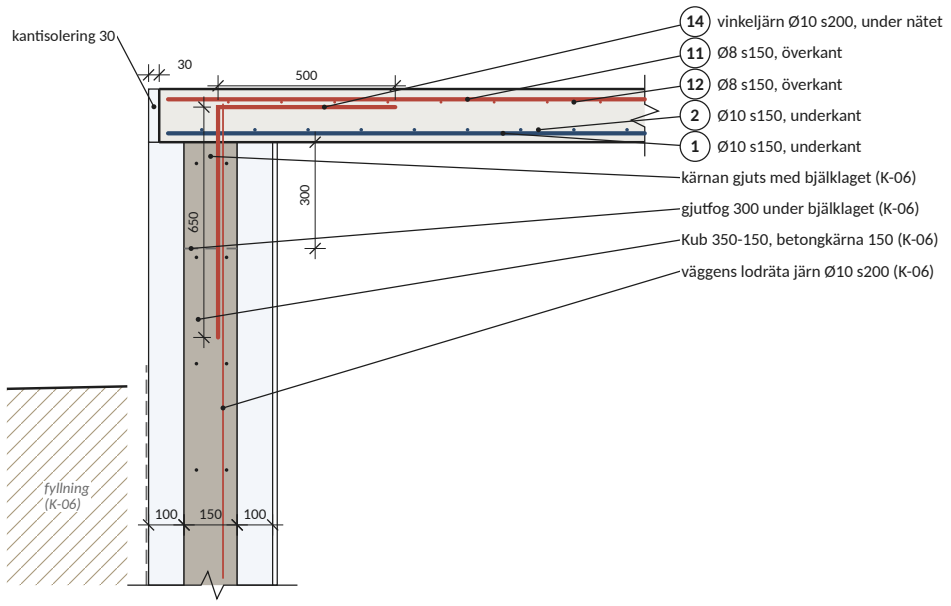
[picture p116: figure]
14 vinkeljärn Ø10 s200, under nätet; 11 Ø8 s150, överkant; 12 Ø8 s150, överkant; 2 Ø10 s150, underkant; 1 Ø10 s150, underkant; kärnan gjuts med bjälklaget (K-06); gjutfog 300 under bjälklaget (K-06); Kub 350-150, betongkärna 150 (K-06); väggens lodräta järn Ø10 s200 (K-06); kantisolering 30; fyllning (K-06)

## SEKTION A–A Yttervägg mot jord (V14)

Skala 1:20

80

150

20 25

### 11 Ø8 s150, överkant

Ö7: Ø8 s150, båda riktningarna

3 2 + 2 Ø10 L = 1 200 över röret

### 1 Ø10 s150, underkant

topplåt 80×80×8 kant i kant med underkanten (P7: två rör)
rör VKR 80×80×4 S235

## SEKTION B–B Vid rör (P5)

Skala 1:10

Ø10 s300 i kärnans mitt, upp under överkantsnätet (R-05)

kärnans översta skift gjuts med bjälklaget, gjutfog 300 under (K-06)

## SEKTION D–D Innervägg (V15)

Skala 1:20

trapphål

båda näten går ut till hålkanten, täckskikt 25

### 13 diagonaljärn vid hålets hörn, se R-06.3 ²⁵

## SEKTION C–C Trapphålets kant

Skala 1:10

150

20 25

### 11 Ø8, lager 1

### 12 Ø8, lager 2

### 2 Ø10, lager 2

### 1 Ø10, lager 1

## DETALJ E Armeringens lägen

Skala 1:5

### Stålförteckning, B500B

Pos | Ø | Form | s | Anm
1 | Ø10 rak | s150 | UK x-led
2 | Ø10 rak | s150 | UK y-led
11 | Ø8 rak | s150 | ÖK x-led
12 | Ø8 rak | s150 | ÖK y-led
3 | Ø10 rak 1 200 – | UK över rören
3 | Ø10 rak 650 | – | UK över rören, vid trapphålet
13 | Ø10 rak 1 200 – | ÖK diagonalt
14 | Ø10 L 650+500 s200/s300 vinkeljärn
Ö-Ø8 Ø8 rak | – | zoner R-06.3
Ö-Ø10 Ø10 rak | – | zoner R-06.3
Ö-Ø12 Ø12 rak | – | zoner R-06.3
1. Allmänt, se R-06.1.
2. Rörens topplåt gjuts in kant i kant med plattans underkant. Röret centreras under plåten. Rörens mitt enligt tabellen på R-06.2 och R-05.1; P7 är två rör tätt intill varandra.
3. Överkantsarmeringens höjd kontrolleras före gjutning, särskilt vid rören.
4. Väggarnas översta halva skift, också innerväggarnas, gjuts samtidigt med bjälklaget, i den ordning K-06 anger. Bjälklagets form och stämp står för sig själva och hänger inte i Kub-elementen. Pos 14 binds till väggens lodräta järn före gjutning.
5. Formrivning tidigast när betongen nått cirka 70 % av fck (provkroppar eller mognadsberäkning). Last under byggtiden högst 5 kN/m², punktlaster över rör eller vägg.
6. Trägolv limmas först när betongens relativa fuktighet är under golvlimmets gräns (mätt enligt RBK). Våtrum får sprickupptagande tätskikt.
7. Plan: underkant R-06.2, överkant R-06.3.

### Teckenförklaring

armering i underkant
armering i överkant
betong C30/37
betongkärna, Kub 350-150 (K-06) cellplast
fyllning
stål
Rev Avser | Datum | Sign
A | Första utgåvan | 2026-10-08 | VO

PROJEKT

### Fritidshus Trebodar, Resö, Tanum

FASTIGHET

### Resö 2:66, Tanums kommun · BYGG.2025.2278

INNEHÅLL

## Mellanbjälklag Sektioner, detaljer och stålförteckning

SKALA 1:5, 1:10, 1:20 | FORMAT A3 | DATUM 2026-10-08
UPPRÄTTAD Viktor Ogeman | GRANSKAD – | UNDERLAG K-05 rev A, K-06 rev A
STATUS KONSTRUKTION | | REVISION A

R-06.4

R-06.4 · 1:5, 1:10, 1:20 vid utskrift på A3 · Mått i mm om inte annat anges
