vron/trebodar/ritningar/201 Planritning.pdf

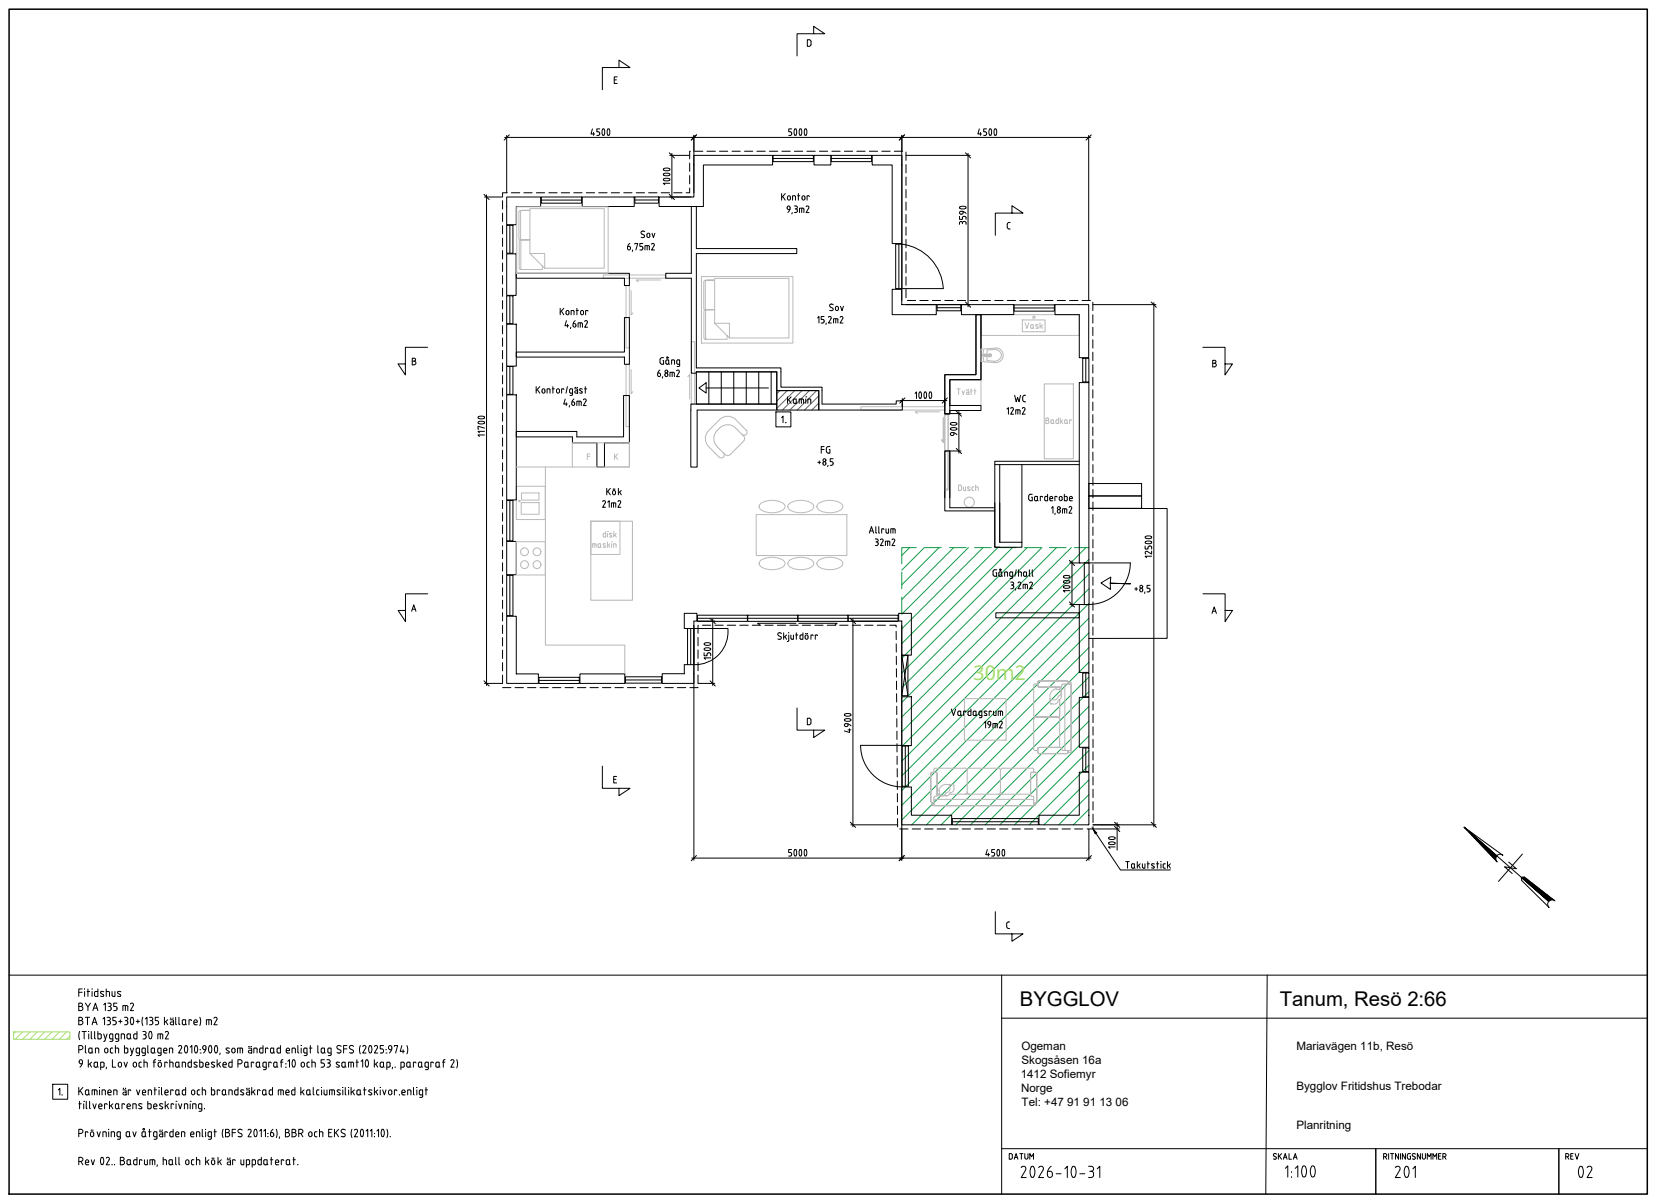
[picture p117: page 1]
Skogsåsen 16a 1412 Sofiemyr; Tel: +47 91 91 13 06; Mariavägen 11b, Resö; Tanum, Resö 2:66

Bygglov Fritidshus Trebodar
