vron/trebodar/ritningar/R-03 Mellanbjälklag.pdf

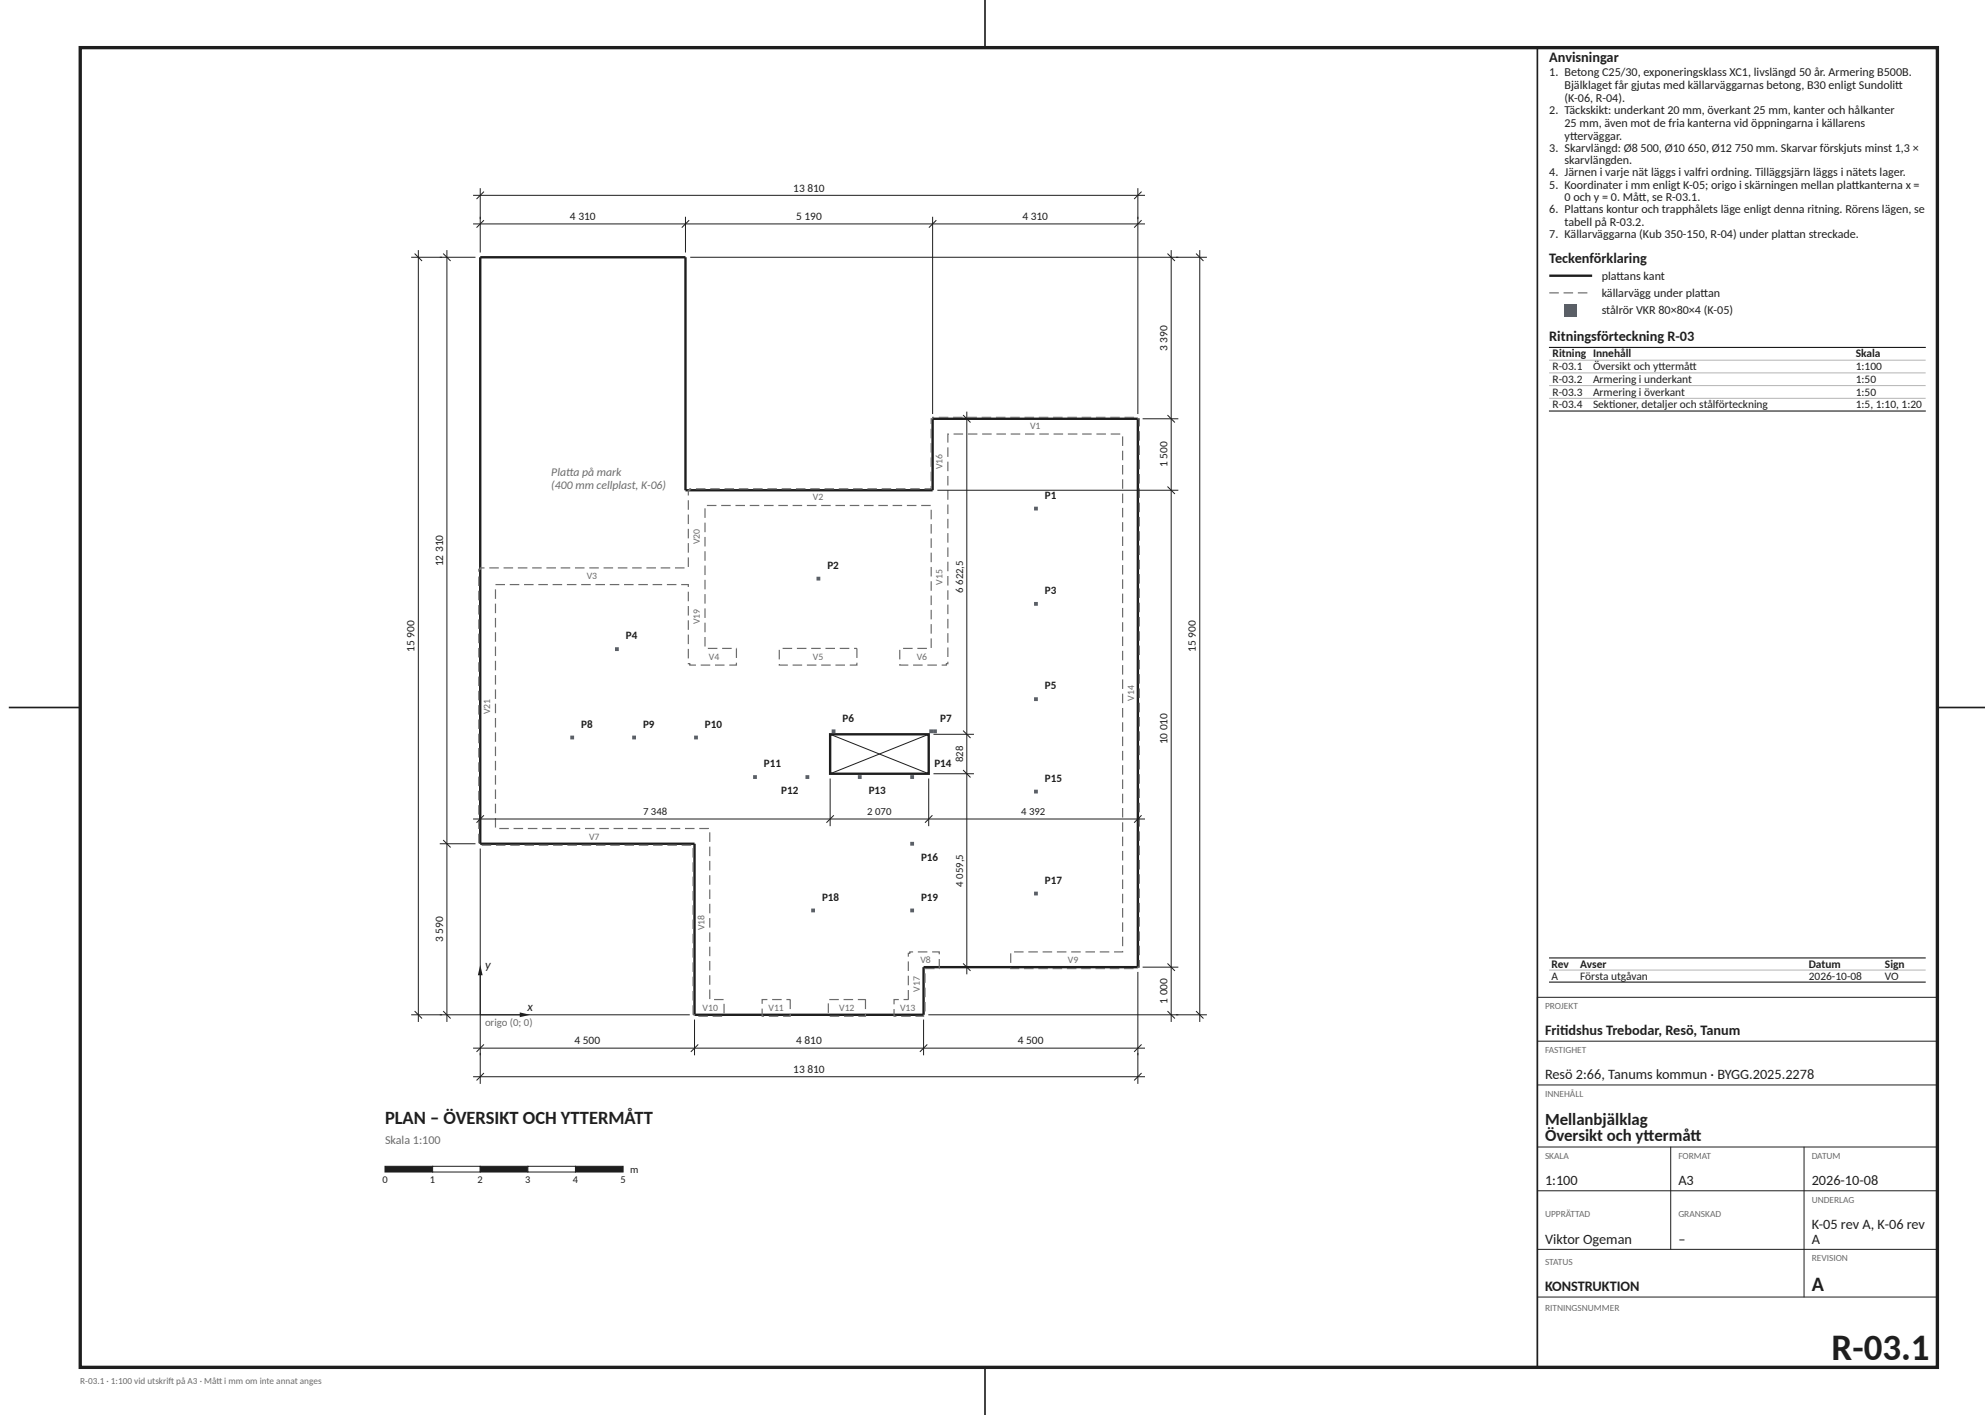
[picture p118: page 1]

Anvisningar
1. Betong C25/30, exponeringsklass XC1, livslängd 50 år. Armering B500B.
Bjälklaget får gjutas med källarväggarnas betong, B30 enligt Sundolitt
2. Täckskikt: underkant 20 mm, överkant 25 mm, kanter och hålkanter
25 mm, även mot de fria kanterna vid öppningarna i källarens
ytterväggar.
3. Skarvlängd: Ø8 500, Ø10 650, Ø12 750 mm. Skarvar förskjuts minst 1,3 ×
skarvlängden.
4. Järnen i varje nät läggs i valfri ordning. Tilläggsjärn läggs i nätets lager.
5. Koordinater i mm enligt K-05; origo i skärningen mellan plattkanterna x =
0 och y = 0. Mått, se R-03.1.
6. Plattans kontur och trapphålets läge enligt denna ritning. Rörens lägen, se
tabell på R-03.2.
7. Källarväggarna (Kub 350-150, R-04) under plattan streckade.
Teckenförklaring

PROJEKT
Fritidshus Trebodar, Resö, Tanum

FASTIGHET
Resö 2:66, Tanums kommun · BYGG.2025.2278

PLAN – ÖVERSIKT OCH YTTERMÅTT

SKALA 1:100 | FORMAT A3 | DATUM 2026 -10 -08

UPPRÄTTAD Viktor Ogeman | GRANSKAD – | UNDERLAG K-05 rev A, K -06 rev A

STATUS KONSTRUKTION | | REVISION A

-03.1 · 1:100 vid utskrift på A3 · Mått i mm om inte annat anges

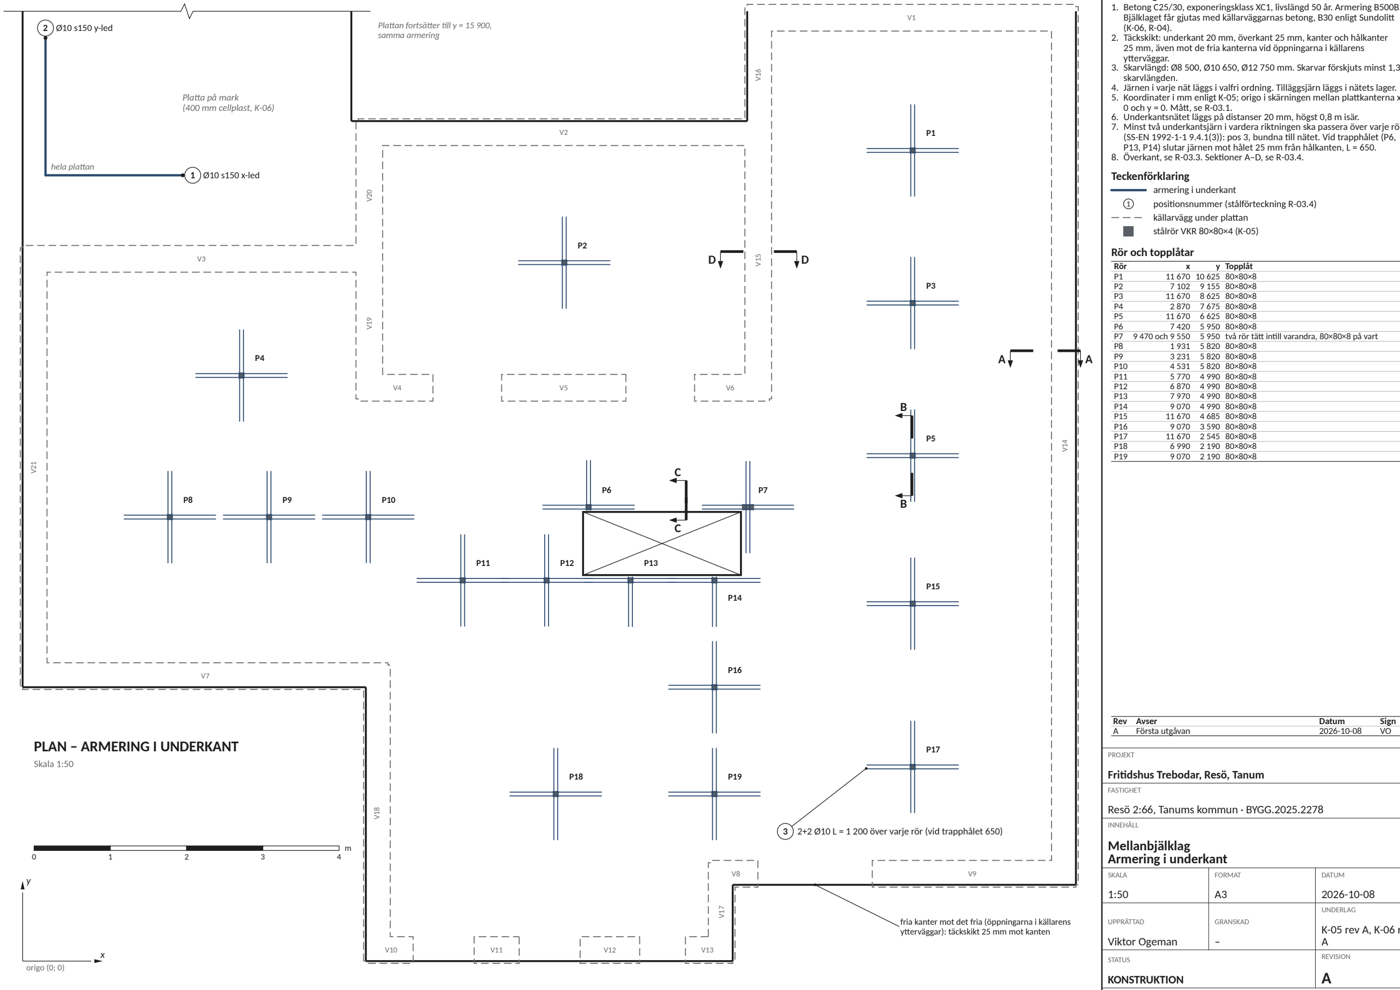
[picture p119: figure]
Plattan fortsätter till y = 15 900, samma armering; Platta på mark (400 mm cellplast, K-06); 1 Ø10 s150 x-led; 2 Ø10 s150 y-led; hela plattan; origo (0; 0); PLAN – ARMERING I UNDERKANT; Skala 1:50; ytterväggar.; skarvlängden.; 0 och y = 0. Mått, se R-03.1.; Teckenförklaring; armering i underkant; positionsnummer (stålförteckning R-03.4); källarvägg under plattan; stålrör VKR 80×80×4 (K-05); Rör och topplåtar; Rör; y Topplåt; Rev Avser; Datum; Sign; Första utgåvan; PROJEKT; Fritidshus Trebodar, Resö, Tanum; FASTIGHET; INNEHÅLL; Mellanbjälklag Armering i underkant; SKALA 1:50; FORMAT A3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

fria kanter mot det fria (öppningarna i källarens ytterväggar): täckskikt 25 mm mot kanten

3 2+2 Ø10 L = 1 200 över varje rör (vid trapphålet 650)

25 mm, även mot de fria kanterna vid öppningarna i källarens

3. Skarvlängd: Ø8 500, Ø10 650, Ø12 750 mm. Skarvar förskjuts minst 1,3 ×
4. Järnen i varje nät läggs i valfri ordning. Tilläggsjärn läggs i nätets lager.
5. Koordinater i mm enligt K-05; origo i skärningen mellan plattkanterna x =
6. Underkantsnätet läggs på distanser 20 mm, högst 0,8 m isär.
7. Minst två underkantsjärn i vardera riktningen ska passera över varje rör (SS-EN 1992-1-1 9.4.1(3)): pos 3, bundna till nätet. Vid trapphålet (P6, P13, P14) slutar järnen mot hålet 25 mm från hålkanten, L = 650.
8. Överkant, se R-03.3. Sektioner A–D, se R-03.4.
P7 | 9 470 och 9 550 | 5 950 två rör tätt intill varandra, 80×80×8 på vart

### Resö 2:66, Tanums kommun · BYGG.2025.2278

UPPRÄTTAD Viktor Ogeman | GRANSKAD – | UNDERLAG K-05 rev A, K-06 rev A

R-03.2

R-03.2 · 1:50 vid utskrift på A3 · Mått i mm om inte annat anges

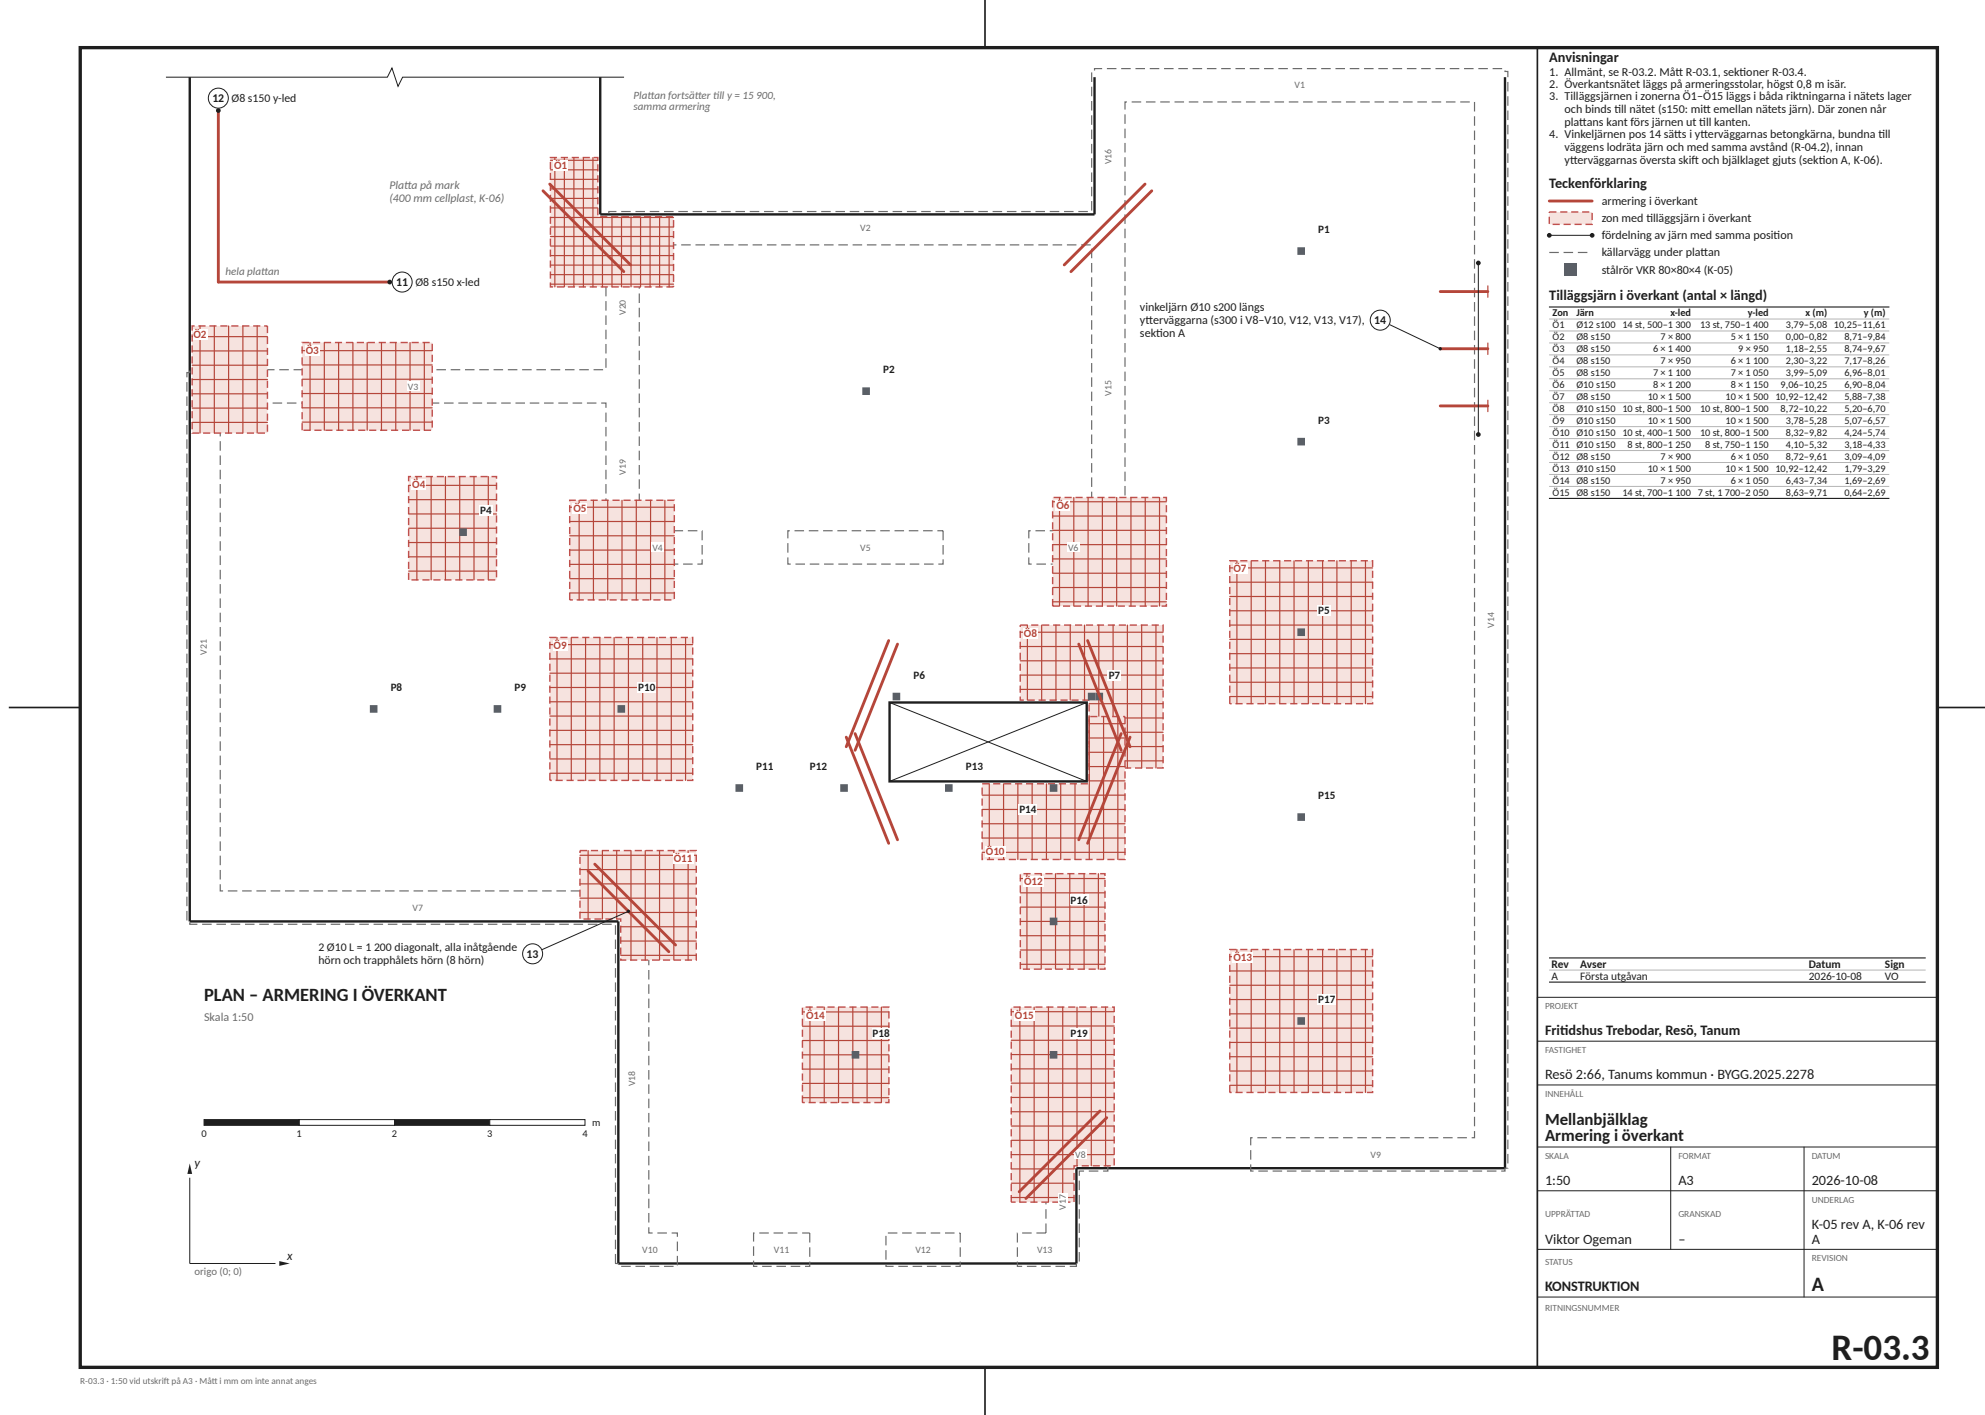
[picture p120: page 3]

1. Allmänt, se R-03.2. Mått R-03.1, sektioner R-03.4.
2. Överkantsnätet läggs på armeringsstolar, högst 0,8 m isär.
3. Tilläggsjärnen i zonerna Ö1–Ö15 läggs i båda riktningarna i nätets lager
och binds till nätet (s150: mitt emellan nätets järn). Där zonen når
plattans kant förs järnen ut till kanten.
4. Vinkeljärnen pos 14 sätts i ytterväggarnas betongkärna, bundna till
väggens lodräta järn och med samma avstånd (R-04.2), innan
ytterväggarnas översta skift och bjälklaget gjuts (sektion A, K-06).
Teckenförklaring

armering i överkant
zon med tilläggsjärn i överkant
fördelning av järn med samma position
källarvägg under plattan
stålrör VKR 80×80×4 (K-05)

Tilläggsjärn i överkant (antal × längd)

13 2 Ø10 L = 1 200 diagonalt, alla inåtgående
hörn och trapphålets hörn (8 hörn)

PROJEKT
Fritidshus Trebodar, Resö, Tanum

FASTIGHET
Resö 2:66, Tanums kommun · BYGG.2025.2278

SKALA 1:50 | FORMAT A3 | DATUM 2026-10-08

UPPRÄTTAD Viktor Ogeman | GRANSKAD – | UNDERLAG K-05 rev A, K-06 rev A

STATUS KONSTRUKTION | | REVISION A

R-03.3 · 1:50 vid utskrift på A3 · Mått i mm om inte annat anges

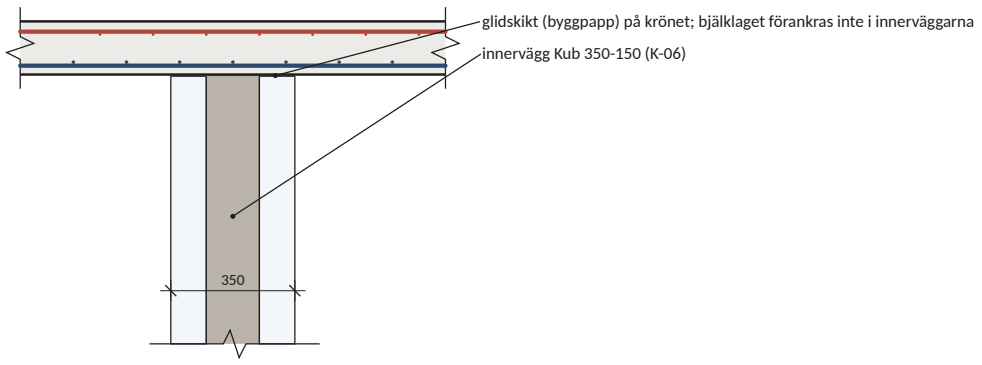
[picture p121: figure]
innervägg Kub 350-150 (K-06)
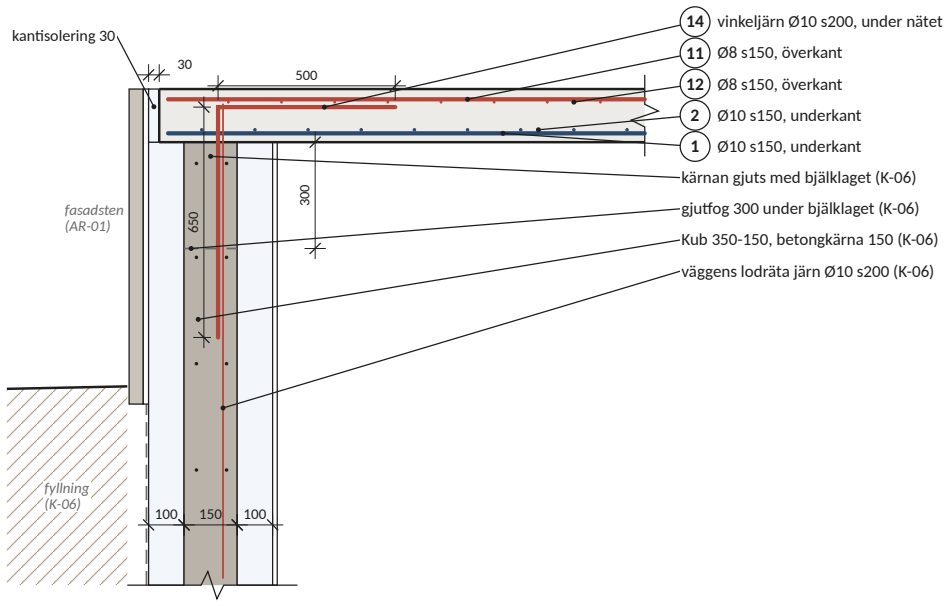
[picture p122: figure]
14 vinkeljärn Ø10 s200, under nätet; 11 Ø8 s150, överkant; 12 Ø8 s150, överkant; 2 Ø10 s150, underkant; 1 Ø10 s150, underkant; kärnan gjuts med bjälklaget (K-06); gjutfog 300 under bjälklaget (K-06); Kub 350-150, betongkärna 150 (K-06); väggens lodräta järn Ø10 s200 (K-06); kantisolering 30; fasadsten (AR-01); fyllning (K-06)

## SEKTION A–A Yttervägg mot jord (V14)

Skala 1:20

80

150

20 25

### 11 Ø8 s150, överkant

Ö7: Ø8 s150, båda riktningarna

3 2 + 2 Ø10 L = 1 200 över röret

### 1 Ø10 s150, underkant

topplåt 80×80×8 kant i kant med underkanten (P7: två rör)
rör VKR 80×80×4 S235

## SEKTION B–B Vid rör (P5)

Skala 1:10

glidskikt (byggpapp) på krönet; bjälklaget förankras inte i innerväggarna

## SEKTION D–D Innervägg (V15)

Skala 1:20

trapphål

båda näten går ut till hålkanten, täckskikt 25

### 13 diagonaljärn vid hålets hörn, se R-03.3 ²⁵

## SEKTION C–C Trapphålets kant

Skala 1:10

150

20 25

### 11 Ø8, lager 1

### 12 Ø8, lager 2

### 2 Ø10, lager 2

### 1 Ø10, lager 1

## DETALJ E Armeringens lägen

Skala 1:5

### Stålförteckning, B500B

Pos | Ø | Form | s | Antal L (mm) Total (m) Vikt (kg) Anm
1 | Ø10 rak | s150 | 122 | var. | 1 063 | 656 UK x-led
2 | Ø10 rak | s150 | 106 | var. | 1 057 | 652 UK y-led
11 | Ø8 rak | s150 | 122 | var. | 1 057 | 417 ÖK x-led
12 | Ø8 rak | s150 | 106 | var. | 1 053 | 416 ÖK y-led
3 | Ø10 rak | – | 70 | 1 200 | 84 | 52 UK över rören
3 | Ø10 rak | – | 6 | 650 | 4 | 2 UK över rören, vid trapphålet
13 | Ø10 rak | – | 16 | 1 200 | 19 | 12 ÖK diagonalt
14 | Ø10 L 650+500 s200/s300 | 236 | 1 150 | 271 | 167 vinkeljärn
Ö-Ø8 Ø8 rak | – | 121 | var. | 140 | 55 zoner R-03.3
Ö-Ø10 Ø10 rak | – | 112 | var. | 138 | 85 zoner R-03.3
Ö-Ø12 Ø12 rak | – | 27 | var. | 26 | 23 zoner R-03.3
| | | | | Summa | 2 539 Ø8: 888 + Ø10: 1 627 + Ø12: 23

Näten räknade över hela plattan (även plattan på mark) med en skarv per 12 m stång. Skarvlängd Ø8 500, Ø10 650, Ø12 750 mm.

25 mm, även mot de fria kanterna vid öppningarna i källarens ytterväggar.
3. Skarvlängd: Ø8 500, Ø10 650, Ø12 750 mm. Skarvar förskjuts minst 1,3 × skarvlängden.
4. Järnen i varje nät läggs i valfri ordning. Tilläggsjärn läggs i nätets lager.
5. Rörens topplåt gjuts in kant i kant med plattans underkant. Röret centreras under plåten. Rörens mitt enligt tabellen på R-03.2 och R-04.1; P7 är två rör tätt intill varandra.
6. Överkantsarmeringens höjd kontrolleras före gjutning, särskilt vid rören.
7. Ytterväggarnas översta halva skift gjuts samtidigt med bjälklaget, i den ordning K-06 anger. Bjälklagets form och stämp står för sig själva och hänger inte i Kub-elementen. Pos 14 binds till väggens lodräta järn före gjutning.
8. Innerväggarna gjuts i hela höjden före bjälklaget och får glidskikt (byggpapp) på krönet (R-04).
9. Formrivning tidigast när betongen nått cirka 70 % av fck (provkroppar eller mognadsberäkning). Last under byggtiden högst 5 kN/m², punktlaster över rör eller vägg.
10.Trägolv limmas först när betongens relativa fuktighet är under golvlimmets gräns (mätt enligt RBK). Våtrum får sprickupptagande tätskikt.
11.Plan: underkant R-03.2, överkant R-03.3.

### Teckenförklaring

armering i underkant
armering i överkant
betong C25/30
betongkärna, Kub 350-150 (K-06) cellplast
fyllning
stål
Rev Avser | Datum | Sign
A | Första utgåvan | 2026-10-08 | VO

PROJEKT

### Fritidshus Trebodar, Resö, Tanum

FASTIGHET

### Resö 2:66, Tanums kommun · BYGG.2025.2278

INNEHÅLL

## Mellanbjälklag Sektioner, detaljer och stålförteckning

SKALA 1:5, 1:10, 1:20 | FORMAT A3 | DATUM 2026-10-08
UPPRÄTTAD Viktor Ogeman | GRANSKAD – | UNDERLAG K-05 rev A, K-06 rev A
STATUS KONSTRUKTION | | REVISION A

R-03.4

R-03.4 · 1:5, 1:10, 1:20 vid utskrift på A3 · Mått i mm om inte annat anges
