vron/trebodar/(commit log)

2026-10-04 Rename K-02revA Nocklbalk - temperatur i stålplåtarna.pdf to beräkningar/K-02revA Nocklbalk - temperatur i stålplåtarna.pdf
2026-10-04 Lägg till källfiler för K-01 rev C och K-02 rev A
    Indata, beräkningsskript och Typst-mallar för båda dokumenten,
    hålbilder för plåtarna samt README med beskrivning och körinstruktion.
    Claude-Session: https://claude.ai/code/session_013BbmSBpBiyP4qCMDng4RtC
    [halbild_dalbalk2.csv, halbild_dalbalk4.csv, halbild_nockbalk1.csv, halbild_nockbalk3.csv, halbild_nockbalk5.csv]
2026-10-04 F-01: källare med stålpelare, ritningar R-01–R-05, ej aktuella handlingar borttagna
    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
2026-10-04 Lägg till modeller/balkplattor: STEP och DXF per stålplåt för laserskärning
    12 plåtar (över- och underplåt per bit) med hålbild Ø10,5 enligt K-01 rev C.
    generera.py skapar filerna från beräkningar/K-01/halbild_*.csv.
    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
    [DB2-1-O.dxf, DB2-1-O.step, DB2-1-U.dxf, DB2-1-U.step, DB4-1-O.dxf, DB4-1-O.step, DB4-1-U.dxf, DB4-1-U.step]
2026-10-09 Lägg till Onshape-modellen Hus Mark (STEP AP242)
    Hela huset med mark: källare, mellanbjälklag, stomme, gips, fönster och
    dörrar, berg och uppfyllnad. 748 delar med namn och färg, enhet mm.
    [Hus Mark.step]
2026-10-09 Lägg till verktyg/modellanalys: analys av STEP-sammanställningar
    ./ma läser en STEP-fil med exakt B-rep (OCP), delnamn och färger och cachar
    den. Kommandon: oversikt, trad, delar, info (exakta ytlägen och hörn), vy
    (3D-bilder med snittklipp och lock), snitt (2D-snittritningar med koordinater
    och vy bortom snittet), linje, punkt, matt, krock och jamfor.
    kontroll_r031.py jämför R-03.1:s yttermått och trapphål med modellen:
    yttermåtten stämmer exakt, trapphålet ligger 2,0 mm åt -x och 9,5 mm åt +y.
2026-10-09 Flytta husmodellen till modeller/trebodar.step
    Standardfilen i verktyg/modellanalys pekar nu dit.
    [trebodar.step]
2026-10-09 Mellanbjälklagets geometri exakt ur husmodellen; laster och fyllning enligt modellen
    - K-05: kontur, trapphål, rör, Lecaväggar, platta på mark och fria kanter hämtas
    exakt ur modeller/trebodar.step (bild/geometri.py) i stället för ur skärmbilder.
    - Ytterväggarna på plan 1 står med centrum 17,5 mm innanför plattkanten, över
    Lecans yttre skikt (laster.py VAGG_IN).
    - K-06: fyllning mot V18 1,41–1,52 m (avsatsen) och 0,80 m mot fasaden med
    öppningarna, som räknas som vägg med fri överkant mellan hörnen.
    Bottenplattans fältmoment tas minst d från balkar och plintar.
    - K-05 och K-06 omräknade, rapporterna i rapporter/ uppdaterade (rev A).
    - F-01: handlingsförteckni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
2026-10-09 R-03 som en pdf med ett blad per sida; exakta mått och lediga platser för namn
    - Ritningsserien blir ritningar/R-03 Mellanbjälklag.pdf; bladen kompileras var
    för sig och slås ihop (Blad.serie i ritningsmallen).
    - Mått som inte är hela mm visas med en decimal (t.ex. 4 059,5).
    - Rör- och zonnamn placeras där de inte korsar trapphålet, diagonaljärnen eller
    måttlinjerna; zonernas intervall i anvisningarna följer beräkningen.
2026-10-09 U-01: bottenplattans temperatur och fukt under året; övriga handlingar i F-01
    Transient 2D-värmeledning i sektion A–A genom källaren (husets största bredd,
    markytan ur modellen, plintar och uppbyggnad enligt K-06) i periodiskt
    tillstånd, med fuktkriterier, känslighetsfall och kontroller. F-01 får
    avsnitt 6 med egna underlag som inte ingår i tekniskt samråd.
2026-10-09 Granskning av AV-01, F-01 och K-01 införd
    AV-01: texter och behållare enligt markeringarna, glas borttaget.
    F-01: kommentarskolumnen och RP-01 borttagna, avsnitt 5 och 6 omformulerade.
    K-01: väggens funktion förklarad, resultat ur metodavsnittet, temperaturen
    enligt K-02, ψ0 förklarat, skjuvkraft per längdenhet, limfogens styvhet,
    enheter, huvudstolpen ur sammanfattningen. K-05, K-06, R-03 och K-03
    omräknade med K-01:s nya stödreaktioner.
    [halbild_dalbalk2.csv, halbild_dalbalk4.csv, halbild_nockbalk1.csv, halbild_nockbalk3.csv, halbild_nockbalk5.csv]
2026-10-09 K-01: skruv Rothoblaas HBS PLATE EVO 10×80, hål Ø13 i plåtarna
    Skruven är en bestämd produkt för utomhusbruk (C4, klimatklass 3) med mått och
    värden ur tillverkarens datablad och ETA-11/0030, och fotnot med länk till
    Ahlsell. Plåtarnas hål (Ø13, ansats Ø12) hör till skruven och läses av
    plåtgeneratorn ur K-01. Balkplåtarna och balkmodellerna är genererade om
    (786 hål) och kontrolleras av kontroll_balkplattor.py mot hålbilderna.
    Skruvplaceringen ger minst 7d i varje rad även vid zonskiften. Stödreaktionerna
    i K-05 och huvudstolpens krafter i K-03 är uppdaterade.
    [DB2-1-O.dxf, DB2-1-O.step, DB2-1-U.dxf, DB2-1-U.step, DB2.step, DB4-1-O.dxf, DB4-1-O.step, DB4-1-U.dxf]
2026-10-10 K-05: granskningen införd; beräkningarna läser inte längre modellen
    K-05 (granskningskommentarer):
    - Stolpe B står direkt på plattan, utan fotplåt; lasten i stolpens centrum
    (excentriciteten tas av stolpen och dess infästning, K-03).
    - P7 är två rör VKR 80×80×4 tätt intill varandra i x-led med vanliga
    topplåtar; ett rör räcker inte för genomstansningen i trapphålets hörn.
    K-06 och R-03 räknar och ritar dem (gemensam fotplåt 280 × 200 × 15).
    - Lagrens ordning i näten föreskrivs inte: böjning, sprickbredd och
    nedböjning räknas med det inre lagrets höjd i båda riktningarna.
    - Fria kanter mot det fria (öppningarna i källarens ytterväggar): XC3,
    täcksk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
2026-10-10 Åldringsbeständig plastfolie i stället för radonfolie; fria kanter med vanliga täckskikt
    - U-01, K-06 och AV-01: folien mellan cellplastskikten heter åldringsbeständig
    plastfolie (ingen certifierad radonduk).
    - K-05 och R-03: de fria kanterna vid öppningarna i källarens ytterväggar har
    samma täckskikt och nätlägen som övriga plattan. R-03.2 har en notering om
    täckskiktet mot kanten (25 mm, som vid alla kanter och hålkanter).
2026-10-10 U-02: ritning för fasadsten på källarväggarna av Kub 350-150
    Granit 40 mm på armeringsbruk med nät och isolerplugg (EJOT STR U 2G),
    fästmassa C2 S1, stödvinkel på rostfria konsoler med gängstänger i
    injektionsmassa (fischer FIS V) och Halfen UHA-7 i liggfogarna. Stenens
    framsida 55 mm utanför cellplasten. Beräkning av vinkel, konsol, ankare
    och plugg i U-02/berakning.py. U-02 i F-01:s övriga handlingar och
    stenens läge i modellens att göra-lista.
2026-10-10 U-02: enklare infästning, sten limmad på armerat bruk och stödvinkel
    Stenen limmas mot armeringsbruket med nät, pluggat genom nätet in i
    betongkärnan, som i de godkända systemen för natursten på cellplast.
    Inga infästningar i de enskilda stenarna (Halfen-ankarna borttagna).
    Stödvinkeln under nedersta skiftet bärs av gängstänger M16 A4 c/c 300
    genom cellplasten i stället för svetsade konsoler.
2026-10-10 U-02: fasadstenen enligt beställningen från Stengrossen
    Beklädnadsgranit Bohus Grå 600–1 200 × 400 × 30/50 mm (kluven framsida,
    sågad baksida) och hörnstenar 200–400 × 400, order 579. Stenens framsida
    45–65 mm utanför cellplasten, stödvinkeln 50 mm under färdig mark,
    dräneringsfogar i nedersta skiftet, fasadexemplet med 400 mm skift i
    slumpade längder. Modellens att göra-lista följer.
2026-10-10 Fasadstensritningen blir AR-01, egen serie för arbetsritningar
    U är utredningar; arbetsritningar för utförandet får serien AR. U-02
    döps om till AR-01 (källor, blad AR-01.1–AR-01.2 och pdf). F-01 avsnitt 6
    och CLAUDE.md beskriver serien.
2026-10-10 AR-01: inga rörelsefogar i stenytan, bara anslutningsfogar
    Stenen sitter på cellplasten, fri från betongen, och den längsta fasaden
    (cirka 11,7 m) rör sig bara några millimeter. De godkända systemen för
    natursten på cellplast kräver inga fältfogar. Kvar är anslutningsfogar
    mot karmar och andra material.
2026-10-10 AR-01: granskningen införd
    Mått med enhet i etiketterna, förankringsdjup i stället för hef,
    stödvinkel L 50 × 50 × 5 (standardprofil), droppkant 5 mm utanför
    stenens yttersta del, beslag enligt ritning, produkter "eller
    motsvarande", injektion med verktyg beskriven, toleransen för
    armeringsbruket 4 mm och inne/ute utanför väggen. Förutsättningar och
    dimensionering borttagna från ritningen; ritningen byggs bara när alla
    kontroller i berakning.py är uppfyllda.
2026-10-11 K-03: stolpe LD4_2 med 4 reglar i stället för 5
    Syllen 100 %, hammarbandet 84 %. Den nya regeln sätts vid x 4 325–4 370, centrerad under balkänden,
    och närmaste regel står tätt intill eller minst 60 mm ifrån.
2026-10-16 K-05, K-06: betongkärnans ändar vid öppningarna, bottenplattan L300
    Vid öppningarna slutar betongkärnan 100 mm innanför den isolerade smygen
    (modellen). Upplagslinjerna, de fria kanterna och fasadens pelare följer
    kärnan; kontroll_geometri05 tar fria ändar och öppningar ur kärnan. K-06
    räknar bara utförande L300 (100 mm betong på 200 mm cellplast), med
    öppningarnas betongbröstning 0,80/1,40 m, källarens kontur i V3:s och V20:s
    ytterliv och balken under V4-V6 i väggarnas centrumlinje. K-05, K-06 och
    R-03 omkörda; alla kontroller under 100 %.
2026-10-16 R-03, R-04, R-05: granskning av ritningarna mot varandra och modellen
    R-03.4: rörens mitt enligt tabellen på R-03.2 och R-04.1 (inte '±40 mm');
    R-03.1 hänvisar till R-04 för källarväggarna. R-04.1: öppningstabellen med
    betongens mått och den färdiga öppningen inom parentes, ritningsförteckning,
    måttkedjor flyttade från etiketter; små mått i kedjans ändar står på andra
    sidan måttlinjen. R-04.3: måttens referens (kärnans ändar) i anvisningarna.
    R-05: skarvlängder som R-03 (Ø6 400, Ø10 650), nätens längder med 12 m stång,
    ritningsförteckning, måttkedjorna utanför L-elementets ben.
2026-10-17 R-03, R-04, R-05: slutgranskning före utskick till betongentreprenören
    - R-04: snittpilen A på R-04.1 åt rätt håll; mått på V7 och V18; hänvisningar till
    R-04.5 rättade. Järnet under F1/F2 slutar 30 mm före F3 (550 förbi F2); lodräta
    järn och öppningarnas järn ritas upp i bjälklaget, i innerväggarna till 30 mm
    under krönet. Lodräta järn fördelas högst s200 fram till öppningarnas järn,
    under bröstningarna egen position 28. Den genomgående väggens järn skarvas 500
    vid T-anslutningarna; inga raka järn där vinkeljärnen räcker. Stålförteckningen
    räknas ur samma funktioner som ritar järnen, med kortade vinkeljärn och
    öppningarnas järn per län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
2026-10-17 L-element under väggens cellplast, S100/S300, smyglist enligt Sundolitt
    - L-elementens ytterkant i väggarnas ytterliv (= modellens bottenplatta); betongen
    börjar 100 mm innanför, i kärnans yttre yta, och kantbalken 450 står på foten.
    K-06 omräknad med den nya betongkonturen, R-04/R-05-sektioner, planer, detalj D
    (yttre hörn), mängder och U-01 (sektionen) uppdaterade.
    - Cellplast bara S100 under plattan och S300 under alla balkar och plintar (K-06:
    högst 97 %); hörnzonerna med S300 utgår.
    - Bottenplattan med balkar och plintar gjuts i en gjutning; fotplåtarna fixeras.
    - P7: alternativt två fotplåtar 140 × 200 × 15 kant i kant.
    - Öppningar enligt Sundolitts montering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
2026-10-17 L-element S300 höjd 300 (600 brett, avfasad rygg, cellplast in över foten); R-00 översikt i 3D
    - L-element S300, höjd 300, 600 × 1200 (t.ex. Finja): ryggen 100 avfasad i
    ovankant, betongen fyller fasen; foten 50 mm förbi kantbalken och plattans
    övre cellplastskikt in över den. Kantbalken står kvar på 450 mm S300, så
    K-06:s resultat ändras inte. R-04.4, R-05.1, R-05.3, K-06 (text och figur 4)
    och U-01 (fasen i värmemodellen) uppdaterade
    - Ny ritning R-00: betongarbetets bärande delar i 3D, utan mått (bottenplatta,
    källarväggar och rör, mellanbjälklag, snitt), med egen renderare och
    automatisk placering av hänvisningarna; R-00 i F-01:s lista
    - Ritningsmallen: bi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
2026-10-17 Betongritningarna efter granskning: kortare anvisningar, allmänt på första bladet, mått till plintar och balkar, smyglister och färdiga öppningar, C30/37 genomgående
    - R-04: kantbalk, balkar och plintar som en zon ut till ytterkanten (inga L-element i planen), mått till plintarnas och innerbalkarnas mitt från plattans ytterkant, detalj D förenklad, stålförteckning och cellplast utan mängder
    - R-05: material, gjutning och återfyllning på R-05.1, smyglister i planen, färdiga öppningsmått, kortare anvisningar, stålförteckning utan mängder
    - R-06: allmänna anvisningar bara på R-06.1, stålförteckning utan mängder
    - R-03: smyglister och kantisolering 30 i 3D, snittet geno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
2026-10-17 U-02: nock- och dalbalkar, lyft i två punkter
    Egentyngden vid lyft med stroppar i triangel, lastfaktor 1,35 × dynamisk faktor 2,0. Lyftpunkterna 3 000 mm isär symmetriskt kring tyngdpunkten ger högst 48 % (Nockbalk 5); avståndet itererat per balk mot högst 50 %. Tyngdpunkterna och lyftpunkterna per balk. U-02 i F-01 avsnitt 6.
2026-10-31 AR-02 Utsättning: koordinater i SWEREF 99 12 00 och höjder i RH2000
    Plan med fasadens utsida (F1–F12), bottenplattans kant (B1–B12) och plattan
    på marks kant (P1–P3) med koordinater, passade mot bygglovets situationsplan.
    Sektion med sprängbotten, makadam, bottenplatta, FG, skärningspunkt
    fasad/takplan och högsta punkt. AR-02 i F-01 avsnitt 6.
2026-10-31 AR-02: husets läge ur utsättningsdatan 09_91
    Fasadens hörn F1–F12 är utsättningsdatans punkt 1–12 (numreringen följer den).
    Läget passas in mot dem; de stämmer med fasadens mått inom 1 mm. Bottenplattans
    och plattan på marks punkter beräknas med samma läge. passning.py är nu en
    kontroll mot situationsplanen.
2026-10-31 AR-02: B är L-elementens ytterkant, fler decimaler i formeln
    Rubriken och teckenförklaringen anger att bottenplattans punkter är
    L-elementens ytterkant. θ, E0 och N0 med fler decimaler, så att punkterna
    räknade ur formeln stämmer med tabellerna.
2026-10-31 AR-02: plattan på mark med L-element 500
    P1–P3 är L-elementens ytterkant, i väggarnas ytterliv 30 mm utanför
    mellanbjälklagets kant, i linje med bottenplattans kant. Ny höjd: L-elementens
    och cellplastens underkant under plattan på mark, +8,000.
2026-10-31 AR-02: plattan på mark bakom snittet i sektion A–A
    Streckad kontur (L-elementens ytterkant och underkant) med nivån +8,000.
2026-10-31 Utredning: nock- och dalbalkar 190 × 200 (limträ 190 × 180)
    K-01 och K-02 räknade med Moelvens dimension: bredd 190, limträ 180, plåtar
    190 × 10, skruvrader 45/145 och 45/95/145, plåtarnas temperaturer ur K-02.
    Rapporter, ritningar och modell är inte uppdaterade.
2026-10-31 Nock- och dalbalkar 190 × 200: limträ 190 × 180, plåtar 190 × 10
    Moelvens dimension, så att limträet inte behöver specialtillverkas.
    - K-01: skruvrader 45/145, limfogens styvhet efter bredden, plåtarnas
    vintertemperatur ur K-02; temperaturtexten följer indata.
    - K-02: balkens bredd och limträets höjd, figurens etiketter ur indata.
    - K-05: K-01:s stödreaktioner och dalbalk 2:s last; K-03: balkens höjd och
    bredd i upplaget och figurerna, huvudstolpens krafter ur K-01.
    - Omräknade: K-03, K-05, K-06, U-02, R-01, R-03–R-06. Balkplåtar och
    balkmodeller genererade om; kontroll_balkplattor stämmer.
    - R-01: måtten ur K-01, detalj D och tre rader bara där de används.
    - mode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
2026-10-31 Granskning av balkändringen: K-02:s nock, K-01:s temperaturer, texter
    - K-02: balken når 3 mm ned i gipsens plan under nocken; gipsen ligger an mot
    underplåten (geometrin klipps), texten följer geometrin. Överplåt −16,6 °C,
    underplåt +16,0 °C, skillnad 25–35 K.
    - K-01: vinterfallet och temperaturtexten efter K-02; 726 skruv. Balkplåtar,
    balkmodeller, R-01, U-02, K-03, K-05, K-06 och R-03–R-06 omräknade.
    - K-03: sätets bredd ur indata; K-05: K-01:s laster och vindlyft ur laster.py.
    - R-01 README: detalj D. Oanvänd HEA-styvhet borttagen ur K-01.
2026-11-01 U-03: takets luftspalt – luftflöde, fukt och mögelrisk; Intello Plus i K-02 och F-01
    U-03 räknar hela taket som ett nätverk: en remsa per fack, nockar, dalar,
    takfönster med omluftning, valfria kanaler längs nockar och dalar och
    gavelöppningar. Luftflöde, temperatur, fukt och mögelindex (VTT) timme för
    timme med ERA5-klimat för Resö 2013–2023, med zink-magnesiumplåt på
    bitumenpapp, Intello Plus och badrummet under TF1. 36 fall.
    K-02 och F-01 får ångbromsen Hunton Intello Plus i takets uppbyggnad
    (försumbart värmemotstånd, ingen vikt). F-01 listar U-03 i avsnitt 6.
2026-11-01 U-03: rekommenderat utförande 36 mm med omluftning, granskning av rapporten
    Rekommenderat utförande (36 mm fri höjd, omluftning 300 mm) räknat vid full,
    halv och en fjärdedels vindtryck, huset tomt på vintern vid 10 och 15 °C och
    strypta takfötter vid svag vind. Rapporten får en lista med beslut först,
    mål och gräns för mögelindex, svar om oventilerad spalt och tomt hus, dal-
    balkarnas läge mot K-03, grupperad tabell, fönsterfacken för sig i figurerna
    och omluftningen som principskiss. F-01: zink-magnesiumplåt på underlagspapp.
2026-11-01 Kodgenererad modell: ramverk (verktyg/modellering) och stommen i modeller/trebodar
    Ramverk: recept som data, OCCT-kärna med beständig cache och parallell beräkning,
    export till STEP (sammanställningar, namn, färger), GLB och materiallista, kontroll
    av krockar, kontakter och glipor, jämförelse med Onshape-modellen.
    Modell: prefabstommen (ytterväggar, bärande innerväggar, takstolar, stolpar, takbalkar
    med takfönster) och nock- och dalbalkarna enligt K-01. Takplanen 10 mm högre än i
    Onshape-modellen, så att skiva och luftspalt går över dalbalkarna. Modell-todo 1–7,
    18 och 19 utförda i modellen.
2026-11-01 Modellen: yttertak, fasader, fönster och dörrar, isolering
    Yttertaket med hårdboard 3, ströläkt 34×45 (på varje takbalk och två mellan, uppehåll
    600 mm vid takfönstren enligt U-03), råspont, papp och plåt, takfönster TF1–TF3.
    Fasader per vägg: utegips, ströläkt, spikläkt och panel som egna grupper. Fönster och
    dörrar förenklade. Isolering mellan takbalkarna och i väggarnas regelfack. Kontrollen
    redovisar avsiktliga överlapp (spikplåtar under utegips) och filtrerar skiktglipor.
2026-11-01 Modellen: grund, källare, mellanbjälklag, mark, installationer, invändiga skikt
    Källarväggarna V1–V21 som Sundolitt Kub 350-150 med sammangjutna kärnor och
    bröstningar vid F1–F3, rören P1–P19 som VKR 80×80×4 med topp- och fotplåtar (P7 två
    rör), bottenplattan på en nivå, plattan på mark med cellplast och fyllning, fasadstenen
    15 mm ut, mellanbjälklaget med trapphål. Marken och VVS ur Onshape-modellen som
    referensdelar (modeller/referens/delar). Ångbroms, installationsskikt och gips i tak
    och på ytterväggarnas insida. Stolparna i väggarna heter som i K-03 och K-05.
2026-11-01 Procedurella material för renderingen, städning av modellkoden
    Material har typ och parametrar för renderingen (rendering(...)); Blender bygger dem
    som nodträd utan bildtexturer: virke med årsringar, limträ med lameller, sågade
    brädor (Falu rödfärg, järnvitriol, obehandlat) med fogar och färgskiftning, falsad
    plåt, sten i skift, betong, mark m.fl. Riktningar i delens eget system. Fasadpanelen
    väljs per huskropp. mod rendera --blend sparar scenen med en kamera per vy.
    Städning: gemensamma hjälpfunktioner för plana former, receptens omslutande lådor
    utan kärnan (modellen anropar inte OCCT), död kod borttagen, README med hur man ändrar.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
2026-11-01 Modellen: fasadstenen som kluvna stenar, takplåt i banor med falsar, rikare material
    Fasadstenen (AR-01) är enskilda stenar med kluven framsida som triangelnät (30–50 mm), i 400 mm skift med
    slumpade längder, hörnstenar i varannat skift, fogbruk och armeringsbruk; måtten läses ur AR-01:s indata.
    Takplåten ligger i banor 525 med stående falsar. Ramverket får polyedrar som recept, STEP utan 2D-kurvor
    (hela huset 37 MB i stället för 58) och fel från Blender syns.
    Renderingens material: varje bräda sågad ur en stock (årsringar, kvistar, sågad yta, strimmor, skruvar i
    spikläktens rader), granit med mineralkorn och brottytor, plåtbanor som skiftar och buktar; färgerna efter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
2026-11-01 mod onshape: bara importinställningar som Onshape klarar
    Onshapes standard behåller sammanställningar och färger; några av de övriga inställningarna gav internt fel.
2026-11-01 mod onshape: varna när modellen har fler montage än Onshape behåller per import
    Onshape behåller högst 100 sammanställningar per import och slår ihop de djupaste nivåerna; hela huset har 337.
2026-11-01 Innertaket: gipsen möts i skarpa linjer i nockarna och under dalbalkarna
    Installationsskiktet under taket är 70 mm (läkt 45×70 på högkant), så att gipsen går fri under nock- och
    dalbalkarna (kontrolleras ur skelettet); gipsen går till nocklinjen och dallinjen och möter grannfallets gips där.
    Stolpar, strävor och väggar som står under innertaket tas ur stommens montage och skikten går runt dem, så att
    innertaket inte längre har springor där innerväggarna inte når. Ytterväggarnas insida slutar under innertaket vid
    takfoten och följer snedtaket på gavlarna. Ny vy inne-dal. Kontrollen: exakt 2 mm räknas inte som glipa.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
2026-11-01 Innertaket: korslagd läkt 45 enligt F-01, den yttre gipsskivan går under balkarna
    Den yttre gipsskivan (12,5) går 5,4 mm under nockbalkarna och 8 mm under dalbalkarnas hörn och möter
    grannfallets i en skarp linje; ångbromsen, läkten och den inre skivan slutar vid balkarna.
2026-11-01 Material med två utseenden: CAD-färg och verkligt utseende för renderingen
    Varje material har en CAD-färg (STEP, Onshape, webbvisaren) vald så att olika slags delar skiljer sig åt i
    stil med ritningarna, och det verkliga utseendet för Blender. Läkten är ett eget material (C24_LAKT). Webbvisaren
    listar materialen med sina färger, kan dölja dem var för sig och växla till de verkliga färgerna.
2026-11-01 Kontrollerna mot handlingarna läser den kodgenererade modellen; bottenplattan i hela källaren
    kontroll_geometri05, kontroll_r061, kontroll_r045 och kontroll_laster läser den kodgenererade modellen med dess
    namn i stället för Onshape-modellen: K-05:s geometri, R-06.1:s måttkedjor och R-04/R-05 stämmer helt. Det första
    röret i P7 jämförs med K-05 (det andra ligger 80 mm åt +x, som K-05:s DUBBELROR). modellanalys varnar när
    STEP-filen är äldre än modellens kod.
    Kontrollen hittade att bottenplattan bara låg under källarväggarna: konturen togs ur väggarnas ring, som
    dörrarna bryter. Öppningarna sluts nu innan konturen tas, och plattan täcker hela källaren (132,1 m², som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
2026-11-01 Bottenplattan enligt R-04: kantbalk, balkar under innerväggarna, plintar och L-element
    Betongen 100 mm innanför väggarnas ytterliv, kantbalk och balkar under V4–V6, V15 och V19 450 × 200, plintar under
    rören med sidan ur K-06:s resultat.json, alla på 100 mm cellplast S300, L-element S300 längs kanten och cellplasten
    S100 i två lager. kontroll_r045 jämför också betongen, balkarna och plintarna och L-elementen med R-04 (stämmer) och
    redovisar rören, matkällarens golv och kärnornas anslutningar som vanliga kontroller. Bottenplattans nivå i skelett.py
    (Z_BOTTENPLATTA), bergschaktet ur plattan på marks kontur. modell-todo: planritning 201 rev 02 mot innerväggarna 1A
    och 1C och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
2026-11-01 modell-todo och README: gipsen på de bärande innerväggarna saknas
2026-11-01 Webbvisaren: visa bara, tona ner resten och dölj med högerklick; sökning i modellträdet
    Högerklick på en del (delen och grupperna den ingår i), en grupp i trädet eller ett material ger en meny med visa
    bara, tona ner resten (90 % genomskinligt), dölj, zooma, visa i trädet och visa allt; Esc avslutar. Fokus står i
    adressen (#bara=<sökväg>, #tona=<sökväg>), så att en vy kan delas med en länk. Trädet och menyerna visar modellens
    namn (inläsaren bytte mellanslag mot _), och med panelen öppen hamnar kamerans mitt i den fria delen av fönstret.
2026-11-01 Webbvisaren: mät kanter, avstånd och parallella kanter, också i snitt
    Mätverktygen uppe till höger (K, A, P): en rak kants längd, avståndet mellan två punkter med Δx, Δy och Δz och det
    vinkelräta avståndet mellan två parallella kanter. Pekaren snäpper till hörn, kanters mitt, kanter och snittets
    konturer (snittytorna sparar sina konturer) och annars till ytan; skymda punkter räknas inte, och en kant som nätet
    delat upp i flera räknas som en.
2026-11-01 AR-02: utgående rör ur brunnen dimensioneras 20 mm högre än inmätt (+5,779)
    Marginal uppåt för GNSS-mätningens och måttbandets osäkerhet, så att dränvattnet säkert får fall.
2026-11-01 Plattan på mark med L-element 500 (AR-02), schakt i berget och marken mot källarväggarna (K-06)
    Plattan på mark: L-element 500 längs de fria kanterna (ytterkanten i väggarnas ytterliv), mellanbjälklagets betong fram
    till L-elementens rygg, cellplast 100 + 250, makadam 150 och dränerande fyllning i ett schakt i berget 100 mm utanför
    plattan, med makadam mellan L-elementen och schaktets kant upp till markytan. Fyllning mot källarväggarna upp till
    K-06:s fyllnadshöjder där Onshape-modellens mark inte når upp (en boolesk operation per verktyg). Nya material: makadam,
    OSB, plywood, tätskikt, kakel. kontroll_geometri05 och kontroll_r061 jämför plattans kontur i väggarnas liv (bet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
2026-11-01 Innerväggar enligt planritning 201 rev 02: lätta väggar, skikt på alla innerväggar, skjutdörrar
    Lätta väggar L1–L12 (stomme 45×70) och skikten på de bärande och de lätta innerväggarna: OSB 12 och gips 13, mot
    badrummet plywood 15, gips 12, tätskikt och kakel, från bjälklaget upp till innertaket. Stommarna möts och skikten
    slutar mot de genomgående väggarnas skikt; ytterväggarnas insida går runt de bärande väggarna med skikt. Innerdörrarna
    ID1–ID6 är skjutdörrar enligt planritningen (en lista i oppningar.py som väggarna, skikten och dörrarna läser); 2B sluten
    söder om trappan, 2C vid väggens början, syllarna för de lätta väggarna flyttade från prefabsto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
2026-11-01 Mittstolen 2C: toppklossen bara på den nordöstra sidan, inne i väggens tjocklek
    På den sydvästra sidan skulle klossen gå ut genom väggens gips. modell-todo: K-03 redovisar säte 90 mm på 2C
    (109 % med den förenklade kontrollen, omkring 86 % med effektiv upplagslängd och k_c,90 enligt EN 1995-1-1 6.1.5).
2026-11-01 Webbvisaren: navigering som i CAD-program
    Hjulet för kameran mot punkten under pekaren, ett steg en andel av avståndet dit (minst 20 mm) med rotationscentrum
    som följer med, så att man kommer hur nära som helst och genom väggar; vridning och panorering kring djupet för
    punkten där man tar tag; piltangenterna och PgUp/PgDn går genom huset; närplanet följer avståndet.
2026-11-01 Trätrappan till källaren (K-05: 3,0 × 0,83 m) i trapphålet
    Rak trappa av furu från bottenplattan till plan 1 vid 2B: vangstycken 45×270 och 12 steg 38 mm, 13 steghöjder à
    173 mm och stegdjup 250 mm.
2026-11-01 Kaminen Rais 600 i väggen 2C med rökrör och isolerad skorsten genom taket; väggarna runt trapphålet och kaminens kåpa
    Insatsen i öppningen i 2C mot allrummet (Rais ritning 11-0000-6550), kroppen i en kåpa av kalciumsilikat (lätta
    väggar L7, L13, L14; skikten mot kåpan kalciumsilikat), omfattning i väggens liv, rökrör Ø150 med 45° förskjutning
    förbi nockbalk 3 och isolerad skorsten Ø150/Ø250 till 800 mm över nocken med regnhuv och krage. Hålet genom innertak,
    isolering och tak (50 mm till brännbart) skärs med en generell genomföring (byggdelar/genomforing.py). modell-todo:
    trappans fria höjd och kaminöppningen under takstolen 2C:s topp.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
2026-11-01 Fasaden grå på mittre och höger huskropp, innerdörrarna av trä, mätningens komponenter i en ruta
    Bara den södra huskroppen (1) är röd. Skjutdörrarnas blad är av trä. Webbvisaren visar den senaste mätningen
    (kant, avstånd eller vinkelrätt avstånd mellan parallella kanter) med Δx, Δy och Δz i en ruta under mätknapparna;
    etiketterna i vyn har bara måttet.
2026-11-01 Fönster och dörrar enligt Elitfönsters snittritningar, parametriskt (byggdelar/fonster.py)
    Original Alu 100 vridfönster, fast karm och altandörr helglasad och Skjutdörr Alu ASP4 med profilerna mätta på
    tillverkarens ritningar; karmen 20 mm mindre än modulen (öppningen), aluminiumet i panelens utsida och fasaden fram
    till karmen. Typerna enligt användaren, källarens fönster F1-F3, drevning, smygbrädor och fönsterbänk (kakel i
    badrummet).
2026-11-01 Takfoten: isolerstopp på hammarbandet i varje fack, hårdboarden slutar på det, råspont, papp och plåt 20 mm utanför takbalkarna
2026-11-01 Webbvisaren: snittytornas konturer framför ytorna, så att gränsen mellan delar av samma material syns
2026-11-01 Kaminen inbyggd enligt Rais monteringsanvisning: kasse av 50 mm kalciumsilikat med konvektionsöppningar och plåt, skorstenens isolerade del från kassen, förbränningsluft Ø120 ut genom källaren
2026-11-02 Fickdörrar som i Onshape-modellen: ID1, ID3 och ID4, fickan hela stommen med brädor i stället för OSB
    Öppningar och fickor ur Onshape-modellens fickdörrar (blad 75 mm bredare än öppningen, fickan 55 mm längre än
    bladet). Vid fickan: gips 13 + bräda 12 + ficka 70 + bräda 12 + gips 13, inga reglar eller läkt i fickan. En regel
    som skulle överlappa en annan utgår. ID2, ID5 och ID6 förblir skjutdörrar utanpå: deras fickor går genom stolparna
    LD2_2, LN1_1 och LD4_1 (modell-todo 8).
2026-11-02 Armeringen i betongen ur R-04, R-05 och R-06
    Mellanbjälklagets, källarväggarnas och bottenplattans järn som stänger i modellen, ur ritningarnas egna funktioner
    för järnen (samma som ritar dem och räknar stålförteckningarna); näten i R-04 och R-06 som egna funktioner
    (stålförteckningarna oförändrade). Lika järn är samma del. Kontrollen: nya regler för materialpar som inte prövas
    (armering mot betong och mot armering, räknas som anliggande); inga glipor där överlapp är tillåtna. Kvar: kaminens
    förbränningsluft genom bjälklaget och V12 krockar med järnen (flyttas).
2026-11-02 Kaminens förbränningsluft upp genom taket i stället för genom källaren
    Flexslang Ø100 (Rais AirSystem, högst 5 m) från anslutningen under insatsen, genom det västra stödet, upp bredvid
    insatsen och genom plåten; över plåten isolerad kanal Ø100/Ø160 bredvid skorstenen i samma fack, genom innertaket och
    taket, med huv på stag och krage. Kåpan 220 mm bredare mot väster för kanalen (insatsen på samma plats); plåten följer
    kåpans insida. Hålen i bjälklaget, V12 och fasaden och gallret är borta, inga krockar med armeringen.
2026-11-02 Fönstrens och dörrarnas aluminium RAL 3009 på den röda huskroppen och RAL 7012 på de grå
    Två pulverlackerade material (halvblanka, ny renderingstyp pulverlack med apelsinyta) i stället för ett; produkterna
    får aluminiumets material, kulören per huskropp i fasad.ALUMINIUM bredvid panelen.
2026-11-02 Fasadstenen som i Onshape-modellen: från källardörren D1:s östra smyg, underkanten i steg
    Beklädnaden på högra huskroppen börjar vid D1:s östra smyg (x 11 140) i stället för i hörnet, och underkanten går i
    hela skift efter Onshape-modellens steg (3NO −2 150/−1 750, 3NV −1 750/−1 350, 3SV −1 350/−950). Fasaden slutar i
    bjälklagets underkant där stenen går upp dit och över källardörrarna (kallarvaggar.dorrar), annars vid marken.
2026-11-02 Takstolarna tätt mot nock- och dalbalkarna
    Takstolarnas delar går fram till balkarnas sidor (Onshape-modellens takstolar
    var gjorda för HEA 200 och slutade 8 mm från de 190 breda balkarna), också
    ytterbalkarnas övre ändar vid dalbalkarna; underramens sneda ändar följer de
    lyfta diagonalerna. Gavelväggarna 1NO och 3NO går fram till dalbalkarnas
    ändar, och väggen 3SO har hammarbandet i z 2 490 som de andra, så att
    takbalkarna vilar på det. Stolparna LN3_1 och LN5_2 står till hälften utanför
    nockbalkarna: modell-todo punkt 10.
2026-11-02 Gips 13 på källarväggarna
    Källarväggarnas cellplast får gips 13 mm (brandskydd): på ytterväggarnas
    insida och båda sidor av innerväggarna, runt väggändarna i D2 och D3, i
    fönstrens smyg från karmen och på bröstningen. Källardörren D1 finns inte i
    modellen; smygens gips går till kärnans utsida.
2026-11-02 Insidans skikt runt ytterhörnen vid dalarna
    Där en gavel går förbi en långsidas ände (1NO–2SO, 2SV–1NV, 2NV–3NO och
    2SV–3SO) slutade gavelns insida 165 mm före hörnet och långsidans vid väggens
    ände, så att stommen och skiktens ändar syntes. Nu går skikten runt hörnet var
    för sig: gavelns fram till långsidans, långsidans förbi gaveln, med hel
    ångbroms och bara gips synlig. Gavelns insida följer taket över grannkroppen
    (tak_underkant), innertaket slutar mot den utan glipa, och gavelns skikt går
    runt takets stomme där den når in i skikten.
2026-11-02 Dalarnas ändar: ändlåda med rörstos och eget stuprör i hörnet
    Dalarna slutade vid den kortare kroppens gavel med kilens och skiktens ändar
    öppna och vattnet rann ut på grannkroppens takfot. Nu tar en ändlåda av plåt
    (105 × 100, botten 40 mm under dalens botten) emot vattnet i hörnet under
    gavelutsticket, med en rörstos Ø75 falsad i botten och eget stuprör Ø75 ned i
    hörnet (plåtslagarens detalj). Rändalen, den kortare kroppens utstick och den
    längre kroppens tak viks ned i lådan; den yttre kanten är lägst, så att vattnet
    rinner ut till grannkroppens ränna om stosen sätts igen. Den längre kroppens
    takfot och ränna slutar vid gavelutstickets kant (tak.py, ande) och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
2026-11-02 Modellens struktur: beroenden i en riktning, gemensamma underlag och kontroll av strukturen
    Geometrin är oförändrad (samma 6 166 delar med samma lådor och volymer; dalarnas
    16 delar ligger nu under Tak/Dalar).
    - Inga importcykler: de invändiga skiktens uppbyggnad i invandigt/skikt.py och
    takfallens regioner och takyta i tak/takytor.py (bröt invandigt ↔ vaggar och
    fasad ↔ tak ↔ takkanter).
    - Invändigt delat: innertak.py, vagginsida.py (ytterväggarnas insida och hörnen),
    vaggar.py, kallare.py; invandigt.py sätter ihop. Dalarna i tak/dalar.py.
    - Marken vid fasaderna (genererad tabell) i fasad/markniva.py, kulörerna per
    huskropp (PANEL, ALUMINIUM) i material.py: fönstr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
2026-11-02 ./mod avtryck spara|jamfor: modellens fingeravtryck för omstruktureringar
    Varje dels sökväg, namn, material, låda, volym och tyngdpunkt sparas före och
    jämförs efter; flyttade delar paras på namn. Dokumenterat i ramverkets och
    modellens README och i CLAUDE.md.
2026-11-02 Rättelser i stommen: regelstyckena vid dalbalkarnas upplag, huvudstolpens strävor, 1SV:s fotplåt
    - Regelstyckena intill dalbalkarnas ände i 1NO och 3NO går exakt upp till hammarbandet (höjden var avrundad till
    41,0769 och slutade 0,05 µm under); facket ovanför den sänkta liggaren (350×41) blir slutet och isoleras.
    - Huvudstolpen LN1_3:s strävor är 120·√2 i lodled (var avrundat till 169,706, 0,0004 mm).
    - 1SV:s spikplåt på insidan vid slutets fot sitter på underramen som de andra (satt 10 mm från den, w 55).
    ./mod kontroll: 0 krockar, 0 glipor, 0 delar utan kontakt.
2026-11-02 Stommens småmått efter reglerna: spikplåtar, hak, säten och halvmillimetrar från Onshape-modellen
    Väggarnas regelverk ligger kvar (reglarnas, stolparnas och öppningarnas lägen och delarnas mått).
    - Takstolarnas spikplåtar vid fötterna mitt på knutpunkten, där diagonalens underkant möter underramens mitt, och
    toppens plåt 8 mm under balken i alla stolar; plåtarna läggs av takstol.py, stolarnas filer anger bara sätet,
    underramens höjd, ståndarna och spikreglarna.
    - Inga hak för ståndarna i underramen (2NO) och inga säten eller hak för ståndare som inte finns (2C).
    - 2NO:s spikreglar med underkanten i takbalkarnas underkant (var 0,5 mm över).
    - Innerväggen 1A:s s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
2026-11-02 Rendering: inomhusbilderna I01–I30 med kameraplan, träslag och ask, insidans ytor, vitbalans
    - renderingar/: rendera.sh renderar inomhusbilderna i 4K och slutlig kvalitet (bilderna versionshanteras inte),
    kameraplan.png (./mod kameraplan: kamerornas lägen och bildvinklar på plan 1 och i källaren ur STEP-filens snitt)
    - inomhusbilderna: kamerorna I12, I13, I20, I21 och I28 riktade mot det de ska visa, I28 med lutande kamera
    - virke: färgerna ur träslaget, ask med porband och årsringar som skiftar år från år, furu med tydligare ringar och
    kvistar, oljans bärnstenston; ./mod materialprov visar ett material på luckor, bänkskiva och brädor
    - insidan: målad gips, slipat betong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
2026-11-02 Rendering: källarens taklampor, kamerorna I15, I20 och I28
    - taklampor (LED-paneler, LAMPOR i vyer.py) som tänds i vyerna som anger dem: källaren (I28–I30), där de små
    fönstren ger så lite ljus att brusreduceringen smetade ut bruset till fläckar
    - I28 utanför skjutdörrens blad, I15 med vidvinkel och I20 längre in i sovrummet (glasdörren och golvfönstret)
    - dagsljus.svartkropp: lampans färg ur färgtemperaturen
2026-11-02 Elinstallationen som data i modellen: armaturer, apparater, dosor, tändgrupper och rör, med kontroll, ritningar och ljus i renderingen
    - hus/installationer/el (se dess README): produkttyper och katalog (SG Armaturen Junistar Exclusive 903201 med
    databladets data och fotometrifil; allmänna dosor, apparater och rör), punkterna med montering ur husets geometri
    (innertak, väggar, källartak), tändgrupper och brytarnas styrning, rör genom installationsskikt, väggar och
    bjälklag; en modul per rum och per bjälklag (först allrummet: sex spotar i snedtaket mellan läkten, dimmer med två
    kanaler, rören och matningen ned i mellanbjälklaget)
    - kontrollen (./mod el kontroll): refere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
2026-11-02 Elinstallationen: SG Armaturen Tube Mini R (tub på stam) och tre spotar i köket riktade mot bänken (prov)
    - Tube Mini R White 880lm 2700K (320696) ur databladet, linjeritningen och fotometrifilen: frontplatta Ø94, dosa
    Ø83 × 51, stam, led i tubens sida, tub Ø59 × 160 med svart bländskydd och reflektor; vridbar kring stammen och
    lutbar 90°
    - armaturtyperna kan ha ett huvud under taket (Tubhuvud); tubens läge räknas fram i punkter.tuben för geometrin och
    ljuset, mot() riktar en spot mot en punkt; hål i gipsen bara för infällda
    - köket: tre Tube Mini R i takfallet 3NV mellan läkten, riktade mot bänken längs nordvästra väggen, dimmer på L4
    rakt under raden; kontrol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
2026-11-02 Bygget: ./bygg och GitHub Actions bygger webbplatsen och handlingarna; genererade filer versionshanteras inte
    ./bygg (verktyg/bygg) bygger modellen, webbvisaren, kameraplanen, granskningens figur, beräkningarna, rapporterna
    och ritningarna i beroendeordning och hoppar över aktuella steg (kontrollsumma över källorna). GitHub Actions kör
    de snabba stegen vid push till main och publicerar docs/ (modellen och handlingarna) med GitHub Pages; taggar rev-*
    ger en release med handlingarna. De tunga beräkningarna K-05, K-06, U-01 och U-03 räknas lokalt: deras resultat som
    andra steg läser, räknat.json och rapporten checkas in, och bygget stoppar om de inte är aktuella.
    docs/, rapporterna,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
2026-11-02 CLAUDE.md: arbetet med ärenden – etiketten Auto åtgärdas av Claude i läget att fixa buggar
    Claude listar de öppna ärendena med etiketten Auto eller auto när allt känt arbete är klart, läser alla och
    planerar dem som rör samma struktur tillsammans, stänger dem med Fixes #<nr> och kommenterar ärenden som är oklara.
2026-11-02 CLAUDE.md: andra kloner arbetar parallellt – hämta med rebase och pusha direkt efter varje commit
2026-11-02 Elinstallationen efter belysningsplanen: pendlarna PH 5, VL45, Stav och glob, alla armaturer och uttagen på plan 1
    Pendlarna (el/typer.Pendel, katalog, el.py) byggda av rotationskroppar (ramverkets nya recept varv): PH 5 med
    skärmarna mätta ur tillverkarens produktbild, VL45 Radiohus Ø175, Ø250 och Ø370, Konsthantverk Stav i råmässing
    (renderingens nya material patina) och en glob i opalglas. I renderingen lyser ljuskällan inne i armaturen lika åt
    alla håll (Stav: en stråle nedåt), skärmarna skuggar och reflekterar och glaset lyser med sin luminans.
    Plan 1 efter belysningsplanen: tubspotar vinklade mot det motsatta takfallet i allrummet, köket, gången och hallen;
    Junistar Ex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
2026-11-02 Webbvisaren: ortografisk vy (O) och logaritmisk djupbuffert mot flimret i taket
    Takplåten och pappen under den låg närmare varandra än djupbuffertens upplösning på några tiotal meters avstånd
    (närplanet ned till 2 mm, fjärrplanet 500 m), så pappen syntes genom plåten. Med logaritmiskt djup är upplösningen
    hundradels millimeter. Den ortografiska vyn följer den perspektiviska kameran (samma navigering), med bildens höjd
    som perspektivets vid rotationscentrum; hjulet skalar bilden kring punkten under pekaren, och klick, mätning och
    snäpp använder parallella strålar.
    Fixes #9
    Fixes #11
2026-11-02 Innerdörren ID5 som fickdörr: blad 750 med fickan mot öster före stolpen LN1_1, 600 mm vägg för garderober
    Fickan mot öster (som i ärendet) måste sluta före stolpen LN1_1 (nockbalk 1 stöd B, x 11 565) och väster om
    öppningen ska minst 600 mm vägg stå kvar för garderober: öppningen blir x 10 065–10 740 (675 mm, blad 750) och
    fickan x 10 740–11 545, genom L2:s anslutning. Dimmern i det lilla sovrummet flyttas öster om LN1_1. ID2 och ID6
    väntar på beslut om stolparna LD2_1 och LD4_1 (modell-todo 9).
    Del av #13
2026-11-02 Källarens innerväggar KL1–KL10: regelstomme 45×95 med gips 13, rören i stommen och dörrhål för M9×20
    Lätta väggar efter skissen i ärendet, i rörens linjer så att rören P4, P6–P14, P16 och P19 står i
    regelfacket; KL8 har reglar 45×120 för avloppsstammen Ø110 bredvid P4. Teknikrummets vägg gör en
    knyck (KL9, KL10) runt värmepumpen, och KL5 börjar vid KL4 eftersom trappan går ut över dess linje.
    Dörrhålen KD1–KD5 är för M9×20 och M8×20 (rumshöjden 2 100). Eget montage under Invändigt med
    stomme och gips per vägg; gipsen räknas som på källarväggarna (kallare.skivor). Renderingens
    taklampor i källaren flyttade från väggarna och I30 till trapphallen.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
2026-11-02 Tappvattnet mellan armeringsjärnen: filer c/c 50, golvdosorna och rören i väggarna förskjutna, FF3 längs V3
    - Rören upp och ned genom mellanbjälklaget går mellan armeringsnätens och vinkeljärnens järn
    (strak.mellan_jarnen): fördelarskåpets stammar och den första filen mellan underkantsnätets järn, filerna c/c 50,
    golvdosorna flyttade så lite som behövs (fria från väggarna), och rören i väggarna längs och tvärs väggen.
    - Stråket O går över V19 mitt i en glipa mellan väggens lodräta järn, och S längs V7 en bit från väggen. Duschens
    rör går söder om 1C, de andra västerut norr om den. Fördelarskåpet är 1 000 mm brett.
    - Ventilationens kanal FF3 går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
2026-11-03 Renderingarna på webbplatsen: kamerorna på planerna och bilderna ur releasen bilder
    Sidan docs/renderingar/ visar plan 1, källaren och huset ute (kameraplanens snitt) med alla vyernas kameror; ett
    klick visar bilden över hela fönstret på svart botten (piltangenter och svep till nästa, Esc stänger, #<namn> i
    adressen). Planerna och kamerorna byggs ur modellen i kameraplanssteget vid varje bygge. Bilderna renderas lokalt
    (rendera.sh, nu också --ute) med vyns data bredvid, och ./mod publicera (renderingar/publicera.sh) lägger dem som
    JPEG i tre bredder i releasen bilder på GitHub, inte i git; GitHub Actions hämtar dem till webbplatsen. En kamera som
    har flyttats sedan bilden rendera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
2026-11-03 Fickdörrarna ID2, ID5 och ID6, garderoben i sovrummet, hörnen och fönstrens smyg; webbvisaren går och mäter igen
    Innerdörrarna är alla fickdörrar. ID2:s ficka går mot norr i 2B, och karmstolpen LD2_1 står vid fickans ände
    (y 4 048): dalbalk 2 spänner över dörren och fickan (K-01 räknar nu med öppningar i väggen under balken, med snö på
    bara öppningen; momentet över öppningen 3,5 kNm, balken klarar sig), och K-03, K-05, K-06 och U-01 är omräknade
    (LD2_1 13,3 kN). ID5 har 500 mm vägg för garderober (blad 800). ID6:s ficka går från L12 in i 2C söder om stolpen
    LD4_1, som flyttas 12 mm norrut som i Onshape-modellen; 2C får överstycke över fickan och sovrummets dim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
2026-11-03 Brandlarmet: brandvarnare 230 V, trådbundet sammankopplade, med kablarnas dragning och ritningen B-01
    - Egen installation under Hus/Installationer/Brandlarm (hus/installationer/brandlarm): sex brandvarnare, en i
    varje huvudutrymme högt i taket nära rummets mitt. På plan 1 i köket, sovrummet, vardagsrummet och hallen, i
    snedtaket 600 mm från nocken mellan installationsskiktets läkt; i källaren vid trappan och i det öppna rummet
    norr om den.
    - Kabeln 4G1,5 som stam under källarens tak från matningsdosan D01 (elcentralens läge är inte bestämt), med en
    stigare per huskropp (1A, 2A, L4) genom mellanbjälklaget i hylsa. Stigarna går fria från järnen och de ingjutna
    röre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
2026-11-03 Startsidan: projektet, bilderna, planerna, modellen i 3D och handlingsförteckningen
    Webbplatsens startsida (docs/index.html) byggs av ./bygg (verktyg/bygg/startsida.py med mallen startsida.html) ur
    det som redan är byggt: projektets uppgifter och handlingsförteckningen med status ur F-01, rapporternas och
    ritningsbladens revision och datum, bilderna ur renderingarnas förteckning i ett galleri med ljuslåda och plan 1 och
    källaren ur plan.json i samma skala. Webbvisaren ligger under modell/ (gamla länkar med #bara= och #tona= leder dit)
    och handlingar/ leder till förteckningen. Vyerna har bildtexter (TEXTER och TEKNIK i vyer.py), bilderna publiceras
    också 960 px breda för galleriet,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
2026-11-03 Renderingen: askens färger efter foton av hyvlad ask, blekare och mindre gul
    Askens vårved och ådror hade granens gula ton (b* ≈ 21) och ådrorna en orangebrun; oljad blev asken b* ≈ 30 i
    materialprovet. Färgerna är nu mätta på foton av hyvlad ask, vitbalanserade mot neutrala ytor: obehandlad b* ≈ 10
    som på fotona, oljad b* ≈ 17. Tydligare ådring (kontrast och sommarved), färre bitar med kärnved, och de varmaste
    bitarnas gyllene ton (varm, nu per träslag) svagare för asken. Webbvisarens färg för asken följer.
2026-11-03 Renderingen: askens ådring som förut, bara den gula tonen svagare
    Asken får tillbaka sin tidigare struktur (kontrast, sommarved, kärnved och de varmare bitarna). Bara färgtonen ändras:
    vårveden, ådrorna, kärnveden och de varmare bitarnas ton (varmfarg, nu per träslag) har samma ljushet som förut men
    halva mättnaden. Oljad ask b* ≈ 18 i materialprovet i stället för 30, med samma ljushetsmönster som förut.
2026-11-03 Kökets inbyggnad: kyl, frys och skafferi bakom en vägg till innertaket, förråd ovanför med lucka
    Väggarna hör till de invändiga (Invändigt/Kökets inbyggnad, kokets_inbyggnad.py): lätta väggar 45×70 L15–L18
    framför L4:s och 3NV:s färdiga skikt, fronten L15 med OSB och gips upp till innertaket (snett efter båda
    takfallen), gaveln L16 i L2:s linje och mellanväggarna L17 (mot huvudstolpen LN1_3) och L18 upp till
    förrådsgolvet. Fronten står 833 mm från L4:s yta, 13 mm söder om huvudstolpens strävor och överstycke, som hamnar i
    förrådet. Tre öppningar från golvet till 2 100 med smyg av vitmålad furu: kylens och frysens nischer (600 fria)
    och skafferiets dörr (500 fr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
2026-11-03 Innerväggarnas skikt: gipsen hel runt ytterhörnen och över stolparna
    Ytterhörnen (1A–1B, L4–L2, L11–1C, L10–L9, L10–L11, L6–L7, L14–L13 och kökets inbyggnad L15–L16): skikten möts
    var för sig. Väggen som slutar mot en annan har sina skikt fram till den andra väggens skikt på samma djup (OSB:n
    till dess OSB, gipsen till hörnet), och den andra väggens skikt går förbi sin ände över skikten innanför. Förut gick
    alla skikt till den andra väggens yta, så att OSB:ns kant syntes i hörnet; i badrummet går nu också tätskiktet och
    kaklet obrutna runt hörnen.
    Delar som bara når en bit in i ett skikt bryter det inte längre: skiktet går över dem med ett urtag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
2026-11-03 Köket: bänk längs 3NV och 3SV och en ö, lådskåp på Blum MOVENTO med fronter av fräst ask
    Köksskåpen (hus/inredning/koksskap.py) byggs vart för sig i sitt eget system, så att de kan ritas: stomme av
    björkplywood 20 (600 djup, från sparklisten 90 till bänkskivans underkant 888), fyra lådor av björkplywood 14 med
    botten 4 i spår på Blum MOVENTO 760H (TD-132/1: SKW = LW − 42, SKL = NL − 10, urtag 13, 7 mm fritt över lådan, 38
    under den nedersta, djup NL + 3; NL 550, under diskhon 350) och fronter av fräst ask 22, 115, 115, 233 och 323 höga
    med 3 mm spel och ett linsformat grepp. Typerna lådskåp, diskbänksskåp (fasta fronter, öppet tak) och hällskåp, och
    diskmask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
2026-11-03 Omgivningen i renderingen: Lantmäteriets markhöjdmodell och de egna inmätningarna runt tomten
    Första steget i ärende #26 (höjderna). modellering/terrang.py läser Lantmäteriets markhöjdmodell (0,25 m över tomten,
    1 m och 2,5 m omkring, SWEREF 99 TM) och de inmätta punkterna (GNSS, SWEREF 99 12 00) ur lokalt/terrang
    (versionshanteras inte) och lägger höjderna i omgivningens rutnät i stället för Terrarium (mjukt mot det vid
    ytterkanten), och ett fint rutnät 0,25 m över tomten, rättat mot de inmätta markpunkterna (berg, gräs, tomtgräns,
    dränering) med en utjämnad korrektion: median |avvikelse| berget 0,085 → 0,058 m, gräset 0,160 → 0,061 m. Blender
    läser det fina ru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
2026-11-03 Omgivningen: riktiga texturer, inmätta tallar och stenar, hällmark som i flygbilderna, flygbilder
    Marken får detaljer ur Poly Havens texturer (CC0: rock_01, leafy_grass, forrest_ground_03), två avläsningar
    blandade efter brus mot upprepning och tonade mot platsens färger. Över tomten följer marktäcket de inmätta
    punkterna (berg, gräsmatta, barr fläckvis under träden). De inmätta träden (14; varje träd var mätt 3–4 gånger)
    är Poly Havens tallar och stenarna rundade granitblock, utom inom 1,5 m från fasaden; på tomten inga andra
    träd. I skogen tallar och granar ur Poly Haven i stället för de procedurella. Hällmarken är som i flygbilderna
    mest berg i dagen, med spric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
2026-11-03 Kaminen: öppningen i 2C symmetrisk kring insatsen, fronten målad som väggen
    Öppningen i 2C går x 6 400–7 236 i stället för till 7 410, så att kalciumsilikatfronten syns lika bred på båda
    sidorna om insatsen (39 mm utanför ramen). Det är samma detalj som på västra sidan, och överstycket blir 836 mm
    i stället för 1 010 under takstolen 2C:s topp (modell-todo punkt 7). Fronten är målad i väggarnas vita färg
    (Kalciumsilikat målad), så att kaminen sitter mitt i en vit vägg.
    Fixes #28
2026-11-03 Omgivningen: grannhusen i norr och sydost, skog väster och söder om tomten, två träd bort
    Efter kommentarerna på flygbilden: det som saknas i OpenStreetMap och inmätta träd som inte finns står nu i
    vyer.GEODATA (byggnader, skog, utan_trad, i modellens mm).
    - Grannhuset i norr (nybygge): väggen mot tomten efter de inmätta punkterna hus vid x 21,4–21,9, djupet ur
    flygfotot (som passades mot OpenStreetMaps hus).
    - Grannhuset i sydost: två delar med platta tak, ur flygfotot.
    - Skog (täta träd) mellan tomten och stranden i västsydväst och söder om tomten; träden i skogen varierar mer
    i höjd (0,45–1,4 gånger).
    - De två inmätta träden öster om huset finns inte.
    Bygg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
2026-11-03 Köket: inbyggnaden 95 mm grundare och med gipsväggar, ön 1 100 från bänken mitt för hällen, diskmaskin 60
    Kökets inbyggnad: frontens gips står nu mot huvudstolpen LN1_3:s strävor och topregel (de slutar vid y 7 362),
    så att köket blir 95 mm längre. Där strävorna når in i frontens stomme upptill slutar hammarbandet på var sida, en
    kortling mellan två reglar på överstyckena bär gipsen och regeln mellan kylen och frysen slutar under kortlingen;
    OSB:n har ett urtag runt strävornas toppar. Mellan nischerna och mot skafferiet bara två gipsskivor (L17, L18)
    och en regel i fronten mellan öppningarna, så att skafferiets dörr blir 540 fri (450). Förrådsgolvet ligger på
    reg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
2026-11-03 Webbvisaren: musen tittar runt som i ett spel när man går genom huset
    I gå-läget (G) fångas pekaren (Pointer Lock): musens rörelse vrider blicken utan att man drar, och ett sikte mitt
    i bilden visar vart dubbelklicket går. Esc släpper pekaren (då går det att dra som förut) och ett klick i bilden
    fångar den igen; G avslutar och släpper den.
    Fixes #32
2026-11-03 Infällda armaturer: håltagningen i innertaket finns i modellen
    De infällda armaturerna (Junistar Exclusive och Tube Mini R) får sin håltagning (Ø83, så djupt som armaturen går
    in i taket) i de invändiga skikten: el.installation.haltagningar ger verktygen och hus.py skär dem med
    genomfor_alla (varje del en gång med de verktyg som når den). Webbvisaren och STEP-filen visar nu hålen.
    Renderingen hade redan egna hål (bara i Blender, scen._hal), så ljuset blir detsamma; de är borttagna nu när
    modellen har hålen.
    Fixes #29
2026-11-03 Bygglovet i repot och på startsidan: beslut D32 och handlingarna som tillhör det
    bygglov/ med beslutet (2026-02-18), den reviderade ansökan och ritningarna 100 och 200–209
    som kommunen skickade ut dem, och förteckningen handlingar.toml. I ansökan är personnumret
    och kontrollansvariges telefonnummer maskerade.
    Startsidan: ny grupp Bygglov först i handlingsförteckningen (status Beviljad); de
    reviderade ritningarna (rev 02) i gruppen Bygglov, uppdaterade ritningar.
2026-11-03 Altanen: trädäck av grånad trall framför skjutpartiet 2SV, parametriskt
    Ett eget montage (hus/altan): trädäck mellan fasaderna 1NV och 3SO, från 2SV ut till gaveln 1SV:s linje, med
    överkanten i golvets höjd. Varje bräda (grånad tryckimpregnerad trall 34 × 135) är en egen del, med lika fogar;
    LANGS väljer om brädorna går längs 2SV eller tvärs och RAM om en ram av brädor går runt om. Bjälkar 45×145 c/c
    högst 600 på bärlinor 2 × 45×145, betongplintar Ø200 i borrade hål i berget (marken har hålen), sargbräda längs
    de fria kanterna och hål runt stuprören i de inre hörnen.
    Renderingen: ytbehandlingen grånad (silvergrått, olika mycket per bräda och längs fibr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
2026-11-03 Ytterdörrarna: blad med panel i den andra kulören, källarens pardörr D1
    Ytterdörrarnas blad byggs som på bilden: en kärna av plywood 44, liggande läkt (c/c högst 400) och stående panel
    22 utanpå (Dörrpanel, brädorna på höjden), i den andra kulören än fasaden runt dörren (material.DORRPANEL): grå
    järnvitriol på huvudentrén 1SO-D1 i det röda huset och falu rödfärg på källardörren i det grå.
    Källarens ytterdörr D1 (öppningen mellan V8 och V9) är nu en pardörr i 3NO:s system under bjälklaget, som
    källarens fönster: ett blad 900 till höger sett utifrån och ett smalare till vänster, som öppnas ibland.
    Fixes #33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
2026-11-03 Ytterdörrarna: panelen i liv med fasadpanelen, ingen karm synlig
    Dörrbladens panel ligger nu i fasadpanelens plan, utanför karmen, och täcker karmen fram till en fog 4 mm mot
    fasadpanelen (som går 10 mm in över karmen): utifrån syns ingen karm, bara tröskeln. Läkten fyller ut mellan
    kärnan och karmens ytterkant. Källarens pardörr sitter som dörrarna på plan 1, med karmen innanför panelens plan.
    Refs #33
2026-11-03 Dränering och dagvatten runt huset till en ny brunn, ritningen D-01
    Egen installation Hus/Installationer/Dränering (hus/installationer/dranering):
    dränrör Ø110 300 mm utanför grunden med överkanten i grundens underkant (fall
    minst 1:200) och täta dagvattenrör 600 mm utanför, minst 300 mm under marken
    (fall minst 1:100), med en anslutning från varje stuprör. Två grenar per ledning
    till en ny brunn B1 Ø400 med sandfång utanför källarväggen V9, nära den gamla,
    ansluten till det befintliga utgående röret mot nordost (ÖK +5,759, AR-02).
    Raka lutningar mellan brytpunkterna, spolbrunnar där ledningen faller lodrätt,
    under entré- och sovrumsavsatsens stenar utan spolbrunnar.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
2026-11-03 Kökets gavel L16: bara två gipsskivor under förrådet, brytarna på 2B
    Under förrådet är gaveln mot gången nu två gipsskivor i L2:s yta, ovanför
    stomme på en syll i förrådsgolvets överkant med luckan. Fronten fick en egen
    ändregel innanför skivorna. Kylen och frysen flyttas 24 mm mot gången, och
    skafferiets dörr blir 564 fri (bänken längs 3NV oförändrad). Köksbelysningens
    dimmer och brytare sitter nu på 2B mot gången, mitt emot gaveln, i facket
    närmast köket.
    Fixes #21
2026-11-03 Kontroll av installationernas vägar; rör och kablar ur rummen och fickorna
    Ny kontroll (modellering/vagar.py, i ./mod kontroll och som ./mod vagar):
    rör, kablar och kanaler ska gå dolda i skikten, ingjutna eller i marken. Den
    underkänner ledningar som går fritt i rummens luft eller genom fönstrens och
    takfönstrens öppningar (fria mått längs axlarna och diagonalerna, strålar mot
    husets triangelnät med vtk) och ledningar i volymer som ska hållas fria
    (fickdörrarnas fickor). Reglerna står i kontrollregler (LEDNINGAR, UTANPA,
    SYNLIGA, FRIA_VOLYMER). I källaren får ledningarna gå utanpå väggarna och taket
    (anmärkning). Kontrollen tar under en sekund.
    Rättat det kontrollen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
2026-11-04 Omgivningen: träden efter kommentaren på flygbilden, tomten uppifrån i mulet väder
    Ärende #26: de två tallarna väster om huset vid gaveln mot grannhuset i norr tas bort (utan_trad) och nio tallar
    läggs till (GEODATA nya_trad, terrang.bygg): en öster om de inmätta tallarna och grupper i sydost och sydväst.
    Flygbilden över tomten renderas i mulet väder, så att trädens skuggor på gräsmattan inte ser ut som träd.
2026-11-04 Omgivningen: varje inmätt träd slumpas ur sitt läge, stenarna för sig
    Ett träd som läggs till eller tas bort (vyer.GEODATA) ändrar inte längre de andra trädens sort, höjd och vridning
    eller stenarnas.
2026-11-04 Tubspotarna mot det motsatta takfallet två läktfack (800 mm) högre upp
    Allrummets och kökets rader och hallens två flyttas 800 mm längs taket (två läktfack). Kökets KO-L01 under
    takfönstret TF2 sitter där den satt, eftersom fönstret tar takfallet ovanför den; röret till KO-L02 går längs y
    under fönstret. Gångens spotar (800 mm från L2, som de lyser på) och allrummets AL-L05 (mot badrumsväggen intill)
    sitter kvar. Elinstallationens kontroll prövar att armaturernas hål ligger i innertakets gips, inte i ett
    takfönsters öppning.
    Fixes #38
2026-11-04 Fickdörrarnas smyg av ask, skarven L12–2C och kontroll av ytskiktens språng och springor
    Fickdörrarna får smyg av oljad ask 22 mm upptill och på sidorna, genom hela väggen i liv med skivorna: hel på
    låssidan och delad vid fickan och i överstycket med en slits för bladet, som stängs mot låssidans smyg. ID6 stängs
    mot L11:s gips (öppningen från u 25, som ID3) och ID2:s öppning börjar vid trapphålets vägg L6.
    Gipsens springa 12 mm över ID6, där L12 och 2C slutar mot varandra med en lucka mellan stommarna: skikten går halva
    luckan förbi änden där ytorna ligger i samma plan (vaggar._skarvar). Kökets gavel L16 under förrådet: två skivor
    12,5 i liv med skikten ovanf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
2026-11-04 Rendering: natten i månsken, serien D utan omålade vyer
    Ute i mörker exponeras bilden som ett nattfoto i månsken (NATT_EV −2 i
    stället för 3, då bara fönstren syntes) med vitbalansen 4000 K, ungefär
    månskenets färg, så att landskapet blir neutralt, natthimlen blå och
    lamporna varma. Ljusserierna får "utan": serien D renderar inte
    badrummet (ingen belysning i elinstallationen än), närbilderna av
    fasaderna och taket (svarta i mörker) eller stommen. README:erna har
    publiceringens bredder 480–2048.
2026-11-04 Rendering: himlen mäts med den beräknade himlen kopplad till världen
    När ljuset byttes mellan vyerna tog Himmel.stall_in bort den förra vyns
    noder, och med dem länken från den fotograferade himlens blandning till
    världens utgång. mat_horisontell mätte då en tom värld, och den klara
    himlen färgades upp ungefär 10⁹ gånger: exponeringen blev EV 29–45 och
    bilderna svarta (åtta av seriens A utebilder med sol, som renderas om).
    Serierna B–D, där alla vyer har samma ljus, och mulna vyer, som inte
    mäts, påverkades inte. Nu kopplas den beräknade himlen till världen
    innan den mäts.
2026-11-04 Varianten velfac: fönstren och fönsterdörrarna från VELFAC 200 ENERGY
    trebodar/variant.py: modellens varianter (TREBODAR_VARIANT, ./mod --variant NAMN … med
    utmappen ut/NAMN/). Huset som det är projekterat är oförändrat (avtrycket).
    byggdelar/velfac.py: VELFAC 200 ENERGY efter systemritningarna (utg. 15, 07.26),
    profilerna förenklade till ytterkonturerna och svepta med gering: vändbart fönster
    (standard A/C och vändfönstrets sidokarm G med beslagszonen), fast fönster med båge,
    1-luft fönsterdörr med 24 mm tröskel och 2-luft skjutdörr med 24 mm tröskel mellan två
    fasta partier, kopplade, med lika breda rutor och mittpost.
    Monteringen (enhet_velfac, oppningar, fasad):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
2026-11-04 Fönstren och fönsterdörrarna från VELFAC i huset, utan varianten
    Huset har nu VELFAC 200 ENERGY: vändfönster, fasta fönster med båge, 1-luft
    fönsterdörrar och 2-luft skjutdörren mellan två fasta partier (byggdelar/velfac.py),
    monterade som i varianten velfac (enhet_velfac: indrag 20, fog 15, påföring och
    fönsterbleck, anslutningsprofil och plåtar bakom läkten, fasaden 10 mm från karmen,
    smyg och fönsterbänk av ask). Geometrin är densamma som variantens (avtrycket).
    Varianten tas bort: trebodar/variant.py, ./mod --variant, startsidan i docs/velfac/,
    rendera.sh och publicera.sh med --variant och releasen bilder-velfac i bygget
    (återställer 394918b och 2940ef9).
    Elitfö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
2026-11-04 Rendering: nattbilderna ute med fyra gånger fler sampel och klampade sampel, utan markens reflex
    I mörker sänks brusgränsen så att varje bildpunkt samplas till kvalitetens största
    antal, så nattbilderna ute får fyra gånger så många (NATT_SAMPEL, 2 048 i slutlig).
    Med fler sampel behåller brusreduceringen glittret från lamporna inne genom fönstren
    (i fasaderna, berget och stenarna) och de sällsynta studsarna in till de upplysta
    väggarna (prickar i gräset), så varje sampels bidrag begränsas till 11 steg över
    mellangrått direkt och 8 indirekt (klamp, NATT_KLAMP). Markens speglande del tas bort
    helt i nattbilderna (mark_i_morker), annars glittrar gräset och berget.
    Dagsbil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
2026-11-05 Bottenplattan L400, plattan på mark L500 i handlingarna, dräneringen med flackare fall
    Bottenplattan i källaren byggs med L-element 400 i stället för 300, med samma
    golvnivå: 100 mm betong på 300 mm cellplast S100 (100 + 200, plastfolien i
    balkarnas underkant) och kantbalkar, balkar och plintar 300 mm höga på 100 mm
    S300. Cellplastens underkant +5,850 (AR-02), 71 mm över det utgående rörets
    dimensionerande överkant.
    - K-06: utförande L400 med nya plintar (P14 600). Cellplasten under balkarna
    89 % (97 % med L300), plattan i fält 80 %, plintarna och balkarna (2 Ø10) räcker.
    Startjärnens fot 250. Figurerna och texten följer utförandet; skikten ritas
    med plastfolien i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
2026-11-05 Att göra som ärenden: modell-todo och det som inte är modellerat ännu flyttat till GitHub
    modeller/modell-todo.md och avsnittet Inte modellerat ännu i modellens README är borta. Det som fortfarande gäller
    (kontrollerat mot modellen) är ärendena #40–#56; källardörren D1 och fönsterblecken finns redan i modellen.
    CLAUDE.md: det som återstår hålls som ärenden, inte i repot. Koden och handlingarna hänvisar till ärendena i stället
    för modell-todo: U-03 utan hänvisningen (rapporten omritad ur de sparade resultaten, siffrorna oförändrade), K-05
    bara en kommentar (K-05, K-06, U-01 och U-03 markerade som aktuella). Modellens geometri är oförändrad.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
2026-11-05 Inköpslistan IN-01: specialprodukterna märkta i modellen, med status, ansvarig roll och skede
    Specialprodukterna (det som väljs, beställs eller tillverkas för sig, inte vanligt material) märks i geometriskripten
    där de skapas (produkt= på Del och Montage; installationernas produkttyper har fältet i katalogen). IN-01:s
    indata.toml har resten: vald produkt, status, ansvarig roll, skede, dokument och ärenden. ./mod inkop och
    ./mod kontroll jämför koderna åt båda hållen; ./bygg skriver utdraget och PDF:en med antal och id ur modellen.
    30 produkter: nock- och dalbalkarna med plåtarna, plåtarna över skjutdörren 2SV, källarpelarna, fönstren och
    dörrarna, köket, kaminen, armat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
2026-11-05 TP-01: vatten och avlopp stängs och pluggas före rivningen (D32), hänvisningar till ärendena
    Bygglovsbeslutet D32 kräver att ledningarna pluggas och vattnet stängs vid rivningen, med VA-avdelningen vid behov;
    steget ligger veckan före byggstart. Handlingarna till tekniskt samråd hänvisar till #63 (trästommens ritning och
    stabilisering) och #64 (kontrollplan och brandskyddsbeskrivning från KA), utstakningen till #62.
2026-11-05 TP-01: tidsplanen börjar vid rivningens start, utan förberedelserna
    Fasen Förberedelser (lov, tekniskt samråd, startbesked, beställningar, tömning och utrivning m.m.) är borta;
    tidsplanen och översiktsdiagrammet börjar vid byggstarten 9 augusti 2027. Att vattnet stängs och ledningarna
    pluggas (D32) ligger nu på rivningens första dag.
2026-11-05 Ljusplanerna: källarens taklampor tända, inredningen utanför statistiken, köksbänkarna och ön
    ./mod ljusplan tänder nu också vyernas taklampor (LAMPOR, källarens LED-paneler) när alla tändgrupper är tända,
    och --tand kan välja dem; panelerna ritas på planen. Inredningen på mätytan (skåpen, sängen, bänkskivorna och
    kaminen, ur snitt genom den upp till 0,9 m över ytan) lämnas vit och utanför statistiken, så att köket inte får
    minsta värdet 0 under skåpen. Köksbänkens mätyta följer köket med bänkar längs 3NV och 3SV och ön, 10 mm över
    bänkskivorna (ovanför hällens glas). Rummens etiketter läggs där de inte täcker armaturerna, och READMEs beskriver
    att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
2026-11-05 Ljusplanerna: köksbänkarna och ön mäts i bänkhöjd på planerna över plan 1
    På golvets och bordshöjdens planer är det belysningsstyrkan på bänkskivorna som är intressant i köket, inte på
    golvet under dem. Delområden kan nu mätas i en egen höjd (matytor.Zon), och bänkarna längs 3NV och 3SV och ön mäts
    10 mm över bänkskivorna (0,91 m) på alla tre köksplanerna. Blender renderar de upphöjda ytorna för sig, två rutor
    större så att kanten inte blandas med planet under, och de ersätter planet i sina rutor; värdena stämmer med
    köksbänkens plan. Delområdenas etiketter visar medelvärdet och läggs längs delområdet, i det eller intill det, där de
    inte täcker arm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
2026-11-05 Ljusplanerna blir utredningen U-04; startsidan delar de egna handlingarna i arbetsritningar och utredningar
    Startsidans grupp Egna underlag blir tre: Arbetsritningar (AR), Utredningar (U) och Inköp (inköpslistan), efter
    numrets början i F-01:s övriga handlingar.
    Ljusplanerna med all belysning tänd blir utredningen U-04 rev A (blad U-04.1–U-04.4: plan 1 golvet och bordshöjden
    med köksbänkarna och ön i bänkhöjd, köksbänkarna och källarens golv) i en pdf i rapporter/, listad i F-01 och under
    Utredningar. ./mod ljusplan ritar alla mätytorna i en pdf, med --nummer och --projekt (revision och datum ur en
    indata.toml, status UTREDNING). Steget U-04 är ett nytt slags tungt steg, m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
2026-11-05 K-04 (pågår): stålband i väggar och takfall, bärverket ur modellen och balkmodellen (FEM) av trästommen
    Modellen: infällda stålband 40×2,0 S350GD i kryss (byggdelar/stalband.py), i väggarnas fält (data per vägg) och i
    takfallen längs hela fallet, fält om högst 2,4 m utom över takfönstren (hus/stomme/prefab/stalband/stalband.py);
    överlappen mot virket och isoleringen är tillåtna. ./mod barverk skriver bärverket (stommens delar med läge,
    tvärsnitt och material, takfallen och väggarna) till ut/barverk.json, gränssnittet som K-04 läser.
    K-04: balkmodell i linjer genom delarnas axlar (natverk.py, en knutpunkt per grupp av delar som ligger an mot
    varandra, leder i de ans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
2026-11-06 K-03: hörnstolparna heter LA1–LA10 i planfiguren, som i texten, K-05 och modellen
2026-11-06 K-04: balkmodellen på systemlinjer, med takstolarnas ståndare utan last och gavlarna bundna i sidled
    Leder i alla delars ändar (tidigare satt 199 delar fast i ena änden), delar som ligger an mot varandra längs en sträcka
    på en gemensam linje, knutpunkterna där linjerna möts och varje del rak mellan sina yttersta knutpunkter. Takstolarnas
    ståndare och spikreglar bär inte takstolen (K-03:s triangel), gavelns överkant och takstolens överram hålls i sidled av
    skivorna. Dörrar och glaspartier för den nedre lasten direkt till bjälklaget. Rapporten jämför takstolarna med K-03 och
    stolparna med K-05 med snö som huvudlast.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
2026-11-06 K-04 utan underlagsrad, antal delar och lastfallstabell; F-01 med ströläkten 34×45 och hårdboarden i takets egentyngd
    F-01: takets egentyngd 60,8 kg/m² (0,60 kN/m²) med ströläkten 34×45 c/c 200 och hårdboarden (masonit) 3 mm som i
    modellen. K-04 tar takets egentyngd ur F-01 utan eget tillägg. K-01, K-03 och K-05 har kvar sina värden tills K-01:s
    revision är bestämd (#57).
    Fixes #65
2026-11-06 Källartrappa av staplade granitblock till källardörren D1, med en avsats där pardörrens stora blad kan slås upp helt
    Trappan: granitblock 350×100×1000 längs fasaden mot NO, stegdjup 300 (50 mm överlapp), från avsatsen i källargolvets
    höjd upp till marken vid huskroppens hörn (K-06). Avsatsen räcker 150 mm förbi huvudbladet uppslaget mot fasaden;
    brunnen B1:s lock ligger i den. Återfyllningen mot V9 följer trappan, marknivåerna vid fasaden är omräknade och
    dräneringen går under stenarna. IN-01: källartrappan som specialprodukt; entréavsatsens granit är inte Stengrossens
    (den levererade fasadstenen) utan att välja.
    Fixes #58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
2026-11-06 K-03: LN3_1 och LN5_2 med nockbalkens excentriska last i väggens plan (75 % och 97 %), reglarna skruvade ihop
    Balken vilar på 83 av stolparnas 180 mm, så att den ligger mitt i takets spets. Stolparna räknas för tryck med knäckning
    ut ur väggens plan och böjning i den (SS-EN 1995-1-1 6.24), med helgängade skruvar så att lasten fördelas på alla fyra
    reglarna.
    Fixes #45
2026-11-06 Dräneringen och dagvattnet på markens nivå, spolrören under altanen och ett stuprör på 1SO
    Stuprörens ände och dagvattnet följer marken själv (markniva.MARKEN, ur marknivaer.py utan grunden, fasadstenen,
    avsatserna och trapporna) i stället för panelens underkant: längs fasadstenen på 1SO låg marken 600 mm under
    MARKNIVA, så att stupröret slutade i luften och spolbrunnen och ledningen stack upp. Ringarna delas under altanen i
    det inre hörnet mellan 1NV och 2SV (SPOLROR), där spolrören och spolbrunnen där dräneringen faller till källaren nås
    genom altanen. I berget i dagen runt kropp 1:s södra del (BERG) inga spolbrunnar eller spolrör: ledningarna faller
    där högst 1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
2026-11-06 Fickdörrarna nästan öppna, inbyggnadens fronter vita med askhandtag och en mindre takfläkt till köksfläkten
    - Fickdörrarna står nästan helt öppna, 70–150 mm ut ur fickan (olika), så att man ser mellan rummen
    (Innerdorr.ute).
    - Kökets inbyggnad: kylens, frysens och skåpens fronter och skafferidörren vitmålade, med lodräta handtag av oljad
    ask vid den fria kanten; kylen hängd mot gaveln och frysen mot skafferiet, så att deras handtag sitter intill
    varandra. Egna rader i IN-01 (INBYGGNADSFRONTER, HANDTAG).
    - Takfläkten Systemair TFSR 200 EC Sileo (bottenplatta Ø439, höjd 187; 108 l/s vid 284 Pa, så kåpans 111 l/s på
    ungefär halvt varvtal) i stället för TFSR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
2026-11-06 Renderingens omgivning: bädden framför altanen med låg växtlighet och buskar, grannhuset i norr mörkgrått
    - Bäddar i vyer.GEODATA (baddar): marken höjs inom polygonen (hojd, mjuk slänt, lite bucklig), marken under får
    en egen mask med halm, ris och tuvig yta, och på bädden står gräs i tuvor och små buskar (Poly Havens
    grass_medium_02 och shrub_01/03/04). Bädden framför altanen är 60 cm hög över de inmätta stenarna, som i
    verkligheten.
    - Buskar vid bädden (buskar): Poly Havens shrub_02, tre ihop i varje buske.
    - Grannhuset i norr: mycket mörkgrått med svartmålat plåttak.
    - Poly Havens nya modeller hämtas med ./mod omgivning --hamta (lokalt/polyhaven).
    Bildern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
2026-11-06 K-03 efter modellen: geometrin ur modellens bygge, stolparna som i modellen och toppen med en kloss
    - geometri.json ur modellen (kontroll_k03.py: allt stämmer):
    - 109 takbalkar; TF1 har nu dubbla takbalkar på båda sidor.
    - Takfönstrens kortlingar ovanför och nedanför.
    - Takstolarnas diagonaler till balkens underkant; 2NO:s extra takbalkar.
    - En toppkloss per takstol.
    - Stolparna med modellens delar, också LN1_1, LD4_1 GL30h 140×140 och LD4_2 med fem reglar.
    - Huvudstolpen med strävor på båda sidor.
    - K-03 räknar stolparna ur modellens delar. Material ur indata (LD4_1 GL30h).
    - Toppen räknas med en kloss: diagonalernas ändar (6.16) och klossen vinkelrätt fibrerna me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
2026-11-06 Köksskåpen: lådorna i massiv björk med framstycket för Blums kopplingar, hålen för löparens hake och gångjärn på skåpdörrarna
    - Lådorna:
    - Massiv björk 14 med botten av björkplywood 4.
    - Framstycket går ned till sidornas underkant med bottnen i spår, så att kopplingarna T51.7601 kan skruvas 75°
    in i det, plant under botten (Blums monteringsanvisning för MOVENTO).
    - Bakstycket står på botten, som går ut till lådans bakkant (Blums utförande utan urtag).
    - Hålen för löparens hake, Ø6 × 10, sitter i sidornas bakände, 7 mm från utsidan och 11 mm upp.
    - Löparens del under botten börjar bakom framstycket.
    - Gångjärn Blum CLIP top BLUMOTION 110° (f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
2026-11-07 Köksskåpen: löparnas skruvhål och kopplingarnas montering enligt Blums datablad TD-132
    - LOPARENS_SKRUVAR: löparens skruvar i skåpsidan från stommens framkant (TD-132 s. 13, 760H, montage på sidan):
    NL 550 vid 19, 37, 69, 243, 261 och 293 mm, NL 350 vid 19, 37, 69 och 261 mm. Spånskiveskruv Ø3,5 × 15 eller
    systemskruv Ø6 × 14,5. Kontroll att varje NL i skåpen har sina skruvhål.
    - Kopplingarna T51.7601: TD-132 skruvar dem lodrätt i en tjock botten på fyrsidiga lådor (s. 19, 1a). Med botten
    4 mm skruvas de 75° in i framstycket som för tresidiga lådor (1b), med borrmallen T65.1000.02.
    - Hålet för löparens hake (Ø6 × 10, 7 från utsidan, 11 upp) är kontrollerat m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
2026-11-07 Avloppet från köket: diskhon och diskmaskinen i ön rakt ned till grundledningen under bottenplattan
    - Diskhons avlopp i hons bakre del, 80 mm från bakkanten, bakom diskbänksskåpets korta lådor (NL 350): vattenlåset
    Ø40 mellan hon och golvet och röret Ø50 rakt ned genom mellanbjälklaget, källaren längs V14:s gips och
    bottenplattan (AV5).
    - Diskmaskinens vattenlås i sockeln under öns skåp O2 och röret Ø50 rakt ned (AV7), i källaren i linje med rören
    P1, P3 och P5, mitt emellan P3 och P1 och utanför deras genomstansningszon.
    - Under bottenplattan en böj till var sin gren Ø110 vinkelrätt mot grundledningen (Onshape-modellens tills vidare),
    med 10 ‰ fall (AV6, A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
2026-11-07 Omgivningen i renderingen: riktiga träd i skogen, mörkare berg, fläckig gräsmatta och grannhus med panel och fönster
    - Skogen: med Poly Havens tillgångar bara riktiga tallar och granar, vuxna och unga (pine_sapling_medium och
    fir_sapling_medium, nya i tillgångarna); de enkla björkarna och enarna, med kronor av klumpar, används bara utan
    tillgångarna.
    - Berget: vittrad granit med lavar, reflektans 0,15–0,25 i stället för 0,3–0,5, så att hällarna inte ser ut som snö i
    solen.
    - Gräsmattan: mindre mättad grön med torrare och frodigare fläckar.
    - Grannhusen: stående panel med mörka fogar och en rad fönster med vit karm och mörkt glas på väggarna (färgerna som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
2026-11-07 Omgivningen i renderingen: gräsmattan i 3D nära huset
    - grasmatta: tuvor av strån (Geometry Nodes) på markens ytor, omgivningens och modellens terräng, inom 45 m från
    huset och där tomtens marktäcke är gräsmatta (nara_tacke.png, med markmaterialets brusiga kant), 300 tuvor per m².
    - Tuvorna: fyra varianter med 22 smala, lite böjda strån 4,5–9 cm, olika lutade; stråna olika gröna, torrare i
    toppen, mörkare nere i gräset och genomlysta.
    - Marknätets inre ring (INNANFOR, under terrängens kant) får inga egna strån, så att kanten mellan omgivningens mark
    och modellens terräng inte blir en mörk rand av dubbelt så tätt gräs.
    Refs #26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
2026-11-07 Omgivningen i renderingen: utan gräsmattan i 3D
    Återställer fd20ed5: gräsmattan med strån i 3D gör bara renderingarna långsammare (användaren i ärendet). Gräsmattan
    är den platta med fläckar från 0b89228, som de publicerade bilderna visar.
    Fixes #26
2026-11-07 Avloppet: luftningen dold i KL8 och badrummets vägg L11 ut genom taket, stammen under L11
    - Luftningen går rakt upp från stammens topp: i KL8, genom mellanbjälklaget och upp i L11:s regelfack (Ø50, LU1;
    de lätta väggarnas stomme 70 mm rymmer inte Ø75), och från innertakets installationsskikt Ø75 (LU2, mot frost),
    isolerad genom takets isolering, till en luftningshuv av plåt på taket. Den står 25 mm från stammens mitt
    (excentrisk övergång), mellan takets ströläkt och fri från L11:s regel.
    - Stammen står i KL8 under L11 (stommens mitt, x 3 310), 440 mm från röret P4; rensningen sitter 0,5 m över
    källargolvet med locket mot teknikrummet.
    - Kontrollen prövar luft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
2026-11-07 Avloppet: ritningen VS-02 i ritningsmallen (./mod avlopp ritning)
    - VS-02.1: källarens plan 1:100 ur STEP-filens snitt med alla ledningarna (grundledningarna under bottenplattan och
    rören i källarens tak), de lodräta rören från plan 1 och tvätthonas anslutningar, golvbrunnarna, stammen och
    luftningen, flödets riktning och grundledningens vattengång (RH 2000) där den börjar, vid GB2, ut under V9 och där
    ritningen slutar; stammen och luftningen i en schematisk sektion med höjderna; anvisningar, teckenförklaring och
    tabellen över ledningarna (Ø, längd, fall och vattengång).
    - Ritningsmallen: avloppets färg AV med stilarna av, av_tunn, av_tak och lu.
    - Utdraget: godset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
2026-11-07 Armaturerna: avståndet till brännbart i ljusets riktning och monteringsanvisningarnas krav i innertaket
    SG:s "distance to flammable materials" är märkningen för minsta avstånd i ljusets riktning (Tube Micro R:
    10 mm i databladet, 0,01 m i monteringsanvisningen), inte ett avstånd runt dosan ovanför taket. Tube Mini R
    är IsoSafe och får enligt sin monteringsanvisning ligga i installationsskiktet och täckas med isolering.
    - ./mod el kontroll: inbyggnadsdjupet mot innertakets 70 mm, hålet mot läkten utan avståndet; armaturer som
    inte får täckas med isolering (Junistar Exclusive) har sin fria höjd (56 mm) och sin luft (4 l) i läktens fack
    - ./mod kontroll: armaturernas ljus p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
2026-11-07 Vattnet och avloppet: underfördelarna UF1 och UF2, diskmaskinen i ön och tvätten i badrummets skåp
    - Underfördelare utanpå väggen i källaren, i rum med golvbrunn, matade från fördelarskåpet som ett
    tappställe i dess ordning och med egna utgångar i egna stråk (vatten/underfordelare.py): UF1 på V14
    under köket (diskbänken och diskmaskinen i ön), UF2 på KL1 under badrummet (WC:n och tvättmaskinen).
    Fördelarskåpets 16 filer räcker då. Stråket O går norrut före köket och når UF1 norr om diskhons
    avlopp. Varmvattnets tid räknas genom underfördelarens matning.
    - Diskmaskinen i ön: kallvatten i golvdosan under maskinen och pumpat avlopp (AV20), PEX 25 utan fal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
2026-11-07 Elen: gruppcentralen, grupperna och de ingjutna rören från centralen; köket och tvätten
    Gruppcentralen sitter i teknikrummet på V3 väster om vattenmätaren (x 2 400–3 000, 800 mm
    fritt framför), lägre än kanalen FF3-K2 som går över dess östra del. 16 grupper på plan 1
    (el/grupper.py): belysning och uttag per område, egna grupper för hällen (400 V), ugnen
    eller mikron, köksbänkens och öns uttag, diskmaskinen, kyl/frys/fläkt, tvättmaskinen och
    torktumlaren i badrummets skåp och värmepumpen, personskyddsautomat typ A 30 mA per grupp.
    - Ett rör per grupp från centralens ovansida (två rader mellan underkantsnätets järn, den
    bakre i V3:s cellplast) ingjutet i mella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
2026-11-07 Arbetsritning AR-04 för bottenplattan, ingjutningsgods och kontroll mot modellen (#86)
    AR-04 Gjutning av bottenplattan: golvvärmen (plan 0), avloppet med
    golvbrunnarna, hålen och genomföringarna och pelarnas fotplåtar, ur samma
    data som AR-03. AR-03 får bladet ingjutningsgods (pelarnas topplåtar).
    - Numren placeras där de inte täcker andra nummer eller punkter, längre ut
    med hänvisningslinje; stigarna ur gruppcentralen får ett gemensamt nummer
    (E12–E26) och står i detaljen.
    - Det gröna, där man får borra och skruva, är väggarna på plattan minus
    50 mm runt alla installationers rör i plattan.
    - Kontroll mot modellen: punkter utanför plattan och hål i pelarnas pl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
2026-11-07 Diskmaskinens pumpade avlopp AV20 i räta vinklar (#86)
    AV20 gick snett genom mellanbjälklaget från ön till diskbänksskåpet. Nu går
    det längs ön till y 8 700, österut söder om tappvattnets matning till UF1
    och söderut upp i diskbänksskåpet, 3,2 m ingjutet. Kontrollerna: 0 fel,
    inga krockar.
    Refs #86
2026-11-07 Källarens arbetsrum: paneler, brytare och ingjutna rör (#51)
    Arbetsrummens belysning enligt användarens svar i #51: tunna utanpåliggande
    LED-paneler (LEDVANCE PANEL COMPACT 600, 3000 K, Ahlsell), var och en
    ansluten i en ingjuten dosa ovanför sig, med bara rör och dosor ingjutna.
    Sex i det stora rummet i högra huskroppen och en i vart och ett av de två
    små rummen söder om KL1, brytare vid dörrarna KD5, KD1 och KD3.
    - Grupperna G17 (det stora rummet: ur den bakre raden över centralen till
    en ingjuten kopplingsdosa i rummets tak) och G18 (de små rummen: i
    stråket S och ned i KL1).
    - Dosorna står mellan underkantsnätets järn och fria från rören i
    bjälklaget och pelarn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
2026-11-07 Teknikrummets och tvättstugans uttag, tvättmaskin och torktumlare (#51)
    - Teknikrummet: tre dubbla uttag på V3 mellan centralen och vattenmätaren
    (G19).
    - Tvättstugan: två dubbla uttag IP44 på V3 (G20) och tvättmaskinens och
    torktumlarens uttag IP44 på V21 norr om tappstället KA-TM1, var sitt i en
    dubbel ram (G21, G22).
    - Uttagen sitter 1 100 mm över golvet. Rören går ur centralens baksida in i
    V3:s cellplast bakom gipsen och i uttagens höjd (maskinernas under, var
    för sig, så att de inte korsar varandra vid V21).
    Kontrollerna: 0 fel.
    Refs #51
2026-11-07 De små rummens uttag söder om KL1 (#51)
    Två dubbla uttag i vardera rummet, 1 100 mm över golvet: på V21 och V7 i
    det västra, på V7 i det östra (G23). Rören går ur centralens baksida ned i
    V3:s cellplast till golvzonen (250 mm över golvet), västerut och söderut i
    V21:s och österut i V7:s, under tappställenas rör, och upp till uttagen.
    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
2026-11-07 Det stora rummets uttag och fläkten FF3:s anslutning (#51)
    Fyra dubbla uttag i det stora rummet, 1 100 mm över golvet (på V15, V1 och
    två på V14), och fläkten FF3:s fasta anslutning på V20 vid fläkten
    (G24). Gruppens rör går ur den bakre raden över centralen norrut över V3
    och österut i bjälklaget i glipan mellan V20:s järn, ned i V20:s cellplast
    till fläkten; därifrån genom bjälklaget till V15 och sedan i golvzonen i
    V15:s, V16:s, V1:s och V14:s cellplast mellan uttagen, så att det inte
    korsar stråket E och tappvattnet till UF1 i bjälklaget. E-01.6 säger vad
    som återstår i källaren. Kontrollerna: 0 fel.
    Refs #51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
2026-11-07 Uttagen i rummet söder om trapphallen och rummen vid V2 (#51)
    Två dubbla uttag i vardera, 250 mm över golvet:
    - Rummet söder om trapphallen, på V18. G23 fortsätter i V7:s cellplast
    förbi KL3:s ände och runt hörnet in i V18:s.
    - Rummen vid V2, på V2. G24 grenar sig i fläkten FF3:s anslutning ned i
    V20:s cellplast och runt hörnet in i V2:s.
    Rören går i golvzonen. G23 och G24 blir 16 A (2,5 mm²) med sex uttag
    vardera. Kontrollerna: 0 fel.
    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
2026-11-07 Trapphallens uttag (#51)
    Två dubbla uttag i trapphallen, 250 mm över golvet: på KL3 söder om
    dörren KD2 och på KL4 väster om dörren KD4 (G23). Röret går från det
    östra lilla rummets uttag upp i V7:s cellplast till strax under taket,
    österut in i KL3:s regelfack och norrut över dörren KD3 till uttaget på
    KL3, och därifrån lägre, där inga dörrar är, söderut och österut i KL4
    till uttaget där. Alla källarens uttag är nu med; E-01.6 säger att bara
    de trevliga rummens belysning återstår. Kontrollerna: 0 fel.
    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
2026-11-07 Källarens el: dokumentationen, cellplastens lägen och E-01.6:s etiketter (#51)
    - rum/kallare.py:s beskrivning och el-README:n tar med uttagen,
    maskinerna, fläkten FF3 och hur rören går i väggarna (golvzonen).
    - Cellplastens mittlinjer räknas på ett ställe (_eps) i stället för tre;
    geometrin är oförändrad (./mod avtryck jamfor).
    - E-01.6 ritar gruppcentralen med en etikett med grupprören som går upp ur
    den, i stället för överlappande texter.
    - Elritningens etiketter: finns inget fritt läge närmast punkten provas
    dubbelt och tredubbelt så långt ut med en hänvisningslinje, i stället
    för att etiketten läggs över en annan.
    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
2026-11-07 Källarens trevliga rum: lågbländande spotar på ingjutna dosor (#51)
    Trapphallen, tvättstugan, rummen norr om V4–V6 och rummet söder om
    trapphallen får 32 utanpåliggande tubspotar SG Armaturen Tube Mini S
    (900 lm, 3000 K, UGR < 19), var och en ansluten i en ingjuten dosa
    Ø90 × 70. Ingjutningshus för infällda spotar (SG Concrete Box, Kaiser,
    Spelsberg: 110–165 mm höga) ryms inte i bjälklaget med golvvärmen och
    armeringen. Fyra dimrar vid ingångarna (KA-B1–B4) på G18; rören
    ingjutna, i rummen norr om V4–V6 delvis i väggarnas cellplast eftersom
    grupprören längs y 9 645–9 830 tar båda nivåerna.
    - katalog: TUBE_MINI_S, tubhuvud med takkopp (utanpåliggande)
    - ljus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
2026-11-08 Källarens trevliga rum: ljuslinjer i ask med drivdonen i teknikrummet (#51)
    Tubspotarna (Tube Mini S) och deras ingjutna dosor ersätts av ljuslinjer i
    ask utanpå betongtaket, enligt kommentaren i #51: en askprofil 56 × 22
    (samma ask som köksluckorna) med ett fräst spår, en aluminiumkanal, en
    COB-LED-list 24 V (Ra ≥ 97, R9 > 90, 3000 K) och en opal diffusor. Åtta
    linjer följer rummen, parallella med väggarna: längs trapphallen och tvärs
    ned mot trappans fot, längs tvättstugans hall och över bänken vid V21, en
    mitt i var del norr om V4–V6 och två parallella i rummet söder om
    trapphallen.
    - Drivdonen (24 V, fasdimbara med bakkant; förslag Hide-a-lite FDIM 24V
    60W) ett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
2026-11-08 Väderstrecken i källarens och installationernas texter efter planen (#89)
    Källarens, mellanbjälklagets och installationernas texter hade norr och
    söder omvända (norr = högt y). De följer nu repots regel, som står i
    modellens README: norr = lågt y, söder = högt y, öster = högt x och
    väster = lågt x.
    - Rummen: rummet norr om trapphallen (KS), rummet norr om hallen (KSV),
    rummen söder om V4–V6 och det stora rummets zoner norr och söder; KL4
    norr och KL6 söder om trappan, teknikrummet söder om KL8–KL10, KL10
    norr om värmepumpen
    - Installationernas texter (el, tappvatten, avlopp, golvvärme,
    köldbärare, ventilation, teknikrummet och brandlarmets kablar K02 och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
2026-11-08 Marken som data; Onshape-modellen och jämförelsen borttagna
    Berget, uppfyllnaden och sovrumsavsatsen är nu data i mark/marken.json
    (ovansidans ytor med höjden i varje hörn, avsatsen som prismor i sitt
    lutande plan) och byggs av mark/marken.py, med samma geometri som i
    Onshape-modellen: berget identiskt, uppfyllnaden -0,10 % volym och höjder
    inom 0,54 mm (slänterna i 5 mm trianglar), avsatsen -0,004 % och 0,06 mm.
    Onshape-modellen (modeller/referens/), referensdelarna, Importerad,
    mod jamfor, namntabellen, ONSHAPE_TILL_K05 och REFERENS är borttagna;
    ./mod onshape (uppladdningen) står kvar. README:erna och CLAUDE.md
    beskriver det nya läget och var Onshape-modellen finns i historiken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
2026-11-08 Elrören i mellanbjälklaget raka och sneda med mjuka böjar (#87)
    Elrören i mellanbjälklaget går nu raka och sneda direkt mellan punkterna,
    med mjuka böjar med stor radie runt det de inte får gå genom, utan räta
    vinklar i plattan:
    - plattan.py: kartor över elrörens två nivåer (synlighetsgraf över
    hindrens hörn, banden av vinkeljärn, källarväggarnas lodräta järn,
    pelarnas kontrollsnitt och genomstansningszoner) och vägarna genom
    dem, med nivåbyten, böjarna rundade (upp till 600 mm), extra noder
    runt vägens ändar och där den går snett genom ett annat rör, och
    ledningar ut ur hinder som håller sig i bjälklaget
    - el/bjalklag/ingjutna.py: rören i tur och o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
2026-11-08 Dragdosor i källarens tak och G24-M runt V20:s band (#87)
    - Dragdosor (DRAGDOSOR i el/rum/kallare.py): ingjutna dosor i källarens
    tak, åtkomliga underifrån, där ett rör annars fick långt över 270°
    böjar, i det rum där rörets svängar delas lika: KA-D3 i KA-R6-3
    (385° → under 270° i båda delarna), KA-D4 i G24-R1 (352°) och KA-D5 i
    G18-R3 (416°). Rören heter nu a och b; KA-D4 och KA-D5 står i
    grupperna G24 och G18
    - G24-M: knippet går mot där röret kommer ut ur V20:s band vid
    fläktens anslutning KA-D2 och samma ledning in (535° → 330°)
    - kallarens_punkter: dosans_lage tar fler hinder (extra); väggarnas
    mått och centrumlinje är publika (V_GIPSYTA, K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
2026-11-08 Betongbultar genom syllarna som stommens förankring (#88)
    Stommen förankras i mellanbjälklaget med betongbultar M12 genom
    syllarna (hus/stomme/forankring.py): högst 300 mm från syllens ändar
    och 1 200 mm isär, i facken mellan reglarna; i innerväggarna i syllens
    mitt, i ytterväggarna 20 mm från syllens insida (45 mm från betongens
    kant, syllen står 30 mm utanför plattan). Bulten flyttas längs syllen
    till närmaste läge minst 50 mm från rören i plattan (el, tappvatten
    med hylsor, avlopp, golvvärme). Vid plattan på marks fria kanter, där
    syllen står på L-elementens rygg av cellplast, läggs ingen bult
    (utan_betong; frågan står i ärendet).
    AR-03.4 visar bultarna med lä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
2026-11-08 Spotarnas rader lika långt från nocken på båda sidor (#95)
    Takspotarna i allrummet, vardagsrummet, kontoret och de små sovrummen
    sitter i två rader, en i varje takfall. Raderna låg olika långt från
    nocken (t.ex. allrummet 1 395 och 1 085 mm). Nu har varje rum ett
    avstånd från nocken (AVSTAND) för båda raderna: allrummet 1 380,
    vardagsrummet 1 455, kontoret 1 370 och sovrummen 772 mm, nära
    medelvärdet av de tidigare. Spotarna flyttas som förut till mitt
    mellan installationsskiktets läkt, som ligger symmetriskt kring nocken
    (högst 20 mm skillnad). Köket (spotarna riktade mot bänken) och
    badrummet är oförändrade.
    Fixes #95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
2026-11-08 De lätta väggarnas skikt fram till ytterväggens gips, utan springa i hörnet (#99)
    De lätta väggarnas skikt slutade mot ytterväggarnas skivor räknade med
    våtrumsskiktens tjocklek (38 mm) längs alla ytterväggar. Där ytterväggen
    har OSB och gips (25 mm) slutade skikten 13 mm för tidigt och lämnade
    en lodrät springa i hörnet, t.ex. där L1 möter 3NV i de små sovrummen.
    Nu gäller våtrumsskiktens tjocklek bara längs badrummet.
    Fixes #99
2026-11-08 Badrummet: spegeln vid WC:n, duschblandaren mitt i nischen, väggblandare till badkaret och inklädnad över skåpet (#97, #98)
    - Spegeln på L9 mellan bänken och WC:ns cistern (förut på 1NO).
    - Duschens blandare mitt i nischen på 1C; ventilationens platta kanal
    FF3 i samma regelfack flyttad till fackets östra del (x 2 980).
    - Badkarets blandare väggmonterad på 1SO med pipen 290 mm ut över
    karets kant, 800 mm över golvet, 170 mm från karets mitt mot 1A där
    rören går fria mellan källarväggens och överkantsnätets järn och
    förbi karets avlopp. Tappvattnets väggdosor på ytterväggarna prövas
    nu också längs rörens väg in genom bandet vid kanten, och stigaren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
2026-11-08 Badrummets väggar målade vita utom i duschen och på 1A (#105)
    Badrummets väggar har kakel bara i duschens nisch (1B, 1C och L11 i
    nischen) och på 1A mellan badkaret och duschen (badrum.KAKELZON). De
    andra väggarna (ytterväggarna 1SO och 1NO, L9, L10, L19, L11 utanför
    nischen och inklädnaden över skåpet) är målade: SKIVOR_VATRUM_MALAD,
    plywood 15, gips 12, våtrumsgips 8 och tätskikt rollat med
    våtrumsfärg vit (ny material VATRUMSFARG), lika tjockt som
    våtrumsskikten med kakel så att rummets ytor och inredningen ligger
    kvar. Väggsegment som bara nuddar ett område hoppas över.
    Fixes #105
2026-11-08 Hallens garderob: väggbiten L20 vid 1B:s ände och fronten L21 med släta dörrar i ljusblå tempera (#96)
    - L20 (lätt vägg) från 1B:s ände österut och L21, fronten från 1C till L20, 500 från 1B:s yta mot hallen
    till frontens yta; skikten går runt hörnen som vid de andra väggarna. 1B:s ändbräda av ask är borttagen.
    - Öppningen i L21 står i INNEROPPNINGAR; de lätta väggarnas stomme får överstycke och bruten syll vid
    sådana öppningar (vaggar._spann).
    - hus/inredning/hallgarderob.py: smyg av vitmålad furu 15 och två släta dörrblad 22 i liv med väggen,
    ny material TEMPERA_BLA. Golvlisterna slutar mot smygen.
    - Vägkontrollen: DOLDA_VOLYMER (hålrummet ovanför de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
2026-11-08 Allrummets möbler: matbord med sex stolar under PH-lamporna och två Eva hög vid kaminen (#103)
    - hus/inredning/allrum.py: bord 2 200 × 1 000 av oljad ask med rundade hörn, mitt under AL-L10 och
    AL-L11, tre stolar på varje långsida; två Mathsson Eva hög (Mi 473, 600 × 740 × 1 100, sits 340),
    brun ram och naturell linnegjord utan huvudkudde, snett på var sin sida om kaminen, minst 500 från
    sidoglasen.
    - Material EVA_RAM och LINNEGJORD; specialprodukten FATOLJ i IN-01.
    Fixes #103
2026-11-08 Dragdosor i innertaket för rören med mer än 270° böjar, och S-böjen in i dosorna (#87)
    - kedjor.py: ett rör genom innertaket (kedjorna och rummens rör) med mer än 270° böjar delas i en
    dragdosa i innertaket (katalog.DRAGDOSA_TAK, infälld i gipsen med vitt blindlock, mitt i läktens
    fack) där böjarna delas jämnast, längs innertaket över nocken och dalarna, och vid behov igen; två rör
    nära varandra delar dosa. Dosorna heter efter rummet vid den närmaste änden (BA-DD1 …), delarna
    a, b, c … i ordning. 19 dosor; G07-R1 504° → 193/199/109°, G15-R2 360° → 122/170°.
    - punkter.bojar (flyttad från installation.py): rörets ände i en dosa, högst 100 mm, räk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
2026-11-08 R-02, konstruktionsritningen av trästommen ur modellens bärverk (#91)
    - verktyg/modellering/modellering/stomritning.py och ./mod stomme ritning: ur ./mod barverk (samma
    utdrag som K-04), ett blad per element i byggordning: R-02.1 översikt i 3D med varje element märkt
    med kod och blad och förteckningen över bladen, sedan ytterväggarna huskropp för huskropp, de
    bärande innerväggarna, stolparna, takstolarna, takfallen (takbalkar och stålband) och nock- och
    dalbalkarna, 42 blad.
    - Varje blad: elementet i elevation (väggarna sedda utifrån, takfallen vinkelrätt mot takytan) i
    1:20–1:100, delarna märkta med ID, kedjemått till de stående delarnas vänstra kanter med tota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
2026-11-08 Tappvattnets rör-i-rör med mjuka svep i bjälklaget i stället för räta hörn (#87)
    - strak.rundad: hörnen i plan i bjälklaget rundade med bågar (radie 300, minst 8 × skyddsrörets
    diameter), som elrörens svep; parallella filer med samma radie korsar inte varandra. Där ett svep
    skulle gå in i en avloppsledning (vatten.system.avloppen_i_nivan) lämnas hörnet rätt, i både kallt
    och varmt.
    - Vattenkontrollen: sneda stycken i plan är tillåtna; rör-i-rör med mer än 270° skarpa böjar
    (resningarna, väggarna) får en anmärkning, svepen redovisas för sig.
    - Elens kartor: tappvattnets svep förenklade (FORENKLA 12 mm, radien lika mycket större), så att
    modellens byg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
2026-11-09 Ersättningsluften genom ventiler i VELFAC-fönstrens överkarm, med undertrycket i kontrollen (#108)
    - ventilation/katalog.py: UTELUFT_FONSTER, 18 fönster i de torra rummen och köket med VELFAC click
    vent (2 020 mm² ekvivalent area), UNDERTRYCK_MAX 10 Pa
    - Ventilationskontrollen räknar undertrycket (q = 0,61 · A · √(2Δp/ρ)): normalt 76 l/s → 7 Pa,
    med köksfläkten forcerad 136 l/s → 23 Pa (anmärkning: spjäll som öppnar med fläkten)
    - IN-01: ventilen i fönstren
    Refs #108
2026-11-09 Ytskiktskontrollen hittar springor i inåthörnen mellan två väggars skikt (#107)
    - ytskikt._inathorn: par av synliga ytor med vinkelräta normaler i ett inåthörn (båda når ut i
    rummet framför den andra, den ena får gå förbi hörnlinjen högst 60 mm); springa där den andra
    slutar 0,5–30 mm före hörnlinjen längs minst 50 mm och ingen annan del i dess plan fyller remsan
    - Prövad mot felet i #99 (skikten 13 mm före ytterväggens gips): hittar springorna vid L1, L3 och L4
    mot 3NV; modellen som den är nu: 0
    Fixes #107
2026-11-09 Kaminen mitt under nocken, skorstenen murad till halva höjden och den isolerade skorstenen genom garderoben; Jotun 1624 på väggarna och 1563 på skorstenen (#109)
    - rum.KAMINMUR mitt under nockbalken NB3 (x 6 905); den murade skorstenen 2 400 hög med lock
    - kamin.skorstenens_vag/kanalens_vag: skorstenen och förbränningsluftens kanal 45° bakåt genom 2C
    (mellan reglarna vid x 6 647 och 7 094) in i garderoben, 45° västerut ovanför garderobens tak och
    lodrätt genom taket väster om nockbalken, där de gick före #102; hålen genom 2C:s skikt och
    garderobens tak (kamin.genomforingar, hus.py); skydd av kalciumsilikat runt dem i garderoben
    - Material: väggarnas gips och våtrumsf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
2026-11-09 Kaminen: skorstenen 1,9 m hög och bara 382 mm ut från väggen, i en nisch i 2C; förbränningsluften längs garderobens golv (#109)
    - Den murade skorstenen 0,5 m lägre (Z_MUR 1 900); skorstenen svänger bakåt lägre (Z_BOJ 1 150)
    - Skorstenen i en nisch genom 2C:s stomme och skikt mot allrummet (oppningar.NISCHER, vaggar och
    v2c: överstycke och kortlingar, reglarna vid nischens sidor), med baksidan kalciumsilikat 50 mot
    skikten mot garderoben och 50 luft till insatsen: 502 djup, 382 ut från väggen (förut 700)
    - Förbränningsluften: slangen rakt bakåt under insatsen genom nischen in i garderoben, den isolerade
    kanalen längs garderobens golv och lodrätt upp genom taket; skydd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
2026-11-09 Köksön: tre lådor i lådskåpen O2 och O3 (115, 233 och 441 från toppen), bänken behåller fyra
    Skåptypen får sina fronthöjder (Skaptyp.fronter); LADSKAP_ON med FRONTER_ON
    används i ön. Lådornas sidor 131–522, 539–758 och 775–861. ./mod kontroll:
    0 krockar; ./mod typ och modellanalysens kontroller utan avvikelser.
2026-11-09 Hallens garderob: lika mycket vägg på båda sidorna om dörrarna, 140 mot 1A och mot hörnet vid L20 (#96)
    Öppningen i L21 u 165–2 025 (1 860 bred), dörrarna cirka 445 breda.
    ./mod kontroll: 0 krockar, 0 språng i ytskikten.
    Refs #96
2026-11-09 Kaminen: skorstenen i en enda förskjutning genom nischen (två böjar), minst 50 mm till brännbart; skyddet i garderoben av gips med inspektionslucka (#109)
    - skorstenens_vag: lodrätt, 45° snett bakåt genom nischens baksida och 2C:s skikt mot garderoben och
    lodrätt genom taket vid (6 635, 5 635), mellan takbalken T09 och takstolen 2C, väster om NB3;
    sotningsbar uppifrån (tidigare tre böjar)
    - Ovanför insatsen är skorstenens sidor kalciumsilikat 50 (förut lättbetong 100), så att skorstenen
    ryms; avståndet till brännbart mätt: minst 50 mm (läkten vid taket 50, regeln i nischen 66,
    takbalken och nockbalken 93)
    - Skyddet i garderoben: gips 13, minst 50 mm från skorsten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
2026-11-09 Kaminen: skorstenen 1 680 hög, så lågt som skorstenen genom nischen tillåter med 50 mm till brännbart (#109)
    - Z_MUR 1 680 (förut 1 900), nischen i 2C upp till 1 690; skorstenen svänger direkt på stosen
    (Z_BOJ 1 110); plåten över konvektionsöppningarna 1 500, locket kalciumsilikat 50
    - Avstånden till brännbart mätta: överstycket över nischen 63, OSB:n 59, läkten vid taket 50 mm
    - Insatsen sitter kvar (underkant 450); Rais 600:3 har bara rökstosen överst, så skorstenen måste gå
    ut genom nischens baksida, och lägre än ca 1 660 kommer den för nära överstycket
    Refs #109
2026-11-12 LN5_2 med en femte regel på västra sidan; banden i 1B slutar i hammarbandets höjd; gavelstolen 1SV på nockbalk 5:s stöd E
    - 1D: stolpen LN5_2 av fem reglar 45×95 (den nya i väggen, väster om de fyra), syllen 45 kortare. K-03: lasten
    71 mm excentrisk på 225 mm, 87 % (var 105 % med fyra reglar efter att stöden flyttats). K-05 med stolpens nya mitt,
    räknad om; K-06 och U-01 följer.
    - Stålbanden: en stolpe som går förbi hammarbandet upp till en balk (LN5_1 och LN5_3 i 1B) räknas till
    hammarbandets underkant, så att bandet slutar i hammarbandet och inte i nockbalken (krockade sedan förra commiten).
    - K-03: gavelstolen 1SV står på nockbalk 5:s stöd E (gaveln), inte D (LN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
2026-11-13 Stommens bultar och rören i plattan: spärrzoner, passager och arbetsritningen AR-03.7
    Rören i mellanbjälklaget (el, tappvatten, avlopp och golvvärme) håller minst 200 mm från varje bult och ankare
    (stomme/forankring.sparrzon). Spärrzonerna är med avsikt få och enkla, för gjutningen: ett kantband längs plattans
    ytterkant, en rektangel per innervägg från första till sista bulten och rutor vid stolparna. Där rören går under en
    bärande vägg går de samlade i installationspassager (installationer/passager.py), där inga bultar borras. AR-03.7
    ritar bultarna, spärrzonerna och passagerna, och gjutningens kontroll prövar avståndet.
    - Elen till plan 1 går inte under de bäran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
2026-11-13 Granskning: kedjan K-01 → K-05 → K-03/K-04 kontrolleras av bygget, rättade laster och texter, ritningarnas tabeller ryms
    Beräkningarna:
    - K-05: LD2_1 23,2 kN ur K-04 (stod kvar på 20,9); K-05, K-06 och U-01 omräknade. Tilläggsjärnen vid röret P16
    (zon Ö12) blir därmed Ø12 s100 i stället för Ø12 s150 (R-06).
    - K-03 läser huvudstolpens krafter ur K-01:s resultat (50,8 kN och 2,75 kNm; de inskrivna 49,3 och 2,68 var äldre,
    strävans fäste 760, inte 770) och stoppar om K-05:s stödreaktioner (laster.K01) inte är K-01:s.
    - K-04 stoppar om en stolpes största last är större än K-05 räknar med och skriver raden att föra in; takstolarnas
    krafter över K-03:s visas i r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
2026-11-13 Cellplasten: S300 i hela det undre skiktet i källaren och under plattan på mark på plan 1
    Källarens bottenplatta: det undre skiktet (100 mm, lika tjockt som L-elementens fot) är S300 i hela ytan, också
    under plattan, i stället för S100 med S300 bara under balkar och plintar. Skivorna läggs hela, utan urtag för
    balkar och plintar; bara det övre skiktet (200 mm S100 under plattan) skärs ur för dem. S200 i det undre skiktet
    håller inte under innerväggarnas balkar (79 kPa mot 69). K-06 räknar plattans bädd som de två skikten i serie:
    S300 88 %, S100 31 %, plattans moment 83 %.
    Plattan på mark på plan 1: S300 i hela tjockleken (350 mm) i stället för S100. Hörnet under LA10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
2026-11-13 Cellplasten: S200 i det undre skiktet i källaren, S300 bara lokalt där det behövs
    Källarens bottenplatta: det undre skiktet (100 mm, helt i hela ytan innanför L-elementens fot, utan urtag för
    balkar och plintar) är S200 i stället för S300. S300 ligger bara i L-elementen (foten under kantbalken) och i det
    undre skiktet i hörnet där balkarna under V4–V6 och V15 möts, 1,2 × 1,2 m (två skivor 600 × 1 200); med S200 också
    där utnyttjas det till 95 %, med S300 i hörnet till högst 83 %. Det övre skiktet under plattan är S100 som förut.
    Plattan på mark på plan 1: S100 i stället för S300, och S300 bara inom 1,2 m från de två fria hörnen, under
    hörnstolparna LA9 och LA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
2026-11-13 Plattan på mark: S200 i L-elementen och i de två fria hörnen
    K-06 räknar hörnen under LA9 och LA10 med S200 i stället för S300: 54 kPa
    mot 69 kPa (79 %), långtid 23 mot 60 kPa. S300 finns kvar bara i källarens
    L-element (kantbalken står på foten, 86 %) och i hörnet där balkarna under
    V4–V6 och V15 möts. Modellen (PM-L, PM-CS1/2), R-03 och R-06 följer med.
    Refs #117
2026-11-13 U-05: värmeförluster och energibehov; mineralull i gavelspetsarna och i väggarnas installationsskikt
    U-05 (eget underlag, inte till tekniskt samråd) visar var värmen lämnar huset och vad uppvärmningen kostar över
    året. Byggdelarnas U-värden och skarvarnas köldbryggor räknas i 2D (finita volymer, ISO 6946 och 10211), marken och
    källaren i 3D (3,3 miljoner celler) och året timme för timme med ERA5-klimatet 2014–2023, solen genom fönstren,
    helgboende (frånluften ner till 0,10 l/s·m² när huset står tomt) och bergvärmepumpen med COP per timme.
    Grundfallet (minst 20 °C): H_T 189 W/K, Um 0,32 W/m²K (BBR 0,30), golvvärme 18,0 MWh/år, köpt el 3 810 kWh/år och
    ca 5 850 k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
2026-11-13 Granskning: rätt typsnitt i de tunga rapporterna, skorstenen 1,0 m över nocken, AR-01 med F-01:s vind, rättade ritningar
    Typsnittet. Klonen saknade beräkningar/.fonts, så rapporterna för K-05, K-06, U-01, U-03 och U-04 hade checkats in
    satta i Typsts reservtypsnitt i stället för Carlito. De är omräknade eller omritade med Carlito (resultaten är
    oförändrade), ./bygg stoppar nu om Carlito saknas, och K-02 läser typsnittet ur beräkningar/.fonts som de andra.
    U-04 är omrenderad ur dagens modell.
    Rättat i handlingarna:
    - K-05: stycket om vindlyft var skrivet för ett rör som får drag. Med F-01:s vind får inget rör drag, och texten
    säger nu det (minsta rörlast 2,5 kN tryc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
